A-Common-Guy/bipedale/ros2_ws/src/sandro_description/README.md

# sandro_description

ROS 2 Jazzy description resources for Sandro.

## Models

- `urdf/sandro.urdf.xacro` is the `robot_state_publisher` model. It exposes the
  six stable actuated joint names and `imu_link`.
  The launch file expands it with `control_backend:=mujoco|real` (and the
  `sim_*` latency arguments), which adds the `ros2_control` block from
  `urdf/sandro.ros2_control.xacro`: the MuJoCo backend wrapped in
  `sandro_sim/LatencySystem`, or the GIM6010 system and BNO085 sensor from
  `sandro_hardware`.
- `urdf/sandro.mujoco.urdf.xacro` and `urdf/sandro.real.urdf.xacro` are
  shortcuts for the same two blocks with the macro's default arguments, for
  inspection outside the launch file.
- `mjcf/scene_floating.xml` and `mjcf/robot_full_floating.xml` are byte-for-byte
  copies of the canonical Onshape export. Their referenced STL files are kept
  below `mjcf/assets`, preserving MuJoCo's relative `meshdir`.
- `mjcf/scene_ros2.xml` and `mjcf/robot_ros2.xml` are generated from the export
  by `tools/sync_model.py` for `mujoco_ros2_control`: unit-gain effort
  actuators, zeroed keyframe `ctrl`, and the six actuated hinges
  re-parametrised into the logical joint convention described below.

## Joint convention

Every controller, the calibrated physical drives (`sign` and `offset_rev` in
`sandro_hardware`) and the simulated hinges share one convention:

- Leg joints are zero when the upper link hangs straight down toward the wheel
  and positive when the link opens away from the leg centre. This is the frame
  of the planar five-bar kinematics in `sandro_controllers` and of the legacy
  `SandroControl` runtime.
- Wheel joints are positive when the robot rolls forward, on both sides.
- The inner/outer motor names are mirrored between the sides: `right_motor_inner`
  is the rear motor of the right leg while `left_motor_inner` is the front motor
  of the left leg. Planar leg +x therefore points forward on the right and
  backward on the left (`forward_sign` +1 / -1 in the whole-body controller).

The raw Onshape export does not follow this convention: its leg hinge zeros are
unrelated between sides and its left wheel hinge points the opposite way, so
equal efforts would spin the robot instead of driving it. `tools/sync_model.py`
holds the per-joint `(sign, zero)` table `JOINT_FRAMES` and applies it while
generating `robot_ros2.xml` through a flipped hinge axis and a joint `ref`, and
converts the `stand` keyframe accordingly. Body poses are unchanged.

`tools/derive_joint_frames.py` recomputes that table from the export geometry
(it needs the `mujoco` Python package, which the ROS image does not ship) and
`--check` compares it with the committed one. Rerun it after every CAD export.

The URDF is intentionally a schematic tree. A URDF cannot express each
five-bar linkage's closed loop, so its lower links end as unconnected visual
branches and the wheel joints attach directly to `base_link`. It has no
inertials and must not be used as a physics model. The MJCF retains the
exported inertias, equality constraints, contacts, and sensors.

## Updating the canonical model

The Onshape document holds one assembly per leg and the robot assembly that
places them. Re-import it from `onshape_export/` with the Onshape API keys in
`onshape_export/.env` (`ONSHAPE_API`, `ONSHAPE_ACCESS_KEY`,
`ONSHAPE_SECRET_KEY`; git-ignored) and `onshape-to-robot` plus `mujoco`
installed:

```bash
cd onshape_export
python compose_robot.py --export   # re-export leg, leg_left, robot; compose
```

`compose_robot.py` attaches the articulated legs, gives the body parts the
weighed hub masses of `config/sim_identified.yaml` (they carry no material in
Onshape) with the Raspberry Pi as the jointless `raspberry_pi` body, keeps
collision only on the outer shell, takes the `imu` frame from the BNO085
board part (`onshape_export/imu_mount.py`) and writes the stand keyframe.
The board's own axes are the `imu_chip` site; the real driver's
`imu_mount_yaw_rad` (`urdf/sandro.urdf.xacro`) must match its yaw, which
`test/test_description.py` checks. Then run:

```bash
ros2_ws/src/sandro_description/tools/sync_model.py sync
ros2_ws/src/sandro_description/tools/sync_model.py check
```

`check` also verifies the six-joint controller contract and IMU site. Both
commands are deterministic; unchanged files are not rewritten. Then rerun
`tools/derive_joint_frames.py --check` from an environment with `mujoco`, and
update `JOINT_FRAMES` if the export moved a joint frame. A changed body also
moves the whole-body controller's model (`model.com_height_per_leg_height`,
`model.pitch_inertia_*`, `model.yaw_inertia_kgm2` in
`sandro_bringup/config/controllers.yaml`): evaluate them in `mjcf/scene_ros2.xml`
over the leg-height range, and refresh the `sandro_rl` policies
(`sandro_rl/docs/DESIGN.md`, refresh procedure).
