A-Common-Guy/bipedale/sandro_rl/docs/DESIGN.md

# sandro_rl design notes

How the training environment is built, why, and how far its results can
be trusted. Each number is either measured in this repository (the command
that produced it is named) or cited, either to [RESEARCH.md](RESEARCH.md) or
to the ROS stack's own notes,
[SIM_TO_REAL.md](../../ros2_ws/src/sandro_bringup/docs/SIM_TO_REAL.md).
That file is cited below as "S2R" with a line number.

All measurements were taken on one machine: an RTX 5070 Ti (16 GB), MuJoCo,
MJX and MuJoCo Warp 3.16.0, warp-lang 1.18.0 and jax 0.11.2 (CUDA 13);
`uv.lock` has the exact versions.

## 1. Layout and data flow

```text
ros2_ws/src/...                 (read, never written)
  sandro_description/mjcf/scene_ros2.xml, robot_ros2.xml   the generated model
  sandro_description/config/sim_identified.yaml            identified mass, friction, payload
  sandro_bringup/config/controllers.yaml                   rates, limits, gains, command shaping
  sandro_bringup/config/sandro_real_overrides.yaml         per-robot overrides
  sandro_bringup/launch/sandro.launch.py                   latency emulation defaults
  sandro_sim/tools/closed_loop.py                          WBC closed-loop harness (evaluation)
        |
        v
sandro_rl/sources.py   reads all of the above, hashes them (fingerprint)
sandro_rl/robot.py     loads the MJCF, checks the model contract
sandro_rl/env.py       batched GPU environment (MJX, impl=warp)
sandro_rl/train.py     PPO (or FPO++, fpo.py) + curriculum; checkpoints carry config and fingerprint
sandro_rl/export.py    ONNX + policy.json (the deployment contract)
sandro_rl/evaluate.py  CPU MuJoCo, full latency emulation, side by side with the WBC
sandro_rl/consistency.py   CPU MuJoCo vs GPU backend check
```

Nothing in `ros2_ws/` was changed. Changes I suggest there are listed in
section 11.

## 2. Backend choice

The candidates were MJX's JAX backend, MuJoCo Warp through MJX
(`impl="warp"`), and Isaac Lab. Isaac Lab would need Isaac Sim, a very large
SDK that I was asked not to install without asking. It also needs the
five-bar closed loops re-expressed for PhysX, which requires a higher solver
iteration count for loops (RESEARCH.md, Isaac Lab entry). MuJoCo Warp runs
the exact MJCF that the ROS simulation runs, so model fidelity carries over
for free. Only the GPU-side Python wheels were needed: no driver or toolkit
change.

`uv run python -m sandro_rl.bench` measures physics steps per second. The
unpowered robot starts from the stand keyframe and tips over, so both tyre
and body contacts are exercised. There is no policy in the loop.

| Backend | 1024 worlds | 4096 | 8192 |
| --- | --- | --- | --- |
| MJX-Warp, graph mode `warp` | 2.24M | 4.58M | 5.18M |
| MJX-Warp, graph mode `warp_staged` (used) | 1.11M | 2.32M | 2.60M |
| MJX-JAX, body meshes not colliding | 0.30M | 0.62M | 0.74M |
| CPU MuJoCo, one thread | 89.7k (one world) | | |

The figures are physics steps per second, from `docs/bench.json`. The
compile times printed by the benchmark are with Warp's kernel cache warm.
A cold first run spends minutes compiling kernels.

These are the reasons for the choice:

- **MJX-JAX cannot run the model as it is.** `put_model` rejects collisions
  between the tyre cylinders and the body meshes, so its numbers above are
  for a copy with the body meshes taken out of collision. It cannot run
  obstacles either: there is no cylinder–box or cylinder–heightfield
  collision (RESEARCH.md, bottom line). Even on the simpler model it is
  3.5–7× slower than Warp.
- **Graph mode.** MuJoCo Warp's default CUDA-graph mode (`warp`) caches one
  graph per buffer-address set. In PPO training at 8192 environments it ran
  out of GPU memory after about 10 iterations. `jax` mode failed with
  `CUDA_ERROR_NOT_SUPPORTED` (a child graph node). `warp_staged` copies
  through fixed staging buffers and trains stably. In raw physics it reaches
  half the speed of `warp` (table above). In the full training loop it runs
  at 157k environment steps/s, against 245k with `warp` for the iterations
  that `warp` survived. It is set in `configs/base.yaml`
  (`env.graph_mode`).
- **End-to-end training rate.** `flat_tracking` trained at 153.7k
  environment steps/s averaged over the whole run, compile included (16.7 s).
  That is 1.84M physics steps/s, at 4 physics steps per control cycle and 3
  control cycles per policy step (`policies/flat_tracking/train_summary.json`).
  The `agile_obstacles` task, with 16 obstacle boxes per world and larger
  contact buffers, ran at about 125k.

## 3. Model sync

### What is read from where

| Quantity | Source | Read by |
| --- | --- | --- |
| Kinematics, inertias, contacts, physics step 1/1200 s | `mjcf/scene_ros2.xml` (generated by `sync_model.py`) | `robot.RobotSpec.load` |
| Identified mass, payload, friction, IMU mount | `sim_identified.yaml`, already in the MJCF; the file is hashed and its tyre friction cross-checked | `robot.check_contract` |
| Control rate 300 Hz, joint order, leg drive kp 12 / kd 0.5 | `controllers.yaml` | `sources.controller_parameters` |
| Torque limits (`"ros"`): the drives' envelope, 9 Nm peak folding back to the 5 Nm rated torque with heat (10 s thermal time constant, knee 0.7) | `sandro.ros2_control.xacro` GIM6010System parameters | `sources.DriveEnvelope`, `torque_envelope.py` |
| Command limits and shaping: 0.5 m/s, 1.5 rad/s, 1 m/s², 0.15 s yaw lag, 0.05 m/s height rate, height 0.14–0.185 m | `controllers.yaml` `drive`, `tasks.height` and the robot overrides | same |
| IMU mounting offset, fall angle 1.0 rad | overrides and `controllers.yaml` `safety` | same |
| Latency defaults: IMU 10 ms at 200 Hz, joints 1 ms at 200 Hz staggered, command 1 ms | `sandro.launch.py` `DeclareLaunchArgument` defaults (parsed with `ast`) | `sources.launch_latency` |

Task configs write `ros` where a value comes from the stack. No number is
duplicated.

### The model contract

`robot.check_contract` raises `ModelContractError` when the model differs
from what the environment handles. It checks:

- the six joint names and their order;
- one direct motor per joint (gear 1, ctrl size 6);
- the `stand` keyframe;
- the IMU site and its sensors;
- the tyre geoms: condim 4, and friction equal to `sim_identified.yaml`;
- the 1/1200 s physics step dividing the 300 Hz control period.

### CPU against GPU consistency

`uv run python -m sandro_rl.consistency` runs four seeded open-loop torque
sequences. Each is the hold torque plus sinusoids of 0.1–0.3 × the torque
limit at 0.5–4 Hz, run for 0.2 s (240 physics steps), in CPU MuJoCo and in
MJX-Warp from the same state. That state is the keyframe after landing:
0.3 s under leg PD, because the keyframe itself is slightly airborne. Two
checks follow:

- **One step:** every 20 steps the GPU is stepped once from the CPU state.
  The tolerance is |Δqvel| ≤ 2e-3. Measured: 6.4e-5 (6e-5 to 8e-5 across
  development runs).
- **Rollout:** the whole 0.2 s horizon. A fixed tolerance is not meaningful
  here, because the model amplifies float differences on its own. The passive
  five-bar links have armature 1e-5, and the robot tips over in open loop.
  The check therefore compares the GPU difference with the spread of CPU
  runs perturbed by 4e-5 relative qvel noise per step, times 3, plus a floor
  (legs and wheels 2e-3 rad, base 2e-4 m). The current model gives:

  | Quantity | GPU − CPU | CPU noise spread | Tolerance |
  | --- | --- | --- | --- |
  | leg joints | 0.049 rad | 0.032 rad | 0.096 rad |
  | wheel angles | 0.108 rad | 0.086 rad | 0.261 rad |
  | base position | 2.9 mm | 2.6 mm | 7.9 mm |

  So the GPU's difference is the size of float noise. Earlier development
  runs, with other seeds and start states, gave legs 0.05–0.125 rad and
  wheels 0.1–0.17 rad.

The contract runs first. `tests/test_consistency.py` copies the MJCF folder
and makes seven alterations. Each one makes the check fail, and the
unaltered model passes:

- a renamed joint;
- gear 2;
- a missing actuator;
- a removed keyframe;
- tyre condim 6;
- tyre friction 0.6, which `sim_identified.yaml` does not contain;
- physics step 1 ms.

### Fingerprint

`sources.fingerprint()` is a SHA-256 over these files:

- the scene and robot MJCF and their mesh files;
- `sim_identified.yaml`, `controllers.yaml` and the overrides;
- `sandro.launch.py`.

It is stored in every checkpoint (`meta.json`) and in `policy.json`.
`checkpoint.load`, `export` and `evaluate` warn and print the changed files
on a mismatch. They do not refuse: a changed comment also changes the hash.

### Refresh procedure after `sync_model.py sync`

```bash
cd sandro_rl
uv run python -m sandro_rl.consistency     # contract + CPU/GPU check; must pass
uv run pytest -m "not gpu"                 # contract tests on altered copies
uv run pytest                              # all tests, observation contract included
```

What to do next depends on the result:

- **The contract fails** (renamed joint, new actuator, changed contact
  type): update `sources.py` (`JOINTS`, `TYRE_SUFFIX`) and `robot.py`
  deliberately. The failure message names the check.
- **The contract passes but the fingerprint warns:** the physics changed.
  Retrain, or fine-tune from the old checkpoint with `--resume`. Then
  re-export and re-evaluate. An old policy can be evaluated against the new
  model to measure how much the change matters.
- **Only rates, limits or shaping changed:** export again, so `policy.json`
  carries the new limits, and run the evaluation.

## 4. Environment

### Timing

| Step | Rate | Source |
| --- | --- | --- |
| Physics | 1200 Hz | MJCF timestep |
| Drive MIT law | every physics step, on the true joint state | S2R l.43–45; `MitDrivePlugin` |
| Control cycle, sensor sampling | 300 Hz | controllers.yaml `update_rate` |
| Policy | 100 Hz, every 3rd control cycle | config `env.policy_rate_hz` |

I chose a policy rate of 100 Hz because the drive-side PD makes the legs
fast without a fast policy, as on Ascento with its low-level PD (RESEARCH.md
§1). It also gives a 3× cheaper rollout. The policy's MIT frame is held for
three control cycles. `policy.json` states the rate so a deployment can
check it.

`flat_level_fast` runs at 300 Hz, one step per control cycle. Inference
costs 0.3–0.6 ms on the Pi, and acting on each joint state as it arrives
cuts 3.3–6.7 ms from the sensing-to-action path, which matters most with the
synchronous joint state of `state_source:=mit`. A faster policy must not
change what the rewards mean per second, so:

- `observation.history_stride` (policy steps between stacked frames): 3 at
  300 Hz keeps four frames 10 ms apart, so the input layout is the 100 Hz
  one and a 100 Hz policy can be fine-tuned;
- `action_rate` and `action_accel` take differences per 10 ms (scaled by
  `0.01 / dt` and its square), so a smooth action costs the same at any rate
  while 300 Hz chatter costs more;
- the constraint termination probability `p_max` is per 10 ms;
- event terms (`termination`) are weighted per 10 ms step, not per `dt`;
- γ and λ are set per step in the config (0.99 and 0.95 per 10 ms are
  0.996655 and 0.983048 at 300 Hz), and `steps_per_env` is tripled so a
  rollout still covers 0.24 s.

All of these reduce to the old values at 100 Hz.

`flat_level_fast` is `flat_level_real` fine-tuned 1000 iterations at 300 Hz
(40 min), with MIT joint timing in half the episodes. In `evaluate.py
--compare` the body pitch RMS, averaged over the phases, halves against
`flat_level_real` in every scenario and latency profile (0.026–0.032 to
0.012–0.016 rad; WBC 0.016–0.019). Speed error and wheel torque drop a
little, and yaw error rises from 0.011 to 0.020 rad/s on the hardware
sequence (WBC 0.12). In the wheel-lag sweep the 5–15 Hz share at 80 ms is
0.04 against 0.19 on the hardware sequence. Part of the gain may be the
model: `flat_level_real` predates the 2026-11 CAD re-import, which
`flat_level_fast` trained on. Inference every cycle costs 0.3–0.6 ms of
the 3.3 ms budget on the Pi.

### Latency emulation

The GPU environment keeps a ring buffer of raw sensor channels at physics
rate: quaternion, gyro, accelerometer, six joint positions and six joint
velocities. `latency.sample_time` follows the ROS emulation's model (S2R
l.47–52), and `evaluate.DelayLine` ports it line for line on the CPU side.
Each channel has a sample clock (rate and phase), and the controller sees
the last sample older than the transport delay. Commands are applied after
the command delay, at physics-step resolution. The CPU evaluation instead
runs the `DelayLine` and `DriveBus` ports and the controller manager's
wake-up rule, all taken from `closed_loop.py`. Run against the same command
sequence, the WBC numbers it produces are the ones `closed_loop.py` itself
reports.

### Actions: the MIT interface

The policy outputs 6 values in [−1, 1], in joint order. Each becomes one MIT
frame per drive, `tau = kp (q_ref - q) + kd (v_ref - v) + tau_ff`, clipped
to the controllers.yaml torque limits:

- **Legs:** `q_ref = stand_q + 0.5 rad × a`, clipped to the joint range,
  with kp 12 and kd 0.5 from controllers.yaml. This is the same in-drive PD
  the WBC uses (`tasks.legs.pd_in_drive`, S2R seventh comparison).
- **Wheels:**
  - `velocity` mode: `v_ref = 20 rad/s × a`, kd 0.4 (the default).
  - `torque` mode: `tau_ff = 3 Nm × a`.

Velocity mode follows the hardware wheel-leg recipe (RESEARCH.md bottom
line). It also lets the drive's own loop reject the 0.2 Nm Coulomb friction
per wheel (S2R l.139) without the policy seeing it through the delay.

### Commands

The command is (forward speed, yaw rate, body height), resampled every
2–5 s. 20 % of commands are all zero, and each component is zeroed with
probability 0.25. The height changes in half the resamples. The policy
observes the **shaped** reference: rate-limited acceleration, first-order
yaw lag, rate-limited height, with the WBC's parameters from
controllers.yaml. Both controllers therefore follow the same reference from
the same `/cmd_vel`. `interface.PolicyInterface.shape` implements this for
deployment.

`agile_terrain` adds a fourth component, the body roll target, for
animation (section 8). Each resample draws it within ±0.3 rad, or zero with
probability 0.4. It is clipped to what both legs can reach at the current
height, |roll| ≤ atan(2·min(h − 0.07, 0.195 − h)/track width), and is
rate-limited to 0.6 rad/s. The tracked roll is this target minus the
coordinated-turn lean. Roll and height are soft objectives: tracking
kernels and a quadratic penalty, and no constraint holds them to the target.

### Observations

The actor sees one frame of 25 values per policy step, and stacks the 4 most
recent frames (100 inputs):

- projected gravity (3), from the delayed IMU quaternion, with the known
  mounting roll removed as `tasks.roll.imu_offset_rad` does in the WBC. In
  training that is the simulated mount (`sim_identified.yaml` `imu_mount`);
  on the robot it is the `rl_*` override's `observation.imu_offset_rad`;
- gyro (3, ×0.25);
- leg joint positions relative to `stand_q` (4);
- leg velocities (4, ×0.1);
- wheel velocities (2, ×0.05);
- previous action (6);
- normalised shaped command (3; 4 with the roll target).

Wheel angles are left out because they are meaningless. Base linear velocity
is left out because the robot has no sensor for it. The accelerometer can be
switched on (`observation.accelerometer`) but is off: the gravity vector
already comes from the BNO085's fusion.

The critic sees 68 values (asymmetric actor-critic, Pinto 2017; Ascento RL,
RESEARCH.md §1). That is the actor's current frame plus true gravity, gyro,
joint state, base velocity, leg heights, fore-aft leg offsets, wheel
clearance, the push force and 8 normalised model parameters.

`tests/test_observation_contract.py` checks that `PolicyInterface`, the numpy
code the CPU evaluation and the deployment use, produces bit-for-bit the
frame, MIT frames and command shaping of the GPU environment. It also checks
the mirror maps.

### Rewards and constraints

Rewards use exponential tracking kernels and quadratic regularisers, as in
legged_gym and Playground (RESEARCH.md §5). Each term is multiplied by the
policy period. The weights for `flat_tracking` are:

| Term | Weight | Note |
| --- | --- | --- |
| alive | 1 | |
| exp(−((v − v_ref)/0.15)²) | 2 | true forward speed in the heading frame |
| exp(−((ω − ω_ref)/0.35)²) | 1 | world yaw rate |
| exp(−((h − h_ref)/0.012)²) | 1 | mean leg height from the kinematics |
| (roll + lean)² | −20 | lean = atan(v ω / g), the coordinated-turn roll |
| pitch² | −2 | |
| pitch rate² | −0.05 | |
| vertical velocity² | −2 | |
| (right − left fore-aft leg offset)² | −200 | keeps the legs together |
| action rate², action acceleration² | −0.02, −0.01 | |
| leg torque², wheel torque² | −0.002, −0.01 | mean over physics steps |
| leg joint velocity² | −0.0005 | |
| termination | −200 | |

Hard limits use Constraints as Terminations (Chane-Sane 2024, RESEARCH.md
§4): each violated constraint raises the episode's termination probability,
up to 0.25 per step, in proportion to the violation over its slack. The
constraints are:

- leg torque at the drives' 9 Nm peak;
- the drives' heat budget running out (`thermal`: 0 until the envelope
  starts folding back, 1 at the rated torque's heat), so bursts above the
  5 Nm rated torque are free and holding them is not;
- five-bar stretch above 0.97 (1 is the singular, fully stretched pose);
- joint range with a 0.1 rad margin;
- height outside the commanded range by more than 8 mm;
- tilt beyond 0.45 rad;
- a wheel lifting by more than 1 cm.

An episode terminates outright at 0.8 rad tilt (the WBC declares a fall at
1.0) or with the IMU below 0.17 m.

PPO adds the mirror loss of Mittal 2024 (weight 0.5). A left–right mirror
of the robot swaps the legs, flips the lateral and yaw signs and keeps the
joint signs, because the joints are mirrored in the URDF. The mirror maps
are tested to be involutions.

### Kinematics of the five-bar legs

`kinematics.py` is the closed-form forward kinematics (base 0.09 m, upper
0.08 m, lower 0.13 m, read from the MJCF). At the neutral offset the
reachable leg height is 0.022–0.199 m at stretch ≤ 0.97. The static leg
torque stays at or below 1.07 Nm between 0.08 and 0.2 m. So the ROS height
range 0.14–0.185 m uses a small part of the linkage. The `agile_obstacles`
task widens it to 0.11–0.19 m (section 8).

## 5. Randomisation

The ranges are resampled each episode (latency, sensors, drives) or drawn
once per environment for the whole run (model fields, the Playground
pattern). Each one is centred on, or brackets, an identified or measured
value.

| Parameter | Range | Source of the range |
| --- | --- | --- |
| IMU delay | 5–15 ms | Launch default 10 ms (`sim_imu_delay_s`): the SPI IMU lags the encoders by 9 ms, plus the 1 ms joint delay (S2R l.57–61). Policies trained before 2026-11 saw 3–25 ms. |
| IMU rate | 150–300 Hz | About 200 Hz per signal over SPI (`report_interval_us` 5000; S2R l.57–61), launch default 200 Hz. Policies trained before 2026-11 saw 100–400 Hz, and in 25 % of episodes 25–60 Hz for the UART path (29.9 Hz on every UART run), which the robot no longer uses. |
| Joint delay | 0.5–6 ms | Encoder data is 1–6 ms old on the robot (S2R l.50–52). |
| Joint rate | 150–300 Hz | 199.9 Hz measured (S2R l.470). 300 Hz is `state_source:=mit` (S2R l.144–150). |
| Joints synchronised | 20 % of episodes, otherwise random phases | 0.66 of joints update together on the robot (S2R l.471). `mit` mode is synchronous (S2R l.62–63). |
| MIT joint state | `mit_joints_probability` of episodes (0 by default, 0.5 in `flat_level_fast`): synchronous at the control rate, 1.5–3.5 ms old | `state_source:=mit`, 2.3 ms nominal (S2R l.144–150, `JOINT_TIMING` in `sandro.launch.py`). |
| Command delay | 0.5–3 ms | Default 1 ms, a 3-frame CAN burst plus the gs_usb round trip (S2R l.53–55). A 6 ms command delay makes the WBC fall at 30 Hz (S2R l.486). |
| IMU noise | 0.5–2 × the MJCF sensor noise | mujoco_ros2_control's noise (S2R l.456–457). The real BNO085 noise is unmeasured, hence the wide factor. |
| Joint velocity gain | 0.75–1.05 per drive | Drives report 0.84–0.87 of the position derivative. One drive reported 0.46 and 0.31 (S2R l.248–250, l.283). The lower outlier is left out deliberately and is listed in section 10. |
| Encoder noise, velocity noise | 5e-4 rad, 0.05 rad/s | Assumption; no measurement in the repository. |
| IMU mounting bias | ±0.02 rad per axis on top of the identified −0.049 rad roll | The 3° roll bias was found from leg heights (S2R l.140). This is the residual after the correction. |
| Gyro bias | ±0.01 rad/s | Assumption; the BNO085 calibrates its gyro online. |
| Drive torque scale | 0.85–1.15 per drive | The torque constant is unmeasured (S2R l.19). The robot spends about 1.7× the simulated wheel torque (S2R l.191–192), which is friction and is covered by the next rows. |
| Leg kp/kd scale | 0.9–1.1 | MIT gain quantisation and the drive's own loop. Assumption. |
| Robot mass | ±10 % | Components weighed 2026-10-21, 4.825 kg in total (`sim_identified.yaml` `masses`), without the battery. |
| Payload mass | 0.4 kg ± 0.4 kg | The part of the hub's weighed mass placed by the tilt weighing (`payload`). The range also covers part of a battery not yet fitted. |
| Payload position | ±40 mm fore-aft, ±20 mm lateral, ±30 mm vertical, IMU frame | The CoM estimate moved from 28 mm to 7–8 mm behind neutral between comparisons (S2R l.101, l.230–233). |
| Tyre sliding friction | 0.5–1.2 absolute | Identified value 0.8 in `sim_identified.yaml` (`tyre.friction`). Ascento found high grip an exploit that did not transfer (RESEARCH.md §1). |
| Tyre torsional friction | 0.5–2 × | 0.07 m was identified from the turn cost (S2R l.102, `sim_identified.yaml`). |
| Leg drive friction | 0.5–3 × | The simulated legs are slower than the robot's (S2R l.505–510). The leg drives' friction is the suspect. |
| Wheel drive friction | 0.5–2 × the identified 0.2 Nm | Inferred from 0.43 Nm producing almost no acceleration (S2R l.139). |
| Joint damping | 0.5–2 × | Not identified: CAD/legacy 0.01 in `sim_identified.yaml`. |
| Armature | 0.5–8 ×, log-uniform | S2R l.321–323 suspects that the armature is reflected by the gear ratio once instead of squared. 8× covers that error for the 8:1 GIM6010 (MODELLING_AND_CONTROL.md l.14, `hardware.yaml` `gear_ratio`). |
| Pushes | ±12 N fore-aft, ±5 N lateral, 0.05–0.2 s, every 3–8 s | Above the 8 N shove of the `closed_loop.py check` gate (S2R l.517). |
| Pushes, `agile_terrain` | ±25 N fore-aft, ±12 N lateral, ±15 N vertical, ±1 Nm about the heading (roll) and about z, 0.05–0.25 s, every 2–6 s | Assumption: about 3× the gate's 8 N shove. The torques stand for knocks on the body's sides and corners; nothing is measured. |
| Terrain, `agile_terrain` | 12 planks 5–30 mm high, 4–30 cm deep, 0.2–1 m wide; 4 hills 2–10 cm high with 5–15° ramps and 0.2–0.8 m plateaus, 0.8–1.6 m wide; all 0.3–4 m from the start, new layout every episode | Assumption: indoor thresholds, cables and ramps. Ascento climbed 15 cm steps (RESEARCH.md §1), so 3 cm planks leave margin. |

`tests/test_determinism.py` checks that the randomisation is bit-exact for a
given seed.

## 6. Training

The training algorithm is PPO in JAX (`ppo.py`), in the style of rsl_rl:

- adaptive learning rate on a KL target of 0.01;
- 8192 environments × 24 steps per iteration, 5 epochs, 4 minibatches;
- γ 0.99, λ 0.95;
- ELU MLPs: actor 256-256-128, critic 512-256-128;
- running observation normalisation, which is exported with the policy;
- the symmetry loss.

Curricula are listed as `curriculum.stages` in the task config. Each stage
sets dotted config keys from a given iteration. When a stage starts, the
environment and the randomised model batch are rebuilt; networks,
normalisers and optimiser carry over.

### Determinism

Everything is seeded: JAX keys, numpy, the per-environment randomisation,
and the CPU evaluation's noise. The CPU evaluation is bit-exact
(`tests/test_determinism.py`). The GPU rollout is not, because MuJoCo Warp's
constraint solver accumulates with float atomics. Two runs with the same
seed agree to about 6e-7 after one step. After one PPO iteration 0.05 % of
the weights differ, by at most 2.7e-3, because Adam amplifies tiny gradient
differences. The test asserts a relative parameter difference below 1e-3,
and also that a different seed differs.

Warp's `DeterministicMode.RUN_TO_RUN` was tried and rejected:

- compiling one reset took 539 s;
- the difference grew (0.025), because the deterministic contact ordering
  changed the floating-point summation order rather than fixing it.

## 7. Evaluation

`evaluate.py` runs the exported ONNX policy in CPU MuJoCo, with onnxruntime
at 100 Hz inside the 300 Hz loop, using the code `closed_loop.py` uses:

- the `DelayLine` and `DriveBus` emulation;
- the controller manager's wake-up rule;
- IMU noise and `/cmd_vel` published at 20 Hz;
- the 3 s settle, pushes and the fall rule.

It writes `drive_test.py`-compatible CSVs and summarises them with the same
per-phase metrics as `compare_runs.py`. It also runs the WBC through
`closed_loop.py` on the same scenario and latency profile. Three latency
profiles are used:

- `nominal`: the launch defaults.
- `uart_imu`: the IMU at 30 Hz, the measured hardware rate (S2R l.469).
- `worst`: IMU at 30 Hz with 25 ms delay, joints 5 ms, commands 3 ms.

The `truth_*` columns are measured from the simulator state. They exist
because the controllers' own estimates differ: the WBC estimates speed from
the wheels and the policy has no speed estimate at all.

### flat_tracking against the WBC

`uv run python -m sandro_rl.evaluate policies/flat_tracking --compare`
writes the full table to `policies/flat_tracking/eval/comparison.md`, for
three scenarios (closed_loop's `hardware`, `default`, `push`) × three
profiles. Survival:

| Scenario | nominal | uart_imu | worst |
| --- | --- | --- | --- |
| hardware (5 phases, 0.2 m/s, 0.6 rad/s turn) | both complete | both complete | policy completes, WBC falls |
| default (11 phases, 0.3 m/s, 1 rad/s spin, height changes) | both complete | policy completes, WBC falls in phase 1 | policy completes, WBC falls |
| push (8 N shoves) | both complete | both complete | policy completes, WBC falls |

The WBC's fall on `default/uart_imu` is a known, pre-existing result.
`closed_loop.py check` fails that gate in the same way (S2R l.489–491,
l.518–519).

Selected phases from the `hardware/nominal` run. Pitch is the true body
pitch about its phase mean (as `compare_runs.py` computes it). Speed error is
`compare_runs.py`'s `vel_err_rms`: wheel odometry plus pitch rate against the
shaped reference, computed the same way for both controllers. The full table
is in the file.

| Phase | Metric | Policy | WBC |
| --- | --- | --- | --- |
| standing (0) | pitch RMS, rad | 0.046 | **0.023** |
| standing (0) | speed error RMS, m/s | **0.027** | 0.072 |
| driving 0.2 m/s (1) | pitch RMS, rad | 0.040 | **0.002** |
| driving 0.2 m/s (1) | speed error RMS, m/s | 0.072 | **0.050** |
| turn 0.2 m/s, 0.6 rad/s (3) | yaw-rate error RMS, rad/s | **0.061** | 0.172 |
| turn (3) | yaw rise time, s | **0.12** | 1.02 |
| all | wheel torque RMS, Nm | 0.24–0.46 | 0.22–0.44 |
| all | leg effort RMS, Nm | 0.79–0.99 | 0.78–0.93 |

The truth speed comes from `closed_loop.cpp` (`Sim::truth`). It is the
speed of the torso body's origin, `hypot(qvel[0], qvel[1])`. That origin is
the CAD origin, 0.35 m from the axle midpoint horizontally and 0.17 m above
it. While turning it therefore adds about ω × 0.35 m: 0.21 m/s at
0.6 rad/s. Pitch motion adds to it as well. The truth speed errors in the
turn phases mean nothing for either controller and are left out above.
Measured at the axle midpoint (`diag_truth_forward_m_s`, policy only), the
policy drove 0.172 m/s in the 0.2 m/s turn of `hardware`, and 0.270 m/s in
the 0.3 m/s spin of `default`. The WBC's recordings have no axle speed
column. Section 11 proposes the fix.

**Where the policy is worse:**

- **Pitch.** Its body pitch RMS is about twice the WBC's in every standing
  phase (0.046–0.066 against 0.023–0.039 rad). Its mean standing pitch is
  also +0.06 to +0.09 rad, against −0.003 to +0.005 for the WBC. In the last
  2 s of the standing phases its pitch standard deviation is 0.017–0.044 rad,
  against 0.004–0.025. With a pitch weight of only −2, pitch is nearly free
  in the reward. A wheeled inverted pendulum can stand at any pitch for which
  it shifts the legs under the CoM, so a tilted body costs it almost nothing.
  `flat_level` (section 8) tests this explanation.
- **Steady driving.** It drives with more pitch and less precise speed than
  the WBC at 0.2 m/s.
- **Torque under worst-case latency.** It survives the `worst` profile with
  a calm body (pitch RMS 0.02–0.05), but spends 0.8–1.8 Nm RMS of wheel
  torque doing so, against 0.2–0.5 at nominal latency, with up to 6 %
  wheel-velocity sign flips. On the robot that is heat and audible chatter.

**Where the policy is better:**

- It survives every latency profile.
- Yaw tracking is 3× more accurate and 8× faster to rise.
- Standing station-keeping is better: speed error 0.027 against 0.072 m/s.
  The WBC drifts ±0.1–0.2 m/s with its 0.3–0.4 Hz friction sway
  (S2R l.499–504).

The plot `policies/flat_tracking/eval/hardware_nominal.png` shows the traces.

## 8. Further policies

The results in sections 7 and 8 were measured on the CAD-mass model, as
trained. The policies in `policies/` have since been fine-tuned on the
weighed robot; their current results are in the last subsection,
"Refit to the weighed robot".

### agile_obstacles: using the legs

The WBC uses the five-bar legs as a slow posture and height actuator inside
0.14–0.185 m. The linkage reaches 0.022–0.199 m (section 4). It is strong
enough there: the static leg torque is at most 1.07 Nm of the 3 Nm limit.
The legs are also fast with the drive-side PD: 72 ms response at kp 12
(S2R l.410–413). `configs/agile_obstacles.yaml` asks the policy to use this:

- commands up to 1.0 m/s and 3.0 rad/s, twice the controllers.yaml limits;
- 2 m/s² acceleration and a 0.15 m/s height rate;
- heights from 0.11 to 0.19 m;
- 16 randomly placed planks per world, 5–25 mm high, 4–30 cm deep and
  0.2–1 m wide;
- wheel velocity targets up to 25 rad/s;
- tighter tracking kernels and a stronger pitch penalty (−10);
- a three-stage curriculum. At iterations 0, 300 and 700 the sampled
  command range is 40 %, 70 % and 100 %, and the plank heights are
  2–8 mm, 4–16 mm and 5–25 mm.

Ascento climbed 15 cm steps blind with a similar recipe (RESEARCH.md §1).
The 0.11 m lower bound is my choice of margin, not a measured limit.

The run took 38.7 minutes for 295M environment steps: 127k env steps/s and
1.53M physics steps/s, compile included. At the end, the training tracking
errors were 0.107 m/s, 0.106 rad/s and 5.7 mm, with 0.005 falls per 1000
episode-steps (`policies/agile_obstacles/curves.png`).

**These plank results are invalid.** Only the first plank of the course
collided; the rest were drawn but not solid, and the same was true of the
training planks. The planks were static world geoms, moved after compilation
through `geom_pos`, and MuJoCo (CPU and Warp) collides static geoms only
where they were compiled. The policy was therefore trained on flat ground,
and the course below crossed one real plank. `agile_terrain` replaces it
(below), with obstacles as mocap bodies and a test that they carry the
wheels (`tests/test_terrain.py`). The table is kept as a record.

**The plank course.** `evaluate --scenario agile --course` runs in CPU
MuJoCo with nominal latency. It places planks 10, 15, 20, 25 and 15 mm high
across the start heading at 1.0, 2.0, 3.0, 4.2 and 5.4 m. The policy
completed the 26 s sequence (`policies/agile_obstacles/agile_course.mp4`,
`eval/agile_course.png`). Speeds are measured at the axle. Which planks it
crossed is from the path dead-reckoned from axle speed and yaw rate:

| Phase | Command | Achieved |
| --- | --- | --- |
| 1 | 0.6 m/s | 0.47 m/s, over the 10 mm plank |
| 2 | 1.0 m/s | 0.87 m/s, over the 15 and 20 mm planks (4.0 m covered straight) |
| 3 | 0.8 m/s with 2 rad/s | 0.78 m/s, 1.76 rad/s, over the 25 mm plank while turning |
| 4 | spin in place at −3 rad/s | −2.51 rad/s mean |
| 5 | −0.5 m/s | −0.44 m/s, backwards over the 20 mm plank |
| 7 | 0.5 m/s with 1.5 rad/s at 0.12 m height | 0.41 m/s, 1.39 rad/s |

**Where it is worse:**

- It undershoots the commanded speed in steady state by up to 22 % (0.47 of
  0.6 m/s) and the yaw rate by up to 16 % (2.51 of 3 rad/s). The
  training error (0.107 m/s) says the same; neither curriculum nor training
  length closed that gap.
- Wheel torque reaches 1.1 Nm RMS at 1 m/s, with peaks near 5 Nm when a
  plank is hit.

**On the standard scenarios** (`eval/comparison.md`), it completes all nine
scenario/profile combinations, as `flat_tracking` does. Compared with
`flat_tracking`:

- Its first standing phase is almost motionless: pitch about its mean
  0.001 rad and speed error 0.016 m/s, against the WBC's 0.023 and 0.072.
- It holds a static posture and then switches to another, 0.1–0.15 rad
  away, after driving. Its later standing phases therefore read
  0.041–0.050 rad, against the WBC's 0.025–0.039. Its mean standing pitch is
  +0.064 rad in phase 0 and about 0 later.
- In the `default` spin (0.3 m/s at 1 rad/s) its yaw-rate error is 0.085
  against the WBC's 0.252, with a rise time of 0.16 s against 0.74 s.
- Like `flat_tracking`, it spends 1.0–1.4 Nm RMS of wheel torque under
  `worst` latency.

### agile_terrain: obstacles that collide, slopes, kicks, roll and height

`configs/agile_terrain.yaml` replaces `agile_obstacles`. Relative to it:

- **Obstacles are mocap bodies** (`terrain.py`). Each world has 12 planks
  and 4 hills; a hill is a plateau box between two ramp boxes. They are
  compiled at their largest height and sunk into the floor to the sampled
  height, and their poses are written to `mocap_pos`/`mocap_quat` at every
  reset. So the layout is new every episode, and each world's is different.
  Warp does not drop contacts between two mocap bodies, so obstacle geoms
  have `contype` 2 and `conaffinity` 1: they collide with the robot and not
  with each other or the floor. Rewards and terminations that need the ground
  height use an analytic one, the highest box top under the point.
  `tests/test_terrain.py` checks that a plank placed at run time lifts the
  wheels by its height, 20 mm for 20 mm on the CPU and in Warp. It also
  checks that the analytic height matches `mj_ray` and that every course
  obstacle collides where it is drawn.
- **Disturbances.** Pushes go up to 25 N fore-aft, 12 N lateral and 15 N
  vertical, with torque kicks of 1 Nm about the heading (roll) and about z.
  They last 0.05–0.25 s and come every 2–6 s. The critic sees all five
  components.
- **Roll and height as commands** (section 4, Commands). Height ranges over
  0.09–0.19 m and roll over ±0.3 rad, clipped to what both legs can reach.
  Neither is a constraint, only a reward: tracking kernels with sigmas
  0.03 m and 0.06 rad, and a −5 roll penalty.
- **Curriculum.** At iterations 0, 400 and 900: commands at 40, 70 and 100 %
  of their range; planks 2–10, 4–20 and 5–30 mm; hills 0–3, 1–6 and
  2–10 cm; pushes rising to the values above. Stages accumulate, so the last
  stage restates the full values.

**Training history.** The policy took three runs:

| Run | Iterations | Change |
| --- | --- | --- |
| `agile_terrain_v0` | 1200 of 2000 | Diverged at iteration 1220 |
| `agile_terrain_v1` | +800 | Resumed from v0's checkpoint 1200 at full difficulty |
| `agile_terrain_v2` | +500 | Height kernel widened |

- **v0's divergence:** one world's simulation diverged, and its NaN
  observation reached the shared observation normaliser, which poisoned
  every world. `env.step` now terminates a world whose state is non-finite
  or whose |qvel| exceeds `termination.max_qvel` (200). It zeroes that
  world's observation and gives it the termination reward.
- **v1's resume:** run with an initial learning rate of 1e-4. At the
  config's 1e-3, the fresh optimiser's first step reached a KL of 144.
- **v2's height kernel:** the height sigma went from 0.015 to 0.03 m and
  its weight from 1 to 2. With the narrow kernel the reward was flat beyond
  about 4 cm of error. Commanded down to 0.093 m, the v1 policy *rose* to
  0.177 m.

Total: 2500 iterations, 1.26 G env steps, 75 minutes. At the end the
training errors were 0.19 m/s, 0.22 rad/s, 15 mm in height and 0.02 rad in
roll, with 0.09 falls per 1000 steps, all at full difficulty.

**The course** (`evaluate --scenario course --course`, CPU MuJoCo, nominal
latency) has planks 10, 15, 20 and 25 mm high at 1.0–3.4 m. They are
followed by an 8 cm hill with 10° ramps and a 0.6 m plateau, centred at
5 m. The policy completes it (`course.mp4`, `eval/course_frames.png`,
`eval/course.png`). Positions below are dead-reckoned from axle speed and
yaw rate:

| Phase | Command | Achieved |
| --- | --- | --- |
| 1 | 0.5 m/s | 0.40 m/s, over the 10 mm plank |
| 2 | 0.8 m/s | 0.69 m/s, over the 15, 20 and 25 mm planks and up the hill; stops at x = 5.3 m, on the plateau. Pitch peaks at 0.37 rad |
| 3–4 | stop, then spin at 2.5 rad/s on the plateau | 2.48 rad/s |
| 5 | 0.6 m/s, 90° to the course | 0.58 m/s, off the side of the hill's plateau and down |

**The expressive sequence** (`--scenario expressive`, `expressive.mp4`,
`eval/expressive_frames.png`, `eval/expressive.png`) lowers the body, rolls
it both ways, crouches, rises and then drives while rolled. Roll follows:
0.25–0.26 rad for ±0.3 commanded at 0.13 m, and 0.22 for ±0.25 while
driving at ±0.3 m/s. The RMS error is 0.03–0.05 rad, including the
transitions. A coordinated turn at 0.4 m/s and 1 rad/s leans the body by
0.05 rad into the turn, as the reward asks.

**Where it is worse:**

- **Height follows only within about 0.12–0.18 m.** Commanded to 0.093 m,
  the legs stop at 0.122 m; commanded to 0.19 m, they stop at 0.177 m. While
  rolling at 0.13 m the mean leg height rises to 0.153 m. I checked and ruled
  out these causes:
  - kinematics: the joints are far from their limits at 0.09 m;
  - self-collision;
  - torso clearance: 0.19 m at a 0.09 m leg height;
  - the IMU-height termination: the IMU is 0.30 m above the ground at
    0.09 m.

  The cause is open; the next things to try are listed in section 10.
- **It rocks slowly while standing**, with pitch swinging between 0 and
  0.1 rad. The pitch penalty (−10) is a quarter of `flat_level`'s.
- **It undershoots speed** by 14–20 % in steady state, like
  `agile_obstacles`.
- **Standard scenarios** (`eval/comparison.md`): it completes all nine
  scenario/profile runs, and the WBC falls in four. In the 10 s push test at
  nominal latency its truth pitch RMS is 0.047 rad against the WBC's 0.023.

### flat_level: the body held level

`configs/flat_level.yaml` is `flat_tracking` with three weights changed:
pitch from −2 to −25, pitch rate from −0.05 to −0.3, and wheel torque from
−0.01 to −0.02. It trained for 1500 iterations against `flat_tracking`'s
1000. Part of the difference below may therefore come from the longer
training; I did not run the 1000-iteration control.

The run took 31.7 minutes for 295M environment steps (154.9k env steps/s,
1.86M physics steps/s). At the end, the training tracking errors were
0.060 m/s, 0.052 rad/s and 1.9 mm, against `flat_tracking`'s 0.069 m/s,
0.065 rad/s and 1.8 mm.

It completes all nine scenario/profile combinations. Results for
`hardware/nominal` (`policies/flat_level/eval/comparison.md`, same metrics
as section 7):

| Phase | Metric | flat_level | flat_tracking | WBC |
| --- | --- | --- | --- | --- |
| standing (0, 2, 4) | pitch RMS, rad | **0.013** / **0.023** / **0.024** | 0.046 / 0.059 / 0.064 | 0.023 / 0.025 / 0.034 |
| standing (0, 2, 4) | mean pitch, rad | −0.002 / +0.006 / −0.001 | +0.057 / +0.092 / +0.085 | −0.003 / −0.003 / +0.005 |
| standing (0) | speed error RMS, m/s | **0.008** | 0.027 | 0.072 |
| driving 0.2 m/s (1) | pitch RMS, rad | 0.032 | 0.040 | **0.002** |
| driving 0.2 m/s (1) | speed error RMS, m/s | 0.068 | 0.072 | **0.050** |
| turn (3) | yaw-rate error RMS, rad/s | **0.044** | 0.061 | 0.172 |
| turn (3) | yaw rise time, s | 0.16 | **0.12** | 1.02 |
| all | wheel torque RMS, Nm | 0.09–0.49 | 0.24–0.46 | 0.22–0.44 |

Standing, the body is now level and calmer than the WBC's. The WBC's
standing pitch is its 0.3–0.4 Hz friction sway (S2R l.499–504), which the
policy does not show (`eval/hardware_nominal.png`).

**Where it is still worse than the WBC:**

- **Driving.** It leans and returns when it accelerates, while the WBC
  holds one steady lean (pitch RMS 0.032 against 0.002), and it tracks the
  speed less tightly (0.068 against 0.050 m/s).
- **Pushes.** At nominal latency its pitch RMS is 0.026 against the WBC's
  0.023.
- **Torque and wheel reversals under worst-case latency.** It spends
  0.4–1.0 Nm RMS of wheel torque, with up to 6 % wheel-velocity sign flips.
  That is better than `flat_tracking`'s 0.8–1.8 Nm, but it is still several
  times its nominal level.
- **Under the 30 Hz UART IMU** its standing pitch rises to 0.017–0.023 rad.

The example video is `policies/flat_level/default_uart_imu.mp4`: the
`default` drive_test sequence with the 30 Hz IMU, the case where the WBC
falls.

### jump: wheels off the ground on command, at 10 Nm

`configs/jump.yaml` is `agile_terrain` (same terrain, pushes, roll and
height commands) plus a jump event. It is a first policy to build the more
dynamic tasks on; its torques are past what the hardware has been run at, so
it is not expected to transfer before the system identification is done.

- **Torque limits** go to 10 Nm on legs and wheels (`action.torque_limit_nm`,
  the hardware plugin's `hard_effort_limit_nm`), against 3 and 6 Nm from
  controllers.yaml for the other policies. The CaT leg-torque limit is
  9.5 Nm. Legs use kp 20, kd 0.6 and an action scale of 0.8 rad.
- **The jump event.** Every 2–5 s a jump window of 0.8 s opens with a target
  height of 2–8 cm (curriculum: 1–3, 2–5, then 2–8 cm at iterations 0, 400
  and 900). The actor sees two more inputs, `[height / 8 cm, time left /
  0.8 s]`, zero outside the window, so the observation grows by 2 per frame
  (112 actor, 74 critic).
- **Rewards in the window:** the lower wheel's clearance up to the target
  (weight 40), upward base speed (2), and a quadratic penalty above the
  target (−2000). Height tracking, the vertical-speed penalty and the
  wheel-lift constraint are off during the window and 0.3 s after it.
- **The evaluation** gives a jump the sixth field of a scenario phase,
  started on its rising edge (`--scenario jump`), and records the lower
  wheel's clearance above flat ground (`diag_truth_wheel_clearance_m`).

Training took 74.6 minutes for 2500 iterations (491.5M env steps, 109.8k
env steps/s, 1.32M physics steps/s), with no divergence. At the end it falls
0.35 times per 1000 policy steps, against `agile_terrain`'s 0.08.

**What it learned** (`jump.mp4`, `eval/jump_frames.png`, `eval/jump.png`):
in every window it hops three times, tucking the legs to 0.10 m between
hops, and lands back at its 0.17 m height within 0.2 s of the window's end.
It does this standing and at 0.5 m/s:

| Phase | Target | Hops | Peak clearance | Peak leg / wheel torque |
| --- | --- | --- | --- | --- |
| standing | 3 cm | 3 | 66 mm | 8.4 / 5.0 Nm |
| standing | 5 cm | 3 | 84 mm | 7.7 / 5.2 Nm |
| standing | 8 cm | 3 | 127 mm | 7.3 / 7.1 Nm |
| 0.5 m/s | 5 cm | 3 | 107 mm | 7.4 / 6.3 Nm |
| 0.5 m/s | 8 cm | 3 | 126 mm | 7.2 / 6.2 Nm |

It completes all nine standard scenario/profile runs (`eval/comparison.md`;
the WBC falls in three, the `worst` latency profile).

**Where it is worse, and what to change:**

- **It hops three times instead of jumping once.** The reward pays for
  clearance at every step of the window, and short hops keep the wheels up
  for more of it than a single flight of about 0.3 s. A single jump needs a
  reward on the flight's apex, or a window that closes at the first
  touchdown.
- **The height command shapes it only loosely.** It overshoots small
  targets (66 mm for 3 cm) despite the overshoot penalty; the 8 cm target
  is met. Rewarding the apex against the target would fix both.
- **It falls four times as often as `agile_terrain` in training.** The
  jumps are on the same terrain and pushes, and landings on plank edges are
  the likely cause (not traced).
- **The torque is 10 Nm on every drive, and the landings are not checked
  against the hardware.** The drives' peak current, the five-bar links'
  strength and the tyres' landing impact are not modelled. The deployment
  controller has no jump input yet (section 9).

### Refit to the weighed robot

On 2026-10-21 the model changed from the CAD masses to the weighed ones
(`sim_identified.yaml` `masses`): 4.825 kg against 3.40 kg, wheels 170 g
against 58 g, and the loaded tyre radius 0.0672 m against 0.0742 m. The
controllers' model, wheel radius included, followed. The contract and the
CPU/GPU check pass on the new model.

**IMU roll correction, fixed with the refit.** Training had taken the
observed roll correction from the robot overrides'
`tasks.roll.imu_offset_rad`. That value was re-identified to +0.016 rad for
the SPI6 mounting, while the simulated IMU stayed mounted at −0.049. The
first `jump` training therefore saw a horizon tilted by 0.065 rad, which it
would have held on the robot. The correction is now the simulated mount
(`sources.simulated_imu_roll_offset`), guarded by a contract test. The
refit below starts from the committed checkpoints with that fix: three of
them were trained before the re-identification, and `jump` relearns the
horizon in its refit.

The policies as committed before the refit, on the new model: `flat_tracking`,
`flat_level` and `agile_terrain` complete the `default` sequence, and `jump`
completes its jumps, but `agile_terrain` falls on the obstacle course. Each
policy was therefore fine-tuned from its committed checkpoint on the new
model, at full difficulty and a learning rate of 1e-4:

```bash
uv run python -m sandro_rl.train configs/<policy>.yaml --out runs/<policy>_mass --resume policies/<policy> \
    --set 'curriculum.stages=[]' --set train.iterations=<300 or 600> --set train.learning_rate=1.0e-4
```

| Policy | Iterations | Wall time | Falls per 1000 steps at the end, before → after |
| --- | --- | --- | --- |
| `flat_tracking` | +300 | 6.6 min | 0 → 0 |
| `flat_level` | +300 | 6.6 min | 0 → 0 |
| `agile_terrain` | +600 | 17.6 min | 0.08 → 0.11 |
| `jump` | +600 | 17.6 min | 0.35 → 0.21 |

Each folder keeps its original `train_log.csv` and curves and adds
`train_log_mass.csv`, `train_summary_mass.json` and `curves_mass.png`. All
four complete the nine standard runs (`eval/comparison.md`). On the new
model, the WBC falls in the three `worst`-latency runs.

**flat_tracking and flat_level** (`hardware/nominal`):

| Metric | flat_tracking | flat_level | WBC |
| --- | --- | --- | --- |
| standing pitch RMS (phases 0, 2, 4), rad | 0.017 / 0.033 / 0.020 | 0.028 / 0.015 / 0.023 | 0.023 / 0.030 / 0.033 |
| standing mean pitch, rad | +0.020 / +0.018 / −0.001 | +0.002 / −0.007 / −0.004 | |
| driving 0.2 m/s pitch RMS, rad | 0.043 | 0.029 | **0.006** |
| turn yaw-rate error RMS, rad/s | **0.048** | 0.063 | 0.199 |
| turn yaw rise time, s | 0.20 | **0.16** | 1.42 |

Both stand about as calmly as the WBC. `flat_level` stands level, within
0.007 rad. `flat_tracking`'s forward tilt is down from +0.06–0.09 rad to at
most +0.02.

**agile_terrain:**

- **The course at 0.8 m/s** (`--scenario course`) now ends in a fall on
  every seed tried (5 of 5). The robot hits the 25 mm plank, the last and
  highest, at 0.78 m/s. The wheel stops dead (0.07 m/s within 80 ms), and
  the robot pitches over the plank. Another 800 iterations did not change
  that. Over seeds 1–3, with the drive phase at a lower speed, it stays up
  at 0.4 and 0.5 m/s, falls once at 0.6, and falls every time at 0.7.
- **At 0.5 m/s it does not fall, but it does not cross the 25 mm plank
  either** (`--scenario course_slow`, `course.mp4`, `eval/course_frames.png`).
  It crosses the 10, 15 and 20 mm planks. At the 25 mm one it bounces back
  about 0.4 m, retries, and is barely over it when the drive phase ends, so
  it never reaches the hill. It then spins at 2.56 rad/s for 2.5 commanded.
- **Why:** a 25 mm edge against the loaded 67 mm tyre takes about 1.2 Nm per
  wheel to climb statically on the weighed robot, against 0.9 Nm on the CAD
  model (half the weight times the radius times the sine of the contact
  angle). A balancing robot can only apply that torque by leaning into the
  edge or by arriving with momentum. Before the weighing, it managed this.
  The policy is blind, so it cannot slow down for an edge it cannot see. A
  step-climbing task that lifts the wheel with the legs, or a terrain
  estimate in the observation, is the way past 20 mm.
- **Expressive sequence:** roll 0.27 rad for ±0.3 commanded, and 0.23–0.24
  for ±0.25 while driving.
- **Height range:** still about 0.12–0.18 m. The commands of 0.093 and
  0.19 m reach 0.125 and 0.176 m.

**jump** (`jump.mp4`, `eval/jump_frames.png`): still three hops per
command, landing every time. It stands with 0.005 rad of roll:

| Phase | Target | Hops | Peak clearance | Peak leg / wheel torque |
| --- | --- | --- | --- | --- |
| standing | 3 cm | 3 | 92 mm | 7.5 / 7.4 Nm |
| standing | 5 cm | 3 | 95 mm | 7.7 / 7.2 Nm |
| standing | 8 cm | 3 | 120 mm | 7.6 / 7.2 Nm |
| 0.5 m/s | 5 cm | 3 | 95 mm | 7.6 / 7.3 Nm |
| 0.5 m/s | 8 cm | 3 | 108 mm | 7.8 / 5.7 Nm |

The height command matters even less than before: 3 cm now gives 92 mm.

### step_climb: planks up to 6 cm on the weighed robot

`configs/step_climb.yaml` is `jump.yaml` (10 Nm on every drive, commanded
jumps kept) on taller terrain. Planks go up to 6.5 cm, about the loaded
tyre's radius, and the hills' ramps go from 10° up to 50°. Forward tracking
pays 4 instead of 2, and a fall costs −100 instead of −200. The wheel-lift
constraint allows 9 cm of clearance instead of 3.5. The curriculum raises
the planks' maximum from 3.5 cm to 5 cm to 6.5 cm at iterations 0, 300 and
700.

**Three attempts:**

| Run | Start | Iterations | Wall time | Result on the steps course |
| --- | --- | --- | --- | --- |
| `step_climb_v0` | `agile_terrain`, its weights, kp 12, 10 Nm | 1000 | 29.8 min | Never crosses the 3 cm plank. It learnt to wait in front of planks: 0.10 falls per 1000 steps in training |
| `step_climb_v1` | `jump`, with the weights above | 1500 | 46.1 min | Checkpoint 1200 crosses the 3 cm plank, the 4 cm one sometimes: 7 of 20 planks |
| `step_climb_v2` (`configs/step_climb_v2.yaml`) | v1, plus the leg-split constraint and 8 step-ups (70–85° faces, 0.6–2 m tops) | 2000 | 75 min | Legs together (1–6 mm apart), but stops 10–25 cm before the 3 cm plank and at the foot of the curb on every seed. Not kept |

v0's outcome follows from the weights. A fall cost 200, while waiting in
front of a plank for the rest of an episode cost about 20 of forward
tracking. A manual check showed the hop is physically possible: the `jump`
policy, commanded to jump as it reached the 3 cm plank, got over it. v1
therefore starts from `jump`.

**Evaluation** (`--course steps --scenario steps`). The course has planks of
30, 40, 50 and 60 mm at 1–4 m, 0.1 m deep and 1.2 m wide, then a 6 cm curb
with 45° faces at 5.4 m. The drive phase is 14 s at 0.5 m/s. Progress is
measured from the axle's world position (`diag_truth_axle_x_m`, `_y_m`). A
plank counts only if the axle is within 0.55 m of the course line when it is
0.15 m past the plank. Earlier scoring, along the robot's own heading and
then along the course without the sideways check, counted planks the robot
had driven past beside them. It reported 20 of 20 for checkpoint 1200 and
chose that checkpoint on it; the per-checkpoint sweep made with it is
withdrawn.

`policies/step_climb` (v1, checkpoint 1200), 5 seeds, nominal latency:

| Operator | Planks crossed | Which | Curb | Falls |
| --- | --- | --- | --- | --- |
| none (`--heading-hold 0`) | 7 / 20 | 3 cm on 5 seeds, 4 cm on 2 | 0 / 5 | 0 / 5 |
| steers back to the heading (`--heading-hold 2`) | 7 / 20 | the same | 0 / 5 | 0 / 5 |

With the operator steering it stays on the line and stops at the 4 or 5 cm
plank, 1.8–2.8 m along the course. Without, it turns after the first
crossing and drives past the others beside them, which is what
`steps.mp4` shows.

- **The legs are split fore and aft.** In v1 and in `jump` the two legs'
  fore-aft offsets differ by 60–75 mm while standing (`agile_terrain`:
  about 1 mm). One wheel ahead of the other makes the robot statically
  stable in pitch, which pays under the pitch penalties and survives
  pushes; the `leg_symmetry` penalty (−200 per m², 0.7 per second at 60 mm)
  is too small to stop it. It is an exploit, not a gait anyone asked for.
  `constraints.leg_split` (CaT, here 20 mm with 30 mm slack) removes it, as
  v2 shows.
- **Why v2 stops.** Rolling a wheel up an edge of height h takes a tyre
  friction of at least tan θ, with cos θ = (r − h) / r: about 1.5 at 3 cm and
  2.2 at 4 cm for the 67 mm tyre, against 0.5–1.2 in training. A blind robot
  gets up a step only on momentum or by unloading the wheel with the legs.
  v1 did it from the split stance, one wheel at a time; with the legs held
  together and steep faces that punish a failed try, v2 learnt not to try.
  Commanding a jump in front of the plank does not help: it reverses away
  from the face after landing.
- **Hop on command** (`configs/step_climb_hop.yaml`, run `step_climb_hop_v1`,
  1500 iterations from v2, 45.6 min). In training the jump request also fires
  whenever the ground 0.1–0.4 m ahead rises by more than 1.5 cm, with a
  target of the rise plus 2 cm. `evaluate.py --hop` plays an operator who
  does the same from rays against the course. The legs stay together
  (≤ 5 mm). With heading hold 2 and hops, 5 seeds:

  | Checkpoint | 600 | 800 | 1000 | 1100 | 1200 | 1300 | 1400 | 1500 |
  | --- | --- | --- | --- | --- | --- | --- | --- | --- |
  | planks / 20 | 8 | 5 | 5 | 3 | 11 | 2 | 6 | 10 |
  | falls on the steps course / 5 | 5 | 5 | 5 | 5 | 4 | 5 | 3 | 5 |
  | onto the curb / 5 | 3 | 1 | 3 | 0 | 0 | 4 | 0 | 2 |
  | falls on the curb course / 5 | 1 | 0 | 0 | 0 | 0 | 1 | 0 | 0 |

  It is the first policy to get onto the 6 cm curb, and checkpoint 1500
  crossed the 5 cm plank once. But it falls on most runs over the planks,
  usually after landing from the first or second. It also falls without hop
  requests (4–5 of 5), where v2 only stopped. The checkpoints vary too much
  to pick one, so it is not kept. Next would be a longer run with a smaller
  learning rate, landings rewarded explicitly, and planks deep enough to
  land on in training (0.04–0.4 m now).
- **The heading drifts after crossings.** The command is a yaw rate, not a
  heading. `evaluate.py --heading-hold GAIN` models an operator who steers
  back to the scenario's heading.
- **The standard runs:** v1 completes all nine (`eval/comparison.md`); the
  WBC falls in three.
- **Commanded jumps** still give three hops each, with 90–115 mm of
  clearance.
- **Deployment:** like `jump`, its observation includes the two jump inputs,
  which `RlPolicyController` does not provide. It is not exported to ROS.

The next step for curbs is training on step-ups: long, tall platforms, and
more of them, rather than thin planks.

The weighing was done on a bench supply. Once the battery is fitted, weigh
the robot again, redo the tilt weighing and repeat this refit.

### stand_up: from switched off to balancing

`configs/stand_up.yaml`, `policies/stand_up` (checkpoint 2000 of 3000).

**What switched off looks like.** The description collides only the torso
shell and the two tyre cylinders; the leg links and motor holders have no
collision geometry and the leg joints no limits. Dropped limp, the legs fold
through each other and the body to more than 5 rad. The real legs have no
hard stop either: the links meet each other and the body.
`sandro_rl/collision.py` therefore adds one box per leg body, the oriented
bounding box of its collision-class CAD meshes (their convex hulls have up to
5184 vertices, too many for the GPU contact pipeline), massless, to
`sandro_rl`'s compiled model only. Six body pairs touch throughout a sweep of
the leg motors over ±0.6 rad around the stand pose: each lower link with its
motor holder, and the two lower links at the knee. They share a pin and are
excluded; every other pair collides. Only `stand_up` uses the boxes
(`env.collision.leg_boxes`); the other policies are unchanged.

With the boxes a limp robot folds until the lower links rest on the cranks
(about 1.2 and 1.44 rad) and tips over, front or back.
`python -m sandro_rl.fallen` drops it 1024 times from the stand pose, pitched
by up to ±80°, with some roll, a fore-aft shove and leg noise, and keeps the
852 that come to rest within 3 s (`data/fallen_states.npz`). About 60% lean
15–40° on a folded crank, IMU at 0.19 m. The rest lie at about 83° on the
motor holders, IMU at 0.10–0.13 m.

**Training.**

- **Starts:** 70% of episodes from a random pose of the bank, turned to a
  random heading; the rest standing.
- **No fall termination.** Lying down is where the episode starts. The tilt,
  leg-height and joint-range constraints are off. Stretch and leg split apply
  only once upright (tilt below 0.5 and 0.3 rad): folded flat, the legs are
  stretched, and getting up may brace on one leg. The leg-torque constraint
  is above the 10 Nm cap, which pushing up out of the fold saturates.
- **Rewards:** `upright`, (1 + cos tilt)/2, weight 6. `stand_height`, the IMU
  height from 0.15 m to standing mapped to 0–1, weight 10. Tracking pays only
  once upright (× exp(−(tilt/0.4)²)), so lying still earns nothing for it.
- **Lift assist:** an upward pull on the torso, 30 N while the IMU is below
  half its standing height and fading to 0 at standing height. The curriculum
  halves it at iteration 600 and removes it at 1200.
- **Horizon:** γ 0.995 (2 s at 100 Hz) instead of 0.99, because getting up
  takes seconds.
- **Start:** `flat_level`, with the action noise reset to 0.37 (it was 0.04).
- **Batch:** 4096 environments × 48 steps. The leg boxes' contact buffers do
  not fit 8192 in 16 GB.
- **Drives:** 10 Nm on every drive, as `jump`.

**Attempts:**

| Run | Change | Result |
| --- | --- | --- |
| v1 | From scratch, γ 0.99, `stand_height` = IMU height / standing height, no assist | Never stands: the IMU stays at about 60% of standing height and the noise grows to 1.2. Lying at 30° already earned 93% of `upright` and 58% of `stand_height`, and a 1 s horizon does not see the reward of a get-up that takes 2 s |
| v2 | The lift assist, γ 0.995, `stand_height` from 0.15 m, from `flat_level` with the noise reset | Stands up (below) |

Before either run could learn, three constraints had to change, each of
which held the termination probability at 0.24 of its 0.25 ceiling. A 9.5 Nm
torque limit fired at the 10 Nm cap. The stretch limit fired on legs folded
flat. And a 10.5 Nm limit still fired, because the torque is measured after
the ±15% drive spread.

**Evaluation** (`evaluate.py --scenario stand_up --fallen PITCH`). The robot
starts at the stand pose tipped by PITCH, unpowered for 3 s, and falls limp.
Then the policy engages, with no fall cut-off. The scenario gives 8 s to get
up, then 3 s at 0.4 m/s, 3 s turning at 1 rad/s and 2 s still. Success:
tilt below 0.25 rad with the IMU above 0.27 m at some point, and never above
0.5 rad during the drive phases.

- **Checkpoint choice:** checkpoints 1800–3000 on pitches ±0.3, ±0.8, ±1.4,
  3 seeds each. 1800, 2000, 2200 and 2800 succeed 18 of 18; 2400, 2600 and
  3000 only 14, 9 and 15. The four were then tested on pitches ±0.5, ±1.1,
  ±1.4, 2 seeds, under three latency profiles:

  | Checkpoint | nominal | uart_imu | worst |
  | --- | --- | --- | --- |
  | 1800 | 12/12 | 10/12 | 8/12 |
  | 2000 | 12/12 | 12/12 | 12/12 |
  | 2200 | 12/12 | 12/12 | 12/12 |
  | 2800 | 11/12 | 12/12 | 12/12 |

- **Speed:** from a lean of 23–31° it is up in 0.1 s. From 43–62° it takes
  0.7–1.6 s, and lying at 80–83° 0.4–0.9 s. Nose down, it rocks back onto
  the wheels and extends the legs. Nose up, it braces on one leg ahead of
  the other before standing (`eval/stand_up_*_frames.png`, `stand_up_front.mp4`,
  `stand_up_back.mp4`).
- **Once up**, it holds 6–7° of tilt at most while driving and turning,
  with the IMU at 0.32 m. The legs stay within 3 mm of each other fore and
  aft (15 mm in the turn, from the roll).
- **Torque:** the push up reaches the 10 Nm cap on single drives, above the
  controller's 3 Nm leg limit. On the robot this needs `jump`'s higher
  limits.
- **The standard runs** from standing: it completes all nine
  (`eval/comparison.md`); the WBC falls in three.
- **Not checked:** stand-ups on slopes or obstacles. And the boxes are a
  coarse stand-in for the CAD links. Where the robot really comes to rest
  depends on them, so a photo or a measurement of the real switched-off pose
  would be worth comparing against the bank.

**Refit on the 2026-11 body** (`runs/stand_up_body2611`, checkpoint 500 of
1000, now `policies/stand_up`). The new body collides through its handle and
the Raspberry Pi as well, and lies flatter: in the regenerated bank
(`data/fallen_states.npz`, 882 of 1024 drops) 47 % rest beyond 70° (39 %
before) and the IMU sits at 0.18 m (0.26). Resumed from the lag-refitted
`stand_up` with the curriculum's final stage (no lift assist), 10-80 ms of
wheel lag, the SPI IMU ranges, learning rate 3e-4 and action noise reset to
e^-1.2, at 3072 environments × 64 steps (the same batch; 4096 do not fit
next to a desktop session). The previous policy got up from 117 of 120 falls
of the evaluation below on the new body.

- **Checkpoints**, on pitches ±0.3, ±0.5, ±0.8, ±1.4, 2 seeds, 40 ms of lag:
  300 and 500 get up from 16 of 16; 400, 600 and 700 from 12; 800-1000 from
  4-7. The later ones lose the flat-on-the-back rest (1.46 rad) and stand
  crouched, as the original's checkpoints eroded.
- **Checkpoint 500** gets up from 120 of 120: pitches ±0.3 to ±1.4 (10),
  2 seeds, nominal, `spi_slow` and `worst` latency, 40 and 80 ms of wheel
  lag (300: 118, the previous policy: 117). It is up in 0.56 s at the median
  and 1.8 s at most (3.1 s before), and tilts at most 0.07 rad while driving
  and turning afterwards (0.10). The standard runs complete all nine; no
  wheel ringing from 0 to 80 ms of lag (`eval/lag_sweep.md`; the old body's
  sweep is `eval/lag_sweep_oldbody.md`). Frames:
  `eval/stand_up_{front,back}_frames.png`, videos `stand_up_{front,back}.mp4`.

**Deployment** (`rl_stand_up` in `sandro_bringup/config/rl_policies.yaml`,
`controller:=rl_stand_up`). `export_ros.py` sets `safety.start_lying` for
policies trained from the bank: `RlPolicyController` leaves the drives limp
(kd 0.5) where the robot lies, engages once it has rested 0.2 s at any tilt,
and arms the fall cut-off only once the body has been within 0.25 rad of
upright. The oscillation watchdog arms 3 s later with 1.2 rad/s for the legs
(`deploy.safety` in `configs/stand_up.yaml`): in its last push and the
settling after it the legs swing at up to 1.9 rad/s in the 5-15 Hz band,
0.8 rad/s afterwards. Getting up takes the 10 Nm the drives allow
(`mit_torque_limit_nm`), with leg kp 20 and kd 0.6.

### Wheel drive-train lag: the 7.5 Hz ringing on the robot

On the robot, `flat_level` rang at 7.4–7.5 Hz: both wheels in phase, actions
±0.7, 2.3 Nm RMS per wheel (docs/HANDOFF_flat_level_real.md). Body pitch
acceleration lags the reported wheel torque by 24–25 ms, and the IMU lags
the encoders by only 9 ms, so the lag is in the wheel drive train (backlash
and compliance), not in sensing. Training had randomised only 0.5–3 ms of
command delay.

- **Model:** `randomization.drives.wheel_lag_s` (base.yaml, 10–80 ms per
  episode; `nominal_wheel_lag_s` 40 ms) is a first-order lag on the wheel
  actuator torque at the physics rate. 50 ms of it is 67° of phase, 25 ms,
  at 7.5 Hz, which matches the robot. A backlash deadzone is not modelled.
- **Reproduced:** `evaluate.py --lag-sweep` runs hardware, default and push
  at 0, 35, 50 and 80 ms (`eval/lag_sweep.md`; the pre-refit sweep is
  `eval/lag_sweep_before.md`). `flat_level` rings at 7–10 Hz, 1.2–1.4 Nm,
  and falls at 80 ms; `agile_terrain` rings at 5–8.5 Hz, 1.1–1.6 Nm;
  `flat_tracking` falls at 35 ms. The 10 Nm policies (`jump`,
  `step_climb`) do not ring, and `stand_up` wobbles at 3.8 Hz.
- **Fine-tune** (`scripts/refit_lag.sh`, `sandro_rl/refit.py`): resume
  each policy with the final stage of its curriculum from iteration 0, the
  lag at 0–30 ms for 300 iterations and then 10–80 ms, 1000 iterations,
  learning rate 3e-4, and `train.resume_log_std` −1.2. The resumed action
  std (about 0.04) otherwise makes the first updates' KL 100× too large: a
  direct resume onto the full lag fell 16 times per 1000 steps.
  `flat_level_real` (`configs/flat_level_real.yaml`, 1500 iterations) also
  doubles the `action_rate` and `action_accel` weights.
  `scripts/package_refit.sh` replaces `policies/<name>` by the refit and
  re-evaluates it; the refit's curves are `*_lag`.
- **Comparison:** `--compare --sim wheel_lag=0.04` runs the policy with
  40 ms of lag and the WBC without (sandro_sim has no lag model). Each
  refit at 40 ms against the original at 0 ms (its own conditions), mean
  over phases:

  | Policy | Ringing at 35–80 ms | At 40 ms against the original at 0 ms |
  | --- | --- | --- |
  | `flat_level_real` | none (0.14–0.32 Nm, 5–15 Hz share ≤ 0.18) | Velocity and yaw errors within 10 %, pitch the same. Completes all 9 |
  | `flat_tracking` | none (0.13–0.32 Nm) | Velocity and yaw errors within 10 %; pitch RMS 0.04 → 0.065 rad in the worst profile. Completes all 9 |
  | `agile_terrain` | none (0.13–0.33 Nm) | Better: pitch RMS 30–70 % lower; worst profile velocity error 0.21 → 0.07 m/s, wheel torque 1.8 → 0.56 Nm. Same course (planks up to 20 mm). Roll 0.24 rad for 0.3 commanded (0.27 before) |
  | `jump` | none | Hops 86–116 mm. Lands every hop on 5 of 5 seeds with the UART IMU, where the original at 40 ms falls on 4. Both fall on 5 of 5 in the worst profile. Steady driving 10–50 % worse |
  | `step_climb` | none | Against the original at 40 ms: 5 of 20 planks either way, 1 fall in 5 instead of 2, a third to a quarter of the wheel torque under slow sensing. Yaw error 0.024 → 0.039 rad/s at nominal latency |
  | `stand_up` (checkpoint 500) | none | Up and staying up in 18 of 18 falls at 40 and 80 ms, and with the UART IMU and worst profiles at 40 ms. Once up, against the original at 40 ms: wheel torque 3–5 → 0.6–1.0 Nm, velocity error 0.5–0.67 → 0.08–0.12 m/s. Holds the leg height 16 mm off (2 mm before) |

- **`stand_up` checkpoints:** the stand-ups erode with more training under
  the full lag. On one seed per fall, checkpoint 400 succeeds 6 of 6, 600 5,
  and 700–1000 4: the 62° nose-up fall fails. Checkpoint 500 is kept.
- **Zero lag:** `flat_tracking` chatters at 50 Hz (1.0 Nm on one wheel) at
  exactly 0 ms, which the drive train cannot have; at 5 ms it is clean.
- **Deploy:** `export_ros policies/flat_level_real:rl_flat_level
  policies/agile_terrain:rl_agile_terrain` is done. Both were trained at
  wheel kd 0.4 with no wheel filter, so `wheel_kd_nm_s_rad: 0.4` and
  `wheel_filter_hz: 0`. `recordings/real_overrides_kd025_f4.yaml` (kd 0.25,
  4 Hz) was a stopgap; its filter adds lag of its own.

### The drives' torque envelope (2026-11)

The GIM6010-8 is rated 5 Nm continuous and 11 Nm peak. The legs were held
to 3 Nm by the balancers, and the flat and agile policies trained against
3 Nm legs and 6 Nm wheels (a constraint termination at 3 Nm), while on the
robot only the plugin's 10 Nm clamp applied to them. Every layer now uses
one envelope: 9 Nm in bursts, folding back to the rated 5 Nm as the heat
(torque² low-passed over 10 s) passes 0.7 of rated², and on the robot also
derated by the drive temperature (65–80 °C). The plugin applies it
(`torque_envelope.hpp`, `effort_limit` state interface, a panel warning
when a drive folds back); training and the CPU evaluator apply the same
law (`torque_envelope.py`) from a random half-budget start, with a
`thermal` constraint termination where the fold-back begins. The balancers'
leg limits are 9 Nm.

What the extra torque buys today is small: in `closed_loop.py` the WBC
peaks at 1.6 Nm on the legs under 25 N shoves (new `shove` scenario), and
the balancing policies at 2.5 Nm, so nothing that balances on flat ground
was torque-limited. Getting up and jumping are; the jump and step-climb
policies already trained at 10 Nm and will now see 9 Nm with the fold-back.

Fine-tunes under the envelope (600–800 iterations from each deployed
checkpoint):

| Policy | Result | Deployed |
| --- | --- | --- |
| `stand_up` | Up and settled in 60 of 60 falls (±0.3 to ±1.4 rad, three latency profiles, 40 and 80 ms wheel lag) at 9 Nm, median 0.70 s (0.92 s before at 10 Nm), slowest 5.1 s (3.0). On the standard scenarios the worst phase is 0.05 rad pitch RMS against 0.25 | yes |
| `flat_level_fast` | Pitch RMS 0.011–0.012 against 0.012–0.015 on the standard scenarios; under 15–25 N shoves 0.047 against 0.025, no falls. No chatter (worst phase wheel torque 0.9 Nm) | yes |
| `flat_level_real` | Pitch RMS 0.015–0.019 against 0.026–0.032 and no fall in the worst-case shoves, but with the IMU at 180 Hz / 15 ms (`spi_slow`) the wheels chatter at 4–9 Nm RMS in the driving and turning phases. A second run with the IMU delay randomised to 20 ms was worse (a fall). The "worst" profile, the same IMU with 5 ms joint delay, is clean, so it is the IMU lagging fresh joint data by 14 ms. Not understood | no, the previous checkpoint stays |
| `agile_terrain` | Mixed: standing pitch RMS 0.014 against 0.004 rad on the course, 23 Hz content on planks at nominal latency, calmer than before at the worst latency; action noise still rising (0.06 to 0.10) at the end, i.e. not converged in 600 iterations at 6144 envs (8192 run out of GPU memory beside the desktop) | no, the previous checkpoint stays |

### The 8–10 Hz yaw mode on the robot (2026-11-09)

Balancing on the 2026-11 body, every policy makes a fast, loud oscillation
that does not upset the balance; the WBC does at times. Recordings and
scripts: `recordings/buzz_2026-11-09/` (`buzz_spectrum.py` in
`recordings/`).

- **The mode:** 8–10 Hz, in yaw. The wheels move against each other (5–15 Hz
  right/left wheel velocity correlation −0.6 to −0.83, against +1.00 in the
  0.5–3 Hz forward rocking), the yaw rate is 2–4× the pitch rate, the legs
  move fore-aft (inner against outer, −0.76 to −0.93: in the five-bar's
  convention opposite crank motion moves the axle along planar x; the first
  version of this note said height) and the IMU sees it sideways. The noise is the wheel torque reversing through the gear
  backlash about ten times a second.
- **The policy drives it:** in `rl_flat_level` the wheel actions carry it
  (5–15 Hz RMS 0.05–0.06, as much as everything below 5 Hz).
- **Not the joint feedback:** with `state_source:=encoder` at a 20 ms
  broadcast (50 Hz, 3–19 ms old) it is at 11–13 Hz; with `state_source:=mit`
  (about 260 Hz, 1.4–2.3 ms old) at 9–10 Hz and as strong.
- **Not the drives' own damping loop:** a model of the MIT kd acting on a
  rotor that floats in the gear backlash rings at 100–180 Hz, but the
  60+ Hz band is 3–4× weaker than 5–15 Hz in every recording. Lowering the
  WBC's leg drive damping from 0.5 to 0.2 made it quieter by ear, not quiet.

| Policy (one MIT-mode run) | 5–15 Hz yaw rate | Wheels opposed / together | |
| --- | --- | --- | --- |
| `rl_flat_level_fast` | 0.88 rad/s | 1.48 / 0.74 rad/s | oscillation watchdog after 1.7 s (legs 1.00, wheels 1.21 rad/s) |
| `rl_flat_level` | 0.37 rad/s | 0.74 / 0.31 rad/s | |
| `rl_agile_terrain` | 0.10 rad/s | 0.20 / 0.12 rad/s | |

`agile_terrain` is the one trained with lateral pushes (up to 12 N), roll
and yaw torque disturbances (1 Nm) and a looser yaw sigma (0.5 against
0.35); its runtime gains are those of the flat policies. The likely plant is
a yaw resonance near 9 Hz that the simulation lacks: the body's yaw inertia
(0.093 kg m²) on about 370 Nm/rad of tyre side or leg compliance. Not
identified.

Next, not done: the flat policies with `agile_terrain`'s lateral and
roll/yaw disturbances and yaw sigma; a yaw (and roll) compliance between
body and ground in the MJCF, randomised so that its mode spans about
6–14 Hz; a penalty on the rate of the differential wheel action. Untried on
the robot: wheel kd 0.2 (`buzz_wheel_kd02.yaml`) and a low-pass on the
differential wheel command alone.

**What the mode is made of (2026-11-10).** Transfer functions at the peak
on the same bags, with the encoders' rolling yaw `r (w_R - w_L) / track`
against the gyro (coherence 0.97–0.99):

- The gyro's yaw lags the rolling yaw by 121–146° with a gain of about 1.
  The IMU's measured 8–9 ms explains about 30°. The BNO085 report used
  (calibrated gyroscope, 0x02) is lightly filtered, so 40 ms at 9 Hz is
  unlikely. With the IMU delay removed the phase runs −92° at 6.3 Hz, −113°
  at 9.4 Hz and −127° at 15 Hz: a fairly well damped compliance between the
  encoders and the body resonating near 6–8 Hz. About 32 Nm/rad per wheel
  drive train puts the body's yaw (0.093 kg m²) at 9.4 Hz.
- The legs swing fore-aft against each other by about 0.9 mm at 9 Hz,
  roughly half of the body's yaw at the wheel track: part of the compliance.
- The motor-side opposed wheel velocity and torque carry 13–23 % odd
  harmonics, the gyro 5–7 %: gear play inside the loop.
- The policy's opposed wheel action opposes the gyro's yaw rate (−161 to
  −178°). Through the lag it reaches the wheels about 40° early and feeds the
  mode. The wheel torque in phase with the encoders' velocity is what any
  sustained oscillation with friction needs and does not identify the plant.

In the CPU evaluator (`evaluate.Gear`: a rotor behind play and a spring,
the encoder and the drive law on the rotor) a 60–100 Nm/rad spring makes
`flat_level_real` and `agile_terrain` oscillate at robot-like amplitude
(0.15–0.19 rad/s), while `flat_level_fast` stays clean in every variant,
also with rubber-like damping. On the robot it is the worst, so no model
here reproduces the robot's ranking, and a policy clean in simulation may
still buzz. `ros2_ws/src/sandro_bringup/tools/drive_train_test.py`
measures the play and stiffness with the wheel blocked.

`flat_level_drivetrain` and `flat_level_fast_drivetrain` (deployed as
`rl_flat_level_drivetrain`, `rl_flat_level_fast_drivetrain`) train on that
drive train: in 80 % of the episodes each wheel's rotor sits behind
0–25 mrad of play and a 25–400 Nm/rad spring (log-uniform, damping
0.005–0.05 Nm s/rad, rotor 1–4 × the MJCF armature; `env._gear`, the drive
law every substep), with no first-order wheel lag in those episodes,
12 N lateral pushes and a penalty on the rate of the opposed wheel action.
On the drive-train grid (30–300 Nm/rad, play 0–20 mrad, rotor 1 and 4×)
the 5–15 Hz yaw is 0.004–0.008 rad/s against up to 0.16 for
`flat_level_real`. On the standard scenarios `flat_level_drivetrain` beats
`flat_level_real` in pitch everywhere (0.018–0.023 against 0.026–0.031),
has no slow-IMU chatter and no fall in the worst-case shoves, and its yaw
error rises from 0.011 to 0.013 rad/s; `flat_level_fast_drivetrain` is on
par with `flat_level_fast`.

**On the robot (2026-11-12, `recordings/buzz_2026-11-12/`).** Both
drivetrain policies pump the mode as hard as any: `rl_flat_level_drivetrain`
0.95 rad/s of 5–15 Hz yaw at 8.8 Hz (watchdog 0.97 of 1.0). The WBC, also
while turning at 1.5 rad/s, stays at 0.03–0.04 with no 9 Hz peak: the
structure does not ring by itself, the policies feed it. With
`action.wheel_differential_filter_hz: 3` (`buzz_yaw_filter_3hz.yaml`) the
9 Hz mode goes (0.10 rad/s, peak 3 Hz); the drivetrain policies then feel
unstable and slow (0.65–0.75 rad/s of 5–15 Hz common wheel motion, a 3 Hz yaw
wobble), `agile_terrain` stays quick and is the best to drive.

`recordings/yaw_closure.py` fits the gyro's 5–15 Hz yaw rate in the
policies' runs with the rotors' rolling yaw and the axle line turning under
the body (both legs' fore-aft motion). At full strength the gyro follows the
legs' term in phase at twice its size (b = 2.0, R² 0.91), which first read
as half the compliance in the legs' drive PD. The controlled measurement
below refutes that: in those runs the policy drives the legs too.

**Identified under the WBC (2026-11-12, `recordings/sysid_2026-11-12/`).**
`deploy/pi/pi sysid` (`sandro_bringup/tools/sysid_yaw.py`, the WBC's
`sysid.*` excitation) swept the differential wheel torque 2–25 Hz at
0.2 Nm per wheel at leg drive kp 12, 9, 16 and 12 again (coherence
0.9–0.99). Fitted as a yaw inertia behind one resonance, from the measured
wheel torque to the gyro:

| leg kp | resonance | zeta | yaw inertia | stiffness per wheel at the axle |
| --- | --- | --- | --- | --- |
| 12 | 12.2 Hz | 0.24 | 0.127 kg m² | 73 Nm/rad |
| 9 | 12.4 Hz | 0.24 | 0.131 kg m² | 77 Nm/rad |
| 16 | 12.5 Hz | 0.23 | 0.127 kg m² | 76 Nm/rad |
| 12 | 12.4 Hz | 0.24 | 0.123 kg m² | 73 Nm/rad |

- The legs' drive stiffness does not set the mode: −25 % and +33 % move
  it by under 3 % and not in the predicted direction (all of the
  compliance in the leg PD: −13 / +15 %). The legs swing at 0.6 of the
  body's yaw at 12 Hz, driven, not as the spring.
- Above the resonance the rotors' rolling is 1.7–2.5× the body's yaw and in
  antiphase: the spring is between the rotors and the ground, the wheel
  gears and the tyres, about 750 Nm/rad of yaw (75 per wheel).
- The yaw inertia is 35 % above the model's 0.093 kg m².
- Measured phase (gyro against wheel torque): −85° at 5 Hz, −111° at 7,
  −137° at 9, −155° at 10, −185° at 12, −213° at 14 Hz. The policies ring
  at 8.8–9.4 Hz, where the plant already lags 135–155°.
- The pulses' free decay rings at 4–5 Hz: the WBC's own yaw loop.

Amplitude (kp 12, chirps of 0.1, 0.2 and 0.4 Nm per wheel, the last near
the policies' torque: rotor travel 11–14 mrad, yaw rate 0.5 rad/s): the
resonance stays at 12.7 Hz and the gain within 5–10 % from 0.2 to 0.4 Nm,
so no gear-play dead zone shows in this range (small, or held to one side).
What grows with amplitude is the damping (zeta 0.24 → 0.30, 10–15° more
lag from 5 to 16 Hz: −149° against −137° at 9 Hz) and the legs' share of
the motion (0.30 → 0.51 of the body's yaw at 9 Hz): friction-like, the tyres
starting to scrub, not a softer spring. At 0.1 Nm the WBC's wheel friction
feed-forward (0.12 Nm, switching with the torque's sign) is as large as the
chirp and the coherence falls to 0.5–0.9: not usable.

**The simulation under the same chirp (2026-11-13).** `evaluate.py
--scenario sysid --sim yaw_chirp=0.2` adds the WBC's chirp to the wheels of
a balancing policy (`flat_level_drivetrain`) and the response is fitted
with `sysid_yaw.py`'s own functions:

| Simulation | resonance | zeta | yaw inertia | phase 5 / 9 / 12 Hz |
| --- | --- | --- | --- | --- |
| robot (kp 12, 0.2 Nm) | 12.7 Hz | 0.24 | 0.124 kg m² | −85 / −137 / −185° |
| MJCF as trained | none below 20 Hz | | 1.66 | −81 / −93 / −121° |
| tyre torsion × 0.01 | none | | 0.45 | −94 / −110 / −131° |
| tyre torsion × 0.01, no wheel frictionloss | none | | 0.147 | −105 / −124 / −138° |

- **The simulated robot barely yaws at small amplitude.** MuJoCo's
  torsional friction (0.07 m × 24 N, up to 1.7 Nm per tyre) and the wheels'
  0.2 Nm `frictionloss`, both Coulomb, stick at the chirp's 0.9 Nm of yaw
  torque: the apparent inertia is 13 × the robot's. The robot's small yaw
  motions are nearly free inertia. Every policy so far trained on a yaw that
  friction holds still and damps.
- **No drive-train spring reproduces the resonance** while the rotor is the
  MJCF armature (0.000168 kg m² at the wheel): a spring behind a massless
  rotor passes the torque through. The robot's numbers read as a two-mass
  system (rotors on a spring to the ground, the body's yaw on the rolling):
  the low-frequency inertia 0.124 is body plus rotors, the rolling share at
  the resonance (1.2) is their ratio, the resonance gives the spring. That
  is a body of about 0.068 kg m², rotors of about 0.0055 kg m² per wheel at
  the gear output (33 × the armature; the suspected ratio-once-not-squared
  error, `armature_scale`) and about 19 Nm/rad per wheel, gear damping
  about 0.11 Nm s/rad. Not confirmed: with the armature × 32 the simulation's
  low-frequency gain stays at half the robot's.

`drive_train_test.py` now ends with a 2–45 Hz chirp: with the rim blocked
the rotor rings at sqrt(k / J), 9 Hz for a 0.0055 kg m² rotor on 19 Nm/rad
and above 50 Hz for the armature, and the tool prints the rotor inertia.
That measurement decides the rotor, then the tyre-ground contact (torsion,
`frictionloss`) is fitted to the chirp table above.

## 9. Deployment sketch (not executed; the owner's decision)

This is a `sandro_controllers` controller plugin, `RlPolicyController`, that
replaces `whole_body_controller` and claims the same interfaces:

- **State interfaces:**
  - IMU orientation and angular velocity;
  - per joint, position and velocity.
- **Command interfaces:**
  - per leg joint, `position`, `velocity`, `kp`, `kd`, `effort` (the MIT
    interfaces the hardware plugin already exports, S2R l.400–403);
  - per wheel, `velocity` and `kd` in velocity mode, or `effort` in torque
    mode.

`policy.json` holds everything the controller needs:

- the observation layout, scales and history;
- the normalisation, which is baked into the ONNX graph;
- the action mapping, `stand_q`, gains and torque limits;
- the command shaping;
- the IMU offset correction;
- the rates;
- the model fingerprint.

The controller runs as follows:

- **Rate:** `update()` at 300 Hz (controllers.yaml `update_rate`). On every
  3rd cycle it builds the frame, runs inference and writes 6 MIT frames;
  otherwise it holds the frames.
- **Inference:** onnxruntime's C++ API, single-threaded, with the session
  created in `on_configure`. The actor has about 125k parameters. Its time
  per inference on the Raspberry Pi 5 is not measured here and must be
  measured before deployment. A missed deadline holds the previous frame.
  The model input and output sizes are checked against `policy.json` at
  configure.
- **Real-time safety:** no allocation in `update()`; preallocated tensors.

Safety fallbacks reuse the WBC's parameters from controllers.yaml `safety`:

- `fall_angle_rad` (1.0): beyond it, zero kp and kd 0.5 on the legs,
  zero wheel torque, latched until re-activation;
- `imu_timeout_s` (0.15) and `command_timeout_s` (0.3): an IMU timeout
  triggers the same fallback; a command timeout ramps the command to zero;
- `ramp_s` (0.5) on activation: the gains ramp from the measured pose;
- the hardware plugin's MIT frame-bias check stays in charge (S2R l.436–437).

A non-finite network output also triggers the fallback, and so does the
oscillation watchdog (`safety.oscillation_*`): each joint velocity
band-passed to 5–15 Hz, RMS over 0.3 s, beyond 1.0 rad/s on a leg or
5.0 rad/s on a wheel. On the robot the old `flat_level` rang at 1.8 (legs)
and 3–3.9 rad/s (wheels) and trips it 0.2 s in; the deployed policies stay
below 0.61 and 3.3 rad/s in every evaluation, 80 ms of wheel lag included.

From the stand phase the policy engages only inside its training start
states: tilt within `engage_tilt_rad` 0.08, every joint slower than 0.3 rad/s
for 0.2 s. The old `flat_level` engaged at 0.12 rad with the legs still
moving at 0.9 rad/s (2026-10-21), and its first actions kicked the legs and
wheels straight into the ringing. A hand-over from a balancing controller
keeps 0.15 rad (`hand_over_tilt_rad`).

The `velocity` wheel mode needs the MIT `velocity` and `kd` command
interfaces on the wheel drives. The plugin exports them for all six joints
(S2R l.400–403), so this is a configuration change only.

## 10. Assumptions and open issues

- **Drive speed limit.** No wheel speed limit is documented. The MIT frame
  encodes ±65 rad/s (the GIM6010 MIT range). 1 m/s needs 14.9 rad/s at the
  loaded 0.0672 m tyre radius, and the policies use at most 20 rad/s.
- **The 0.31–0.46 velocity gain of one left drive** (S2R l.248, l.283) is
  outside the randomised 0.75–1.05. A policy that relies on leg velocity
  would be hurt by that fault. Check that drive first, as S2R advises.
- **IMU rate on SPI** is about 200 Hz per signal with 9 ms of lag (measured 2026-10-21).
  Policies trained before 2026-11 also saw the 30 Hz UART rate; the
  evaluation profiles now bracket the SPI link (`spi_slow`, 180 Hz / 15 ms).
- **Encoder noise, gyro bias and kp scale** are assumptions (section 5).
- **Sim-to-sim gap.** The GPU environment and the CPU evaluation share the
  MJCF and the observation code (tested), but differ in two ways:
  - the physics is computed by different engines (section 3 gives the
    measured differences);
  - the evaluation runs the full `DelayLine`/`DriveBus` emulation, while
    training uses its batched equivalent.

  Every result in sections 7–8 is from the CPU evaluation, not from
  training.
- **Solver iteration limit.** MuJoCo Warp prints "solver iterations limit
  reached" during training. That happened 140 times in the 1000 iterations
  of `flat_tracking` and 233 times in the 1500 of `agile_obstacles`, each
  time in some of the 8192 worlds. I did not trace which states cause it
  (likely falls with many body contacts). The CPU evaluation, at the MJCF's
  own solver settings, is what the results rest on.
- **A world's simulation can diverge** (`agile_terrain_v0`, iteration
  1220). The guard in `env.step` contains it (section 8); the cause, one of
  pushes, torque kicks or ramp contacts, was not traced.
- **`agile_terrain`'s height range** is 0.12–0.18 m in practice, against
  0.09–0.19 m commanded (section 8). The next things to try:
  - a height-bin breakdown of the training error, to see whether low
    heights fail on flat ground or only on terrain;
  - a curriculum that widens the height range last;
  - the leg torque and wheel torque terms' cost at low heights;
  - a heavier height weight.
- **Roll feasibility** uses the per-leg range 0.07–0.195 m and the
  track width from the MJCF. The bounds are mine, chosen inside the
  kinematic reach; they are not measured limits.
- **Hardware data:** the owner's `flat_level` deployment rang at 7.5 Hz
  (section 8, wheel drive-train lag). The lag refits are untested on the
  robot. The 20 % agreement criterion of S2R §2 is the test to apply first,
  with a short, gentle sequence. The lag model is first-order only; if the
  refits still ring, a backlash deadzone is the next thing to model.

## 11. Proposed changes to the existing packages (not made)

1. **`closed_loop.cpp` `Sim::truth`**: compute the truth speed at the axle
   midpoint in the heading frame, as `evaluate.py` does with
   `diag_truth_forward_m_s`. At the torso origin it includes ω × 0.35 m
   while turning, and pitch motion as well (section 7).
2. **`closed_loop.py check`**: the `default/uart_imu` gate failed
   (S2R l.518–519). The SPI rate is now measured (about 200 Hz), and the gate
   is the slow end of that link (180 Hz / 15 ms, `spi_slow`).
3. **`sandro_controllers`**: add the `RlPolicyController` of section 9 as a
   separate plugin, so the WBC stays untouched and selectable with
   `controller:=`.
4. **`sandro.launch.py`**: `controller:=rl_policy policy_dir:=...` would
   load `policy.json`. The launch's latency arguments already cover the
   simulation side.
5. **`sync_model.py`**: run `sandro_rl.consistency` after `sync`, or
   document it as the follow-up step, so model changes surface as a failing
   check rather than a silently changed policy.
6. **`controllers.yaml` `drive` limits** (0.5 m/s, 1.5 rad/s) cap what the
   policy can be commanded through the WBC's shaping. `agile_obstacles` is
   trained to 1.0 m/s and 3 rad/s. Deploying it at that speed needs those
   limits raised for the RL controller only.
7. **`sim_identified.yaml` `imu_mount.roll_offset_rad`**: still the UART
   IMU's −0.049, while the robot overrides give the SPI6 mounting as
   +0.016. Its own comment says the simulated IMU should be rotated by the
   overrides' amount. The policies are unaffected either way, because they
   correct by the simulated mount and the robot's mount reaches them through
   the `rl_*` overrides. Matching it would make the WBC's simulation hold the
   same horizon as the robot.
8. **`sandro_description` collision geometry**: only the torso shell and
   the tyres collide. Leg-link collision shapes (`sandro_rl/collision.py`
   fits boxes to the CAD meshes) would make falls and the switched-off pose
   physical in every simulation, not only in `stand_up`.
9. **Starting a policy lying down** (`stand_up`): done, `safety.start_lying`
   (section 8, stand_up deployment). The folded legs sit at up to 2.2 rad,
   outside the ±2.09 rad target range; the targets are clamped to it in
   training as on the robot.
   Pushing up takes the 10 Nm drive limits, against 3 Nm today.
10. **Goal and range inputs** (`avoid`, section 12): `RlPolicyController`
    would need a range-sensor driver and two more frame terms. The goal term
    is `interface.goal_observation` of a goal kept by wheel odometry, as
    `interface.GoalOdometry` does. The ray term is `interface.ray_observation`
    of the latest scan, held between scans, with the rays in the order of
    `interface.ray_angles`. A goal could arrive as a `geometry_msgs/PoseStamped`
    relative to the robot. The cruise speed would stay `/cmd_vel` `linear.x`.
11. **Flow inference** (`train.algorithm: fpo`, section 13): `MlpPolicy` runs
    one MLP. A flow policy runs the same MLP `deploy_steps` times (8) on
    (observation, x, time), adding v / steps to x from x = 0.
    `fpo.build_onnx` shows the cheap form: the observation part of the first
    layer is computed once, and the time part is a constant bias per step.
    `export_ros.read_actor` refuses these graphs until the controller can
    run them.

## 12. Obstacle avoidance: `configs/avoid.yaml` (not trained yet)

Every policy above is blind. Planks and hills can be crossed without seeing
them, because the wheels feel them. A post or a wall has to be seen before
the robot reaches it. This task adds the three things avoidance needs:

- an exteroceptive input;
- a command that leaves the policy free to choose its path;
- obstacles that must not be touched.

It follows Agile But Safe (ABS, He et al. 2024, [RESEARCH.md](RESEARCH.md)
section 7): goal commands, ray distances as the exteroceptive input, and a
collision counted as a failure. It does not have ABS's second half, the
reach-avoid value network and recovery policy (see the open points below).

**The sensor is an assumption.** Sandro has no range sensor. The simulated
one is a planar 360° lidar:

- 16 beams (`interface.ray_angles`, symmetric about the forward axis);
- 2.5 m range;
- 8–15 Hz, sample and hold;
- noise of 1 cm + 1 % of the range;
- 2 % dropouts, read as no return;
- mounted 3 cm below the IMU, tilting with the body, so it sees the floor
  when the body pitches.

A narrower sensor, such as a multi-zone time-of-flight array, is
`rays.fov_deg` and `rays.count`. Its mass falls inside the ±0.4 kg payload
randomisation.

**Obstacles.** `pillars` are a new terrain kind: boxes 0.45–0.8 m tall,
from 8 cm posts to 1.2 m walls, as mocap bodies like the planks. They are
drawn after the planks and hills, so the shapes of the existing configs
are unchanged. Each episode places 14 of them in a 0.7–4.5 m ring. It then
puts `blockers` of them across the line to the first goal, and parks below
the floor any that would stand on the start pose or on the goal.

**Commands.** `commands.goals` replaces the forward speed and yaw rate:

- The goal is 1.5–4 m from the robot. The policy sees the actor term `goal`:
  (distance / 4 m capped at 1, cos and sin of the bearing), in the heading
  frame.
- The cruise speed is 0.3–1.2 m/s, in `command[0]`. `command[1]` (yaw rate)
  is always 0.
- The next goal comes after 1 s within 0.25 m of the current one, or when
  the time runs out (2× the straight-line time plus 3 s).
- The observed goal drifts by a random walk of 3 cm per metre driven: on
  the robot it comes from wheel odometry (`interface.GoalOdometry`).

**Rewards and failures** (weights × dt, as in section 4):

| Term | Weight | Definition |
| --- | --- | --- |
| `goal_progress` | 3 | velocity towards the goal, clipped to ± the cruise speed, / cruise speed; 0 on the goal |
| `goal_reach` | 3 | on the goal (within 0.25 m) × exp(−(speed / 0.15)²) |
| `goal_facing` | 0.3 | cos of the bearing, off the goal |
| `obstacle` | −3 | (1 − clearance / 0.3 m)² below 0.3 m |
| `track_forward`, `track_yaw` | 0 | replaced by the goal terms |

Everything else is `base.yaml`. Touching a pillar ends the episode as a
fall does (`termination.obstacle_m`: 0). A clearance under 5 cm is a CaT
constraint with a 5 cm slack. The clearance is the gap in the ground plane
between a 0.25 × 0.34 m box around the axle midpoint (the robot's 0.23 ×
0.32 m outline, inflated) and each pillar. The critic also gets the true
goal, the true ranges and the clearance.

**What was checked** (CPU, `tests/test_rays.py`, `tests/test_avoid.py`):

- the analytic ray cast (a slab test against the boxes and the floor)
  against MuJoCo's own `mj_ray`, to 2e-4 m on random rays;
- the env's scanner pose against `mj_ray` from the IMU site, to 1e-3 m;
- the footprint gap (separating axes plus corner distances) against brute
  force, to 1 cm;
- reset over 32 worlds: no start within 0.1 m of a pillar, every goal clear;
- a pillar under the robot ends the episode;
- the observation frame of `interface.py` against the env's, value by value;
- the odometry on a drive-and-turn.

Three PPO iterations of `avoid` and `avoid_fpo` ran on the CPU, through
`train.py` and `export.py`. Neither policy is trained.

**The JAX backend on the CPU.** `env.impl: jax` used to fail on this model:
MJX's JAX backend cannot collide the tyre cylinders with the body meshes.
For that backend only, the environment now keeps only the tyre and floor
contacts, as `bench.py` does. The rays, clearances and ground heights are
analytic, so the avoid task's logic can be debugged without a GPU.
Contacts other than the tyres' are missing there, so its physics is not
for training. The MuJoCo Warp path does not reach this code. For the
existing tasks, the changes of sections 12 and 13 leave the results
unchanged: two PPO iterations of `flat_tracking` and `agile_terrain`, run
with the original and the changed `env.py`, `ppo.py`, `terrain.py` and
`interface.py`, gave bit-identical parameters, states, observations and
rewards. The check ran on the JAX backend on the CPU, the only one
available to it.

**Evaluation** (`evaluate.py`, CPU MuJoCo with the full latency emulation):

```bash
uv run python -m sandro_rl.evaluate runs/avoid --scenario avoid --course slalom --video slalom.mp4
uv run python -m sandro_rl.evaluate runs/avoid --scenario avoid_fast --course wall
```

The courses are in `AVOID_COURSES`:

- `slalom`: three posts off the line and a wall, to 6.2 m and back;
- `wall`: a 1.6 m wall 1.5 m ahead, where going left or right is the
  policy's choice.

The evaluation runs the deployment side as the robot would:

- Each goal is placed relative to the robot when it is given, as an
  operator would place it, and then kept by `GoalOdometry` from the
  measured wheel speeds and IMU yaw.
- Arrival is judged from the odometry.
- The scanner is `mj_ray` at its mean rate, with the training's noise.

The clearance is `mj_geomDistance` between the robot's collision geoms and
the pillars, the truth rather than the box footprint. Each run writes
`<recording>.avoid.json` with:

- the goals reached, their times and their true position errors;
- the minimum clearance;
- whether the robot collided or fell.

**Open points.**

- **No safety shield.** ABS pairs the agile policy with a learned
  reach-avoid value and a recovery policy that takes over when that value
  says a collision is coming. Training that value on this environment's
  rollouts is the next step towards running at speed on the hardware.
- **Static, box-shaped obstacles only.** No moving obstacles, no people.
- **The legs are not in the footprint.** Only the torso and tyres collide
  in the description (section 11, item 8).
- **A planar scanner misses planks and steps.** Combining this task with
  `step_climb` needs a height scan, or a tilted second scanner.
- **Not exportable to ROS** (section 11, item 10).

## 13. Flow policies: FPO++ (`train.algorithm: fpo`)

`fpo.py` trains a flow-matching policy with FPO++ (Yi et al. 2026, arXiv
2602.02481; [RESEARCH.md](RESEARCH.md) section 7) in place of the Gaussian.
FPO++ is the first flow policy taken to humanoid hardware without expert
distillation. Everything else of `ppo.py` is shared: rollout, GAE, the
asymmetric critic, CaT, the normalisers, the curriculum. `ppo.py` was
refactored so that sampling and the update are methods. The Gaussian path
computes exactly what it did before (the bit-identity check of section 12).

**The method.**

- **The flow.** The actor is a velocity field v(x_τ, τ, obs) over the
  scaled action x = a / 0.5. Training rollouts integrate it from
  x_0 ~ N(0, I) in 16 Euler steps. The 0.5 makes the initial spread equal
  to the Gaussian's `init_log_std` of −0.7 (measured: 0.491 against 0.497).
- **The exported policy is deterministic.** It integrates from x_0 = 0
  ("zero-sampling") in 8 steps, unrolled into the ONNX graph. The exported
  graph matches the numpy reference to 7e-9.
- **The ratio.** A flow has no likelihood. The update uses the flow-matching
  loss l of 8 (τ, ε) pairs per action as a stand-in, with one ratio per
  pair, ρ_i = exp(l_old − l_new), each clipped on its own.
- **The surrogate (ASPO).** Positive advantages use PPO's clip (0.05).
  Negative ones use SPO: ρA − |A|(ρ − 1)² / (2 · 0.05).
- **Optimiser.** AdamW at a fixed 1e-4, betas (0.9, 0.95), weight decay
  1e-4, 16 epochs, no entropy bonus.
- **Symmetry.** The mirror loss becomes equivariance of the field:
  v(Mx, τ, M obs) = M v(x, τ, obs).

**Departures from the paper's locomotion settings** (`configs/flat_tracking_fpo.yaml`):

- 16 flow steps instead of 64, and 8 Monte-Carlo samples instead of 16,
  for compute and GPU memory;
- the loss clamp (20) and the log-ratio clamp (±2) are mine; the paper
  does not give its values;
- the critic keeps PPO's value clip of 0.2.

**What it buys, measured on a toy** (`tests/test_fpo.py`, 256 one-step
bandits, the same networks and budget for both):

| Problem | Gaussian PPO | FPO++ |
| --- | --- | --- |
| One best action per context: error of the deterministic action after 150 iterations (0.32 at the start) | 0.0007 | 0.037 |
| Two equally good actions (+M and −M): share of sampled actions on the + side, two seeds | 16 %, 20 % | 53 %, 48 % |
| Two equally good actions: mean reward | −0.23, −0.21 | −0.03, −0.02 |

With one right answer, the Gaussian learns faster; the paper also reports
that FPO++ does not fully close the gap to tuned Gaussian PPO. With two
right answers, the Gaussian leans to one side and pays for its spread over
both. The flow keeps both, and its deterministic action still lands on one
of them. Balancing and speed tracking have one right answer. Passing a wall
on the left or on the right has two. That is why `avoid_fpo.yaml` exists.

**Cost on the robot.** Each action takes 8 forward passes of the 125k-parameter
actor instead of 1. The observation half of the first layer is shared across
the passes. The time on the Raspberry Pi is not measured.

**To run on the GPU:**

```bash
uv run python -m sandro_rl.train configs/flat_tracking.yaml --out runs/flat_ppo
uv run python -m sandro_rl.train configs/flat_tracking_fpo.yaml --out runs/flat_fpo
uv run python -m sandro_rl.evaluate runs/flat_fpo --compare      # same table as flat_tracking's
uv run python -m sandro_rl.train configs/avoid.yaml --out runs/avoid
uv run python -m sandro_rl.train configs/avoid_fpo.yaml --out runs/avoid_fpo
```

The training throughput of FPO++ at 8192 worlds and its GPU memory use
(the update evaluates the field at 8 pairs per action) are not measured. If
memory runs out, lower `train.fpo.mc_samples` or raise `train.minibatches`.

### Trained on Sandro (2026-11-10 and 11)

`flat_tracking` from scratch on the 2026-11 body, PPO against FPO++ with
the same environment, 8192 worlds. FPO++ runs at 52k environment steps per
second against 120–160k for PPO, with 2.9 GB of GPU memory.

| Run | 400 iterations: episode s / falls per 1000 steps | 1500 iterations |
| --- | --- | --- |
| PPO (`policies/flat_tracking_ppo`) | 20 / 0 (from iteration 100) | 20 / 0, errors 0.06 m/s, 0.06 rad/s |
| FPO++, the paper's settings (`flat_tracking_fpo.yaml`) | 1.6 / 6.4 | 10 / 0.8; falls in every evaluation run |
| learning rate 3e-4, clip 0.1 | 2.7 / 3.3 | |
| the same, `action_scale` 0.25 | 4.4 / 2.3 | blew up after 450: KL to 0.028, action noise 2.2 at 850, then KL 0 for good |
| + `desired_kl` 0.005, `loss_clamp: null` | 8.0 / 1.0 | 18 / 0.1; tracking 0.24 m/s, 0.44 rad/s |

Three things held FPO++ back here:

- **A fixed learning rate.** At 1e-4 the per-update KL is about 0.0002 and
  learning crawls; at 3e-4 the steps grow until the policy blows up.
  `desired_kl` adapts the rate as `ppo.py` does.
- **The loss clamp.** Once both CFM losses exceed `loss_clamp` the ratio
  is 1 and has no gradient, so the blown-up run never recovered.
  `loss_clamp: null` removes the dead zone (the log-ratio clamp stays).
- **Exploration noise it cannot shed.** Both start at an action noise of
  0.5, which tips the robot within a second. PPO learns its noise down to
  0.37 by iteration 20; the flow has to learn to contract its base
  distribution and was still at 0.48 at iteration 100. ASPO, built to keep
  exploration, makes it worse here: the noise grew back from 0.10 to 0.32
  over 700 iterations and the tracking error doubled.

**The recipe that trains** (`flat_tracking_fpo_warm.yaml`, then
`flat_tracking_fpo_finetune.yaml`): the fixes above with `action_scale`
0.25 and, for the first 200 iterations, `teacher: policies/flat_tracking_ppo`,
the flow matching loss toward the PPO policy's action on the flow's own
states (at a fixed learning rate). Full 20 s episodes by iteration 150, the
noise down to 0.10, then 100 iterations of FPO++ alone; stage 2 resumes with
`aspo: false` for 700 iterations (noise 0.07, stable). 1000 iterations,
about 95 minutes.

`policies/flat_tracking_fpo` against `policies/flat_tracking_ppo`
(`evaluate.py --compare`, averaged over phases):

| | PPO | FPO++ |
| --- | --- | --- |
| Pitch RMS, rad | 0.021–0.027 | 0.015–0.019 |
| Speed error, hardware and default sequences, m/s | 0.074–0.103 | 0.079–0.092 |
| Speed error, push scenario, m/s | 0.037–0.039 | 0.047–0.055 |
| Yaw-rate error, rad/s | 0.007–0.048 | 0.005–0.020 |
| Falls | none | none |

It balances more steadily in every scenario, tracks speed about as well
except under pushes, and completes the wheel-lag sweep (5–15 Hz share
0.17–0.31 at 50–80 ms). `RlPolicyController` cannot run it yet (the
multi-step flow, section 11 item 11). `avoid` against `avoid_fpo` is not
trained.
