A-Common-Guy/bipedale/sandro_rl/policies/flat_tracking_fpo/eval/comparison.md

**hardware/nominal** — policy completed, WBC completed

| phase | command | truth_pitch_rms | truth_speed_err_rms | pitch_rms | pitch_peak_hz | vel_err_rms | yaw_err_rms | yaw_rise_s | height_err | wheel_tau_rms | wheel_flip_frac | leg_eff_rms |
|---|---|---|---|---|---|---|---|---|---|---|---|---|
| 0 policy | 5,0,0 | 0.008 | 0.014 | 0.012 | 0.600 | 0.024 | 0.002 | nan | -0.001 | 0.372 | 0.020 | 0.795 |
| 0 wbc | 5,0,0 | 0.017 | 0.048 | 0.019 | 0.397 | 0.070 | 0.052 | nan | 0.002 | 0.263 | 0.005 | 0.774 |
| 1 policy | 4,0.2,0 | 0.013 | 0.075 | 0.015 | 1.000 | 0.081 | 0.003 | nan | 0.000 | 0.554 | 0.004 | 0.786 |
| 1 wbc | 4,0.2,0 | 0.013 | 0.059 | 0.015 | 23.750 | 0.092 | 0.140 | nan | 0.001 | 0.405 | 0.001 | 0.785 |
| 2 policy | 4,0,0 | 0.020 | 0.037 | 0.021 | 0.750 | 0.078 | 0.004 | nan | -0.000 | 0.532 | 0.012 | 0.794 |
| 2 wbc | 4,0,0 | 0.021 | 0.081 | 0.022 | 0.500 | 0.088 | 0.101 | nan | 0.001 | 0.301 | 0.006 | 0.790 |
| 3 policy | 4,0.2,0.6 | 0.014 | 0.228 | 0.016 | 0.750 | 0.081 | 0.042 | 0.200 | 0.001 | 0.491 | 0.011 | 0.956 |
| 3 wbc | 4,0.2,0.6 | 0.006 | 0.243 | 0.010 | 11.750 | 0.070 | 0.159 | 1.000 | 0.001 | 0.546 | 0.001 | 0.901 |
| 4 policy | 3,0,0 | 0.022 | 0.088 | 0.023 | 0.667 | 0.097 | 0.027 | 0.000 | -0.000 | 0.690 | 0.016 | 0.807 |
| 4 wbc | 3,0,0 | 0.026 | 0.141 | 0.027 | 0.336 | 0.098 | 0.142 | 0.000 | 0.001 | 0.336 | 0.004 | 0.819 |

**hardware/spi_slow** — policy completed, WBC completed

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
| 10 policy | 3,0,0 | 0.011 | 0.019 | 0.013 | 0.667 | 0.031 | 0.003 | nan | -0.002 | 0.360 | 0.018 | 0.633 |
| 10 wbc | 3,0,0 | 0.017 | 0.043 | 0.019 | 0.336 | 0.062 | 0.044 | nan | -0.007 | 0.251 | 0.011 | 0.711 |

**push/nominal** — policy completed, WBC completed

| phase | command | truth_pitch_rms | truth_speed_err_rms | pitch_rms | pitch_peak_hz | vel_err_rms | yaw_err_rms | yaw_rise_s | height_err | wheel_tau_rms | wheel_flip_frac | leg_eff_rms |
|---|---|---|---|---|---|---|---|---|---|---|---|---|
| 0 policy | 10,0,0 | 0.015 | 0.047 | 0.017 | 0.800 | 0.094 | 0.005 | nan | -0.000 | 0.795 | 0.021 | 0.802 |
| 0 wbc | 10,0,0 | 0.019 | 0.069 | 0.020 | 0.399 | 0.109 | 0.085 | nan | 0.001 | 0.307 | 0.006 | 0.777 |

**push/spi_slow** — policy completed, WBC completed

| phase | command | truth_pitch_rms | truth_speed_err_rms | pitch_rms | pitch_peak_hz | vel_err_rms | yaw_err_rms | yaw_rise_s | height_err | wheel_tau_rms | wheel_flip_frac | leg_eff_rms |
|---|---|---|---|---|---|---|---|---|---|---|---|---|
| 0 policy | 10,0,0 | 0.017 | 0.055 | 0.019 | 15.700 | 0.161 | 0.020 | nan | 0.002 | 3.067 | 0.082 | 0.980 |
| 0 wbc | 10,0,0 | 0.018 | 0.070 | 0.019 | 0.399 | 0.114 | 0.088 | nan | 0.001 | 0.339 | 0.010 | 0.776 |

**push/worst** — policy completed, WBC completed

| phase | command | truth_pitch_rms | truth_speed_err_rms | pitch_rms | pitch_peak_hz | vel_err_rms | yaw_err_rms | yaw_rise_s | height_err | wheel_tau_rms | wheel_flip_frac | leg_eff_rms |
|---|---|---|---|---|---|---|---|---|---|---|---|---|
| 0 policy | 10,0,0 | 0.017 | 0.050 | 0.018 | 0.800 | 0.102 | 0.006 | nan | -0.001 | 0.962 | 0.015 | 0.795 |
| 0 wbc | 10,0,0 | 0.018 | 0.071 | 0.020 | 0.399 | 0.116 | 0.089 | nan | 0.001 | 0.353 | 0.015 | 0.775 |

**push/mit** — policy completed, WBC completed

| phase | command | truth_pitch_rms | truth_speed_err_rms | pitch_rms | pitch_peak_hz | vel_err_rms | yaw_err_rms | yaw_rise_s | height_err | wheel_tau_rms | wheel_flip_frac | leg_eff_rms |
|---|---|---|---|---|---|---|---|---|---|---|---|---|
| 0 policy | 10,0,0 | 0.015 | 0.048 | 0.017 | 0.800 | 0.095 | 0.005 | nan | -0.000 | 0.844 | 0.020 | 0.802 |
| 0 wbc | 10,0,0 | 0.019 | 0.069 | 0.020 | 0.399 | 0.109 | 0.085 | nan | 0.001 | 0.306 | 0.007 | 0.777 |
