A-Common-Guy/bipedale/sandro_rl/policies/flat_tracking_fpo/eval/lag_sweep.md

| scenario | wheel lag (s) | result | wheel effort RMS R/L (Nm) | peak (Hz) | 5-15 Hz share |
|---|---|---|---|---|---|
| hardware | 0.000 | completed | 0.32 / 0.26 | 0.1 / 0.0 | 0.03 |
| hardware | 0.035 | completed | 0.33 / 0.26 | 0.1 / 0.0 | 0.15 |
| hardware | 0.050 | completed | 0.33 / 0.26 | 0.1 / 0.0 | 0.17 |
| hardware | 0.080 | completed | 0.33 / 0.26 | 0.1 / 0.0 | 0.18 |
| default | 0.000 | completed | 0.31 / 0.26 | 0.0 / 0.1 | 0.02 |
| default | 0.035 | completed | 0.30 / 0.26 | 0.0 / 0.1 | 0.10 |
| default | 0.050 | completed | 0.30 / 0.25 | 0.0 / 0.1 | 0.04 |
| default | 0.080 | completed | 0.31 / 0.26 | 0.0 / 0.1 | 0.05 |
| push | 0.000 | completed | 0.24 / 0.26 | 0.8 / 0.8 | 0.04 |
| push | 0.035 | completed | 0.22 / 0.23 | 0.8 / 0.8 | 0.24 |
| push | 0.050 | completed | 0.24 / 0.25 | 0.9 / 0.9 | 0.31 |
| push | 0.080 | completed | 0.25 / 0.27 | 0.7 / 0.7 | 0.28 |
