A-Common-Guy/bipedale/sandro_rl/policies/flat_tracking_ppo/eval/comparison.md

**hardware/nominal** — policy completed, WBC completed

| phase | command | truth_pitch_rms | truth_speed_err_rms | pitch_rms | pitch_peak_hz | vel_err_rms | yaw_err_rms | yaw_rise_s | height_err | wheel_tau_rms | wheel_flip_frac | leg_eff_rms |
|---|---|---|---|---|---|---|---|---|---|---|---|---|
| 0 policy | 5,0,0 | 0.007 | 0.007 | 0.011 | 0.400 | 0.007 | 0.004 | nan | 0.001 | 0.148 | 0.053 | 0.780 |
| 0 wbc | 5,0,0 | 0.017 | 0.048 | 0.019 | 0.397 | 0.070 | 0.052 | nan | 0.002 | 0.263 | 0.005 | 0.774 |
| 1 policy | 4,0.2,0 | 0.027 | 0.052 | 0.029 | 1.000 | 0.074 | 0.006 | nan | -0.001 | 1.574 | 0.001 | 0.794 |
| 1 wbc | 4,0.2,0 | 0.013 | 0.059 | 0.015 | 23.750 | 0.092 | 0.140 | nan | 0.001 | 0.405 | 0.001 | 0.785 |
| 2 policy | 4,0,0 | 0.026 | 0.040 | 0.028 | 0.500 | 0.078 | 0.008 | nan | 0.001 | 0.466 | 0.022 | 0.783 |
| 2 wbc | 4,0,0 | 0.021 | 0.081 | 0.022 | 0.500 | 0.088 | 0.101 | nan | 0.001 | 0.301 | 0.006 | 0.790 |
| 3 policy | 4,0.2,0.6 | 0.027 | 0.242 | 0.027 | 0.500 | 0.077 | 0.041 | 0.160 | -0.000 | 1.435 | 0.033 | 0.943 |
| 3 wbc | 4,0.2,0.6 | 0.006 | 0.243 | 0.010 | 11.750 | 0.070 | 0.159 | 1.000 | 0.001 | 0.546 | 0.001 | 0.901 |
| 4 policy | 3,0,0 | 0.032 | 0.093 | 0.032 | 0.667 | 0.106 | 0.026 | 0.000 | 0.001 | 0.452 | 0.008 | 0.795 |
| 4 wbc | 3,0,0 | 0.026 | 0.141 | 0.027 | 0.336 | 0.098 | 0.142 | 0.000 | 0.001 | 0.336 | 0.004 | 0.819 |

**hardware/spi_slow** — policy completed, WBC completed

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
| 10 policy | 3,0,0 | 0.017 | 0.011 | 0.019 | 0.333 | 0.014 | 0.004 | nan | -0.002 | 0.229 | 0.016 | 0.643 |
| 10 wbc | 3,0,0 | 0.017 | 0.043 | 0.019 | 0.336 | 0.062 | 0.044 | nan | -0.007 | 0.251 | 0.011 | 0.711 |

**push/nominal** — policy completed, WBC completed

| phase | command | truth_pitch_rms | truth_speed_err_rms | pitch_rms | pitch_peak_hz | vel_err_rms | yaw_err_rms | yaw_rise_s | height_err | wheel_tau_rms | wheel_flip_frac | leg_eff_rms |
|---|---|---|---|---|---|---|---|---|---|---|---|---|
| 0 policy | 10,0,0 | 0.021 | 0.037 | 0.022 | 0.600 | 0.104 | 0.007 | nan | 0.001 | 0.455 | 0.036 | 0.781 |
| 0 wbc | 10,0,0 | 0.019 | 0.069 | 0.020 | 0.399 | 0.109 | 0.085 | nan | 0.001 | 0.307 | 0.006 | 0.777 |

**push/spi_slow** — policy completed, WBC completed

| phase | command | truth_pitch_rms | truth_speed_err_rms | pitch_rms | pitch_peak_hz | vel_err_rms | yaw_err_rms | yaw_rise_s | height_err | wheel_tau_rms | wheel_flip_frac | leg_eff_rms |
|---|---|---|---|---|---|---|---|---|---|---|---|---|
| 0 policy | 10,0,0 | 0.023 | 0.039 | 0.024 | 0.600 | 0.108 | 0.008 | nan | 0.001 | 0.509 | 0.019 | 0.784 |
| 0 wbc | 10,0,0 | 0.018 | 0.070 | 0.019 | 0.399 | 0.114 | 0.088 | nan | 0.001 | 0.339 | 0.010 | 0.776 |

**push/worst** — policy completed, WBC completed

| phase | command | truth_pitch_rms | truth_speed_err_rms | pitch_rms | pitch_peak_hz | vel_err_rms | yaw_err_rms | yaw_rise_s | height_err | wheel_tau_rms | wheel_flip_frac | leg_eff_rms |
|---|---|---|---|---|---|---|---|---|---|---|---|---|
| 0 policy | 10,0,0 | 0.024 | 0.039 | 0.025 | 0.500 | 0.111 | 0.007 | nan | 0.001 | 0.640 | 0.024 | 0.782 |
| 0 wbc | 10,0,0 | 0.018 | 0.071 | 0.020 | 0.399 | 0.116 | 0.089 | nan | 0.001 | 0.353 | 0.015 | 0.775 |

**push/mit** — policy completed, WBC completed

| phase | command | truth_pitch_rms | truth_speed_err_rms | pitch_rms | pitch_peak_hz | vel_err_rms | yaw_err_rms | yaw_rise_s | height_err | wheel_tau_rms | wheel_flip_frac | leg_eff_rms |
|---|---|---|---|---|---|---|---|---|---|---|---|---|
| 0 policy | 10,0,0 | 0.021 | 0.037 | 0.023 | 0.600 | 0.104 | 0.007 | nan | 0.001 | 0.458 | 0.034 | 0.781 |
| 0 wbc | 10,0,0 | 0.019 | 0.069 | 0.020 | 0.399 | 0.109 | 0.085 | nan | 0.001 | 0.306 | 0.007 | 0.777 |
