A-Common-Guy/bipedale/sandro_rl/policies/stand_up/eval/comparison.md

**hardware/nominal** — policy completed, WBC completed

| phase | command | truth_pitch_rms | truth_speed_err_rms | pitch_rms | pitch_peak_hz | vel_err_rms | yaw_err_rms | yaw_rise_s | height_err | wheel_tau_rms | wheel_flip_frac | leg_eff_rms |
|---|---|---|---|---|---|---|---|---|---|---|---|---|
| 0 policy | 5,0,0 | 0.015 | 0.033 | 0.017 | 0.400 | 0.047 | 0.003 | nan | 0.022 | 0.484 | 0.028 | 0.509 |
| 0 wbc | 5,0,0 | 0.017 | 0.048 | 0.019 | 0.397 | 0.070 | 0.052 | nan | 0.002 | 0.263 | 0.005 | 0.774 |
| 1 policy | 4,0.2,0 | 0.009 | 0.056 | 0.013 | 0.500 | 0.077 | 0.006 | nan | 0.021 | 0.625 | 0.002 | 0.517 |
| 1 wbc | 4,0.2,0 | 0.013 | 0.059 | 0.015 | 23.750 | 0.092 | 0.140 | nan | 0.001 | 0.405 | 0.001 | 0.785 |
| 2 policy | 4,0,0 | 0.016 | 0.058 | 0.018 | 0.500 | 0.070 | 0.004 | nan | 0.022 | 0.524 | 0.018 | 0.520 |
| 2 wbc | 4,0,0 | 0.021 | 0.081 | 0.022 | 0.500 | 0.088 | 0.101 | nan | 0.001 | 0.301 | 0.006 | 0.790 |
| 3 policy | 4,0.2,0.6 | 0.009 | 0.243 | 0.011 | 0.500 | 0.074 | 0.040 | 0.180 | 0.021 | 0.564 | 0.001 | 0.727 |
| 3 wbc | 4,0.2,0.6 | 0.006 | 0.243 | 0.010 | 11.750 | 0.070 | 0.159 | 1.000 | 0.001 | 0.546 | 0.001 | 0.901 |
| 4 policy | 3,0,0 | 0.015 | 0.094 | 0.017 | 0.333 | 0.080 | 0.018 | 0.000 | 0.022 | 0.481 | 0.021 | 0.530 |
| 4 wbc | 3,0,0 | 0.026 | 0.141 | 0.027 | 0.336 | 0.098 | 0.142 | 0.000 | 0.001 | 0.336 | 0.004 | 0.819 |

**hardware/spi_slow** — policy completed, WBC completed

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
| 10 policy | 3,0,0 | 0.018 | 0.039 | 0.019 | 0.333 | 0.051 | 0.004 | nan | 0.003 | 0.525 | 0.018 | 0.580 |
| 10 wbc | 3,0,0 | 0.017 | 0.043 | 0.019 | 0.336 | 0.062 | 0.044 | nan | -0.007 | 0.251 | 0.011 | 0.711 |

**push/nominal** — policy completed, WBC completed

| phase | command | truth_pitch_rms | truth_speed_err_rms | pitch_rms | pitch_peak_hz | vel_err_rms | yaw_err_rms | yaw_rise_s | height_err | wheel_tau_rms | wheel_flip_frac | leg_eff_rms |
|---|---|---|---|---|---|---|---|---|---|---|---|---|
| 0 policy | 10,0,0 | 0.018 | 0.057 | 0.020 | 0.400 | 0.100 | 0.005 | nan | 0.022 | 0.585 | 0.016 | 0.518 |
| 0 wbc | 10,0,0 | 0.019 | 0.069 | 0.020 | 0.399 | 0.109 | 0.085 | nan | 0.001 | 0.307 | 0.006 | 0.777 |

**push/spi_slow** — policy completed, WBC completed

| phase | command | truth_pitch_rms | truth_speed_err_rms | pitch_rms | pitch_peak_hz | vel_err_rms | yaw_err_rms | yaw_rise_s | height_err | wheel_tau_rms | wheel_flip_frac | leg_eff_rms |
|---|---|---|---|---|---|---|---|---|---|---|---|---|
| 0 policy | 10,0,0 | 0.017 | 0.056 | 0.019 | 0.400 | 0.101 | 0.005 | nan | 0.021 | 0.702 | 0.021 | 0.523 |
| 0 wbc | 10,0,0 | 0.018 | 0.070 | 0.019 | 0.399 | 0.114 | 0.088 | nan | 0.001 | 0.339 | 0.010 | 0.776 |

**push/worst** — policy completed, WBC completed

| phase | command | truth_pitch_rms | truth_speed_err_rms | pitch_rms | pitch_peak_hz | vel_err_rms | yaw_err_rms | yaw_rise_s | height_err | wheel_tau_rms | wheel_flip_frac | leg_eff_rms |
|---|---|---|---|---|---|---|---|---|---|---|---|---|
| 0 policy | 10,0,0 | 0.019 | 0.060 | 0.020 | 0.400 | 0.102 | 0.006 | nan | 0.021 | 0.738 | 0.020 | 0.522 |
| 0 wbc | 10,0,0 | 0.018 | 0.071 | 0.020 | 0.399 | 0.116 | 0.089 | nan | 0.001 | 0.353 | 0.015 | 0.775 |

**push/mit** — policy completed, WBC completed

| phase | command | truth_pitch_rms | truth_speed_err_rms | pitch_rms | pitch_peak_hz | vel_err_rms | yaw_err_rms | yaw_rise_s | height_err | wheel_tau_rms | wheel_flip_frac | leg_eff_rms |
|---|---|---|---|---|---|---|---|---|---|---|---|---|
| 0 policy | 10,0,0 | 0.018 | 0.057 | 0.020 | 0.400 | 0.100 | 0.005 | nan | 0.022 | 0.586 | 0.016 | 0.517 |
| 0 wbc | 10,0,0 | 0.019 | 0.069 | 0.020 | 0.399 | 0.109 | 0.085 | nan | 0.001 | 0.306 | 0.007 | 0.777 |

**shove/nominal** — policy completed, WBC completed

| phase | command | truth_pitch_rms | truth_speed_err_rms | pitch_rms | pitch_peak_hz | vel_err_rms | yaw_err_rms | yaw_rise_s | height_err | wheel_tau_rms | wheel_flip_frac | leg_eff_rms |
|---|---|---|---|---|---|---|---|---|---|---|---|---|
| 0 policy | 14,0,0 | 0.040 | 0.275 | 0.041 | 0.500 | 0.352 | 0.034 | nan | 0.019 | 0.823 | 0.016 | 0.544 |
| 0 wbc | 14,0,0 | 0.022 | 0.286 | 0.024 | 0.499 | 0.385 | 0.305 | nan | 0.001 | 0.429 | 0.003 | 0.788 |

**shove/spi_slow** — policy completed, WBC FELL

| phase | command | truth_pitch_rms | truth_speed_err_rms | pitch_rms | pitch_peak_hz | vel_err_rms | yaw_err_rms | yaw_rise_s | height_err | wheel_tau_rms | wheel_flip_frac | leg_eff_rms |
|---|---|---|---|---|---|---|---|---|---|---|---|---|
| 0 policy | 14,0,0 | 0.042 | 0.279 | 0.043 | 0.500 | 0.357 | 0.034 | nan | 0.019 | 0.948 | 0.020 | 0.548 |
| 0 wbc | 14,0,0 | 0.190 | 0.615 | 0.189 | 0.325 | 1.995 | 0.352 | nan | 0.010 | 1.346 | 0.011 | 0.767 |

**shove/worst** — policy completed, WBC FELL

| phase | command | truth_pitch_rms | truth_speed_err_rms | pitch_rms | pitch_peak_hz | vel_err_rms | yaw_err_rms | yaw_rise_s | height_err | wheel_tau_rms | wheel_flip_frac | leg_eff_rms |
|---|---|---|---|---|---|---|---|---|---|---|---|---|
| 0 policy | 14,0,0 | 0.049 | 0.302 | 0.050 | 0.500 | 0.377 | 0.035 | nan | 0.018 | 1.172 | 0.018 | 0.544 |
| 0 wbc | 14,0,0 | 0.256 | 0.648 | 0.254 | 0.315 | 1.669 | 0.601 | nan | 0.010 | 1.540 | 0.015 | 0.868 |

**shove/mit** — policy completed, WBC completed

| phase | command | truth_pitch_rms | truth_speed_err_rms | pitch_rms | pitch_peak_hz | vel_err_rms | yaw_err_rms | yaw_rise_s | height_err | wheel_tau_rms | wheel_flip_frac | leg_eff_rms |
|---|---|---|---|---|---|---|---|---|---|---|---|---|
| 0 policy | 14,0,0 | 0.041 | 0.275 | 0.041 | 0.500 | 0.352 | 0.035 | nan | 0.019 | 0.832 | 0.018 | 0.544 |
| 0 wbc | 14,0,0 | 0.022 | 0.286 | 0.024 | 0.499 | 0.384 | 0.304 | nan | 0.001 | 0.426 | 0.003 | 0.789 |
