A-Common-Guy/bipedale/sandro_rl/policies/stand_up/eval/lag_sweep.md

| scenario | wheel lag (s) | result | wheel effort RMS R/L (Nm) | peak (Hz) | 5-15 Hz share |
|---|---|---|---|---|---|
| hardware | 0.000 | completed | 0.26 / 0.22 | 0.0 / 0.0 | 0.07 |
| hardware | 0.035 | completed | 0.24 / 0.21 | 0.1 / 0.0 | 0.28 |
| hardware | 0.050 | completed | 0.26 / 0.22 | 0.1 / 0.0 | 0.24 |
| hardware | 0.080 | completed | 0.26 / 0.21 | 0.1 / 0.0 | 0.26 |
| default | 0.000 | completed | 0.26 / 0.24 | 0.1 / 0.0 | 0.05 |
| default | 0.035 | completed | 0.25 / 0.24 | 0.1 / 0.0 | 0.22 |
| default | 0.050 | completed | 0.25 / 0.23 | 0.1 / 0.0 | 0.18 |
| default | 0.080 | completed | 0.24 / 0.22 | 0.1 / 0.1 | 0.14 |
| push | 0.000 | completed | 0.24 / 0.24 | 0.4 / 0.4 | 0.08 |
| push | 0.035 | completed | 0.26 / 0.25 | 0.3 / 0.3 | 0.46 |
| push | 0.050 | completed | 0.23 / 0.23 | 0.3 / 0.3 | 0.42 |
| push | 0.080 | completed | 0.26 / 0.25 | 0.2 / 0.2 | 0.33 |
