A-Common-Guy/bipedale/sandro_rl/policies/stand_up/eval/lag_sweep_oldbody.md

| scenario | wheel lag (s) | result | wheel effort RMS R/L (Nm) | peak (Hz) | 5-15 Hz share |
|---|---|---|---|---|---|
| hardware | 0.000 | completed | 0.22 / 0.30 | 0.0 / 0.0 | 0.06 |
| hardware | 0.035 | completed | 0.21 / 0.27 | 0.0 / 0.0 | 0.09 |
| hardware | 0.050 | completed | 0.21 / 0.27 | 0.0 / 0.0 | 0.08 |
| hardware | 0.080 | completed | 0.22 / 0.27 | 0.0 / 0.0 | 0.04 |
| default | 0.000 | completed | 0.34 / 0.29 | 0.0 / 0.1 | 0.03 |
| default | 0.035 | completed | 0.33 / 0.28 | 0.0 / 0.1 | 0.05 |
| default | 0.050 | completed | 0.33 / 0.28 | 0.0 / 0.1 | 0.06 |
| default | 0.080 | completed | 0.32 / 0.27 | 0.0 / 0.1 | 0.02 |
| push | 0.000 | completed | 0.22 / 0.23 | 0.3 / 0.3 | 0.08 |
| push | 0.035 | completed | 0.20 / 0.20 | 0.3 / 0.1 | 0.15 |
| push | 0.050 | completed | 0.16 / 0.16 | 0.3 / 0.3 | 0.24 |
| push | 0.080 | completed | 0.17 / 0.17 | 0.3 / 0.3 | 0.16 |
