A-Common-Guy/bipedale/sandro_rl/policies/stand_up/eval/lag_sweep_before.md

| scenario | wheel lag (s) | result | wheel effort RMS R/L (Nm) | peak (Hz) | 5-15 Hz share |
|---|---|---|---|---|---|
| hardware | 0.000 | completed | 0.57 / 0.57 | 0.8 / 0.8 | 0.11 |
| hardware | 0.035 | completed | 0.67 / 0.66 | 1.8 / 0.0 | 0.30 |
| hardware | 0.050 | completed | 0.73 / 0.72 | 3.8 / 3.8 | 0.32 |
| hardware | 0.080 | completed | 0.77 / 0.75 | 3.8 / 3.8 | 0.23 |
| default | 0.000 | completed | 0.49 / 0.50 | 0.1 / 0.1 | 0.09 |
| default | 0.035 | completed | 0.65 / 0.63 | 0.0 / 0.1 | 0.36 |
| default | 0.050 | completed | 0.68 / 0.66 | 0.0 / 0.1 | 0.36 |
| default | 0.080 | completed | 0.71 / 0.69 | 0.1 / 0.1 | 0.27 |
| push | 0.000 | completed | 0.56 / 0.56 | 2.3 / 2.3 | 0.10 |
| push | 0.035 | completed | 0.72 / 0.70 | 3.6 / 3.6 | 0.34 |
| push | 0.050 | completed | 0.81 / 0.78 | 3.8 / 3.8 | 0.36 |
| push | 0.080 | completed | 0.79 / 0.76 | 3.9 / 3.9 | 0.21 |
