A-Common-Guy/bipedale/sandro_rl/policies/jump/eval/comparison.md

Policy runs with wheel_lag 0.04 s; the WBC without (sandro_sim has no lag).

**hardware/nominal** — policy completed, WBC completed

| phase | command | truth_pitch_rms | truth_speed_err_rms | pitch_rms | pitch_peak_hz | vel_err_rms | yaw_err_rms | yaw_rise_s | height_err | wheel_tau_rms | wheel_flip_frac | leg_eff_rms |
|---|---|---|---|---|---|---|---|---|---|---|---|---|
| 0 policy | 5,0,0 | 0.002 | 0.025 | 0.008 | 6.400 | 0.027 | 0.004 | nan | -0.004 | 0.506 | 0.000 | 0.826 |
| 0 wbc | 5,0,0 | 0.023 | 0.064 | 0.024 | 0.400 | 0.093 | 0.064 | nan | 0.002 | 0.242 | 0.010 | 0.771 |
| 1 policy | 4,0.2,0 | 0.012 | 0.075 | 0.015 | 0.500 | 0.092 | 0.005 | nan | -0.005 | 0.628 | 0.003 | 0.834 |
| 1 wbc | 4,0.2,0 | 0.006 | 0.038 | 0.009 | 23.750 | 0.051 | 0.101 | nan | 0.001 | 0.373 | 0.000 | 0.781 |
| 2 policy | 4,0,0 | 0.010 | 0.056 | 0.013 | 0.500 | 0.071 | 0.004 | nan | -0.004 | 0.519 | 0.002 | 0.828 |
| 2 wbc | 4,0,0 | 0.030 | 0.090 | 0.031 | 0.500 | 0.109 | 0.104 | nan | 0.001 | 0.295 | 0.006 | 0.795 |
| 3 policy | 4,0.2,0.6 | 0.009 | 0.144 | 0.012 | 0.750 | 0.106 | 0.065 | 0.260 | -0.005 | 0.480 | 0.018 | 1.027 |
| 3 wbc | 4,0.2,0.6 | 0.024 | 0.214 | 0.026 | 0.500 | 0.120 | 0.199 | 1.420 | 0.001 | 0.549 | 0.001 | 0.905 |
| 4 policy | 3,0,0 | 0.010 | 0.082 | 0.013 | 0.333 | 0.071 | 0.028 | 0.000 | -0.004 | 0.464 | 0.002 | 0.847 |
| 4 wbc | 3,0,0 | 0.033 | 0.126 | 0.034 | 0.333 | 0.107 | 0.142 | 0.000 | 0.001 | 0.346 | 0.004 | 0.828 |

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
| 6 wbc | 2,0,0 | 0.021 | 0.047 | 0.022 | 0.500 | 0.082 | 0.075 | nan | -0.007 | 0.274 | 0.015 | 0.699 |
| 7 policy | 3,0,0,-0.05 | 0.018 | 0.033 | 0.019 | 0.667 | 0.049 | 0.007 | nan | 0.007 | 0.443 | 0.014 | 0.959 |
| 7 wbc | 3,0,0,-0.05 | 0.022 | 0.047 | 0.025 | 0.333 | 0.070 | 0.044 | nan | 0.008 | 0.258 | 0.004 | 0.881 |
| 8 policy | 2,0,0 | 0.003 | 0.025 | 0.009 | 2.500 | 0.027 | 0.004 | nan | 0.014 | 0.346 | 0.020 | 1.154 |
| 8 wbc | 2,0,0 | 0.017 | 0.029 | 0.017 | 0.500 | 0.049 | 0.037 | nan | 0.009 | 0.183 | 0.015 | 0.946 |
| 9 policy | 3,0,0,0.05 | 0.015 | 0.024 | 0.017 | 0.333 | 0.033 | 0.008 | nan | -0.007 | 0.444 | 0.018 | 0.993 |
| 9 wbc | 3,0,0,0.05 | 0.023 | 0.056 | 0.025 | 0.333 | 0.086 | 0.070 | nan | -0.006 | 0.287 | 0.013 | 0.800 |
| 10 policy | 3,0,0 | 0.001 | 0.005 | 0.009 | 3.000 | 0.006 | 0.005 | nan | -0.013 | 0.300 | 0.033 | 0.702 |
| 10 wbc | 3,0,0 | 0.020 | 0.048 | 0.022 | 0.333 | 0.073 | 0.048 | nan | -0.007 | 0.254 | 0.014 | 0.710 |

**default/worst** — policy completed, WBC FELL

| phase | command | truth_pitch_rms | truth_speed_err_rms | pitch_rms | pitch_peak_hz | vel_err_rms | yaw_err_rms | yaw_rise_s | height_err | wheel_tau_rms | wheel_flip_frac | leg_eff_rms |
|---|---|---|---|---|---|---|---|---|---|---|---|---|
| 0 policy | 3,0,0 | 0.002 | 0.012 | 0.008 | 4.575 | 0.015 | 0.005 | nan | -0.004 | 0.344 | 0.011 | 0.823 |
| 0 wbc | 3,0,0 | nan | nan | nan | nan | nan | nan | nan | nan | nan | nan | nan |
| 1 policy | 4,0.3,0 | 0.029 | 0.113 | 0.030 | 2.538 | 0.179 | 0.009 | nan | -0.006 | 1.075 | 0.003 | 0.835 |
| 1 wbc | 4,0.3,0 | nan | nan | nan | nan | nan | nan | nan | nan | nan | nan | nan |
| 2 policy | 3,0,0 | 0.034 | 0.092 | 0.036 | 0.333 | 0.192 | 0.008 | nan | -0.004 | 1.552 | 0.011 | 0.830 |
| 2 wbc | 3,0,0 | nan | nan | nan | nan | nan | nan | nan | nan | nan | nan | nan |
| 3 policy | 4,0.3,1.0 | 0.033 | 0.293 | 0.033 | 1.000 | 0.218 | 0.205 | 0.200 | -0.006 | 1.226 | 0.020 | 1.038 |
| 3 wbc | 4,0.3,1.0 | nan | nan | nan | nan | nan | nan | nan | nan | nan | nan | nan |
| 4 policy | 3,0,0 | 0.030 | 0.139 | 0.030 | 0.333 | 0.169 | 0.073 | 0.000 | -0.004 | 1.122 | 0.027 | 0.848 |
| 4 wbc | 3,0,0 | nan | nan | nan | nan | nan | nan | nan | nan | nan | nan | nan |
| 5 policy | 3,0,0,1.2 | 0.002 | 0.005 | 0.008 | 4.333 | 0.007 | 0.006 | nan | -0.013 | 0.289 | 0.029 | 0.723 |
| 5 wbc | 3,0,0,1.2 | nan | nan | nan | nan | nan | nan | nan | nan | nan | nan | nan |
| 6 policy | 2,0,0 | 0.001 | 0.005 | 0.008 | 4.000 | 0.006 | 0.006 | nan | -0.013 | 0.277 | 0.035 | 0.706 |
| 6 wbc | 2,0,0 | nan | nan | nan | nan | nan | nan | nan | nan | nan | nan | nan |
| 7 policy | 3,0,0,-0.05 | 0.018 | 0.027 | 0.019 | 0.667 | 0.043 | 0.008 | nan | 0.007 | 0.435 | 0.013 | 0.970 |
| 7 wbc | 3,0,0,-0.05 | nan | nan | nan | nan | nan | nan | nan | nan | nan | nan | nan |
| 8 policy | 2,0,0 | 0.008 | 0.022 | 0.011 | 1.000 | 0.031 | 0.005 | nan | 0.015 | 0.421 | 0.014 | 1.150 |
| 8 wbc | 2,0,0 | nan | nan | nan | nan | nan | nan | nan | nan | nan | nan | nan |
| 9 policy | 3,0,0,0.05 | 0.017 | 0.025 | 0.018 | 0.667 | 0.039 | 0.008 | nan | -0.007 | 0.463 | 0.021 | 0.983 |
| 9 wbc | 3,0,0,0.05 | nan | nan | nan | nan | nan | nan | nan | nan | nan | nan | nan |
| 10 policy | 3,0,0 | 0.001 | 0.006 | 0.009 | 2.667 | 0.007 | 0.005 | nan | -0.013 | 0.305 | 0.029 | 0.701 |
| 10 wbc | 3,0,0 | nan | nan | nan | nan | nan | nan | nan | nan | nan | nan | nan |

**push/nominal** — policy completed, WBC completed

| phase | command | truth_pitch_rms | truth_speed_err_rms | pitch_rms | pitch_peak_hz | vel_err_rms | yaw_err_rms | yaw_rise_s | height_err | wheel_tau_rms | wheel_flip_frac | leg_eff_rms |
|---|---|---|---|---|---|---|---|---|---|---|---|---|
| 0 policy | 10,0,0 | 0.012 | 0.060 | 0.015 | 0.600 | 0.082 | 0.005 | nan | -0.004 | 0.552 | 0.003 | 0.825 |
| 0 wbc | 10,0,0 | 0.023 | 0.067 | 0.024 | 0.300 | 0.105 | 0.074 | nan | 0.001 | 0.250 | 0.015 | 0.778 |

**push/uart_imu** — policy completed, WBC completed

| phase | command | truth_pitch_rms | truth_speed_err_rms | pitch_rms | pitch_peak_hz | vel_err_rms | yaw_err_rms | yaw_rise_s | height_err | wheel_tau_rms | wheel_flip_frac | leg_eff_rms |
|---|---|---|---|---|---|---|---|---|---|---|---|---|
| 0 policy | 10,0,0 | 0.013 | 0.056 | 0.015 | 0.600 | 0.088 | 0.005 | nan | -0.004 | 0.560 | 0.006 | 0.824 |
| 0 wbc | 10,0,0 | 0.023 | 0.071 | 0.025 | 0.400 | 0.118 | 0.083 | nan | 0.001 | 0.303 | 0.010 | 0.776 |

**push/worst** — policy completed, WBC FELL

| phase | command | truth_pitch_rms | truth_speed_err_rms | pitch_rms | pitch_peak_hz | vel_err_rms | yaw_err_rms | yaw_rise_s | height_err | wheel_tau_rms | wheel_flip_frac | leg_eff_rms |
|---|---|---|---|---|---|---|---|---|---|---|---|---|
| 0 policy | 10,0,0 | 0.020 | 0.059 | 0.021 | 0.600 | 0.118 | 0.006 | nan | -0.004 | 0.774 | 0.013 | 0.824 |
| 0 wbc | 10,0,0 | nan | nan | nan | nan | nan | nan | nan | nan | nan | nan | nan |
