A-Common-Guy/bipedale/sandro_rl/policies/jump/eval/lag_sweep.md

| scenario | wheel lag (s) | result | wheel effort RMS R/L (Nm) | peak (Hz) | 5-15 Hz share |
|---|---|---|---|---|---|
| hardware | 0.000 | completed | 0.35 / 0.27 | 0.1 / 0.0 | 0.02 |
| hardware | 0.035 | completed | 0.35 / 0.22 | 0.1 / 0.0 | 0.02 |
| hardware | 0.050 | completed | 0.35 / 0.21 | 0.1 / 0.0 | 0.01 |
| hardware | 0.080 | completed | 0.34 / 0.21 | 0.1 / 0.0 | 0.01 |
| default | 0.000 | completed | 0.31 / 0.25 | 0.0 / 0.1 | 0.03 |
| default | 0.035 | completed | 0.29 / 0.20 | 0.1 / 0.1 | 0.04 |
| default | 0.050 | completed | 0.29 / 0.20 | 0.1 / 0.1 | 0.03 |
| default | 0.080 | completed | 0.30 / 0.20 | 0.1 / 0.1 | 0.01 |
| push | 0.000 | completed | 0.19 / 0.22 | 0.4 / 0.4 | 0.05 |
| push | 0.035 | completed | 0.14 / 0.14 | 0.4 / 0.4 | 0.06 |
| push | 0.050 | completed | 0.14 / 0.14 | 0.4 / 0.4 | 0.04 |
| push | 0.080 | completed | 0.14 / 0.14 | 0.4 / 0.4 | 0.03 |
