A-Common-Guy/bipedale/sandro_rl/policies/jump/eval/lag_sweep_before.md

| scenario | wheel lag (s) | result | wheel effort RMS R/L (Nm) | peak (Hz) | 5-15 Hz share |
|---|---|---|---|---|---|
| hardware | 0.000 | completed | 0.30 / 0.27 | 0.1 / 0.0 | 0.04 |
| hardware | 0.035 | completed | 0.30 / 0.24 | 0.1 / 0.0 | 0.04 |
| hardware | 0.050 | completed | 0.30 / 0.24 | 0.1 / 0.0 | 0.02 |
| hardware | 0.080 | completed | 0.30 / 0.24 | 0.1 / 0.0 | 0.01 |
| default | 0.000 | completed | 0.28 / 0.24 | 0.0 / 0.1 | 0.05 |
| default | 0.035 | completed | 0.27 / 0.22 | 0.0 / 0.1 | 0.05 |
| default | 0.050 | completed | 0.28 / 0.21 | 0.0 / 0.1 | 0.03 |
| default | 0.080 | completed | 0.30 / 0.23 | 0.0 / 0.1 | 0.09 |
| push | 0.000 | completed | 0.13 / 0.18 | 0.4 / 0.4 | 0.10 |
| push | 0.035 | completed | 0.11 / 0.15 | 0.4 / 0.4 | 0.18 |
| push | 0.050 | completed | 0.12 / 0.15 | 0.2 / 0.4 | 0.30 |
| push | 0.080 | completed | 0.14 / 0.15 | 0.2 / 0.2 | 0.45 |
