A-Common-Guy/bipedale/sandro_rl/policies/agile_terrain/eval/comparison.md

Policy runs with wheel_lag 0.04 s; the WBC without (sandro_sim has no lag).

**hardware/nominal** — policy completed, WBC completed

| phase | command | truth_pitch_rms | truth_speed_err_rms | pitch_rms | pitch_peak_hz | vel_err_rms | yaw_err_rms | yaw_rise_s | height_err | wheel_tau_rms | wheel_flip_frac | leg_eff_rms |
|---|---|---|---|---|---|---|---|---|---|---|---|---|
| 0 policy | 5,0,0 | 0.000 | 0.004 | 0.008 | 6.400 | 0.005 | 0.002 | nan | -0.008 | 0.151 | 0.016 | 0.856 |
| 0 wbc | 5,0,0 | 0.023 | 0.064 | 0.024 | 0.400 | 0.093 | 0.064 | nan | 0.002 | 0.242 | 0.010 | 0.771 |
| 1 policy | 4,0.2,0 | 0.005 | 0.048 | 0.011 | 2.250 | 0.069 | 0.006 | nan | -0.007 | 0.573 | 0.002 | 0.849 |
| 1 wbc | 4,0.2,0 | 0.006 | 0.038 | 0.009 | 23.750 | 0.051 | 0.101 | nan | 0.001 | 0.373 | 0.000 | 0.781 |
| 2 policy | 4,0,0 | 0.006 | 0.045 | 0.010 | 1.500 | 0.069 | 0.002 | nan | -0.008 | 0.349 | 0.003 | 0.857 |
| 2 wbc | 4,0,0 | 0.030 | 0.090 | 0.031 | 0.500 | 0.109 | 0.104 | nan | 0.001 | 0.295 | 0.006 | 0.795 |
| 3 policy | 4,0.2,0.6 | 0.003 | 0.227 | 0.009 | 7.750 | 0.066 | 0.082 | 0.180 | -0.007 | 0.520 | 0.001 | 1.005 |
| 3 wbc | 4,0.2,0.6 | 0.024 | 0.214 | 0.026 | 0.500 | 0.120 | 0.199 | 1.420 | 0.001 | 0.549 | 0.001 | 0.905 |
| 4 policy | 3,0,0 | 0.008 | 0.094 | 0.011 | 0.333 | 0.087 | 0.037 | 0.000 | -0.008 | 0.351 | 0.002 | 0.872 |
| 4 wbc | 3,0,0 | 0.033 | 0.126 | 0.034 | 0.333 | 0.107 | 0.142 | 0.000 | 0.001 | 0.346 | 0.004 | 0.828 |

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
| 6 wbc | 2,0,0 | 0.021 | 0.047 | 0.022 | 0.500 | 0.082 | 0.075 | nan | -0.007 | 0.274 | 0.015 | 0.699 |
| 7 policy | 3,0,0,-0.05 | 0.041 | 0.025 | 0.042 | 0.333 | 0.036 | 0.007 | nan | 0.012 | 0.433 | 0.004 | 0.970 |
| 7 wbc | 3,0,0,-0.05 | 0.022 | 0.047 | 0.025 | 0.333 | 0.070 | 0.044 | nan | 0.008 | 0.258 | 0.004 | 0.881 |
| 8 policy | 2,0,0 | 0.015 | 0.034 | 0.017 | 0.500 | 0.042 | 0.008 | nan | 0.032 | 0.426 | 0.005 | 1.092 |
| 8 wbc | 2,0,0 | 0.017 | 0.029 | 0.017 | 0.500 | 0.049 | 0.037 | nan | 0.009 | 0.183 | 0.015 | 0.946 |
| 9 policy | 3,0,0,0.05 | 0.044 | 0.025 | 0.046 | 0.333 | 0.032 | 0.004 | nan | -0.005 | 0.395 | 0.006 | 0.966 |
| 9 wbc | 3,0,0,0.05 | 0.023 | 0.056 | 0.025 | 0.333 | 0.086 | 0.070 | nan | -0.006 | 0.287 | 0.013 | 0.800 |
| 10 policy | 3,0,0 | 0.002 | 0.020 | 0.009 | 3.000 | 0.022 | 0.002 | nan | -0.011 | 0.349 | 0.000 | 0.694 |
| 10 wbc | 3,0,0 | 0.020 | 0.048 | 0.022 | 0.333 | 0.073 | 0.048 | nan | -0.007 | 0.254 | 0.014 | 0.710 |

**default/worst** — policy completed, WBC FELL

| phase | command | truth_pitch_rms | truth_speed_err_rms | pitch_rms | pitch_peak_hz | vel_err_rms | yaw_err_rms | yaw_rise_s | height_err | wheel_tau_rms | wheel_flip_frac | leg_eff_rms |
|---|---|---|---|---|---|---|---|---|---|---|---|---|
| 0 policy | 3,0,0 | 0.000 | 0.005 | 0.008 | 4.575 | 0.008 | 0.002 | nan | -0.008 | 0.199 | 0.019 | 0.858 |
| 0 wbc | 3,0,0 | nan | nan | nan | nan | nan | nan | nan | nan | nan | nan | nan |
| 1 policy | 4,0.3,0 | 0.016 | 0.071 | 0.018 | 0.761 | 0.127 | 0.010 | nan | -0.006 | 0.851 | 0.001 | 0.842 |
| 1 wbc | 4,0.3,0 | nan | nan | nan | nan | nan | nan | nan | nan | nan | nan | nan |
| 2 policy | 3,0,0 | 0.040 | 0.087 | 0.041 | 0.333 | 0.194 | 0.008 | nan | -0.008 | 1.161 | 0.008 | 0.868 |
| 2 wbc | 3,0,0 | nan | nan | nan | nan | nan | nan | nan | nan | nan | nan | nan |
| 3 policy | 4,0.3,1.0 | 0.013 | 0.364 | 0.015 | 5.000 | 0.119 | 0.200 | 0.160 | -0.006 | 0.681 | 0.009 | 1.001 |
| 3 wbc | 4,0.3,1.0 | nan | nan | nan | nan | nan | nan | nan | nan | nan | nan | nan |
| 4 policy | 3,0,0 | 0.029 | 0.149 | 0.030 | 0.333 | 0.157 | 0.121 | 0.000 | -0.008 | 1.119 | 0.013 | 0.877 |
| 4 wbc | 3,0,0 | nan | nan | nan | nan | nan | nan | nan | nan | nan | nan | nan |
| 5 policy | 3,0,0,1.2 | 0.006 | 0.019 | 0.010 | 0.333 | 0.025 | 0.003 | nan | -0.012 | 0.333 | 0.007 | 0.717 |
| 5 wbc | 3,0,0,1.2 | nan | nan | nan | nan | nan | nan | nan | nan | nan | nan | nan |
| 6 policy | 2,0,0 | 0.002 | 0.012 | 0.008 | 13.500 | 0.012 | 0.002 | nan | -0.011 | 0.230 | 0.007 | 0.693 |
| 6 wbc | 2,0,0 | nan | nan | nan | nan | nan | nan | nan | nan | nan | nan | nan |
| 7 policy | 3,0,0,-0.05 | 0.045 | 0.029 | 0.046 | 0.333 | 0.075 | 0.008 | nan | 0.012 | 0.775 | 0.009 | 0.980 |
| 7 wbc | 3,0,0,-0.05 | nan | nan | nan | nan | nan | nan | nan | nan | nan | nan | nan |
| 8 policy | 2,0,0 | 0.019 | 0.032 | 0.021 | 1.000 | 0.053 | 0.008 | nan | 0.032 | 0.629 | 0.010 | 1.092 |
| 8 wbc | 2,0,0 | nan | nan | nan | nan | nan | nan | nan | nan | nan | nan | nan |
| 9 policy | 3,0,0,0.05 | 0.040 | 0.019 | 0.043 | 0.333 | 0.039 | 0.004 | nan | -0.005 | 0.471 | 0.007 | 0.962 |
| 9 wbc | 3,0,0,0.05 | nan | nan | nan | nan | nan | nan | nan | nan | nan | nan | nan |
| 10 policy | 3,0,0 | 0.005 | 0.016 | 0.010 | 0.333 | 0.020 | 0.002 | nan | -0.011 | 0.291 | 0.007 | 0.695 |
| 10 wbc | 3,0,0 | nan | nan | nan | nan | nan | nan | nan | nan | nan | nan | nan |

**push/nominal** — policy completed, WBC completed

| phase | command | truth_pitch_rms | truth_speed_err_rms | pitch_rms | pitch_peak_hz | vel_err_rms | yaw_err_rms | yaw_rise_s | height_err | wheel_tau_rms | wheel_flip_frac | leg_eff_rms |
|---|---|---|---|---|---|---|---|---|---|---|---|---|
| 0 policy | 10,0,0 | 0.012 | 0.047 | 0.015 | 0.400 | 0.078 | 0.002 | nan | -0.008 | 0.394 | 0.010 | 0.856 |
| 0 wbc | 10,0,0 | 0.023 | 0.067 | 0.024 | 0.300 | 0.105 | 0.074 | nan | 0.001 | 0.250 | 0.015 | 0.778 |

**push/uart_imu** — policy completed, WBC completed

| phase | command | truth_pitch_rms | truth_speed_err_rms | pitch_rms | pitch_peak_hz | vel_err_rms | yaw_err_rms | yaw_rise_s | height_err | wheel_tau_rms | wheel_flip_frac | leg_eff_rms |
|---|---|---|---|---|---|---|---|---|---|---|---|---|
| 0 policy | 10,0,0 | 0.013 | 0.045 | 0.015 | 0.400 | 0.090 | 0.004 | nan | -0.008 | 0.544 | 0.012 | 0.856 |
| 0 wbc | 10,0,0 | 0.023 | 0.071 | 0.025 | 0.400 | 0.118 | 0.083 | nan | 0.001 | 0.303 | 0.010 | 0.776 |

**push/worst** — policy completed, WBC FELL

| phase | command | truth_pitch_rms | truth_speed_err_rms | pitch_rms | pitch_peak_hz | vel_err_rms | yaw_err_rms | yaw_rise_s | height_err | wheel_tau_rms | wheel_flip_frac | leg_eff_rms |
|---|---|---|---|---|---|---|---|---|---|---|---|---|
| 0 policy | 10,0,0 | 0.026 | 0.047 | 0.026 | 1.600 | 0.140 | 0.005 | nan | -0.008 | 0.893 | 0.013 | 0.856 |
| 0 wbc | 10,0,0 | nan | nan | nan | nan | nan | nan | nan | nan | nan | nan | nan |
