A-Common-Guy/bipedale/sandro_rl/policies/agile_terrain/eval/lag_sweep.md

| scenario | wheel lag (s) | result | wheel effort RMS R/L (Nm) | peak (Hz) | 5-15 Hz share |
|---|---|---|---|---|---|
| hardware | 0.000 | completed | 0.33 / 0.19 | 0.1 / 0.0 | 0.01 |
| hardware | 0.035 | completed | 0.33 / 0.18 | 0.1 / 0.0 | 0.02 |
| hardware | 0.050 | completed | 0.33 / 0.18 | 0.1 / 0.0 | 0.02 |
| hardware | 0.080 | completed | 0.33 / 0.18 | 0.1 / 0.0 | 0.02 |
| default | 0.000 | completed | 0.33 / 0.21 | 0.1 / 0.1 | 0.01 |
| default | 0.035 | completed | 0.32 / 0.20 | 0.1 / 0.1 | 0.02 |
| default | 0.050 | completed | 0.32 / 0.20 | 0.1 / 0.1 | 0.02 |
| default | 0.080 | completed | 0.32 / 0.20 | 0.1 / 0.0 | 0.01 |
| push | 0.000 | completed | 0.14 / 0.14 | 0.4 / 0.1 | 0.02 |
| push | 0.035 | completed | 0.13 / 0.13 | 0.1 / 0.1 | 0.03 |
| push | 0.050 | completed | 0.13 / 0.13 | 0.1 / 0.1 | 0.08 |
| push | 0.080 | completed | 0.14 / 0.14 | 0.1 / 0.1 | 0.21 |
