A-Common-Guy/bipedale/sandro_rl/policies/agile_terrain/eval/lag_sweep_before.md

| scenario | wheel lag (s) | result | wheel effort RMS R/L (Nm) | peak (Hz) | 5-15 Hz share |
|---|---|---|---|---|---|
| hardware | 0.000 | completed | 0.28 / 0.22 | 0.1 / 0.0 | 0.03 |
| hardware | 0.035 | completed | 1.17 / 1.10 | 7.7 / 7.7 | 0.95 |
| hardware | 0.050 | completed | 1.49 / 1.38 | 7.1 / 7.1 | 0.97 |
| hardware | 0.080 | completed | 1.61 / 1.49 | 5.4 / 5.4 | 0.87 |
| default | 0.000 | completed | 0.28 / 0.22 | 0.0 / 0.1 | 0.02 |
| default | 0.035 | completed | 1.09 / 1.04 | 8.5 / 8.5 | 0.96 |
| default | 0.050 | completed | 1.38 / 1.33 | 7.1 / 7.1 | 0.95 |
| default | 0.080 | completed | 1.49 / 1.39 | 5.5 / 5.5 | 0.89 |
| push | 0.000 | completed | 0.15 / 0.14 | 0.3 / 0.3 | 0.07 |
| push | 0.035 | completed | 1.25 / 1.23 | 7.8 / 7.8 | 0.96 |
| push | 0.050 | completed | 1.59 / 1.50 | 7.1 / 7.1 | 0.97 |
| push | 0.080 | completed | 1.52 / 1.45 | 5.1 / 5.1 | 0.82 |
