A-Common-Guy/bipedale/sandro_rl/policies/flat_tracking/eval/comparison.md

Policy runs with wheel_lag 0.04 s; the WBC without (sandro_sim has no lag).

**hardware/nominal** — policy completed, WBC completed

| phase | command | truth_pitch_rms | truth_speed_err_rms | pitch_rms | pitch_peak_hz | vel_err_rms | yaw_err_rms | yaw_rise_s | height_err | wheel_tau_rms | wheel_flip_frac | leg_eff_rms |
|---|---|---|---|---|---|---|---|---|---|---|---|---|
| 0 policy | 5,0,0 | 0.002 | 0.003 | 0.008 | 6.400 | 0.004 | 0.003 | nan | 0.000 | 0.118 | 0.000 | 0.786 |
| 0 wbc | 5,0,0 | 0.023 | 0.064 | 0.024 | 0.400 | 0.093 | 0.064 | nan | 0.002 | 0.242 | 0.010 | 0.771 |
| 1 policy | 4,0.2,0 | 0.033 | 0.049 | 0.035 | 0.750 | 0.057 | 0.004 | nan | -0.000 | 0.514 | 0.001 | 0.779 |
| 1 wbc | 4,0.2,0 | 0.006 | 0.038 | 0.009 | 23.750 | 0.051 | 0.101 | nan | 0.001 | 0.373 | 0.000 | 0.781 |
| 2 policy | 4,0,0 | 0.048 | 0.044 | 0.049 | 0.500 | 0.060 | 0.003 | nan | 0.000 | 0.292 | 0.002 | 0.777 |
| 2 wbc | 4,0,0 | 0.030 | 0.090 | 0.031 | 0.500 | 0.109 | 0.104 | nan | 0.001 | 0.295 | 0.006 | 0.795 |
| 3 policy | 4,0.2,0.6 | 0.022 | 0.157 | 0.023 | 0.500 | 0.072 | 0.041 | 0.140 | 0.000 | 0.625 | 0.002 | 0.948 |
| 3 wbc | 4,0.2,0.6 | 0.024 | 0.214 | 0.026 | 0.500 | 0.120 | 0.199 | 1.420 | 0.001 | 0.549 | 0.001 | 0.905 |
| 4 policy | 3,0,0 | 0.059 | 0.090 | 0.060 | 0.333 | 0.076 | 0.036 | 0.000 | 0.000 | 0.385 | 0.002 | 0.795 |
| 4 wbc | 3,0,0 | 0.033 | 0.126 | 0.034 | 0.333 | 0.107 | 0.142 | 0.000 | 0.001 | 0.346 | 0.004 | 0.828 |

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
| 6 wbc | 2,0,0 | 0.021 | 0.047 | 0.022 | 0.500 | 0.082 | 0.075 | nan | -0.007 | 0.274 | 0.015 | 0.699 |
| 7 policy | 3,0,0,-0.05 | 0.021 | 0.005 | 0.023 | 0.333 | 0.009 | 0.002 | nan | 0.002 | 0.124 | 0.022 | 0.922 |
| 7 wbc | 3,0,0,-0.05 | 0.022 | 0.047 | 0.025 | 0.333 | 0.070 | 0.044 | nan | 0.008 | 0.258 | 0.004 | 0.881 |
| 8 policy | 2,0,0 | 0.000 | 0.001 | 0.008 | 2.500 | 0.002 | 0.002 | nan | 0.001 | 0.081 | 0.030 | 1.002 |
| 8 wbc | 2,0,0 | 0.017 | 0.029 | 0.017 | 0.500 | 0.049 | 0.037 | nan | 0.009 | 0.183 | 0.015 | 0.946 |
| 9 policy | 3,0,0,0.05 | 0.054 | 0.005 | 0.056 | 0.333 | 0.022 | 0.004 | nan | -0.001 | 0.222 | 0.006 | 0.721 |
| 9 wbc | 3,0,0,0.05 | 0.023 | 0.056 | 0.025 | 0.333 | 0.086 | 0.070 | nan | -0.006 | 0.287 | 0.013 | 0.800 |
| 10 policy | 3,0,0 | 0.000 | 0.002 | 0.009 | 2.000 | 0.002 | 0.002 | nan | -0.001 | 0.078 | 0.024 | 0.615 |
| 10 wbc | 3,0,0 | 0.020 | 0.048 | 0.022 | 0.333 | 0.073 | 0.048 | nan | -0.007 | 0.254 | 0.014 | 0.710 |

**default/worst** — policy completed, WBC FELL

| phase | command | truth_pitch_rms | truth_speed_err_rms | pitch_rms | pitch_peak_hz | vel_err_rms | yaw_err_rms | yaw_rise_s | height_err | wheel_tau_rms | wheel_flip_frac | leg_eff_rms |
|---|---|---|---|---|---|---|---|---|---|---|---|---|
| 0 policy | 3,0,0 | 0.078 | 0.026 | 0.077 | 0.654 | 0.096 | 0.005 | nan | 0.000 | 0.699 | 0.009 | 0.770 |
| 0 wbc | 3,0,0 | nan | nan | nan | nan | nan | nan | nan | nan | nan | nan | nan |
| 1 policy | 4,0.3,0 | 0.042 | 0.076 | 0.043 | 1.015 | 0.152 | 0.012 | nan | -0.000 | 1.540 | 0.002 | 0.785 |
| 1 wbc | 4,0.3,0 | nan | nan | nan | nan | nan | nan | nan | nan | nan | nan | nan |
| 2 policy | 3,0,0 | 0.074 | 0.090 | 0.077 | 1.000 | 0.169 | 0.008 | nan | 0.000 | 1.238 | 0.006 | 0.774 |
| 2 wbc | 3,0,0 | nan | nan | nan | nan | nan | nan | nan | nan | nan | nan | nan |
| 3 policy | 4,0.3,1.0 | 0.057 | 0.280 | 0.059 | 0.500 | 0.073 | 0.127 | 0.140 | 0.001 | 0.863 | 0.010 | 0.964 |
| 3 wbc | 4,0.3,1.0 | nan | nan | nan | nan | nan | nan | nan | nan | nan | nan | nan |
| 4 policy | 3,0,0 | 0.078 | 0.147 | 0.079 | 0.667 | 0.166 | 0.113 | 0.000 | 0.000 | 1.040 | 0.011 | 0.795 |
| 4 wbc | 3,0,0 | nan | nan | nan | nan | nan | nan | nan | nan | nan | nan | nan |
| 5 policy | 3,0,0,1.2 | 0.072 | 0.026 | 0.072 | 1.000 | 0.119 | 0.008 | nan | -0.001 | 0.729 | 0.006 | 0.627 |
| 5 wbc | 3,0,0,1.2 | nan | nan | nan | nan | nan | nan | nan | nan | nan | nan | nan |
| 6 policy | 2,0,0 | 0.075 | 0.024 | 0.076 | 1.000 | 0.128 | 0.009 | nan | -0.001 | 0.850 | 0.005 | 0.602 |
| 6 wbc | 2,0,0 | nan | nan | nan | nan | nan | nan | nan | nan | nan | nan | nan |
| 7 policy | 3,0,0,-0.05 | 0.062 | 0.019 | 0.063 | 1.000 | 0.089 | 0.005 | nan | 0.002 | 0.646 | 0.006 | 0.937 |
| 7 wbc | 3,0,0,-0.05 | nan | nan | nan | nan | nan | nan | nan | nan | nan | nan | nan |
| 8 policy | 2,0,0 | 0.027 | 0.012 | 0.029 | 0.500 | 0.023 | 0.004 | nan | 0.002 | 0.327 | 0.002 | 0.997 |
| 8 wbc | 2,0,0 | nan | nan | nan | nan | nan | nan | nan | nan | nan | nan | nan |
| 9 policy | 3,0,0,0.05 | 0.076 | 0.023 | 0.076 | 0.667 | 0.102 | 0.008 | nan | -0.001 | 0.694 | 0.007 | 0.718 |
| 9 wbc | 3,0,0,0.05 | nan | nan | nan | nan | nan | nan | nan | nan | nan | nan | nan |
| 10 policy | 3,0,0 | 0.069 | 0.020 | 0.069 | 0.667 | 0.097 | 0.007 | nan | -0.001 | 0.767 | 0.006 | 0.604 |
| 10 wbc | 3,0,0 | nan | nan | nan | nan | nan | nan | nan | nan | nan | nan | nan |

**push/nominal** — policy completed, WBC completed

| phase | command | truth_pitch_rms | truth_speed_err_rms | pitch_rms | pitch_peak_hz | vel_err_rms | yaw_err_rms | yaw_rise_s | height_err | wheel_tau_rms | wheel_flip_frac | leg_eff_rms |
|---|---|---|---|---|---|---|---|---|---|---|---|---|
| 0 policy | 10,0,0 | 0.041 | 0.041 | 0.042 | 0.400 | 0.083 | 0.005 | nan | 0.000 | 0.605 | 0.002 | 0.780 |
| 0 wbc | 10,0,0 | 0.023 | 0.067 | 0.024 | 0.300 | 0.105 | 0.074 | nan | 0.001 | 0.250 | 0.015 | 0.778 |

**push/uart_imu** — policy completed, WBC completed

| phase | command | truth_pitch_rms | truth_speed_err_rms | pitch_rms | pitch_peak_hz | vel_err_rms | yaw_err_rms | yaw_rise_s | height_err | wheel_tau_rms | wheel_flip_frac | leg_eff_rms |
|---|---|---|---|---|---|---|---|---|---|---|---|---|
| 0 policy | 10,0,0 | 0.058 | 0.044 | 0.060 | 0.400 | 0.093 | 0.005 | nan | 0.000 | 0.565 | 0.003 | 0.777 |
| 0 wbc | 10,0,0 | 0.023 | 0.071 | 0.025 | 0.400 | 0.118 | 0.083 | nan | 0.001 | 0.303 | 0.010 | 0.776 |

**push/worst** — policy completed, WBC FELL

| phase | command | truth_pitch_rms | truth_speed_err_rms | pitch_rms | pitch_peak_hz | vel_err_rms | yaw_err_rms | yaw_rise_s | height_err | wheel_tau_rms | wheel_flip_frac | leg_eff_rms |
|---|---|---|---|---|---|---|---|---|---|---|---|---|
| 0 policy | 10,0,0 | 0.079 | 0.051 | 0.079 | 0.800 | 0.162 | 0.007 | nan | 0.000 | 1.020 | 0.008 | 0.766 |
| 0 wbc | 10,0,0 | nan | nan | nan | nan | nan | nan | nan | nan | nan | nan | nan |
