A-Common-Guy/bipedale/sandro_rl/policies/flat_tracking/eval/lag_sweep.md

| scenario | wheel lag (s) | result | wheel effort RMS R/L (Nm) | peak (Hz) | 5-15 Hz share |
|---|---|---|---|---|---|
| hardware | 0.000 | completed | 1.01 / 0.34 | 50.0 / 0.0 | 0.02 |
| hardware | 0.035 | completed | 0.32 / 0.18 | 0.1 / 0.0 | 0.02 |
| hardware | 0.050 | completed | 0.32 / 0.19 | 0.1 / 0.0 | 0.02 |
| hardware | 0.080 | completed | 0.32 / 0.18 | 0.1 / 0.0 | 0.02 |
| default | 0.000 | completed | 0.74 / 0.26 | 50.0 / 0.1 | 0.03 |
| default | 0.035 | completed | 0.28 / 0.18 | 0.1 / 0.1 | 0.02 |
| default | 0.050 | completed | 0.28 / 0.18 | 0.1 / 0.1 | 0.02 |
| default | 0.080 | completed | 0.29 / 0.18 | 0.1 / 0.1 | 0.02 |
| push | 0.000 | completed | 0.14 / 0.12 | 0.1 / 0.1 | 0.03 |
| push | 0.035 | completed | 0.13 / 0.13 | 0.1 / 0.1 | 0.23 |
| push | 0.050 | completed | 0.16 / 0.16 | 0.1 / 0.1 | 0.51 |
| push | 0.080 | completed | 0.16 / 0.18 | 0.1 / 0.1 | 0.48 |
