A-Common-Guy/bipedale/sandro_rl/policies/flat_level/eval/lag_sweep.md

| scenario | wheel lag (s) | result | wheel effort RMS R/L (Nm) | peak (Hz) | 5-15 Hz share |
|---|---|---|---|---|---|
| hardware | 0.000 | completed | 0.29 / 0.21 | 0.1 / 0.0 | 0.05 |
| hardware | 0.035 | FELL | 1.37 / 1.37 | 9.9 / 9.9 | 0.92 |
| hardware | 0.050 | completed | 1.33 / 1.34 | 7.3 / 7.3 | 0.91 |
| hardware | 0.080 | FELL | 0.12 / 0.13 | 2.3 / 2.3 | 0.35 |
| default | 0.000 | completed | 0.29 / 0.21 | 0.1 / 0.1 | 0.01 |
| default | 0.035 | completed | 1.17 / 1.15 | 7.7 / 7.7 | 0.87 |
| default | 0.050 | completed | 1.29 / 1.29 | 7.2 / 7.2 | 0.86 |
| default | 0.080 | FELL | 0.12 / 0.13 | 2.3 / 2.3 | 0.35 |
| push | 0.000 | completed | 0.17 / 0.17 | 0.2 / 0.2 | 0.11 |
| push | 0.035 | completed | 1.42 / 1.44 | 9.9 / 8.1 | 0.91 |
| push | 0.050 | completed | 1.27 / 1.32 | 7.1 / 7.1 | 0.88 |
| push | 0.080 | FELL | 0.12 / 0.13 | 2.3 / 2.3 | 0.35 |
