A-Common-Guy/bipedale/sandro_rl/policies/flat_level/eval/comparison.md

**hardware/nominal** — policy completed, WBC completed

| phase | command | truth_pitch_rms | truth_speed_err_rms | pitch_rms | pitch_peak_hz | vel_err_rms | yaw_err_rms | yaw_rise_s | height_err | wheel_tau_rms | wheel_flip_frac | leg_eff_rms |
|---|---|---|---|---|---|---|---|---|---|---|---|---|
| 0 policy | 5,0,0 | 0.028 | 0.010 | 0.029 | 0.400 | 0.020 | 0.006 | nan | -0.000 | 0.328 | 0.002 | 0.792 |
| 0 wbc | 5,0,0 | 0.023 | 0.064 | 0.024 | 0.400 | 0.093 | 0.064 | nan | 0.002 | 0.242 | 0.010 | 0.771 |
| 1 policy | 4,0.2,0 | 0.029 | 0.050 | 0.031 | 0.500 | 0.070 | 0.004 | nan | -0.000 | 0.494 | 0.002 | 0.790 |
| 1 wbc | 4,0.2,0 | 0.006 | 0.038 | 0.009 | 23.750 | 0.051 | 0.101 | nan | 0.001 | 0.373 | 0.000 | 0.781 |
| 2 policy | 4,0,0 | 0.015 | 0.034 | 0.017 | 1.500 | 0.053 | 0.007 | nan | -0.000 | 0.305 | 0.013 | 0.800 |
| 2 wbc | 4,0,0 | 0.030 | 0.090 | 0.031 | 0.500 | 0.109 | 0.104 | nan | 0.001 | 0.295 | 0.006 | 0.795 |
| 3 policy | 4,0.2,0.6 | 0.020 | 0.152 | 0.021 | 0.500 | 0.061 | 0.063 | 0.160 | -0.001 | 0.430 | 0.002 | 1.003 |
| 3 wbc | 4,0.2,0.6 | 0.024 | 0.214 | 0.026 | 0.500 | 0.120 | 0.199 | 1.420 | 0.001 | 0.549 | 0.001 | 0.905 |
| 4 policy | 3,0,0 | 0.023 | 0.075 | 0.024 | 0.333 | 0.054 | 0.011 | 0.000 | -0.000 | 0.283 | 0.002 | 0.808 |
| 4 wbc | 3,0,0 | 0.033 | 0.126 | 0.034 | 0.333 | 0.107 | 0.142 | 0.000 | 0.001 | 0.346 | 0.004 | 0.828 |

**hardware/uart_imu** — policy completed, WBC completed

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
| 6 wbc | 2,0,0 | 0.021 | 0.047 | 0.022 | 0.500 | 0.082 | 0.075 | nan | -0.007 | 0.274 | 0.015 | 0.699 |
| 7 policy | 3,0,0,-0.05 | 0.024 | 0.015 | 0.025 | 0.333 | 0.027 | 0.006 | nan | 0.003 | 0.334 | 0.002 | 0.925 |
| 7 wbc | 3,0,0,-0.05 | 0.022 | 0.047 | 0.025 | 0.333 | 0.070 | 0.044 | nan | 0.008 | 0.258 | 0.004 | 0.881 |
| 8 policy | 2,0,0 | 0.028 | 0.012 | 0.029 | 0.500 | 0.029 | 0.006 | nan | 0.003 | 0.337 | 0.003 | 0.993 |
| 8 wbc | 2,0,0 | 0.017 | 0.029 | 0.017 | 0.500 | 0.049 | 0.037 | nan | 0.009 | 0.183 | 0.015 | 0.946 |
| 9 policy | 3,0,0,0.05 | 0.029 | 0.013 | 0.030 | 0.333 | 0.027 | 0.008 | nan | -0.003 | 0.347 | 0.003 | 0.767 |
| 9 wbc | 3,0,0,0.05 | 0.023 | 0.056 | 0.025 | 0.333 | 0.086 | 0.070 | nan | -0.006 | 0.287 | 0.013 | 0.800 |
| 10 policy | 3,0,0 | 0.028 | 0.009 | 0.029 | 0.333 | 0.024 | 0.009 | nan | -0.003 | 0.363 | 0.003 | 0.660 |
| 10 wbc | 3,0,0 | 0.020 | 0.048 | 0.022 | 0.333 | 0.073 | 0.048 | nan | -0.007 | 0.254 | 0.014 | 0.710 |

**default/worst** — policy completed, WBC FELL

| phase | command | truth_pitch_rms | truth_speed_err_rms | pitch_rms | pitch_peak_hz | vel_err_rms | yaw_err_rms | yaw_rise_s | height_err | wheel_tau_rms | wheel_flip_frac | leg_eff_rms |
|---|---|---|---|---|---|---|---|---|---|---|---|---|
| 0 policy | 3,0,0 | 0.031 | 0.012 | 0.030 | 0.327 | 0.029 | 0.006 | nan | -0.000 | 0.382 | 0.011 | 0.790 |
| 0 wbc | 3,0,0 | nan | nan | nan | nan | nan | nan | nan | nan | nan | nan | nan |
| 1 policy | 4,0.3,0 | 0.029 | 0.080 | 0.029 | 0.508 | 0.143 | 0.011 | nan | -0.000 | 1.103 | 0.002 | 0.788 |
| 1 wbc | 4,0.3,0 | nan | nan | nan | nan | nan | nan | nan | nan | nan | nan | nan |
| 2 policy | 3,0,0 | 0.033 | 0.081 | 0.035 | 0.333 | 0.107 | 0.007 | nan | -0.000 | 0.815 | 0.019 | 0.794 |
| 2 wbc | 3,0,0 | nan | nan | nan | nan | nan | nan | nan | nan | nan | nan | nan |
| 3 policy | 4,0.3,1.0 | 0.038 | 0.307 | 0.038 | 0.750 | 0.243 | 0.108 | 0.140 | -0.001 | 1.976 | 0.008 | 1.018 |
| 3 wbc | 4,0.3,1.0 | nan | nan | nan | nan | nan | nan | nan | nan | nan | nan | nan |
| 4 policy | 3,0,0 | 0.034 | 0.121 | 0.035 | 0.667 | 0.114 | 0.051 | 0.000 | -0.001 | 0.948 | 0.012 | 0.809 |
| 4 wbc | 3,0,0 | nan | nan | nan | nan | nan | nan | nan | nan | nan | nan | nan |
| 5 policy | 3,0,0,1.2 | 0.031 | 0.011 | 0.032 | 0.333 | 0.034 | 0.010 | nan | -0.003 | 0.410 | 0.003 | 0.679 |
| 5 wbc | 3,0,0,1.2 | nan | nan | nan | nan | nan | nan | nan | nan | nan | nan | nan |
| 6 policy | 2,0,0 | 0.030 | 0.012 | 0.031 | 0.500 | 0.031 | 0.008 | nan | -0.003 | 0.434 | 0.007 | 0.659 |
| 6 wbc | 2,0,0 | nan | nan | nan | nan | nan | nan | nan | nan | nan | nan | nan |
| 7 policy | 3,0,0,-0.05 | 0.018 | 0.017 | 0.018 | 0.333 | 0.031 | 0.007 | nan | 0.003 | 0.619 | 0.038 | 0.943 |
| 7 wbc | 3,0,0,-0.05 | nan | nan | nan | nan | nan | nan | nan | nan | nan | nan | nan |
| 8 policy | 2,0,0 | 0.028 | 0.019 | 0.031 | 0.500 | 0.050 | 0.007 | nan | 0.003 | 0.445 | 0.013 | 0.998 |
| 8 wbc | 2,0,0 | nan | nan | nan | nan | nan | nan | nan | nan | nan | nan | nan |
| 9 policy | 3,0,0,0.05 | 0.026 | 0.016 | 0.027 | 0.333 | 0.038 | 0.008 | nan | -0.003 | 0.750 | 0.055 | 0.759 |
| 9 wbc | 3,0,0,0.05 | nan | nan | nan | nan | nan | nan | nan | nan | nan | nan | nan |
| 10 policy | 3,0,0 | 0.031 | 0.011 | 0.032 | 0.333 | 0.031 | 0.010 | nan | -0.003 | 0.400 | 0.003 | 0.660 |
| 10 wbc | 3,0,0 | nan | nan | nan | nan | nan | nan | nan | nan | nan | nan | nan |

**push/nominal** — policy completed, WBC completed

| phase | command | truth_pitch_rms | truth_speed_err_rms | pitch_rms | pitch_peak_hz | vel_err_rms | yaw_err_rms | yaw_rise_s | height_err | wheel_tau_rms | wheel_flip_frac | leg_eff_rms |
|---|---|---|---|---|---|---|---|---|---|---|---|---|
| 0 policy | 10,0,0 | 0.029 | 0.033 | 0.031 | 0.600 | 0.074 | 0.007 | nan | -0.000 | 0.429 | 0.005 | 0.795 |
| 0 wbc | 10,0,0 | 0.023 | 0.067 | 0.024 | 0.300 | 0.105 | 0.074 | nan | 0.001 | 0.250 | 0.015 | 0.778 |

**push/uart_imu** — policy completed, WBC completed

| phase | command | truth_pitch_rms | truth_speed_err_rms | pitch_rms | pitch_peak_hz | vel_err_rms | yaw_err_rms | yaw_rise_s | height_err | wheel_tau_rms | wheel_flip_frac | leg_eff_rms |
|---|---|---|---|---|---|---|---|---|---|---|---|---|
| 0 policy | 10,0,0 | 0.033 | 0.037 | 0.035 | 0.600 | 0.087 | 0.007 | nan | -0.000 | 0.493 | 0.002 | 0.794 |
| 0 wbc | 10,0,0 | 0.023 | 0.071 | 0.025 | 0.400 | 0.118 | 0.083 | nan | 0.001 | 0.303 | 0.010 | 0.776 |

**push/worst** — policy completed, WBC FELL

| phase | command | truth_pitch_rms | truth_speed_err_rms | pitch_rms | pitch_peak_hz | vel_err_rms | yaw_err_rms | yaw_rise_s | height_err | wheel_tau_rms | wheel_flip_frac | leg_eff_rms |
|---|---|---|---|---|---|---|---|---|---|---|---|---|
| 0 policy | 10,0,0 | 0.037 | 0.040 | 0.038 | 0.500 | 0.130 | 0.007 | nan | -0.000 | 1.108 | 0.013 | 0.792 |
| 0 wbc | 10,0,0 | nan | nan | nan | nan | nan | nan | nan | nan | nan | nan | nan |
