A-Common-Guy/bipedale/sandro_rl/policies/agile_obstacles/eval/comparison.md

**hardware/nominal** — policy completed, WBC completed

| phase | command | truth_pitch_rms | truth_speed_err_rms | pitch_rms | pitch_peak_hz | vel_err_rms | yaw_err_rms | yaw_rise_s | height_err | wheel_tau_rms | wheel_flip_frac | leg_eff_rms |
|---|---|---|---|---|---|---|---|---|---|---|---|---|
| 0 policy | 5,0,0 | 0.001 | 0.016 | 0.008 | 6.400 | 0.016 | 0.005 | nan | -0.003 | 0.153 | 0.001 | 0.824 |
| 0 wbc | 5,0,0 | 0.023 | 0.065 | 0.024 | 0.400 | 0.072 | 0.003 | nan | 0.002 | 0.216 | 0.008 | 0.779 |
| 1 policy | 4,0.2,0 | 0.027 | 0.049 | 0.029 | 0.500 | 0.071 | 0.008 | nan | -0.003 | 0.502 | 0.002 | 0.832 |
| 1 wbc | 4,0.2,0 | 0.002 | 0.040 | 0.008 | 23.750 | 0.050 | 0.003 | nan | 0.001 | 0.288 | 0.000 | 0.778 |
| 2 policy | 4,0,0 | 0.041 | 0.041 | 0.042 | 0.500 | 0.071 | 0.007 | nan | -0.003 | 0.397 | 0.006 | 0.828 |
| 2 wbc | 4,0,0 | 0.025 | 0.083 | 0.026 | 0.500 | 0.086 | 0.003 | nan | 0.001 | 0.217 | 0.006 | 0.790 |
| 3 policy | 4,0.2,0.6 | 0.027 | 0.146 | 0.028 | 0.500 | 0.072 | 0.076 | 0.220 | -0.002 | 0.417 | 0.002 | 0.976 |
| 3 wbc | 4,0.2,0.6 | 0.019 | 0.223 | 0.021 | 20.000 | 0.099 | 0.172 | 1.020 | 0.001 | 0.442 | 0.003 | 0.930 |
| 4 policy | 3,0,0 | 0.047 | 0.081 | 0.048 | 0.333 | 0.100 | 0.015 | 0.000 | -0.003 | 0.399 | 0.003 | 0.835 |
| 4 wbc | 3,0,0 | 0.034 | 0.119 | 0.035 | 0.333 | 0.098 | 0.071 | 0.000 | 0.001 | 0.303 | 0.003 | 0.855 |

**hardware/uart_imu** — policy completed, WBC completed

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
| 7 wbc | 3,0,0,-0.05 | nan | nan | nan | nan | nan | nan | nan | nan | nan | nan | nan |
| 8 policy | 2,0,0 | 0.037 | 0.029 | 0.038 | 0.500 | 0.051 | 0.023 | nan | 0.015 | 0.361 | 0.003 | 1.105 |
| 8 wbc | 2,0,0 | nan | nan | nan | nan | nan | nan | nan | nan | nan | nan | nan |
| 9 policy | 3,0,0,0.05 | 0.020 | 0.011 | 0.022 | 0.333 | 0.014 | 0.007 | nan | -0.005 | 0.132 | 0.021 | 0.896 |
| 9 wbc | 3,0,0,0.05 | nan | nan | nan | nan | nan | nan | nan | nan | nan | nan | nan |
| 10 policy | 3,0,0 | 0.013 | 0.007 | 0.015 | 0.333 | 0.010 | 0.003 | nan | -0.007 | 0.094 | 0.021 | 0.646 |
| 10 wbc | 3,0,0 | nan | nan | nan | nan | nan | nan | nan | nan | nan | nan | nan |

**default/worst** — policy completed, WBC FELL

| phase | command | truth_pitch_rms | truth_speed_err_rms | pitch_rms | pitch_peak_hz | vel_err_rms | yaw_err_rms | yaw_rise_s | height_err | wheel_tau_rms | wheel_flip_frac | leg_eff_rms |
|---|---|---|---|---|---|---|---|---|---|---|---|---|
| 0 policy | 3,0,0 | 0.038 | 0.029 | 0.040 | 0.327 | 0.050 | 0.009 | nan | -0.003 | 1.312 | 0.066 | 0.858 |
| 0 wbc | 3,0,0 | nan | nan | nan | nan | nan | nan | nan | nan | nan | nan | nan |
| 1 policy | 4,0.3,0 | 0.027 | 0.072 | 0.027 | 0.508 | 0.133 | 0.010 | nan | -0.003 | 0.962 | 0.002 | 0.828 |
| 1 wbc | 4,0.3,0 | nan | nan | nan | nan | nan | nan | nan | nan | nan | nan | nan |
| 2 policy | 3,0,0 | 0.053 | 0.076 | 0.054 | 0.333 | 0.219 | 0.024 | nan | -0.003 | 1.726 | 0.046 | 0.853 |
| 2 wbc | 3,0,0 | nan | nan | nan | nan | nan | nan | nan | nan | nan | nan | nan |
| 3 policy | 4,0.3,1.0 | 0.029 | 0.286 | 0.029 | 0.750 | 0.156 | 0.151 | 0.140 | -0.002 | 0.964 | 0.022 | 0.995 |
| 3 wbc | 4,0.3,1.0 | nan | nan | nan | nan | nan | nan | nan | nan | nan | nan | nan |
| 4 policy | 3,0,0 | 0.054 | 0.117 | 0.054 | 0.333 | 0.248 | 0.056 | 0.000 | -0.003 | 1.671 | 0.010 | 0.834 |
| 4 wbc | 3,0,0 | nan | nan | nan | nan | nan | nan | nan | nan | nan | nan | nan |
| 5 policy | 3,0,0,1.2 | 0.029 | 0.019 | 0.031 | 0.333 | 0.033 | 0.004 | nan | -0.007 | 0.243 | 0.006 | 0.677 |
| 5 wbc | 3,0,0,1.2 | nan | nan | nan | nan | nan | nan | nan | nan | nan | nan | nan |
| 6 policy | 2,0,0 | 0.025 | 0.024 | 0.027 | 0.500 | 0.034 | 0.003 | nan | -0.007 | 0.309 | 0.005 | 0.659 |
| 6 wbc | 2,0,0 | nan | nan | nan | nan | nan | nan | nan | nan | nan | nan | nan |
| 7 policy | 3,0,0,-0.05 | 0.014 | 0.009 | 0.015 | 0.333 | 0.042 | 0.012 | nan | 0.007 | 0.993 | 0.041 | 0.995 |
| 7 wbc | 3,0,0,-0.05 | nan | nan | nan | nan | nan | nan | nan | nan | nan | nan | nan |
| 8 policy | 2,0,0 | 0.000 | 0.002 | 0.008 | 2.000 | 0.005 | 0.014 | nan | 0.012 | 0.067 | 0.023 | 1.103 |
| 8 wbc | 2,0,0 | nan | nan | nan | nan | nan | nan | nan | nan | nan | nan | nan |
| 9 policy | 3,0,0,0.05 | 0.023 | 0.019 | 0.024 | 0.333 | 0.036 | 0.006 | nan | -0.005 | 0.355 | 0.022 | 0.895 |
| 9 wbc | 3,0,0,0.05 | nan | nan | nan | nan | nan | nan | nan | nan | nan | nan | nan |
| 10 policy | 3,0,0 | 0.043 | 0.028 | 0.045 | 0.333 | 0.041 | 0.004 | nan | -0.007 | 0.338 | 0.005 | 0.650 |
| 10 wbc | 3,0,0 | nan | nan | nan | nan | nan | nan | nan | nan | nan | nan | nan |

**push/nominal** — policy completed, WBC completed

| phase | command | truth_pitch_rms | truth_speed_err_rms | pitch_rms | pitch_peak_hz | vel_err_rms | yaw_err_rms | yaw_rise_s | height_err | wheel_tau_rms | wheel_flip_frac | leg_eff_rms |
|---|---|---|---|---|---|---|---|---|---|---|---|---|
| 0 policy | 10,0,0 | 0.051 | 0.047 | 0.052 | 0.400 | 0.088 | 0.008 | nan | -0.003 | 0.380 | 0.011 | 0.826 |
| 0 wbc | 10,0,0 | 0.023 | 0.073 | 0.024 | 0.400 | 0.089 | 0.004 | nan | 0.001 | 0.233 | 0.008 | 0.782 |

**push/uart_imu** — policy completed, WBC completed

| phase | command | truth_pitch_rms | truth_speed_err_rms | pitch_rms | pitch_peak_hz | vel_err_rms | yaw_err_rms | yaw_rise_s | height_err | wheel_tau_rms | wheel_flip_frac | leg_eff_rms |
|---|---|---|---|---|---|---|---|---|---|---|---|---|
| 0 policy | 10,0,0 | 0.045 | 0.050 | 0.047 | 0.400 | 0.105 | 0.010 | nan | -0.003 | 0.491 | 0.008 | 0.829 |
| 0 wbc | 10,0,0 | 0.022 | 0.076 | 0.023 | 0.400 | 0.100 | 0.007 | nan | 0.001 | 0.254 | 0.014 | 0.781 |

**push/worst** — policy completed, WBC FELL

| phase | command | truth_pitch_rms | truth_speed_err_rms | pitch_rms | pitch_peak_hz | vel_err_rms | yaw_err_rms | yaw_rise_s | height_err | wheel_tau_rms | wheel_flip_frac | leg_eff_rms |
|---|---|---|---|---|---|---|---|---|---|---|---|---|
| 0 policy | 10,0,0 | 0.041 | 0.060 | 0.042 | 0.400 | 0.148 | 0.017 | nan | -0.003 | 1.555 | 0.060 | 0.855 |
| 0 wbc | 10,0,0 | nan | nan | nan | nan | nan | nan | nan | nan | nan | nan | nan |
