A-Common-Guy/bipedale/sandro_rl/policies/flat_level_fast/eval/lag_sweep.md

| scenario | wheel lag (s) | result | wheel effort RMS R/L (Nm) | peak (Hz) | 5-15 Hz share |
|---|---|---|---|---|---|
| hardware | 0.000 | completed | 0.29 / 0.24 | 0.1 / 0.0 | 0.01 |
| hardware | 0.035 | completed | 0.29 / 0.24 | 0.1 / 0.0 | 0.03 |
| hardware | 0.050 | completed | 0.29 / 0.24 | 0.1 / 0.0 | 0.05 |
| hardware | 0.080 | completed | 0.29 / 0.24 | 0.1 / 0.0 | 0.04 |
| default | 0.000 | completed | 0.28 / 0.24 | 0.1 / 0.1 | 0.01 |
| default | 0.035 | completed | 0.29 / 0.24 | 0.1 / 0.1 | 0.03 |
| default | 0.050 | completed | 0.29 / 0.24 | 0.1 / 0.1 | 0.04 |
| default | 0.080 | completed | 0.29 / 0.24 | 0.1 / 0.1 | 0.03 |
| push | 0.000 | completed | 0.19 / 0.21 | 0.6 / 0.6 | 0.07 |
| push | 0.035 | completed | 0.19 / 0.21 | 0.6 / 0.6 | 0.12 |
| push | 0.050 | completed | 0.20 / 0.22 | 0.6 / 0.6 | 0.23 |
| push | 0.080 | completed | 0.20 / 0.22 | 0.6 / 0.6 | 0.14 |
