A-Common-Guy/bipedale/sandro_rl/policies/flat_level_real/eval/lag_sweep.md

| scenario | wheel lag (s) | result | wheel effort RMS R/L (Nm) | peak (Hz) | 5-15 Hz share |
|---|---|---|---|---|---|
| hardware | 0.000 | completed | 0.32 / 0.21 | 0.1 / 0.0 | 0.01 |
| hardware | 0.035 | completed | 0.31 / 0.22 | 0.1 / 0.0 | 0.03 |
| hardware | 0.050 | completed | 0.31 / 0.22 | 0.1 / 0.0 | 0.03 |
| hardware | 0.080 | completed | 0.31 / 0.23 | 0.1 / 0.0 | 0.04 |
| default | 0.000 | completed | 0.31 / 0.21 | 0.1 / 0.1 | 0.01 |
| default | 0.035 | completed | 0.31 / 0.21 | 0.1 / 0.1 | 0.04 |
| default | 0.050 | completed | 0.31 / 0.21 | 0.1 / 0.1 | 0.06 |
| default | 0.080 | completed | 0.30 / 0.22 | 0.1 / 0.1 | 0.07 |
| push | 0.000 | completed | 0.14 / 0.13 | 0.3 / 0.3 | 0.05 |
| push | 0.035 | completed | 0.16 / 0.16 | 0.3 / 0.3 | 0.11 |
| push | 0.050 | completed | 0.17 / 0.17 | 0.2 / 0.3 | 0.18 |
| push | 0.080 | completed | 0.20 / 0.19 | 0.1 / 0.1 | 0.18 |
