A-Common-Guy/bipedale/sandro_rl/policies/flat_level_drivetrain/train_log.csv

iteration | env_steps | wall_s | steps_per_s | episode_return | episode_length_s | fall_rate | action_std | entropy | kl | learning_rate | m/action_accel | m/action_rate | m/alive | m/cat_delta | m/err_forward | m/err_height | m/err_roll | m/err_yaw | m/leg_symmetry | m/leg_torque | m/leg_velocity | m/pitch | m/pitch_rate | m/roll | m/termination | m/tilt | m/track_forward | m/track_height | m/track_yaw | m/vertical_velocity | m/wheel_differential_rate | m/wheel_torque | reward_per_step | surrogate | symmetry | value_loss
1 | 196608 | 21.0 | 9355 | nan | nan | 0.0 | 0.0498042032122612 | -9.484938621520996 | 0.2186996191740036 | 9.999999747378752e-06 | -3.924085831386037e-05 | -7.848171662772074e-05 | 0.010000001639127731 | 1.658584324104595e-06 | 0.12060092389583588 | 0.0020881476812064648 | 0.0 | 0.08613720536231995 | -0.00014254704001359642 | -5.852598405908793e-05 | -3.969932731706649e-05 | -0.000640072685200721 | -0.0003442015149630606 | -6.113828567322344e-05 | 0.0 | 0.03972627595067024 | 0.01241627149283886 | 0.009561048820614815 | 0.009019247256219387 | -1.2757564036292024e-05 | -2.944631705759093e-05 | -0.00023957586381584406 | 0.03931088000535965 | 0.07315586507320404 |
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
