A-Common-Guy/bipedale/sandro_rl/policies/flat_level_fast_drivetrain/train_log.csv

iteration | env_steps | wall_s | steps_per_s | episode_return | episode_length_s | fall_rate | action_std | entropy | kl | learning_rate | m/action_accel | m/action_rate | m/alive | m/cat_delta | m/err_forward | m/err_height | m/err_roll | m/err_yaw | m/leg_symmetry | m/leg_torque | m/leg_velocity | m/pitch | m/pitch_rate | m/roll | m/termination | m/tilt | m/track_forward | m/track_height | m/track_yaw | m/vertical_velocity | m/wheel_differential_rate | m/wheel_torque | reward_per_step | surrogate | symmetry | value_loss
1 | 589824 | 24.2 | 24408 | nan | nan | 0.0 | 0.04980592429637909 | -9.484709739685059 | 0.07533048838376999 | 9.999999747378752e-06 | -0.00030276543111540377 | -6.728120206389576e-05 | 0.0033333334140479565 | 1.2534858706558794e-09 | 0.12327716499567032 | 0.00238837581127882 | 0.0 | 0.07275533676147461 | -4.6373752411454916e-05 | -1.999206142500043e-05 | -1.1651572094706353e-05 | -0.00018036722030956298 | -7.618309609824792e-05 | -1.6715863239369355e-05 | 0.0 | 0.03540032356977463 | 0.0041224160231649876 | 0.003134987084195018 | 0.0030825978610664606 | -4.454175723367371e-06 | -2.6935838832287118e-05 | -7.302818994503468e-05 | 0.01284758560359478 |
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
