A-Common-Guy/bipedale/sandro_rl/policies/agile_obstacles/eval/agile_course.png

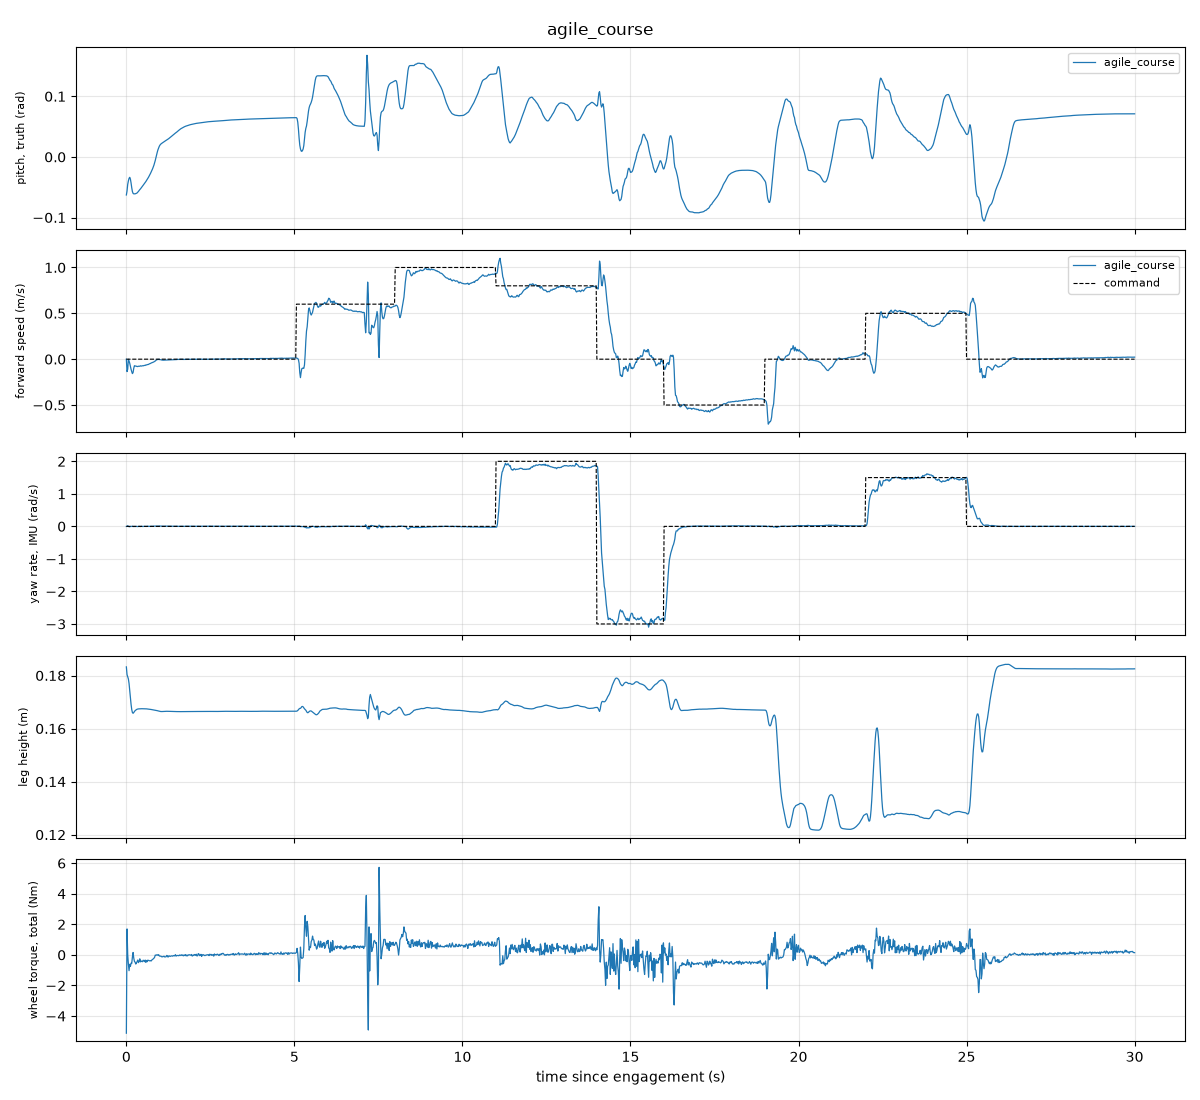
sandro_rl/policies/agile_obstacles/eval/agile_course.png
