A-Common-Guy/bipedale/sandro_rl/policies/agile_obstacles/eval/course_frames.png

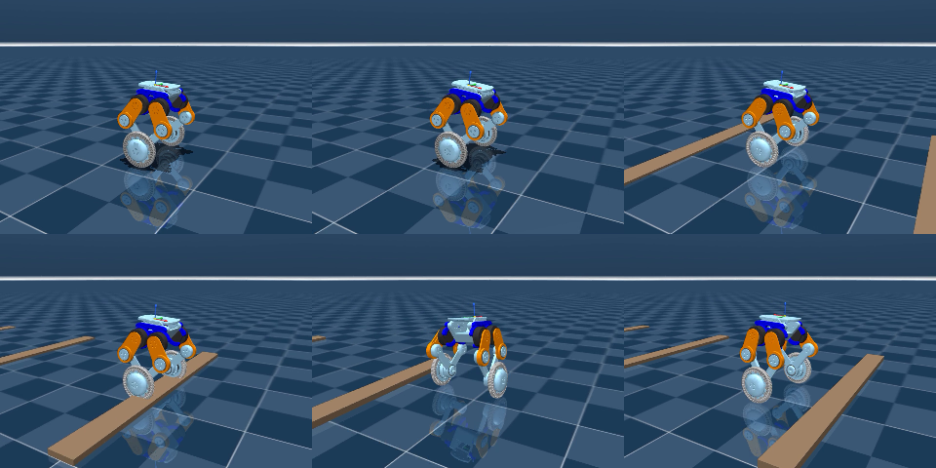
sandro_rl/policies/agile_obstacles/eval/course_frames.png
