A-Common-Guy/bipedale/sandro_rl/policies/agile_obstacles/eval/hardware_nominal.png

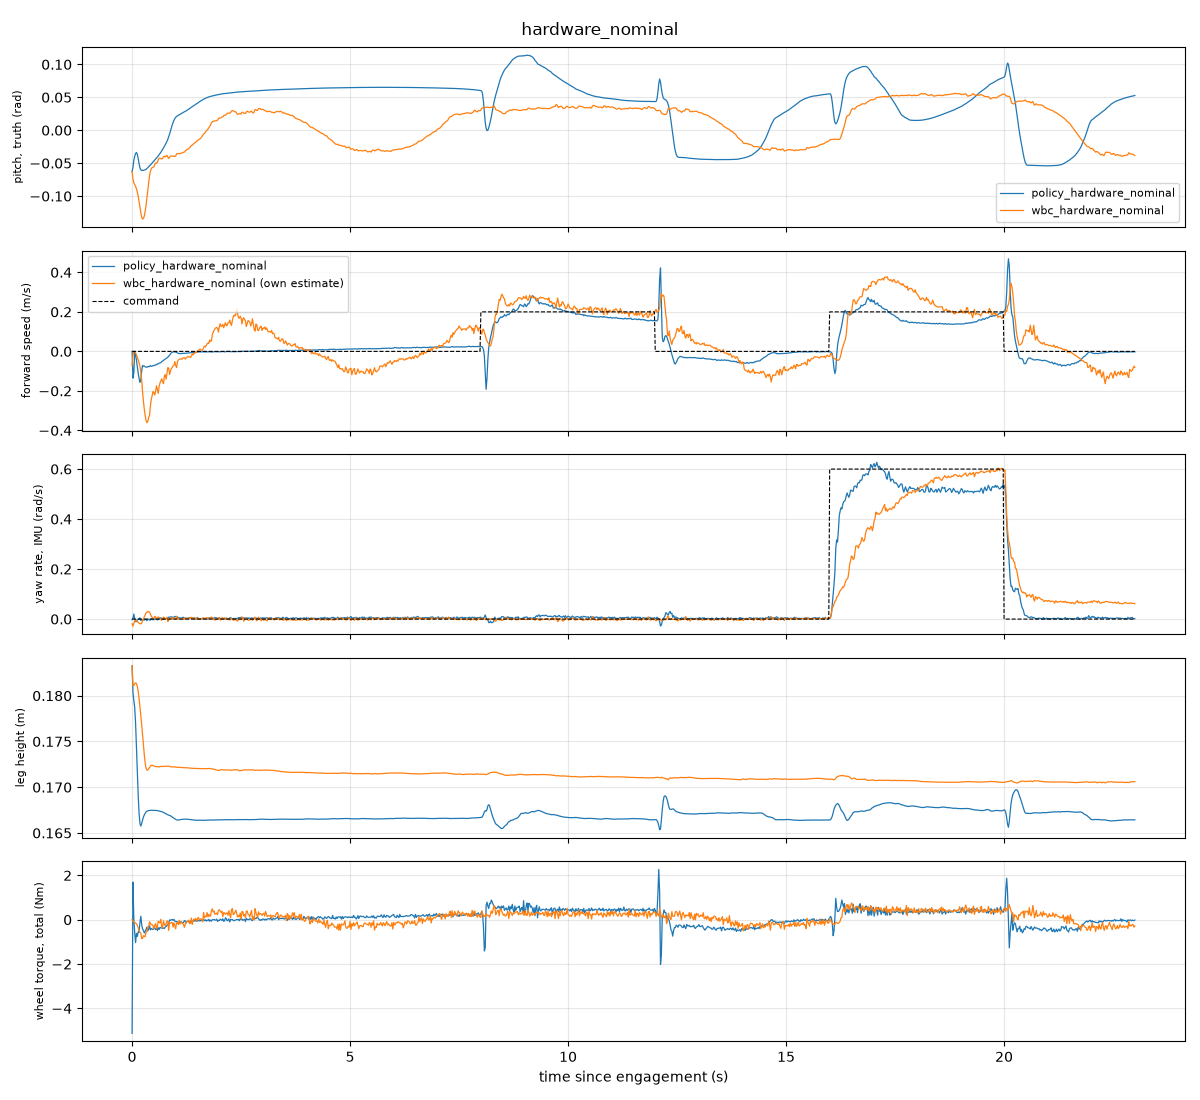
sandro_rl/policies/agile_obstacles/eval/hardware_nominal.png
