A-Common-Guy/bipedale/sandro_rl/policies/agile_terrain/curves.png

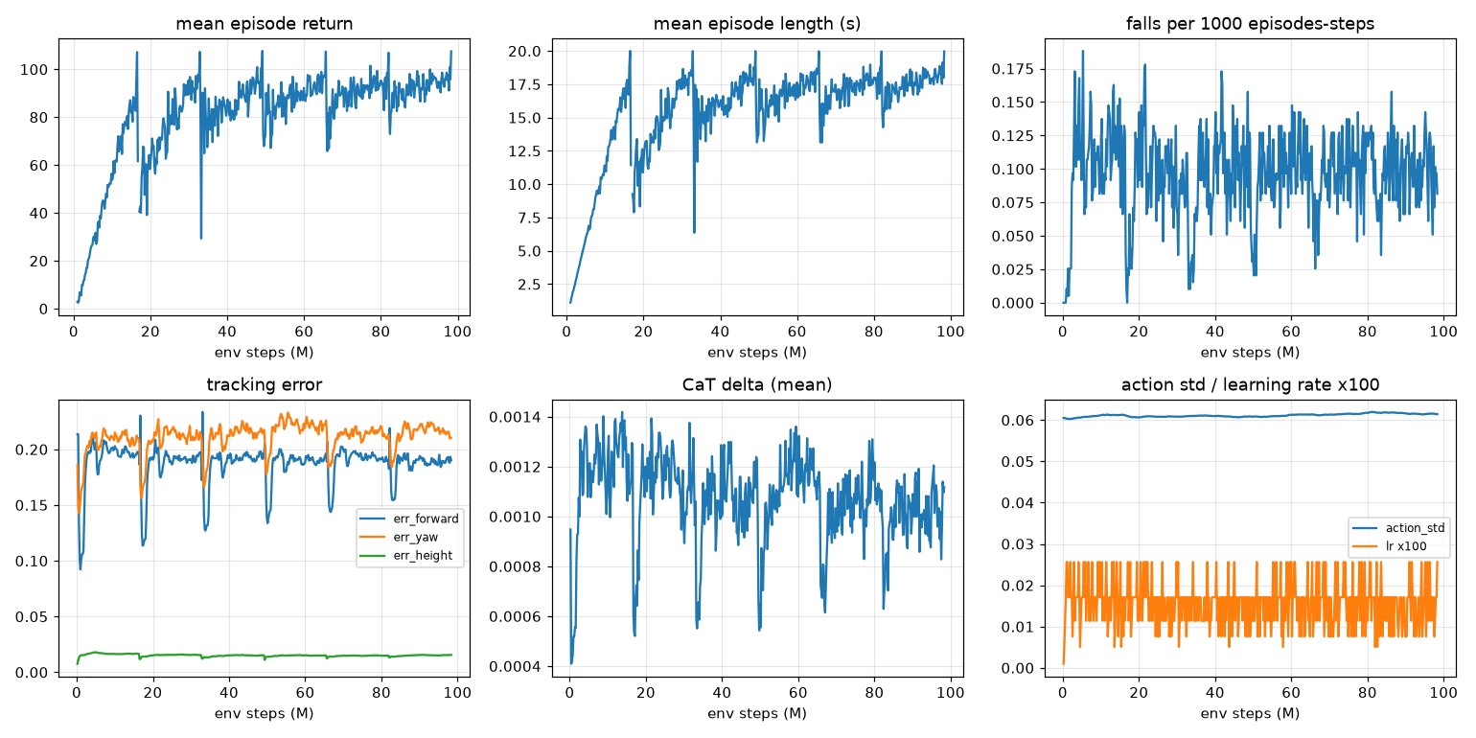
sandro_rl/policies/agile_terrain/curves.png
