A-Common-Guy/bipedale/sandro_rl/policies/agile_terrain/curves_lag.png

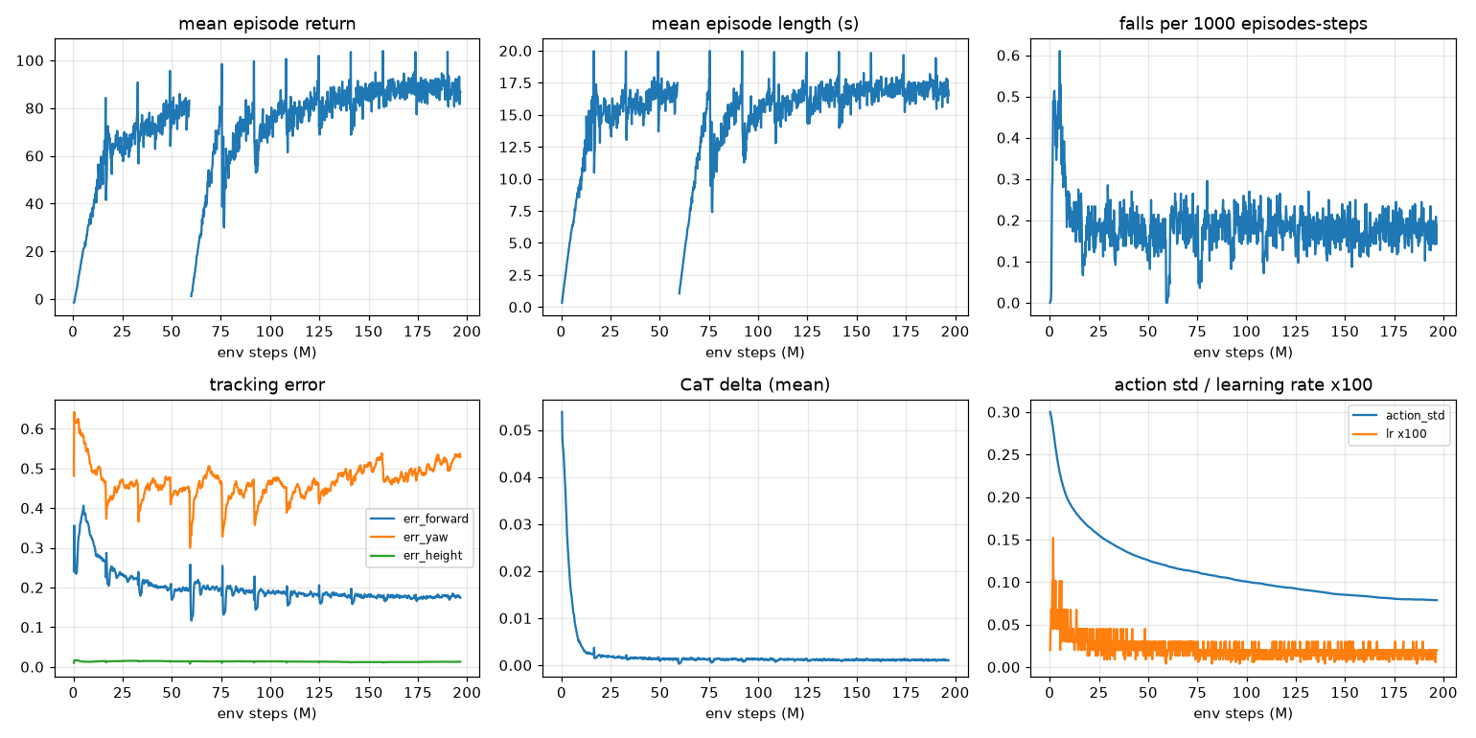
sandro_rl/policies/agile_terrain/curves_lag.png
