A-Common-Guy/bipedale/sandro_rl/policies/agile_terrain/curves_mass.png

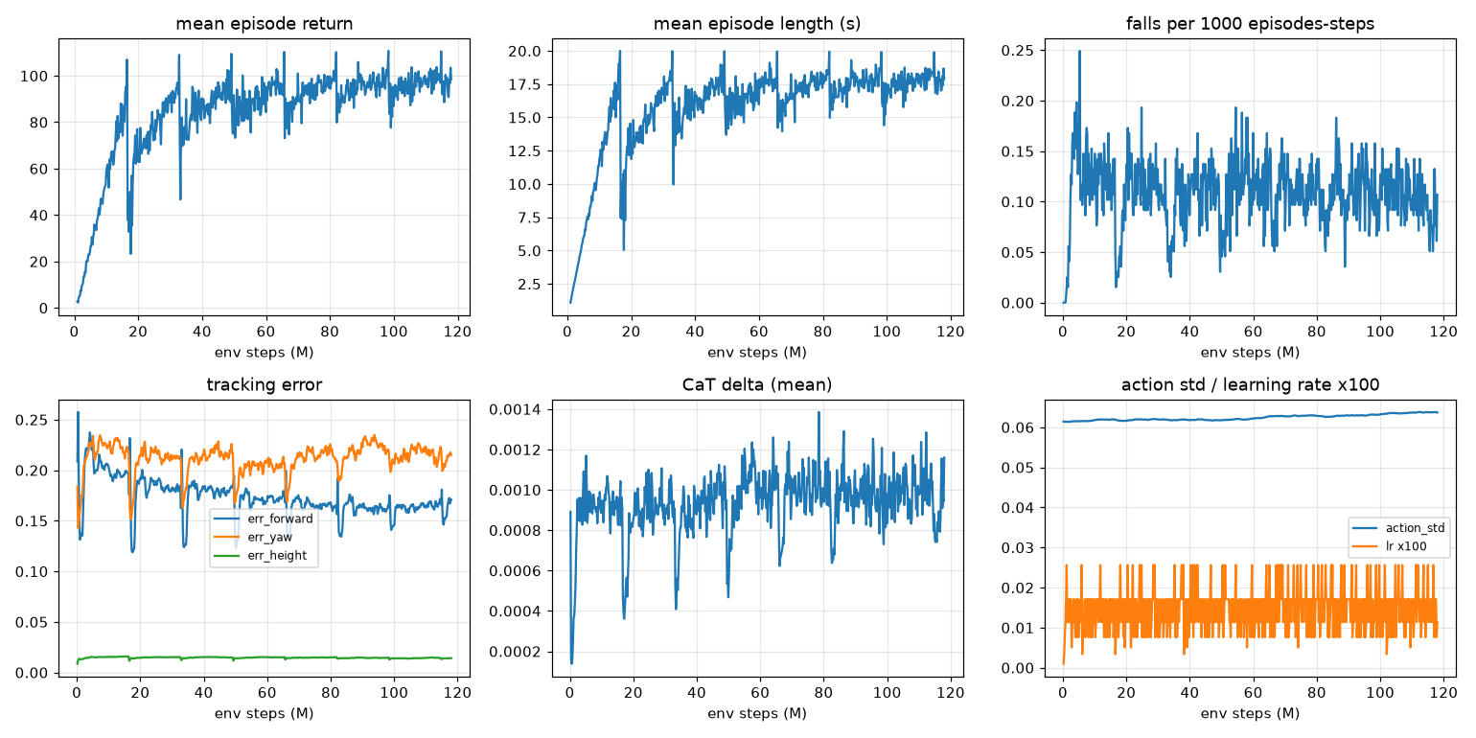
sandro_rl/policies/agile_terrain/curves_mass.png
