A-Common-Guy/bipedale/sandro_rl/policies/agile_terrain/eval/course.png

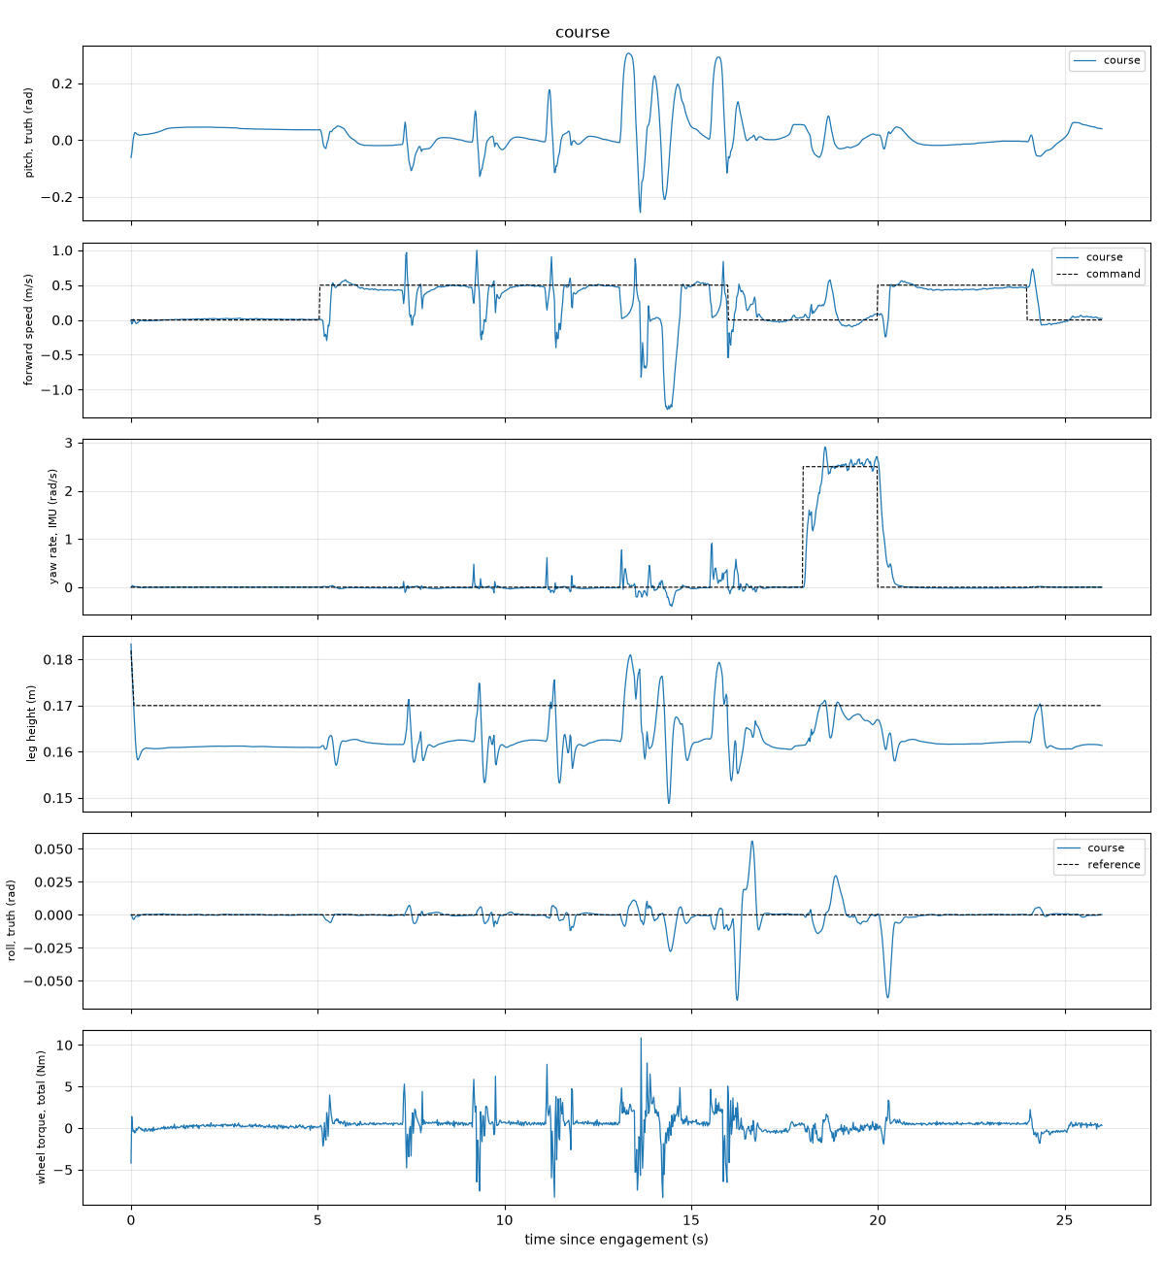
sandro_rl/policies/agile_terrain/eval/course.png
