A-Common-Guy/bipedale/sandro_rl/policies/agile_terrain/eval/course_frames.png

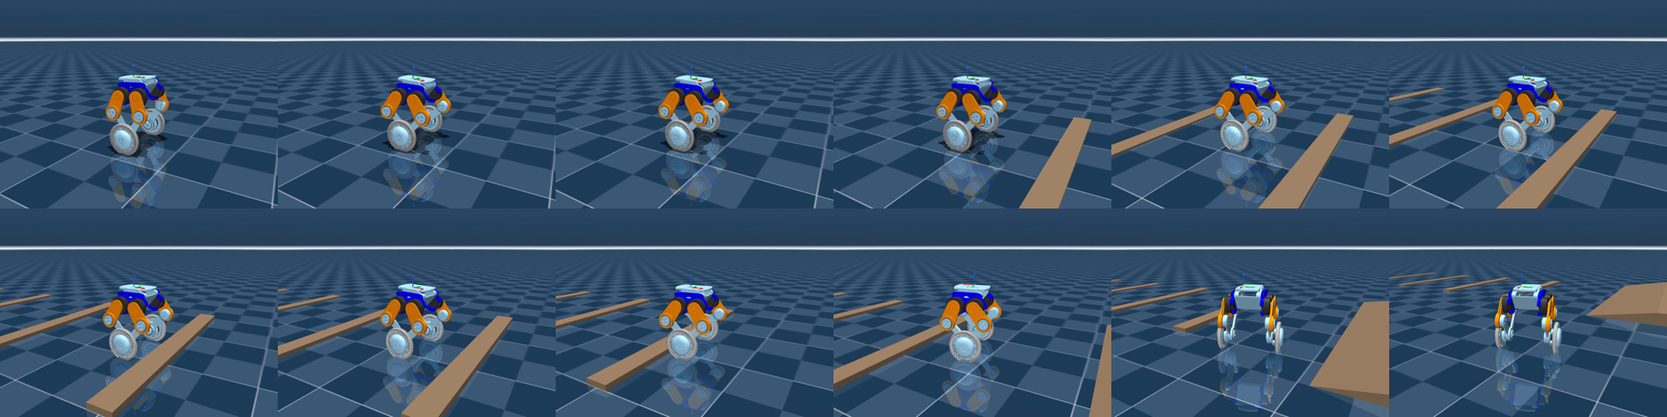
sandro_rl/policies/agile_terrain/eval/course_frames.png
