A-Common-Guy/bipedale/sandro_rl/policies/agile_terrain/eval/expressive.png

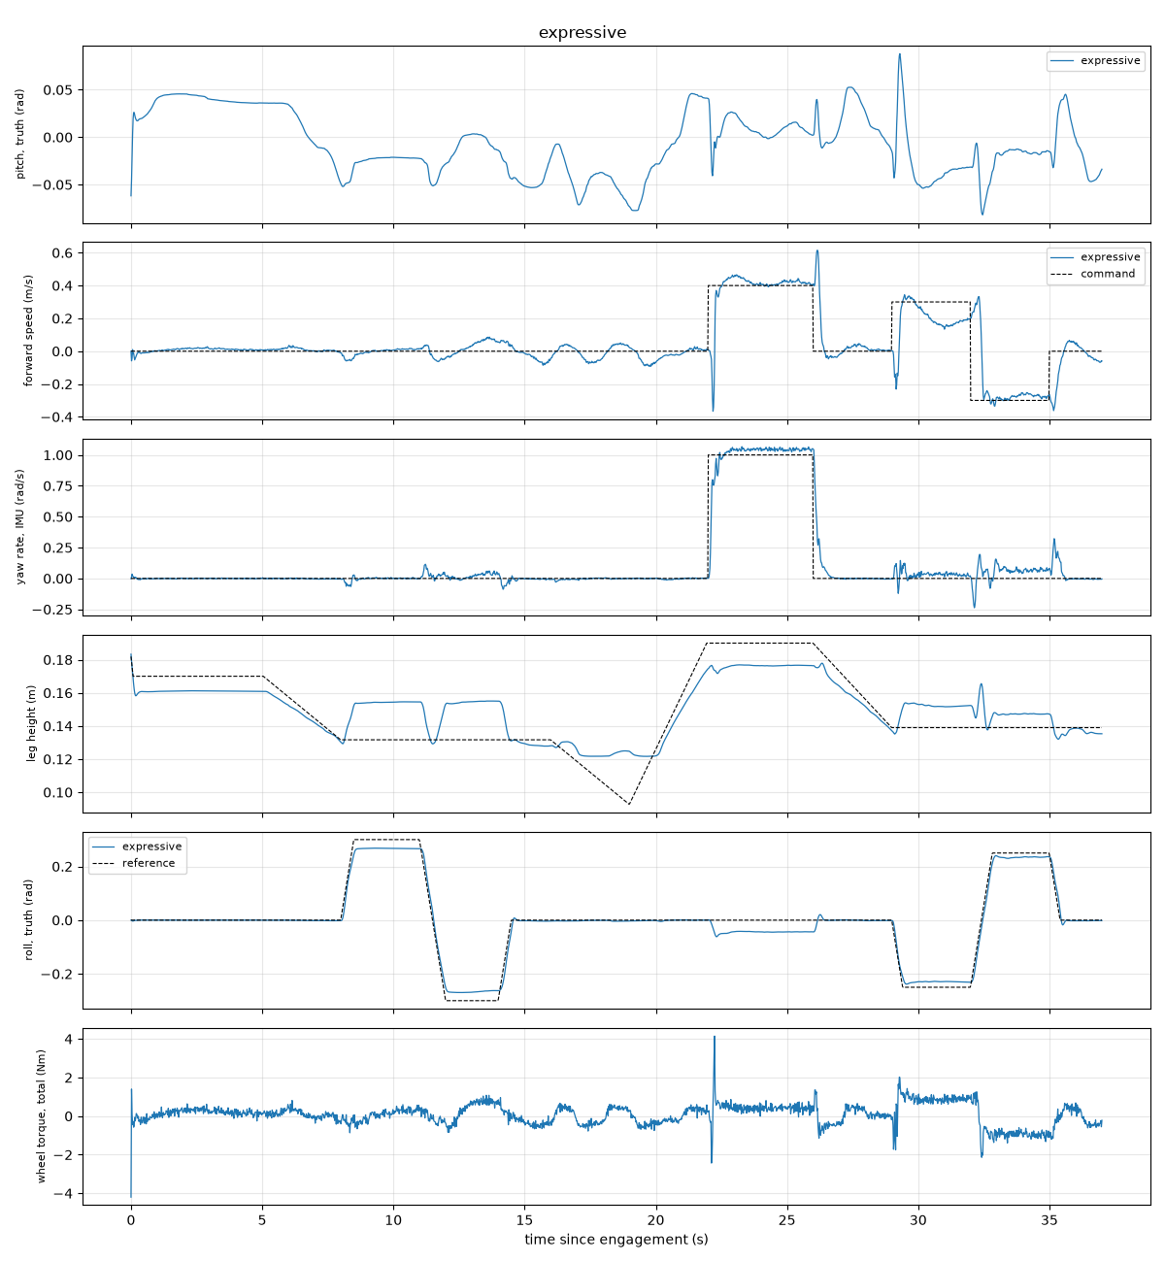
sandro_rl/policies/agile_terrain/eval/expressive.png
