A-Common-Guy/bipedale/sandro_rl/policies/agile_terrain/eval/expressive_frames.png

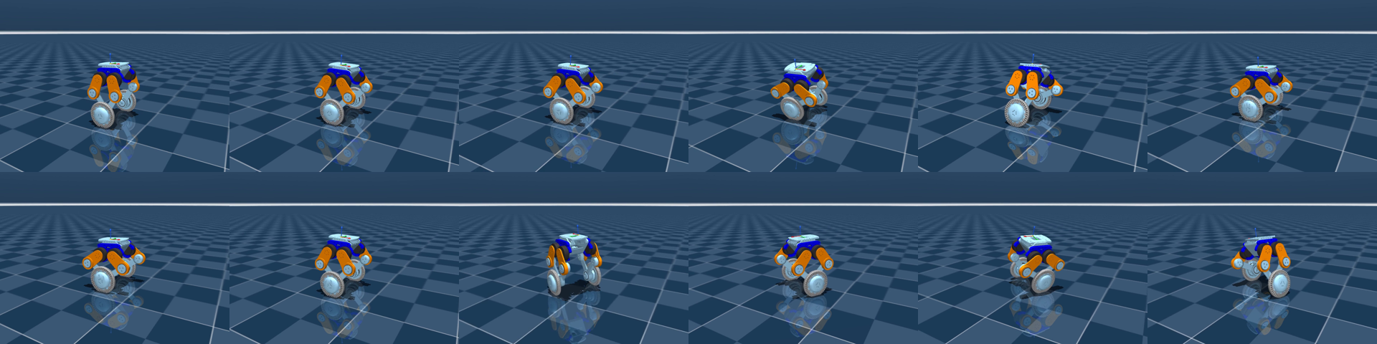
sandro_rl/policies/agile_terrain/eval/expressive_frames.png
