A-Common-Guy/bipedale/sandro_rl/policies/flat_level/curves.png

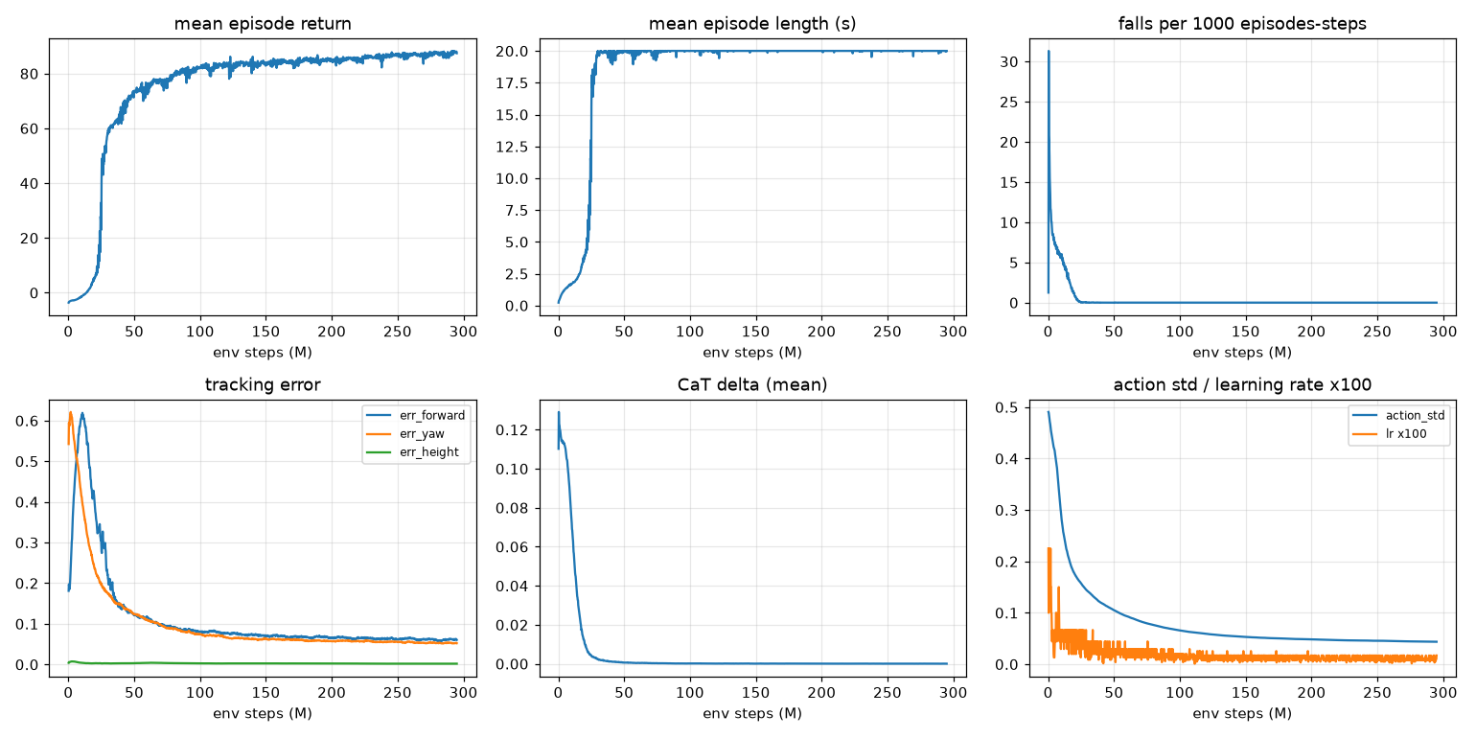
sandro_rl/policies/flat_level/curves.png
