A-Common-Guy/bipedale/sandro_rl/policies/flat_level/curves_mass.png

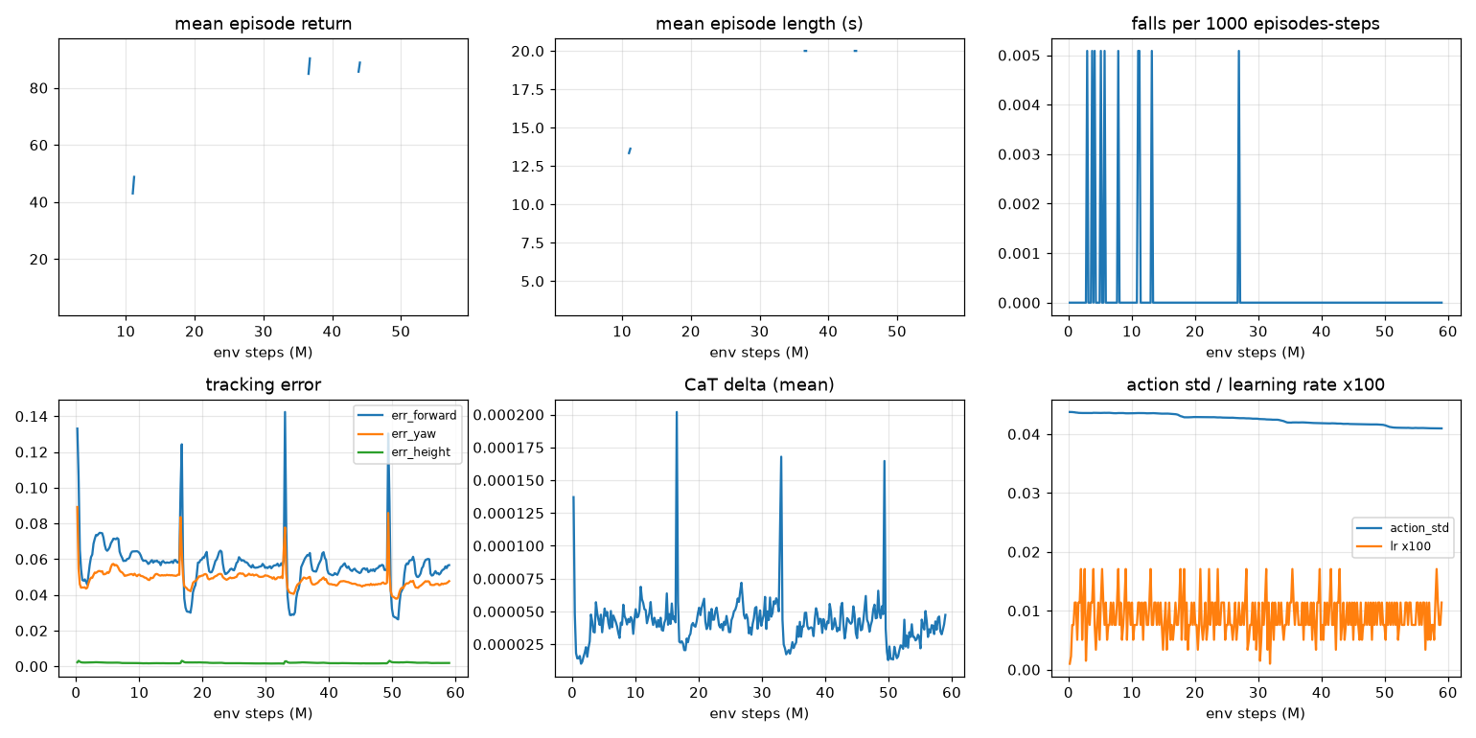
sandro_rl/policies/flat_level/curves_mass.png
