A-Common-Guy/bipedale/sandro_rl/policies/flat_level/eval/default_uart_imu.png

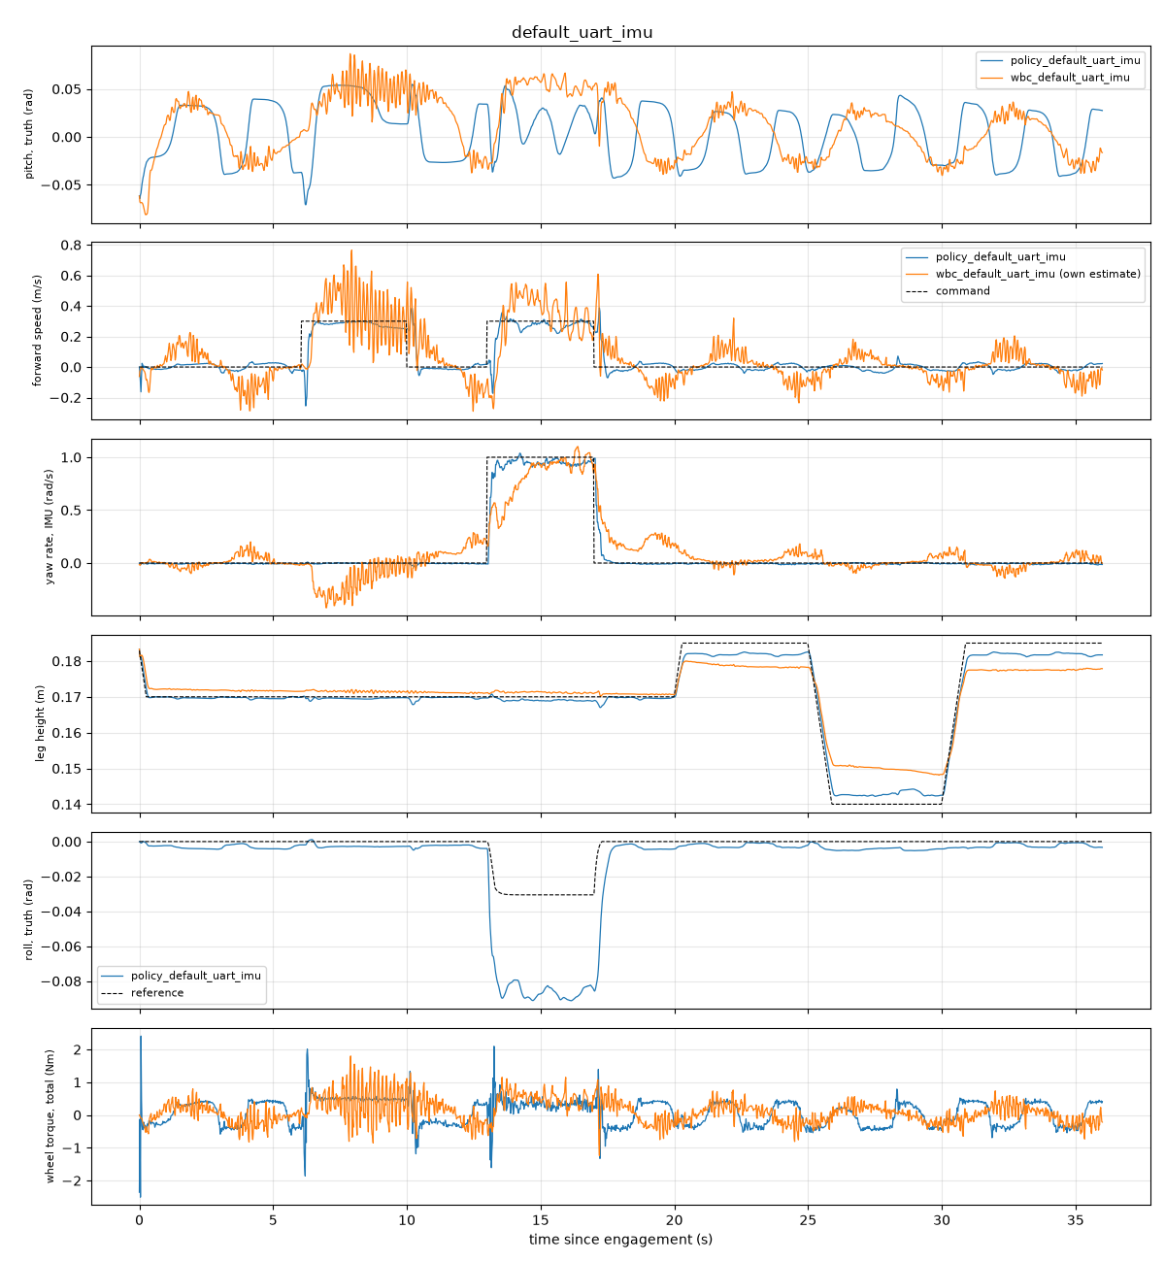
sandro_rl/policies/flat_level/eval/default_uart_imu.png
