A-Common-Guy/bipedale/sandro_rl/policies/flat_level/eval/hardware_nominal.png

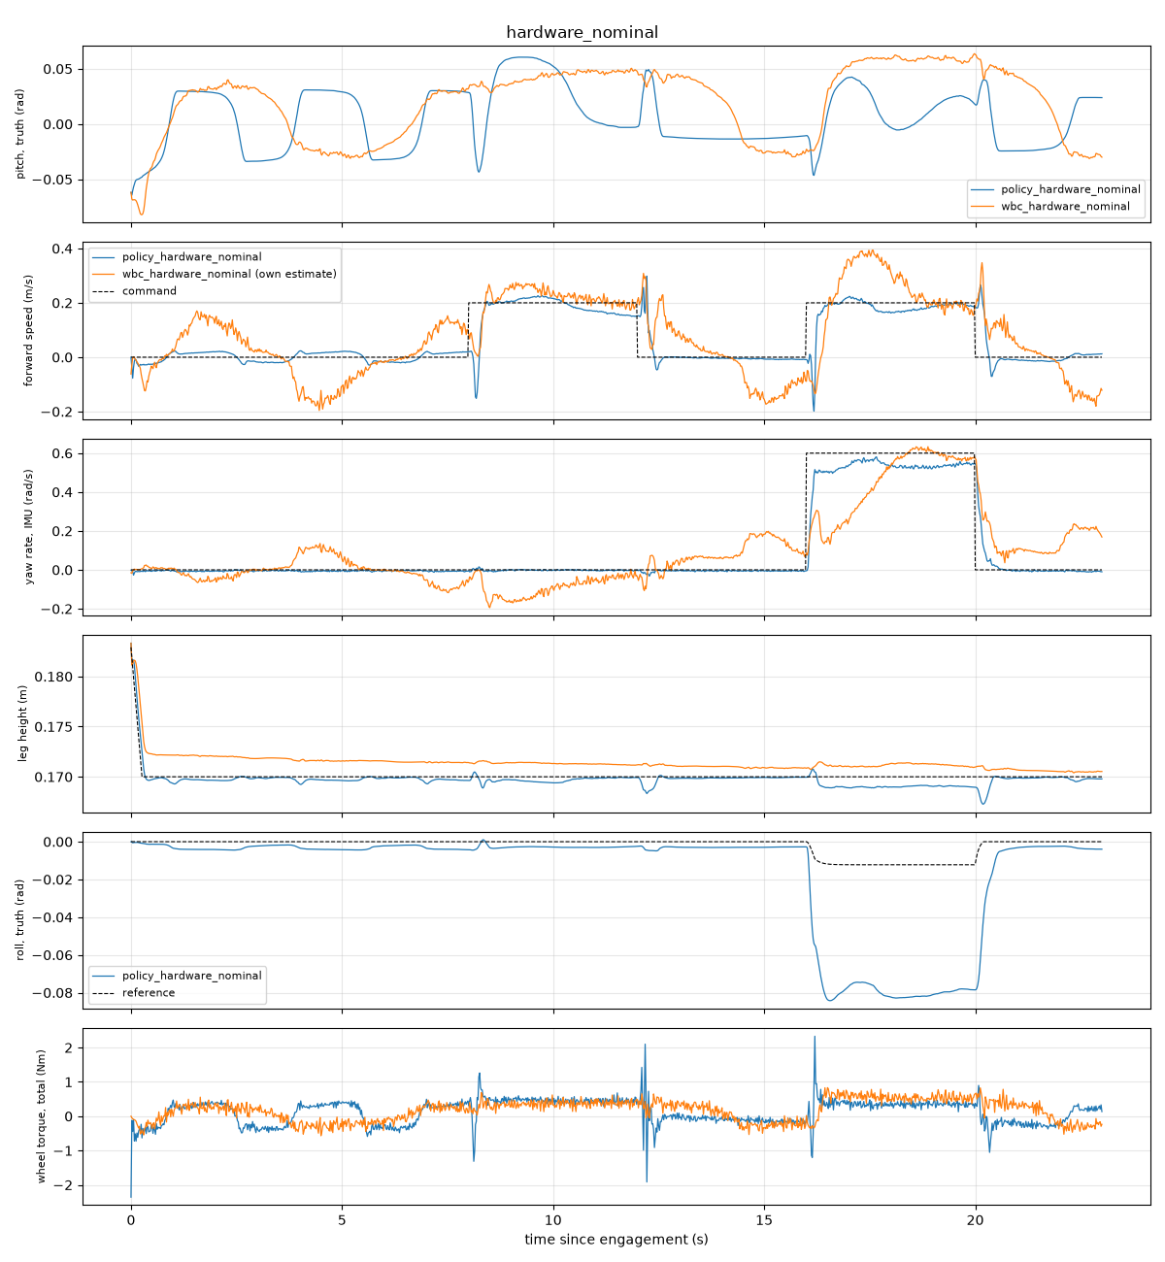
sandro_rl/policies/flat_level/eval/hardware_nominal.png
