A-Common-Guy/bipedale/sandro_rl/policies/flat_level_real/eval/hardware_lag50.png

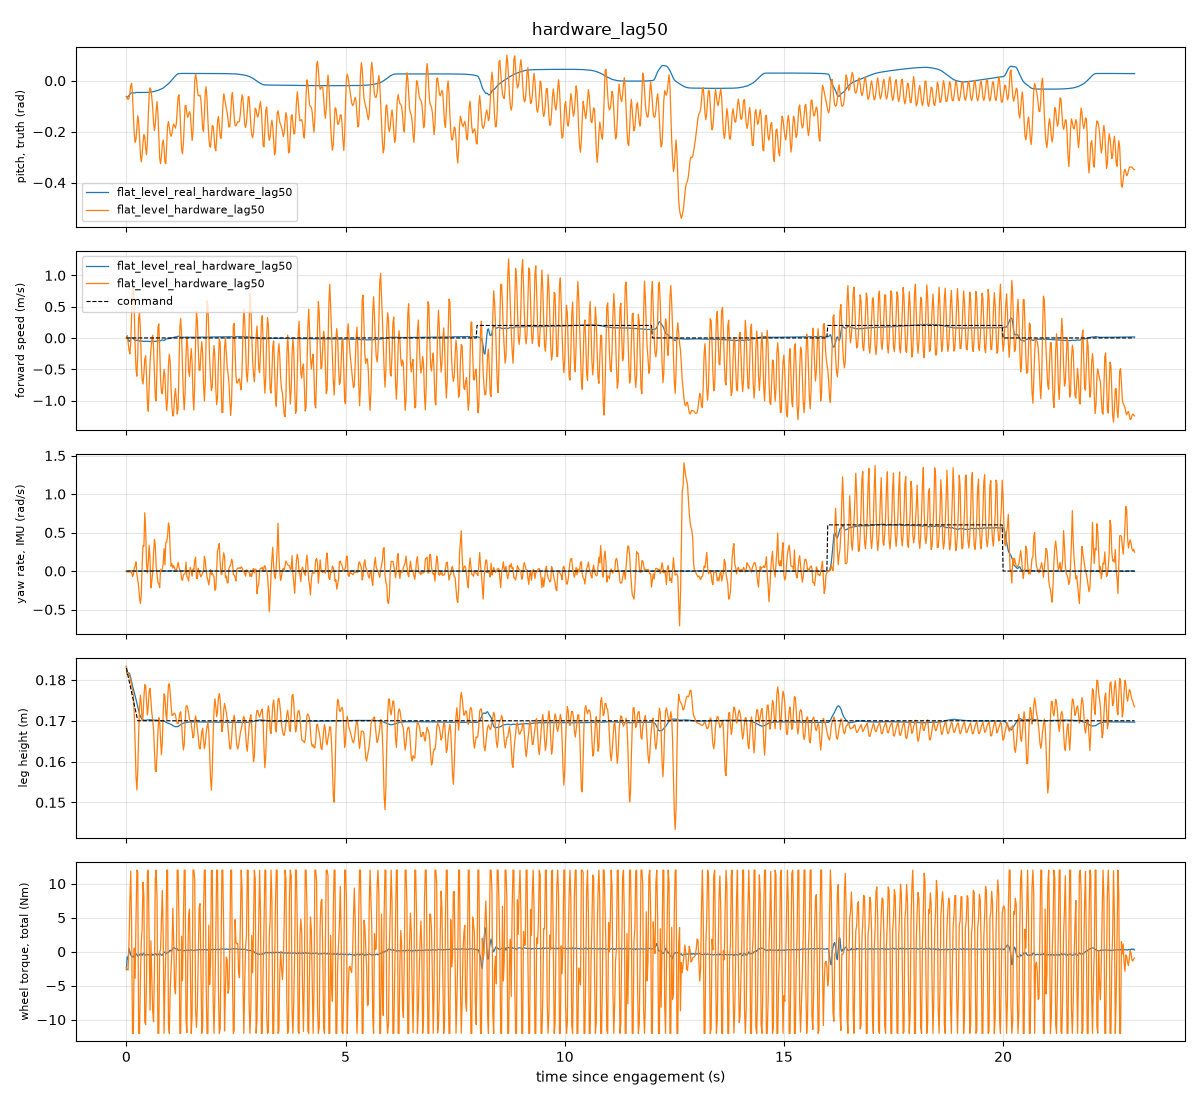
sandro_rl/policies/flat_level_real/eval/hardware_lag50.png
