A-Common-Guy/bipedale/sandro_rl/policies/flat_tracking/curves.png

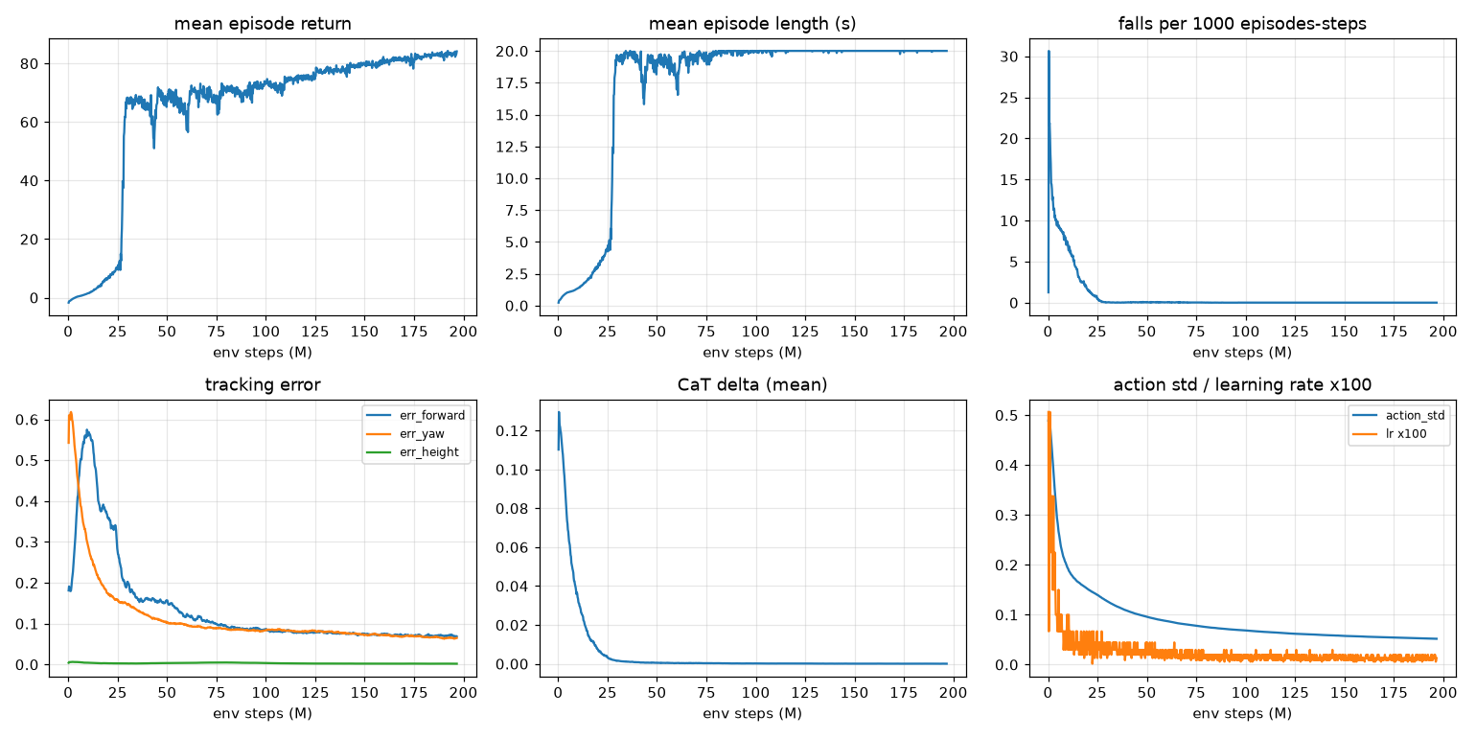
sandro_rl/policies/flat_tracking/curves.png
