A-Common-Guy/bipedale/sandro_rl/policies/flat_tracking/curves_lag.png

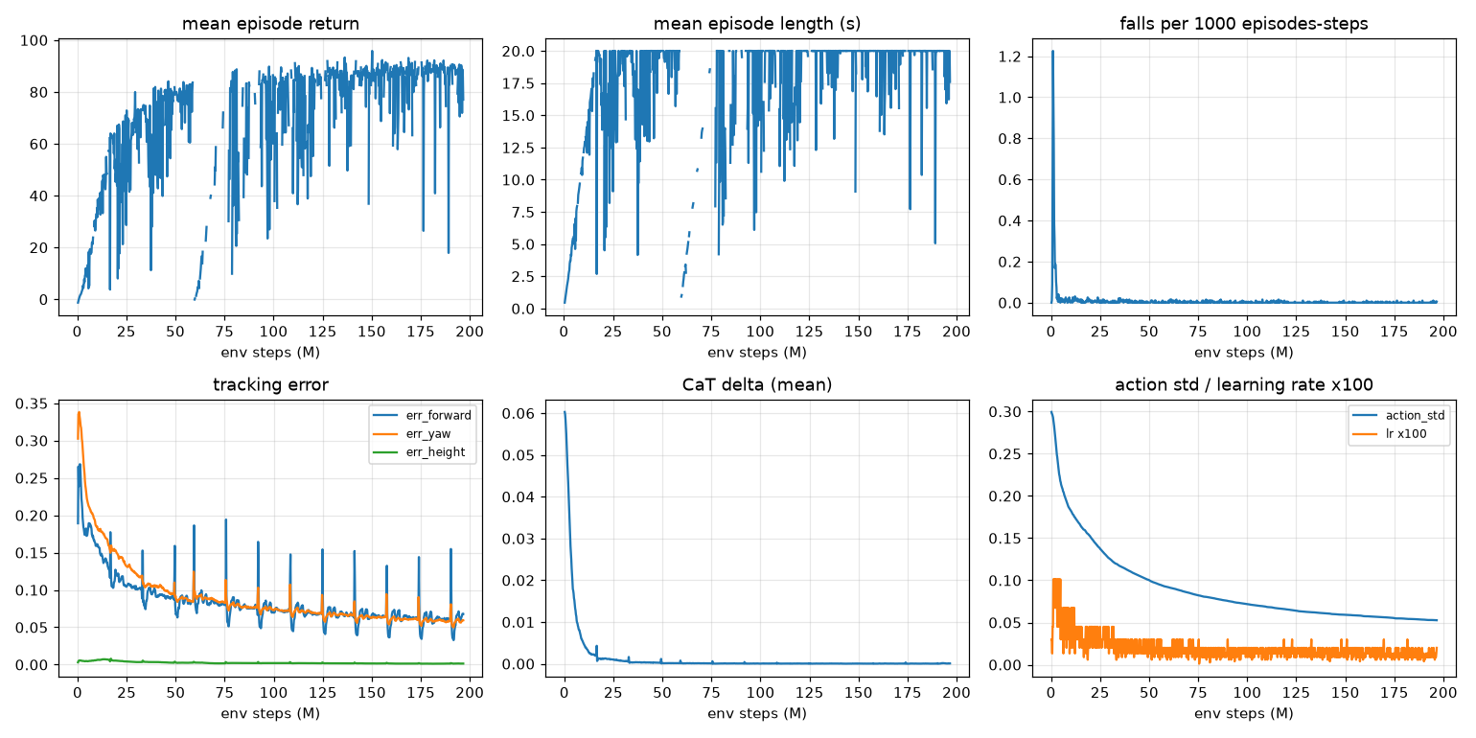
sandro_rl/policies/flat_tracking/curves_lag.png
