A-Common-Guy/bipedale/sandro_rl/policies/flat_tracking/curves_mass.png

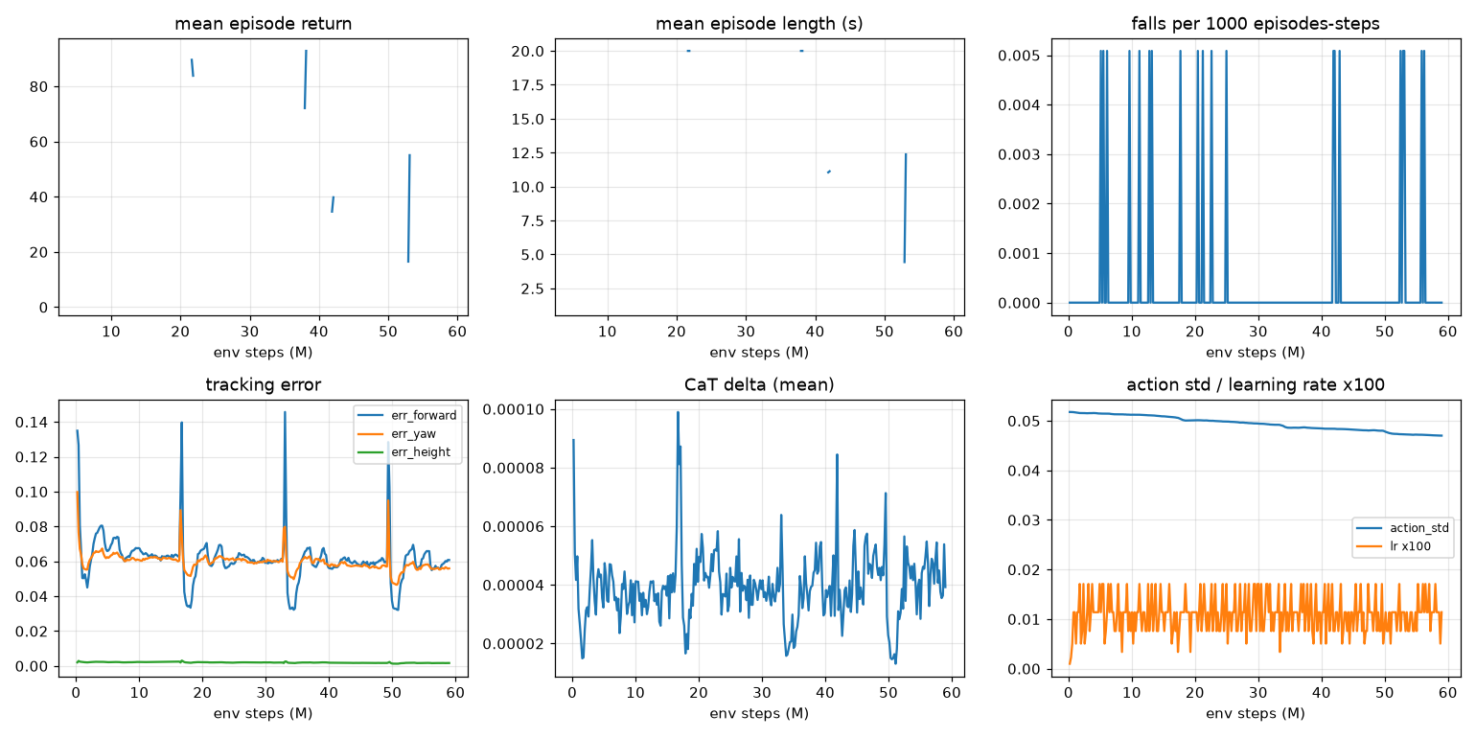
sandro_rl/policies/flat_tracking/curves_mass.png
