A-Common-Guy/bipedale/sandro_rl/policies/flat_tracking/eval/default_uart_imu.png

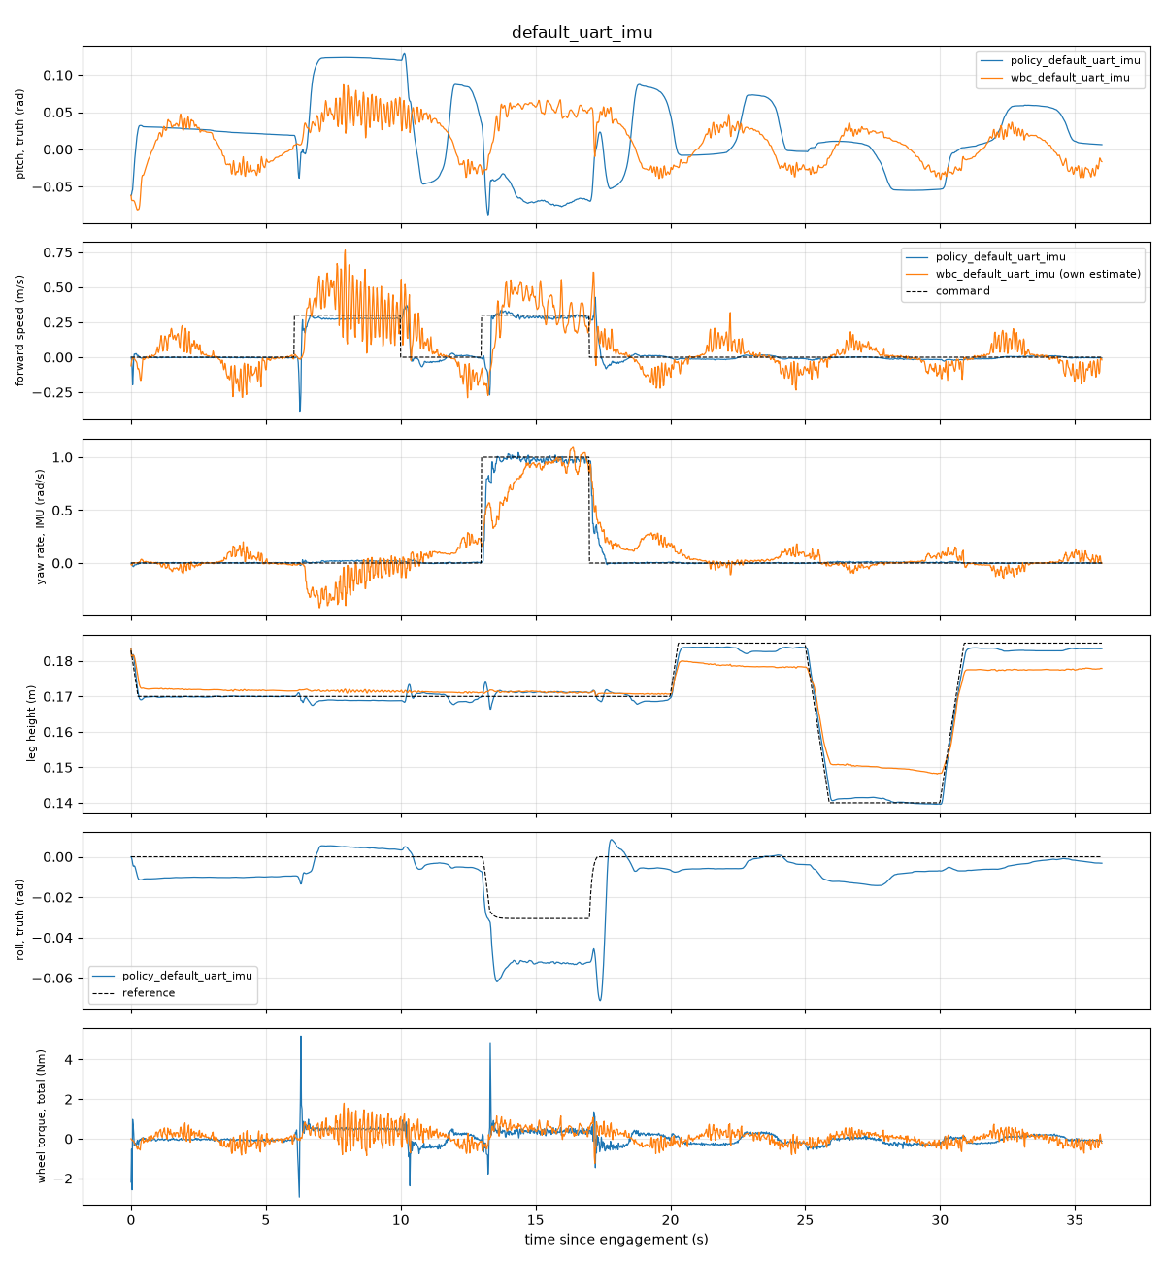
sandro_rl/policies/flat_tracking/eval/default_uart_imu.png
