A-Common-Guy/bipedale/sandro_rl/policies/flat_tracking/eval/hardware_nominal.png

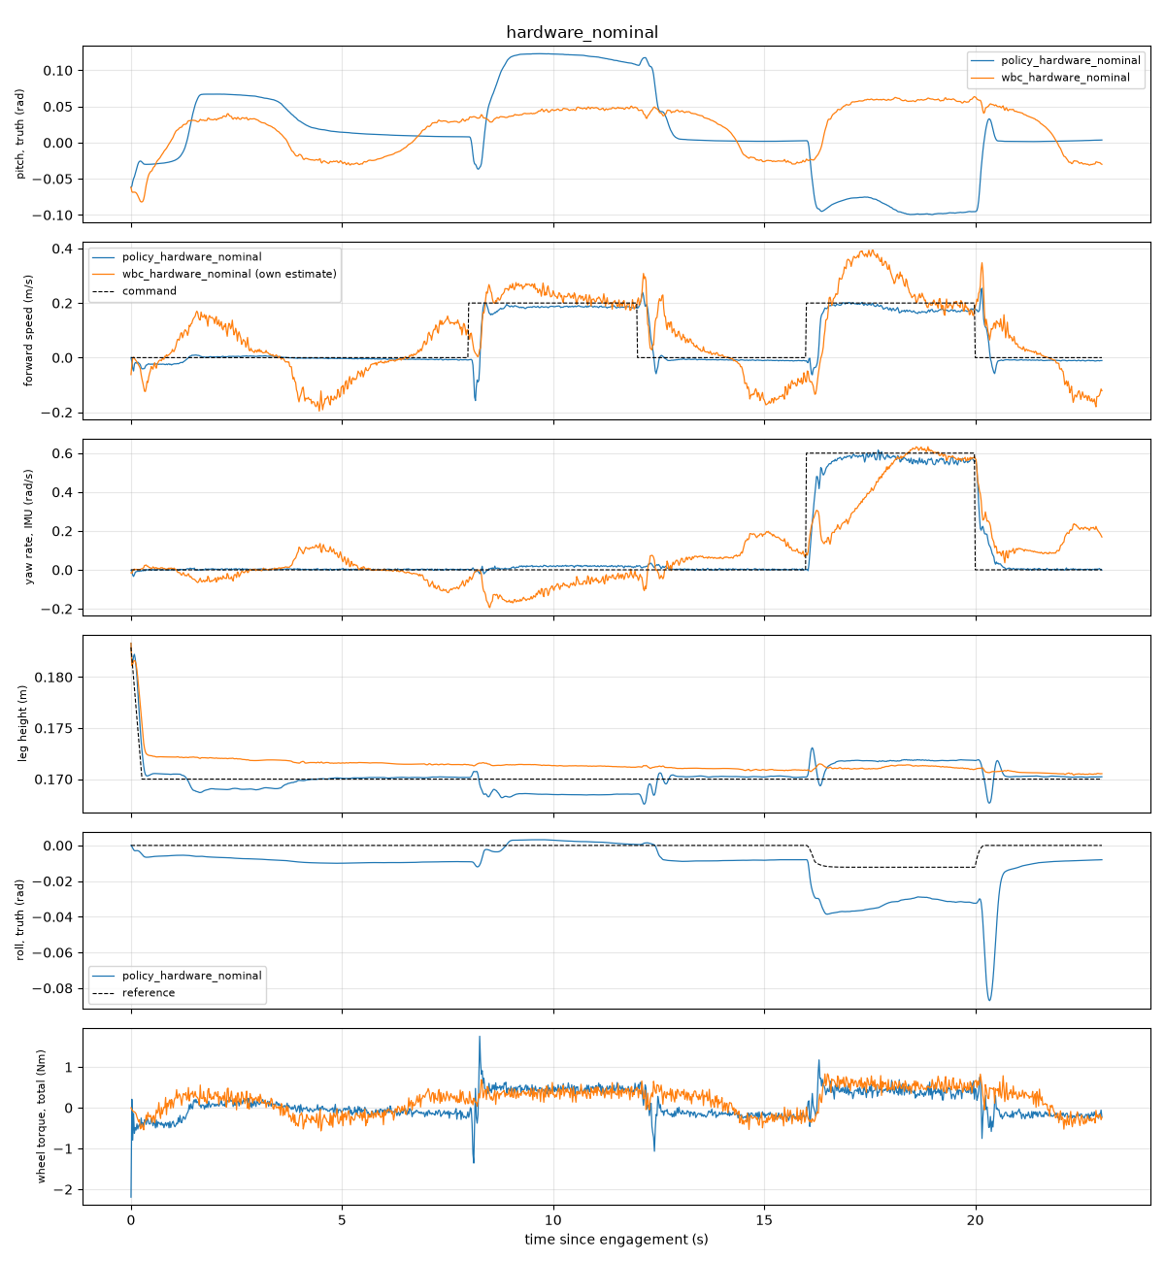
sandro_rl/policies/flat_tracking/eval/hardware_nominal.png
