A-Common-Guy/bipedale/sandro_rl/policies/flat_tracking_fpo/curves.png

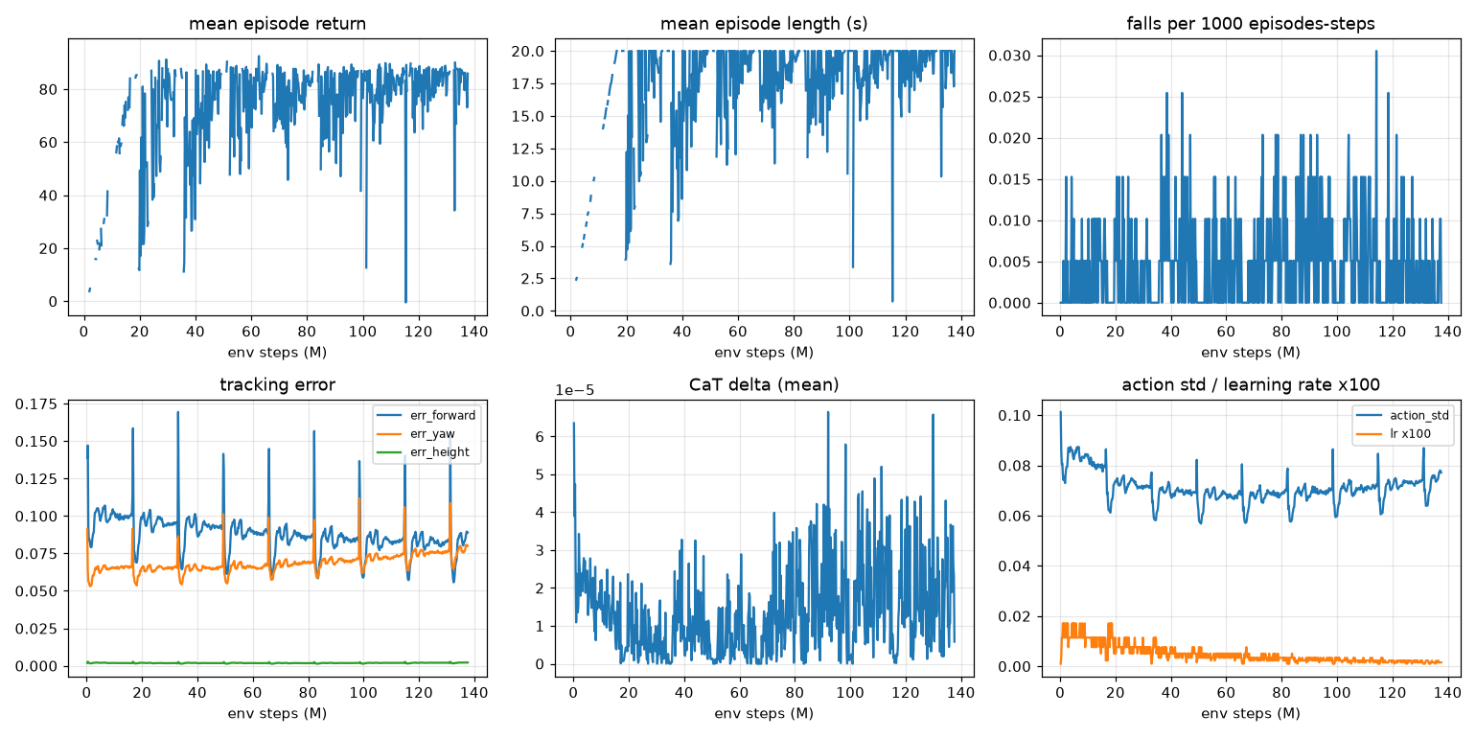
sandro_rl/policies/flat_tracking_fpo/curves.png
