A-Common-Guy/bipedale/sandro_rl/policies/flat_tracking_ppo/curves.png

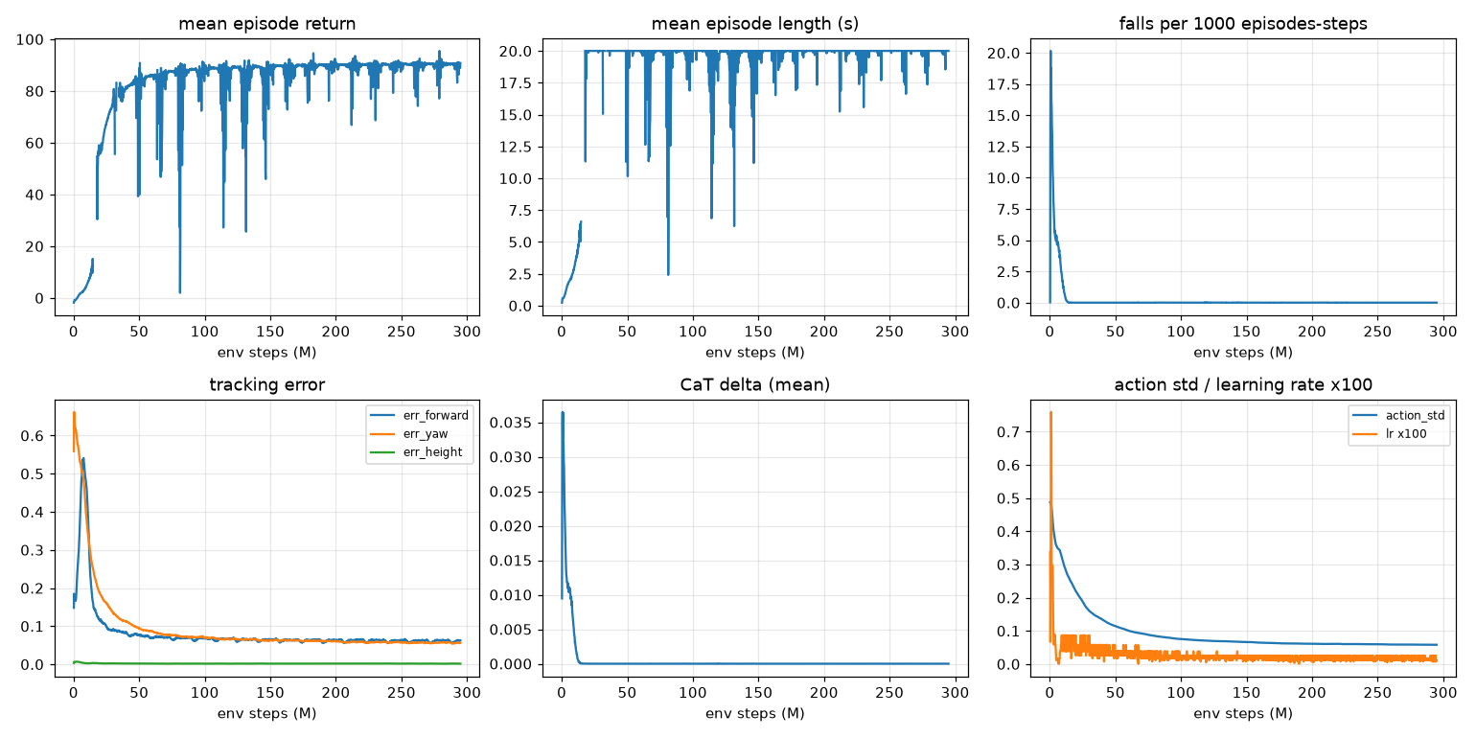
sandro_rl/policies/flat_tracking_ppo/curves.png
