A-Common-Guy/bipedale/sandro_rl/policies/jump/curves.png

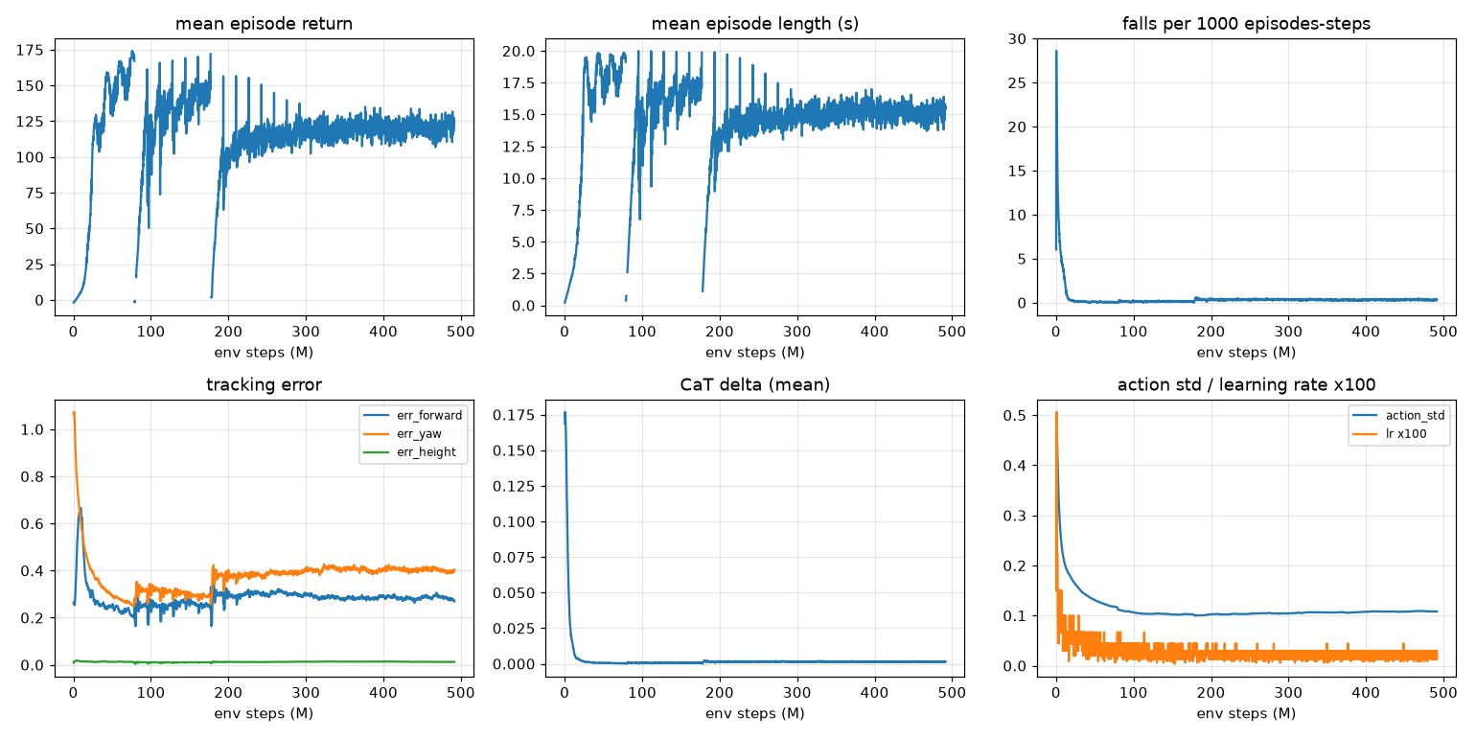
sandro_rl/policies/jump/curves.png
