A-Common-Guy/bipedale/sandro_rl/policies/jump/curves_lag.png

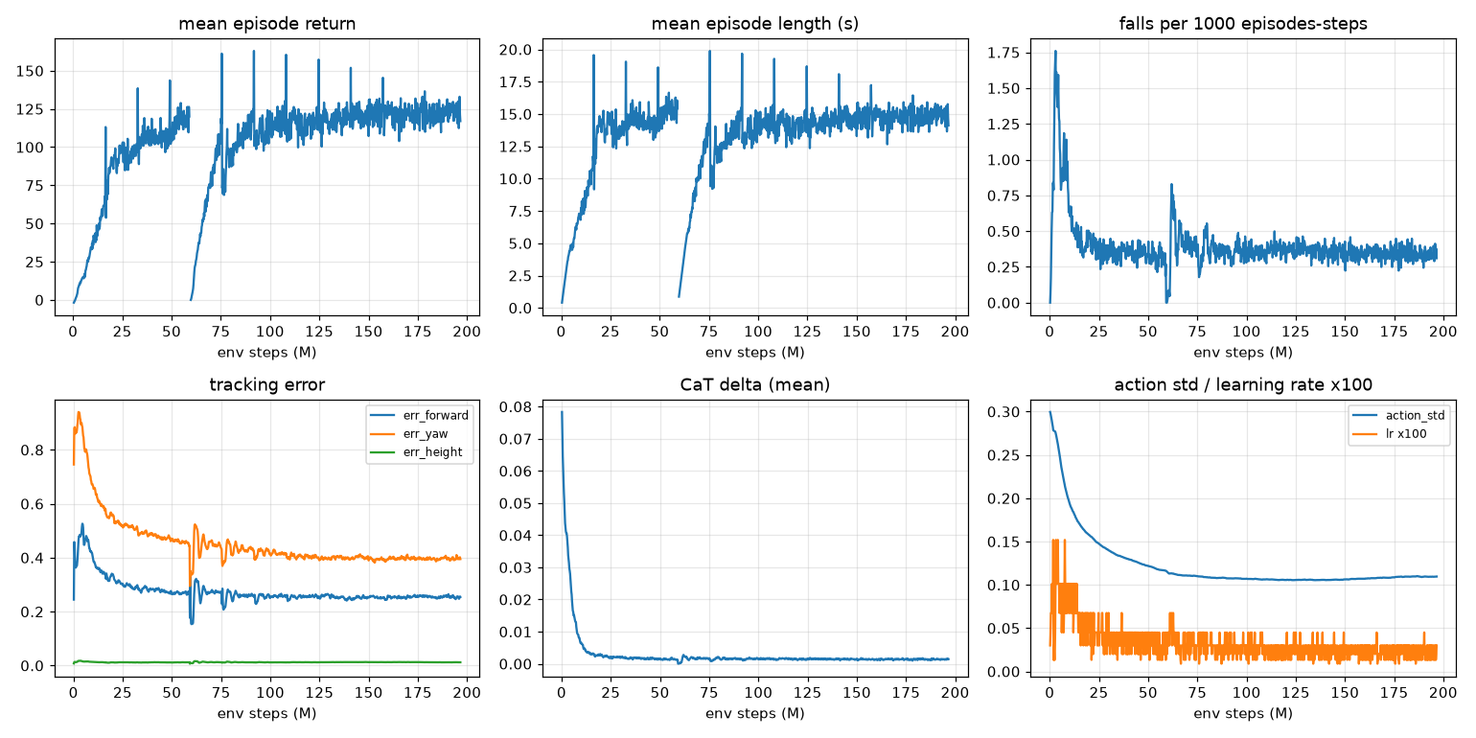
sandro_rl/policies/jump/curves_lag.png
