A-Common-Guy/bipedale/sandro_rl/policies/jump/curves_mass.png

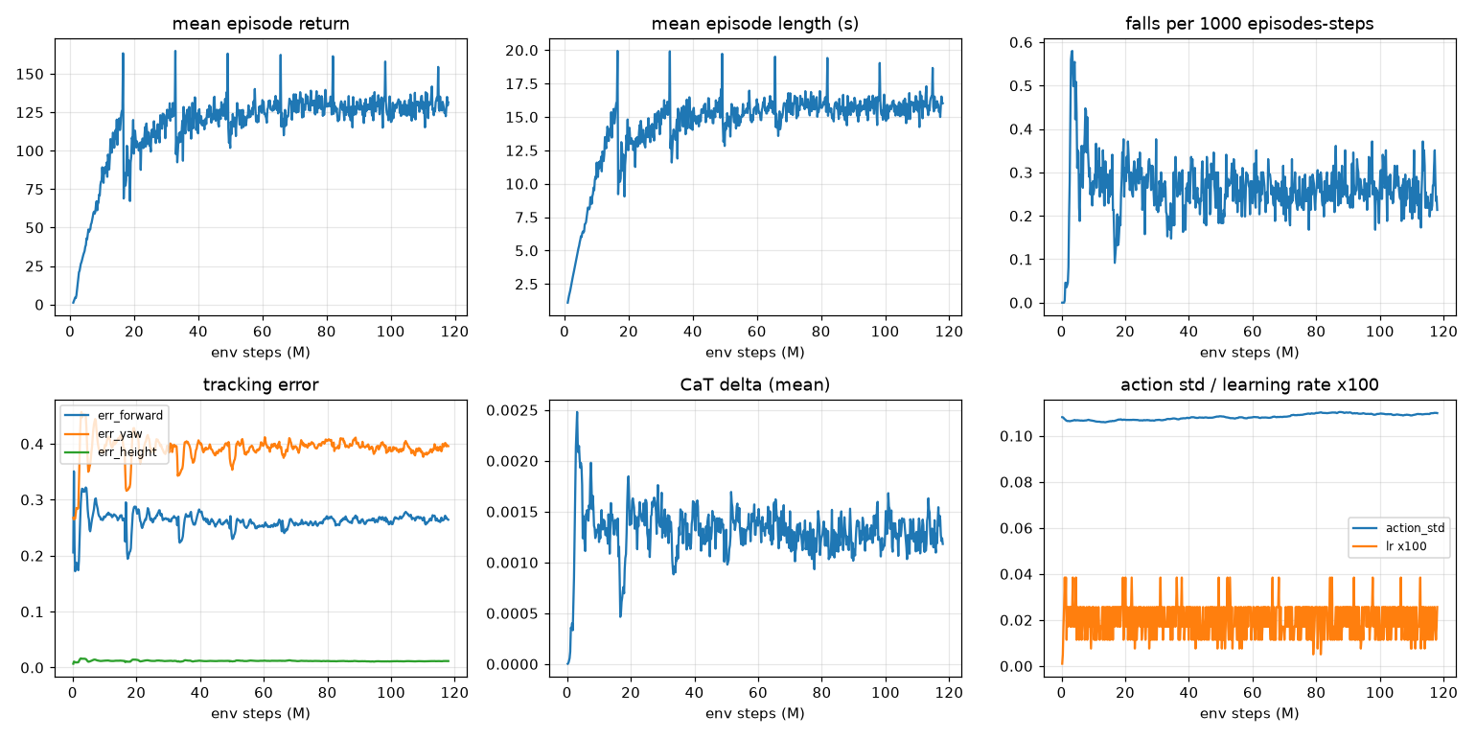
sandro_rl/policies/jump/curves_mass.png
