A-Common-Guy/bipedale/sandro_rl/policies/jump/eval/jump.png

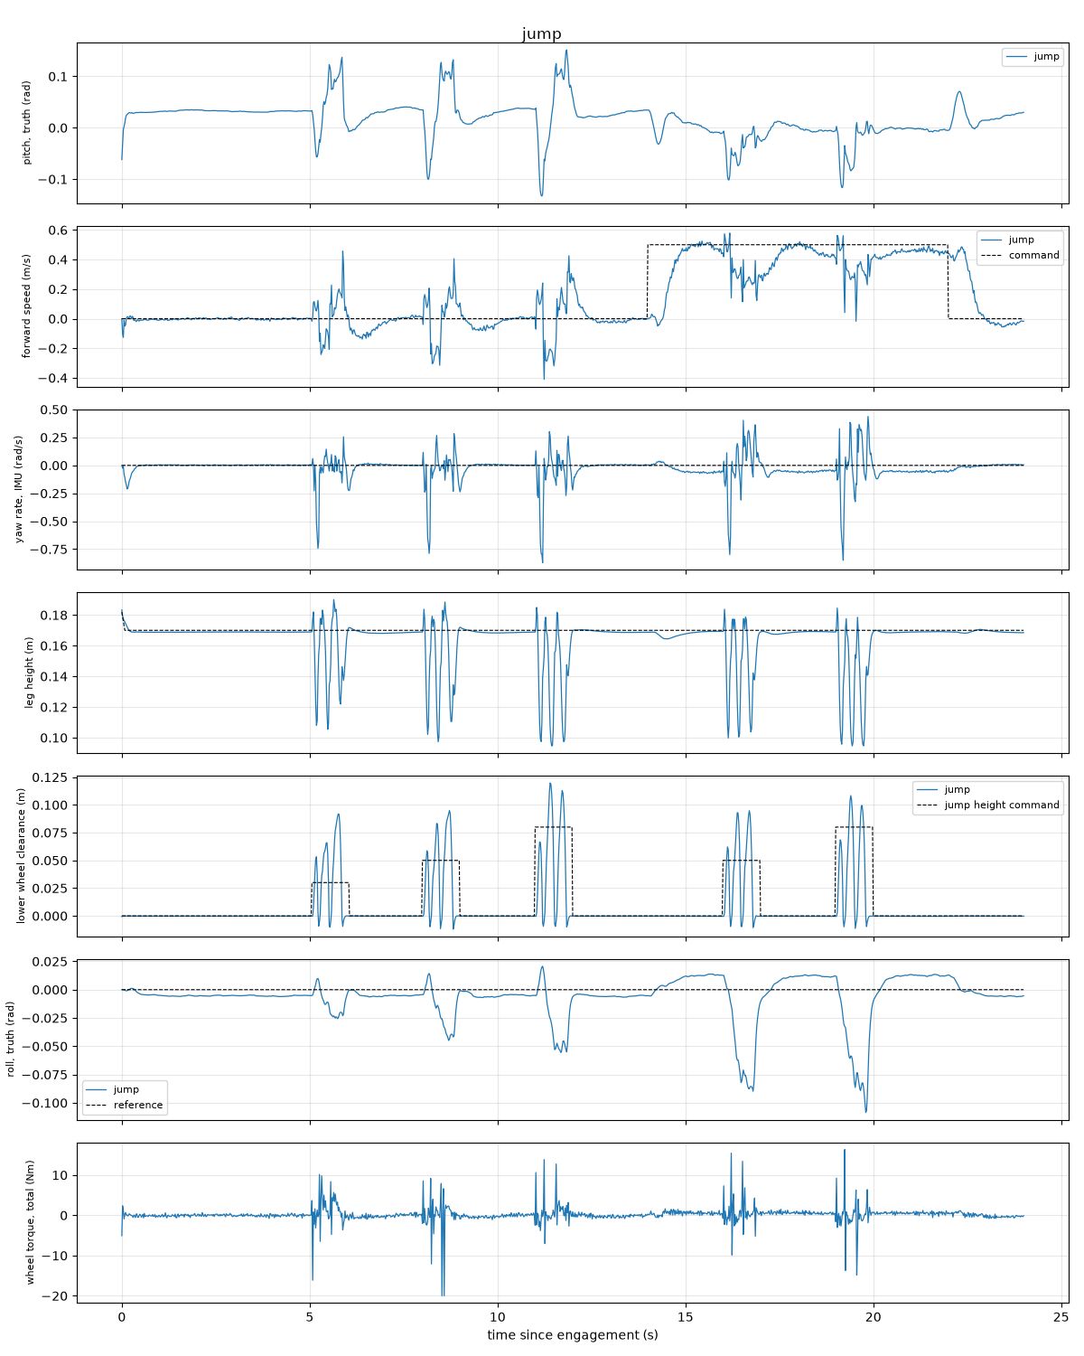
sandro_rl/policies/jump/eval/jump.png
