A-Common-Guy/bipedale/sandro_rl/policies/jump/eval/jump_frames.png

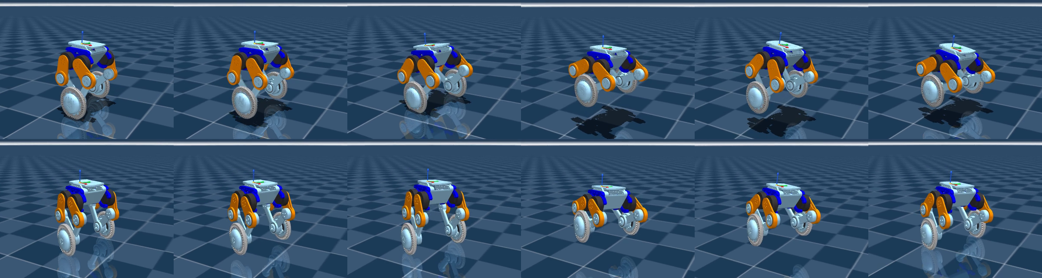
sandro_rl/policies/jump/eval/jump_frames.png
