A-Common-Guy/bipedale/sandro_rl/policies/stand_up/curves.png

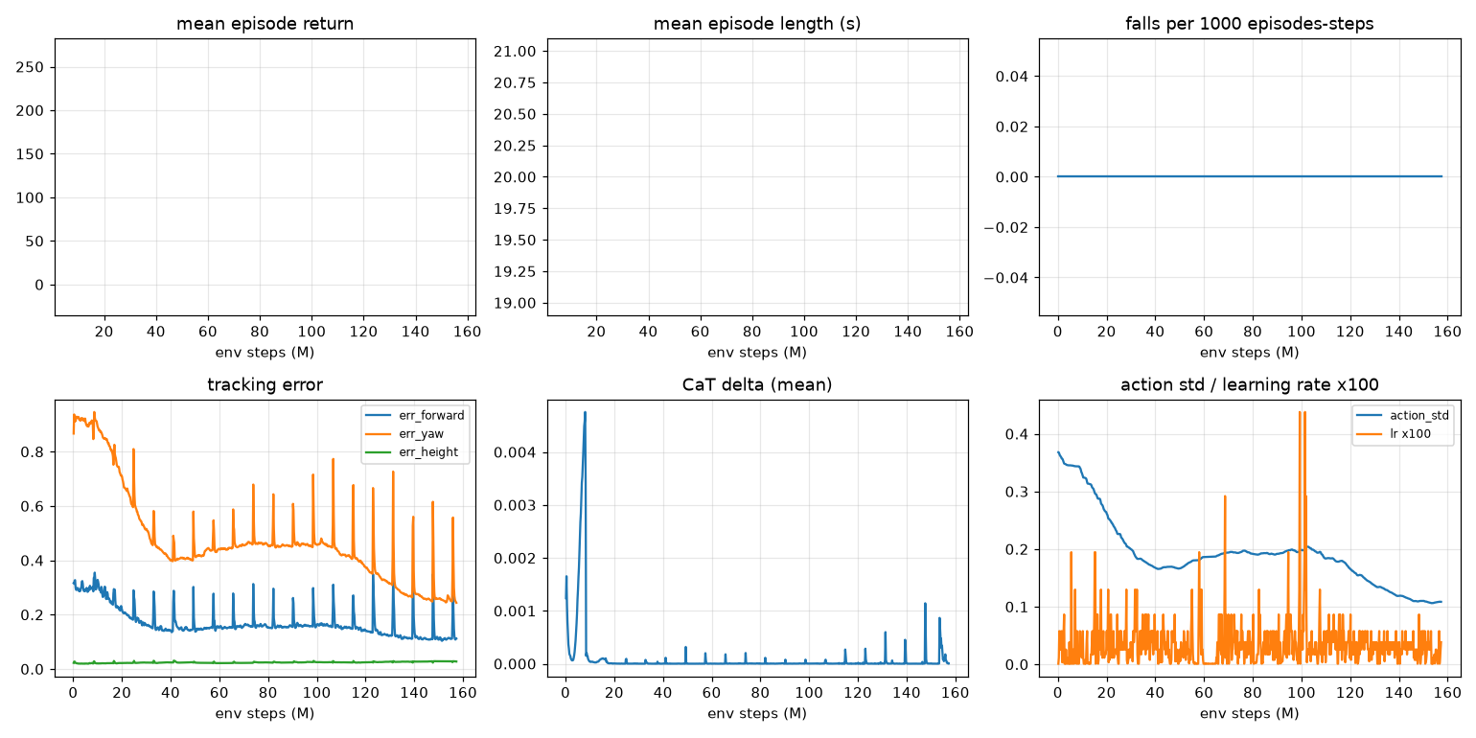
sandro_rl/policies/stand_up/curves.png
