A-Common-Guy/bipedale/sandro_rl/policies/stand_up/curves_body2611.png

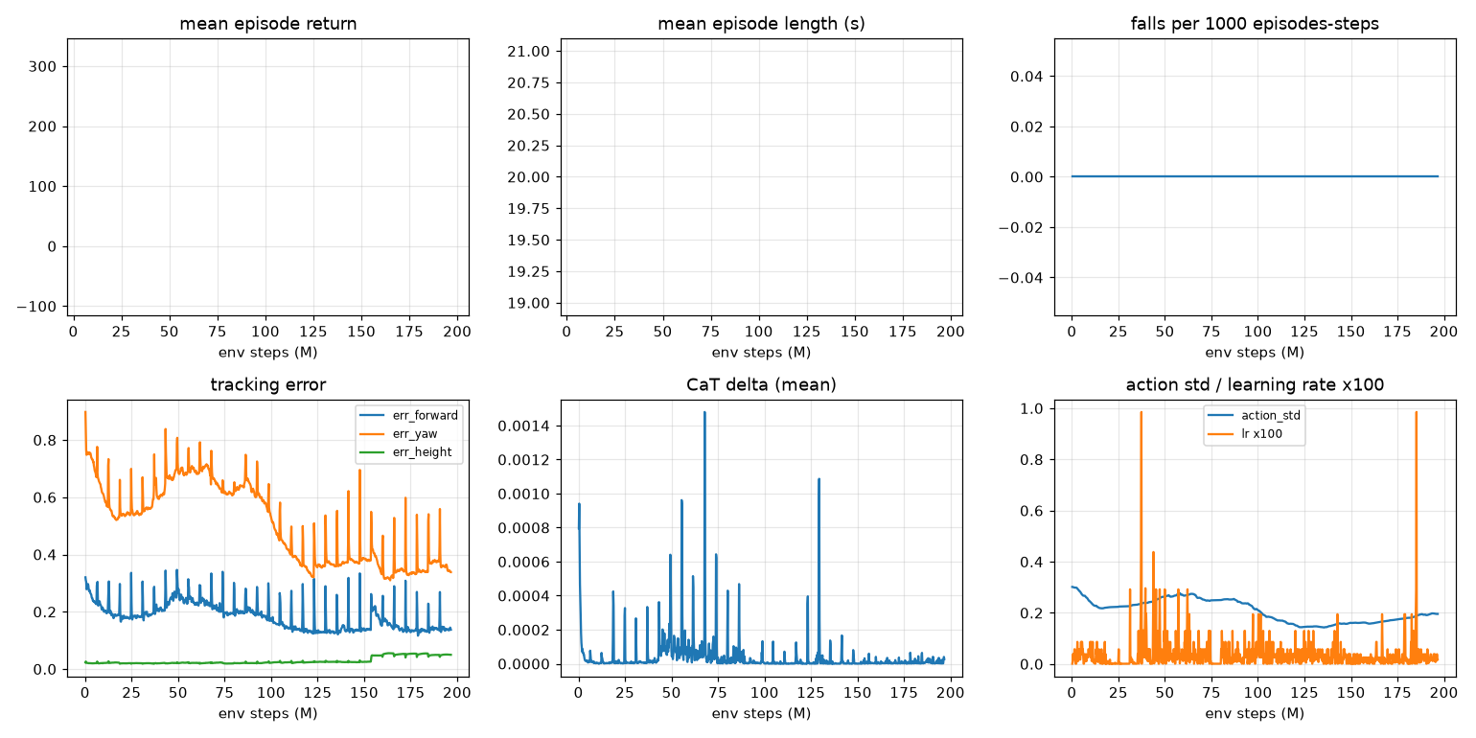
sandro_rl/policies/stand_up/curves_body2611.png
