A-Common-Guy/bipedale/sandro_rl/policies/stand_up/curves_lag.png

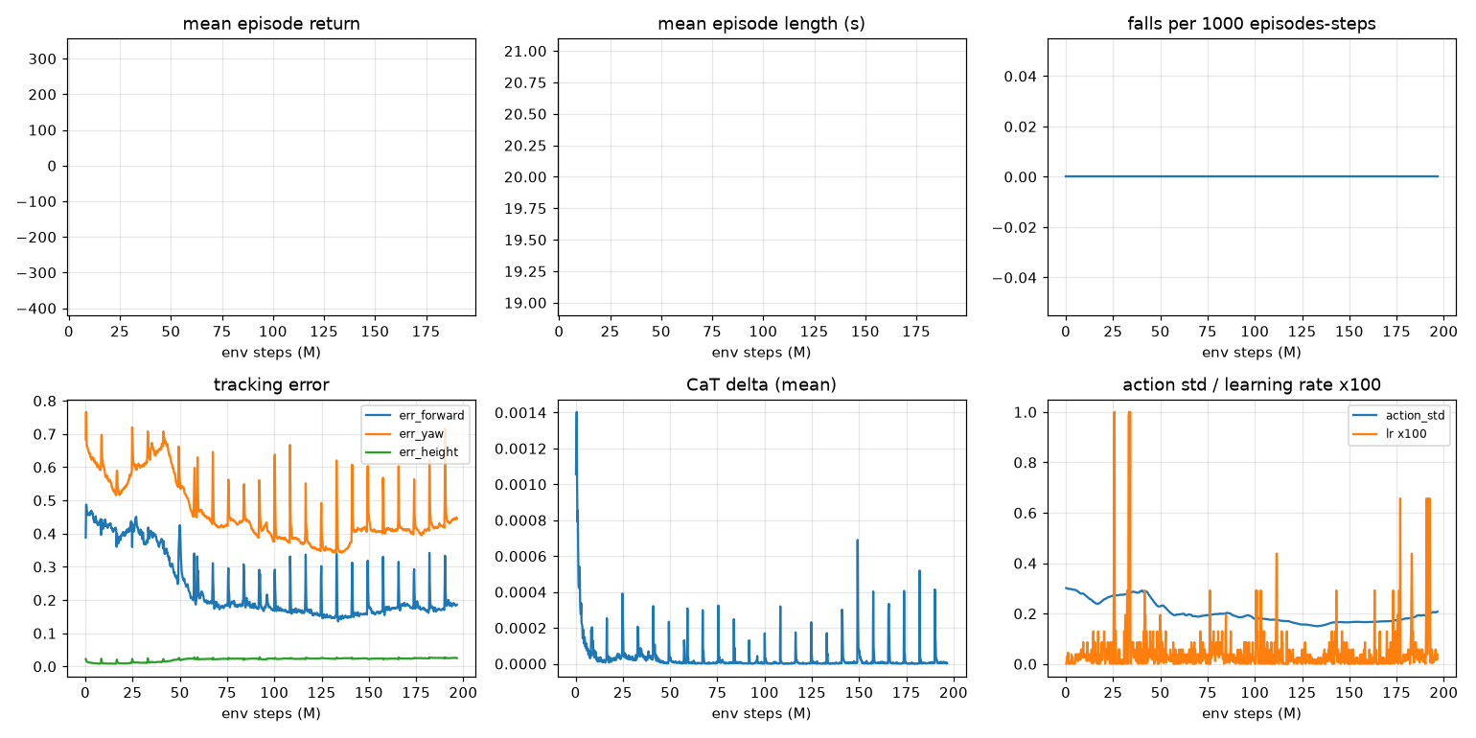
sandro_rl/policies/stand_up/curves_lag.png
