A-Common-Guy/bipedale/sandro_rl/policies/stand_up/eval/stand_up_front_frames.png

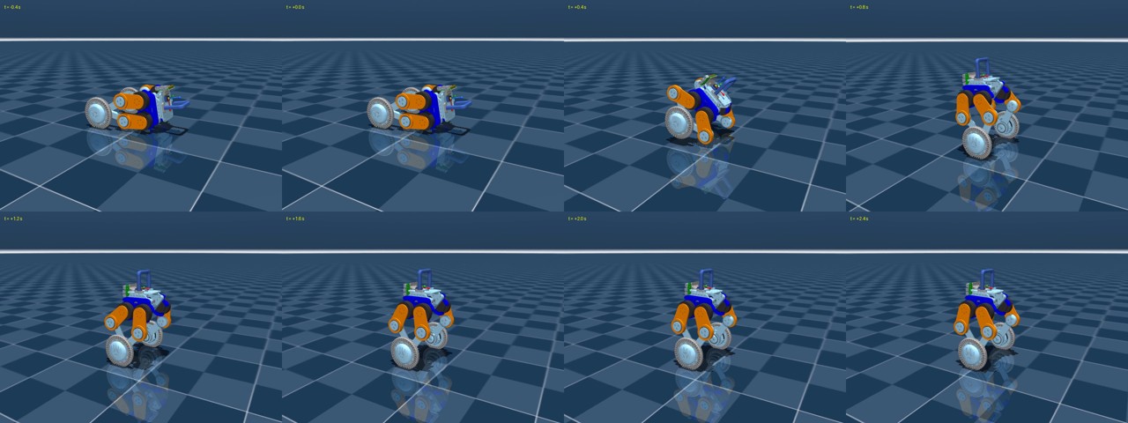
sandro_rl/policies/stand_up/eval/stand_up_front_frames.png
