A-Common-Guy/bipedale/3d_models/biella - Biella.stl

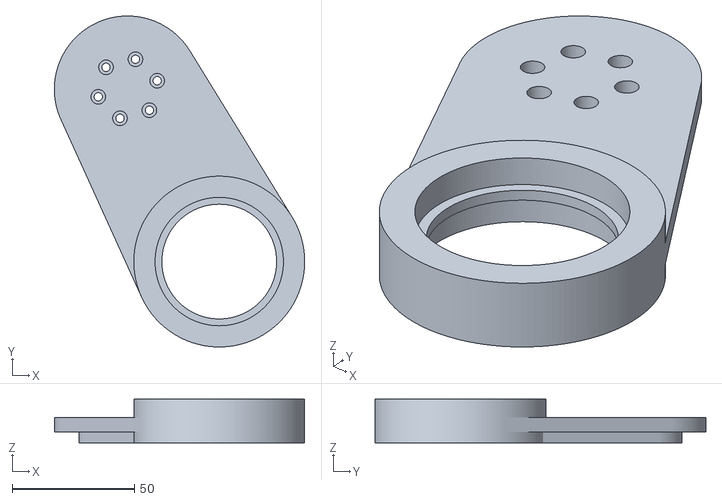
[picture p34: CAD file, 2026-09-20]
3d_models/biella - Biella.stl
102.6 x 135.6 x 18.0
