A-Common-Guy/bipedale/onshape_export/leg/assets/wheel_tire_holder.stl

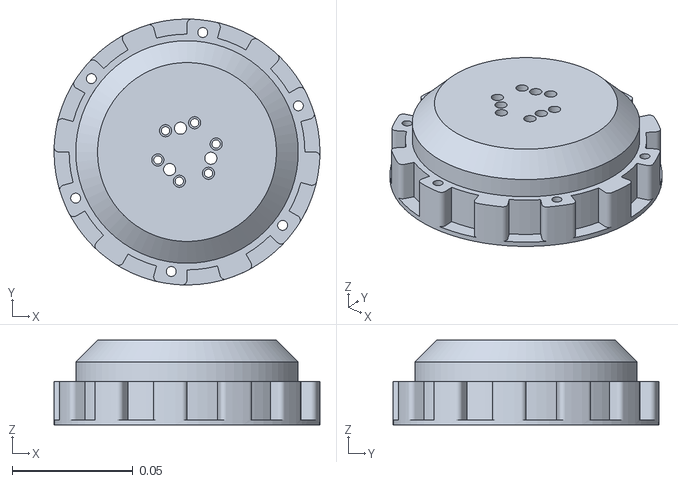
[picture p35: CAD file, 2026-11-06]
onshape_export/leg/assets/wheel_tire_holder.stl
0.11 x 0.11 x 0.035
