A-Common-Guy/bipedale/onshape_export/leg_left/assets/wheelmotorhub.stl

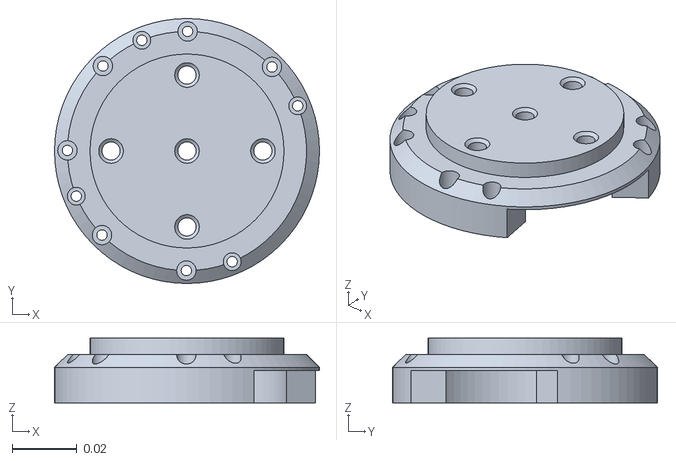
[picture p36: CAD file, 2026-11-06]
onshape_export/leg_left/assets/wheelmotorhub.stl
0.082 x 0.082 x 0.02
