A-Common-Guy/bipedale/onshape_export/robot/assets/2_54_mm_dupont_male_pin_header__io__2x20__rpi4modelb__imported25.stl

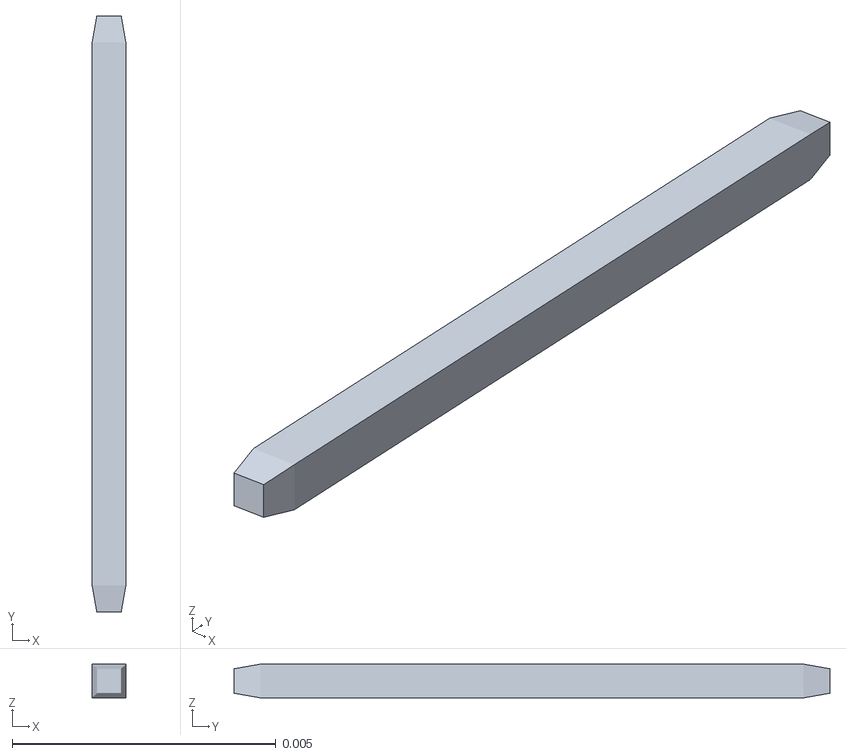
[picture p37: CAD file, 2026-11-06]
onshape_export/robot/assets/2_54_mm_dupont_male_pin_header__io__2x20__rpi4modelb__imported25.stl
0.00064 x 0.0113 x 0.00064
