A-Common-Guy/bipedale/3d_models/wheel_mock - wheel hub.stl

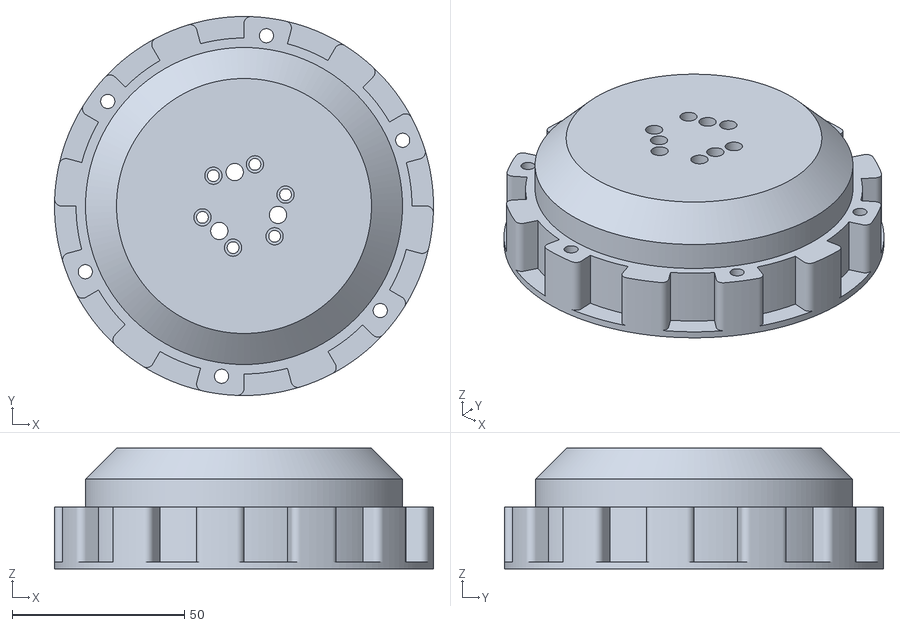
[picture p38: CAD file, 2026-09-20]
3d_models/wheel_mock - wheel hub.stl
110.0 x 110.0 x 35.0
