A-Common-Guy/bipedale/onshape_export/leg/assets/motor_shaft_2.stl

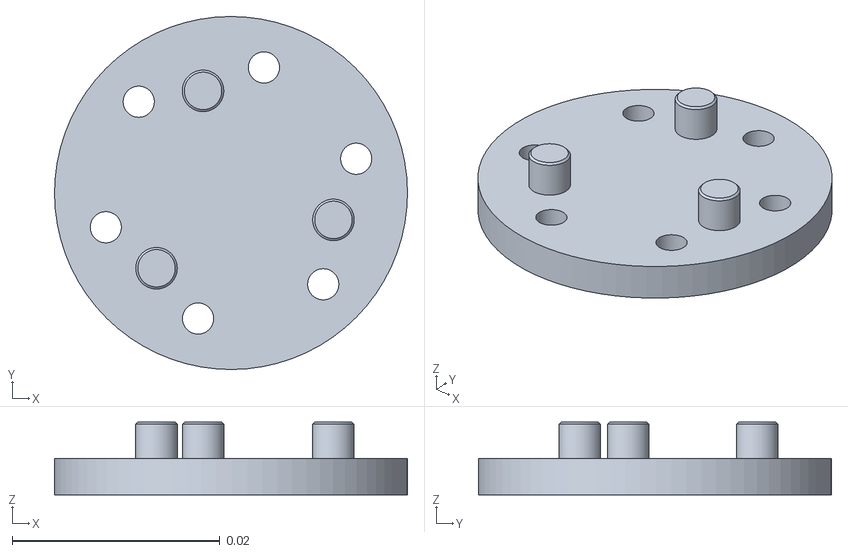
[picture p39: CAD file, 2026-11-06]
onshape_export/leg/assets/motor_shaft_2.stl
0.034 x 0.034 x 0.007
