A-Common-Guy/bipedale/onshape_export/leg_left/assets/tire.stl

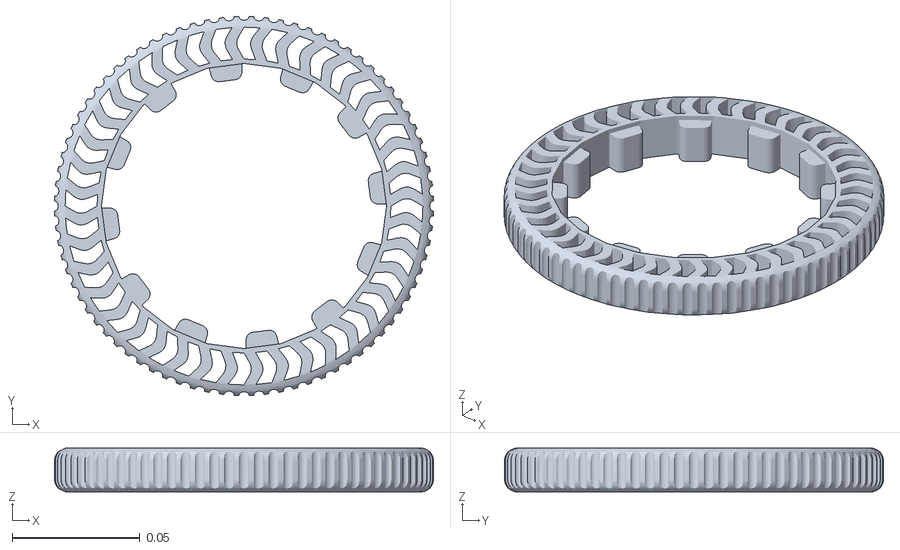
[picture p40: CAD file, 2026-11-06]
onshape_export/leg_left/assets/tire.stl
0.148 x 0.148 x 0.0172
