A-Common-Guy/bipedale/onshape_export/robot/assets/sd_card_slot__rpi4modelb__imported8.stl

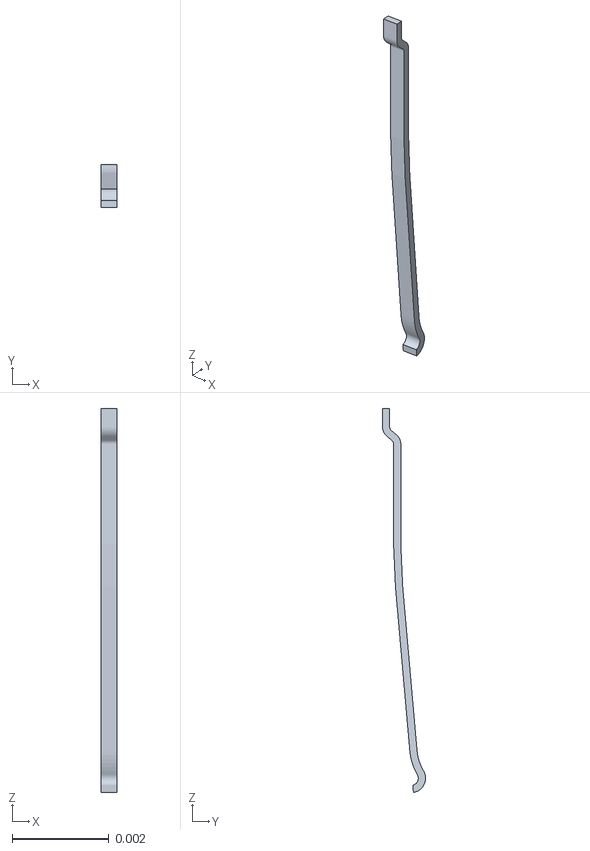
[picture p41: CAD file, 2026-11-06]
onshape_export/robot/assets/sd_card_slot__rpi4modelb__imported8.stl
0.00034 x 0.000892 x 0.00795
