A-Common-Guy/bipedale/ros2_ws/src/sandro_description/mjcf/assets/handle.stl

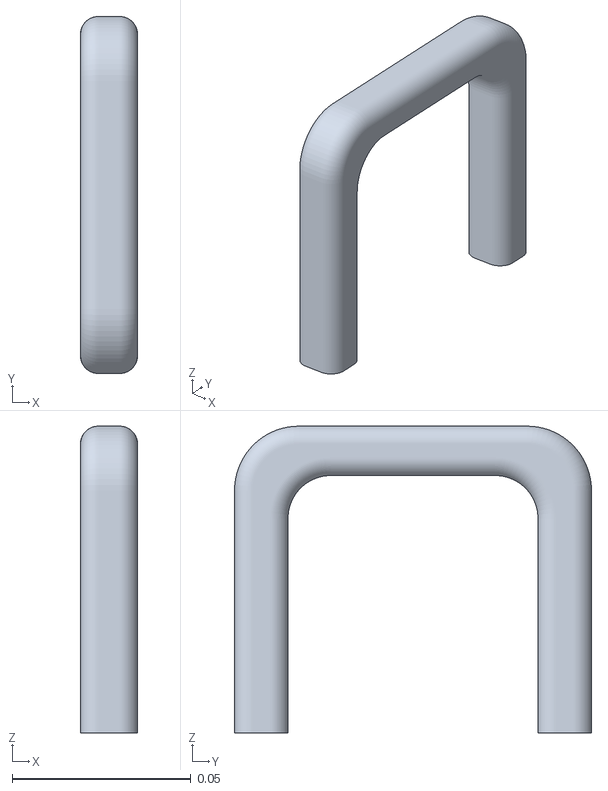
[picture p42: CAD file, 2026-11-06]
ros2_ws/src/sandro_description/mjcf/assets/handle.stl
0.016 x 0.1 x 0.0859
