A-Common-Guy/bipedale/3d_models/body_motor_holder - BodyMotorHolder (1).3mf

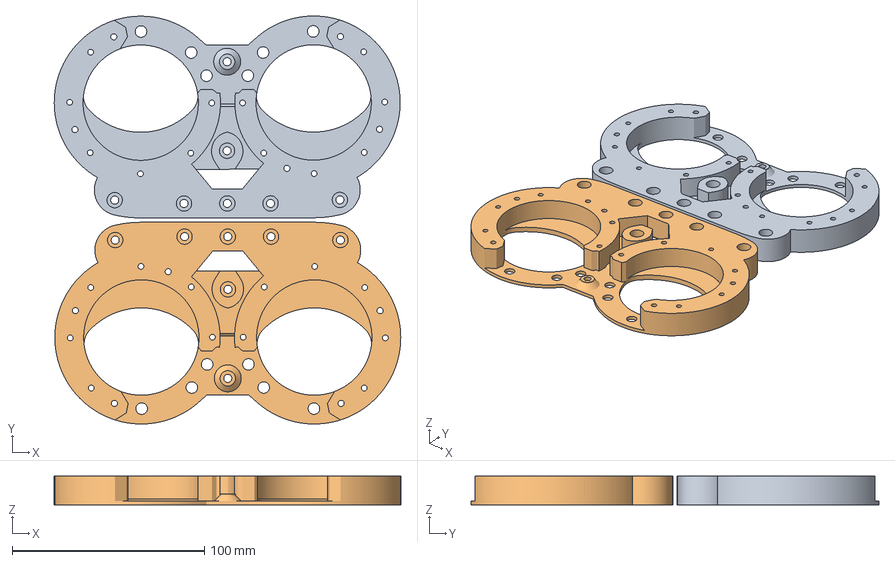
[picture p43: CAD file, 2026-09-20]
3d_models/body_motor_holder - BodyMotorHolder (1).3mf
180.3 x 212.3 x 15.0 mm
