A-Common-Guy/bipedale/onshape_export/leg/assets/manovella2.stl

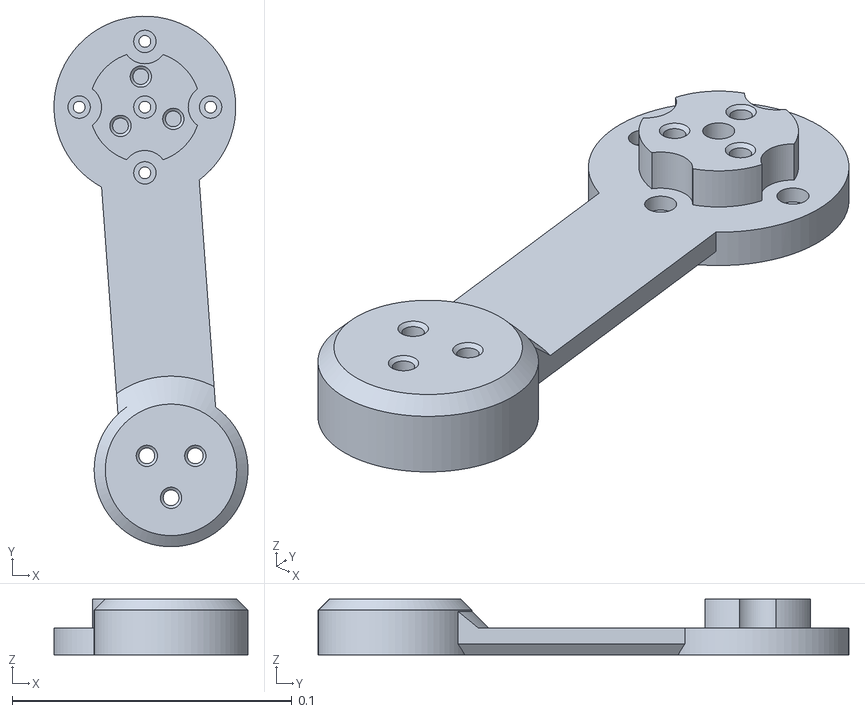
[picture p44: CAD file, 2026-11-06]
onshape_export/leg/assets/manovella2.stl
0.0694 x 0.19 x 0.02
