A-Common-Guy/bipedale/onshape_export/leg_left/assets/smallplate_manovella2.stl

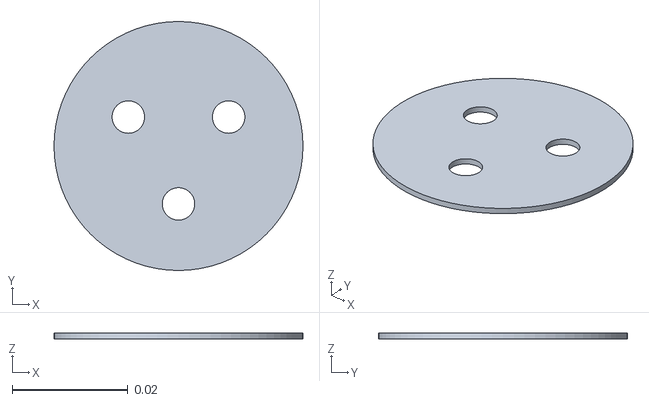
[picture p45: CAD file, 2026-11-06]
onshape_export/leg_left/assets/smallplate_manovella2.stl
0.043 x 0.043 x 0.001
