A-Common-Guy/bipedale/onshape_export/robot/assets/sot23_5_v1_1__body5.stl

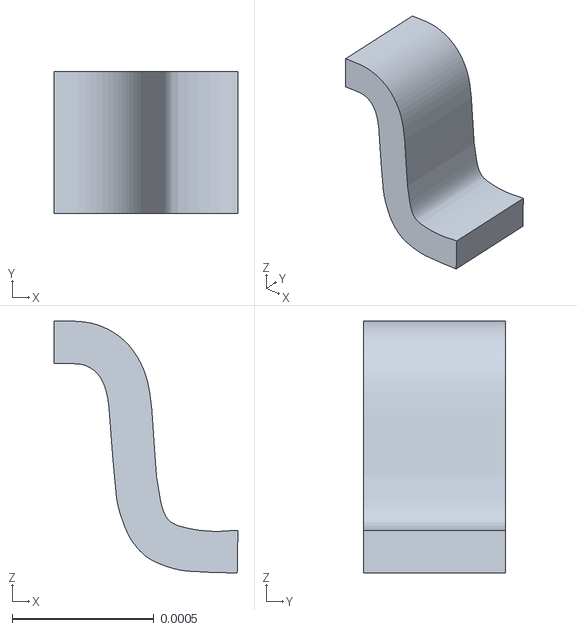
[picture p46: CAD file, 2026-11-06]
onshape_export/robot/assets/sot23_5_v1_1__body5.stl
0.00065 x 0.0005 x 0.00089
