A-Common-Guy/bipedale/3d_models/wheel stick cover - WheelStickCover.stl

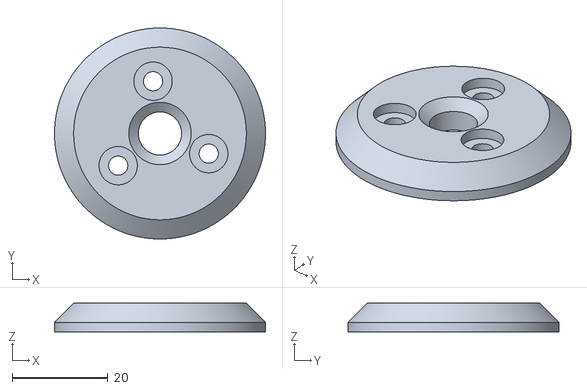
[picture p48: CAD file, 2026-09-20]
3d_models/wheel stick cover - WheelStickCover.stl
44.0 x 44.0 x 6.00
