A-Common-Guy/bipedale/onshape_export/leg/assets/bodymotorholder.stl

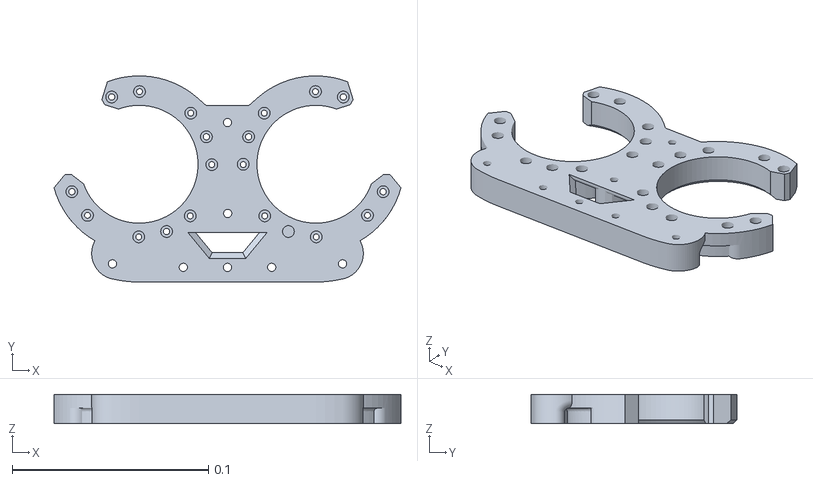
[picture p49: CAD file, 2026-09-20]
onshape_export/leg/assets/bodymotorholder.stl
0.177 x 0.105 x 0.015
