A-Common-Guy/bipedale/onshape_export/leg_left/assets/pernobiella.stl

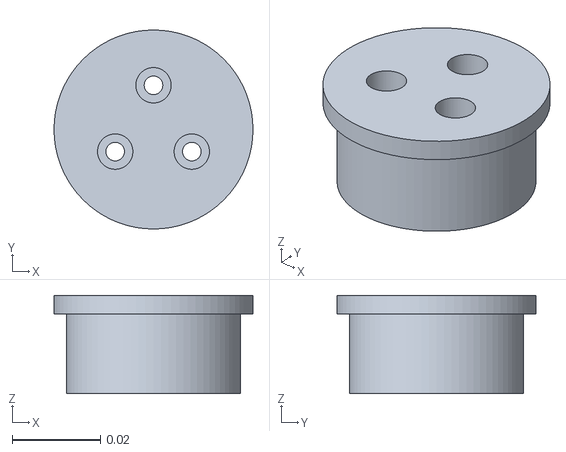
[picture p50: CAD file, 2026-11-06]
onshape_export/leg_left/assets/pernobiella.stl
0.045 x 0.045 x 0.0222
