A-Common-Guy/bipedale/onshape_export/robot/assets/2x_usb3_0_ports__rpi4modelb__imported1.stl

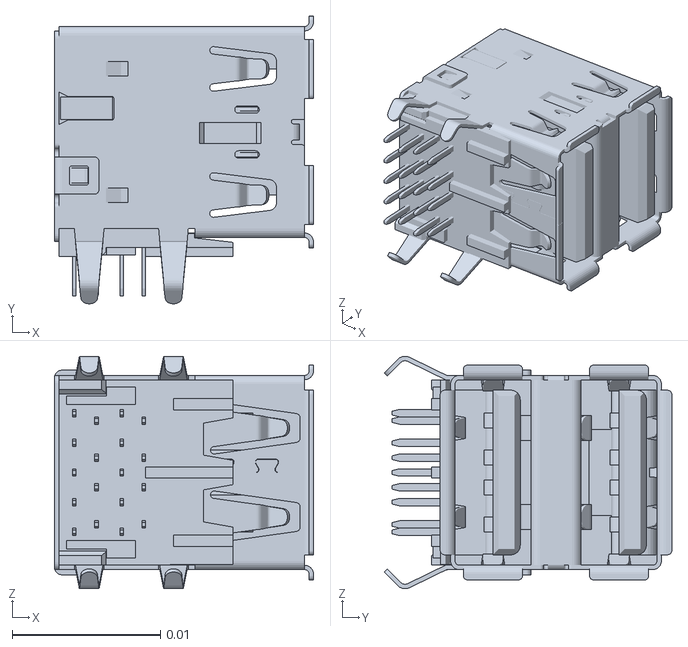
[picture p51: CAD file, 2026-11-06]
onshape_export/robot/assets/2x_usb3_0_ports__rpi4modelb__imported1.stl
0.0175 x 0.0194 x 0.0157
