A-Common-Guy/bipedale/3d_models/wheel motor hub - WheelMotorHub (1).stl

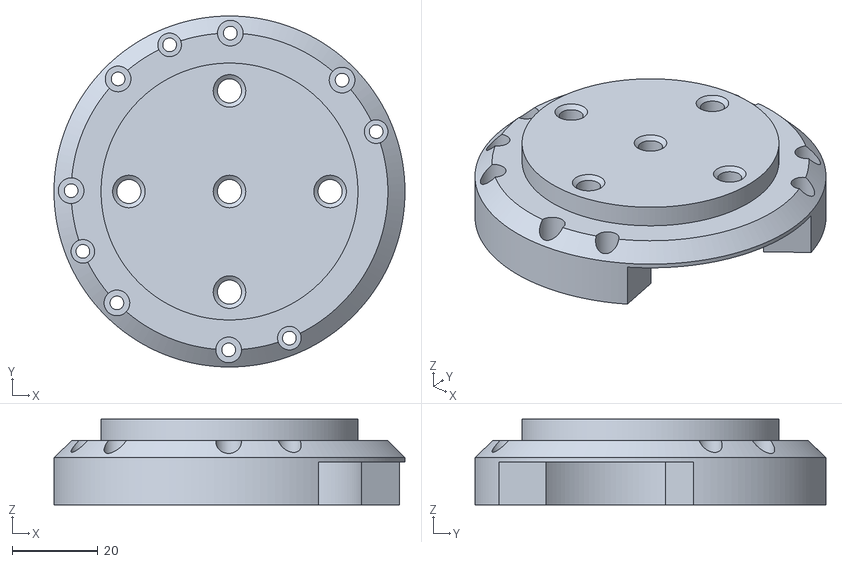
[picture p52: CAD file, 2026-09-20]
3d_models/wheel motor hub - WheelMotorHub (1).stl
82.0 x 82.0 x 20.0
