A-Common-Guy/bipedale/onshape_export/robot/assets/handle_holder_1.stl

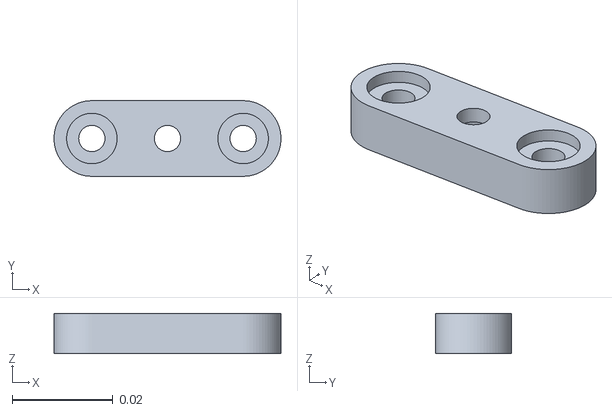
[picture p53: CAD file, 2026-11-06]
onshape_export/robot/assets/handle_holder_1.stl
0.045 x 0.015 x 0.008
