A-Common-Guy/bipedale/ros2_ws/src/sandro_description/mjcf/assets/manovella1.stl

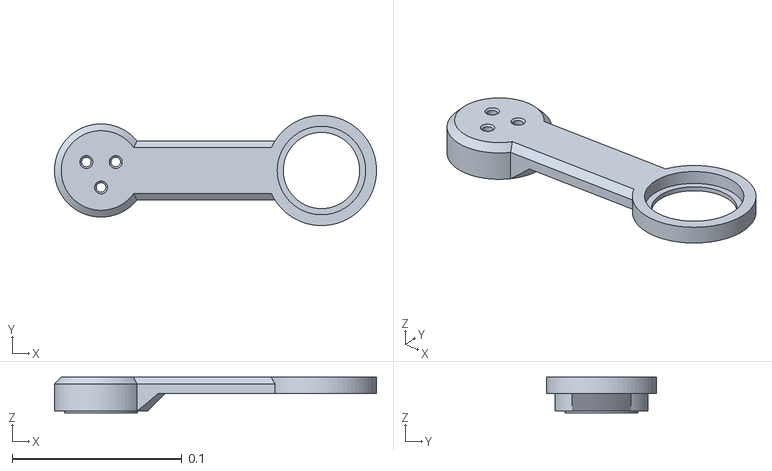
[picture p54: CAD file, 2026-11-06]
ros2_ws/src/sandro_description/mjcf/assets/manovella1.stl
0.19 x 0.0649 x 0.021
