A-Common-Guy/bipedale/3d_models/manovella 2 - Manovella2 (1).stl

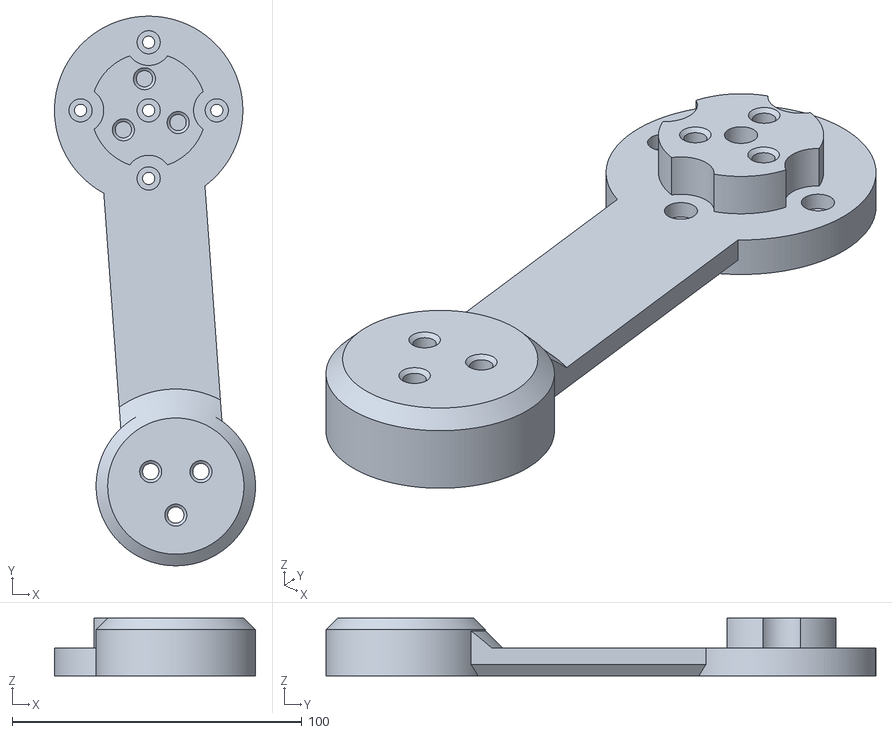
[picture p55: CAD file, 2026-09-20]
3d_models/manovella 2 - Manovella2 (1).stl
69.4 x 189.7 x 20.0
