A-Common-Guy/bipedale/ros2_ws/src/sandro_description/mjcf/assets/broadcom_bcm2711b0_cpu__rpi4modelb__top.stl

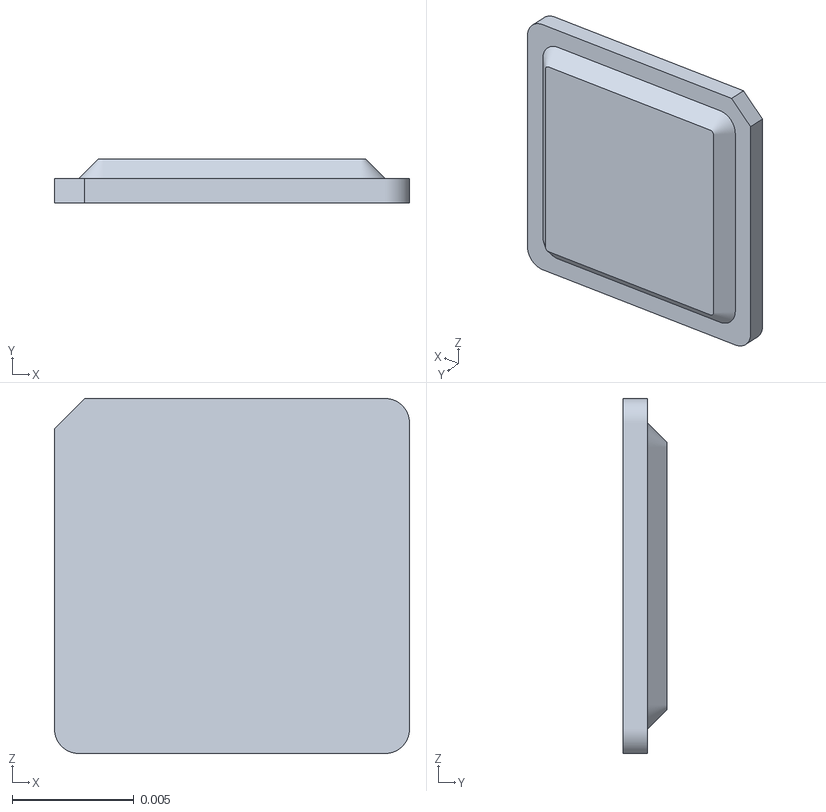
[picture p56: CAD file, 2026-11-06]
ros2_ws/src/sandro_description/mjcf/assets/broadcom_bcm2711b0_cpu__rpi4modelb__top.stl
0.0146 x 0.0018 x 0.0146
