A-Common-Guy/bipedale/3d_models/wheel_mock - Part 3.stl

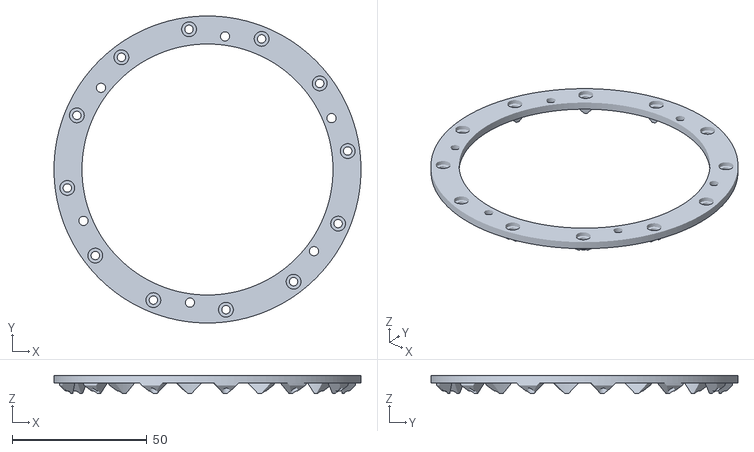
[picture p57: CAD file, 2026-09-20]
3d_models/wheel_mock - Part 3.stl
114.0 x 114.0 x 6.80
