A-Common-Guy/bipedale/onshape_export/robot/assets/rpi_holder.stl

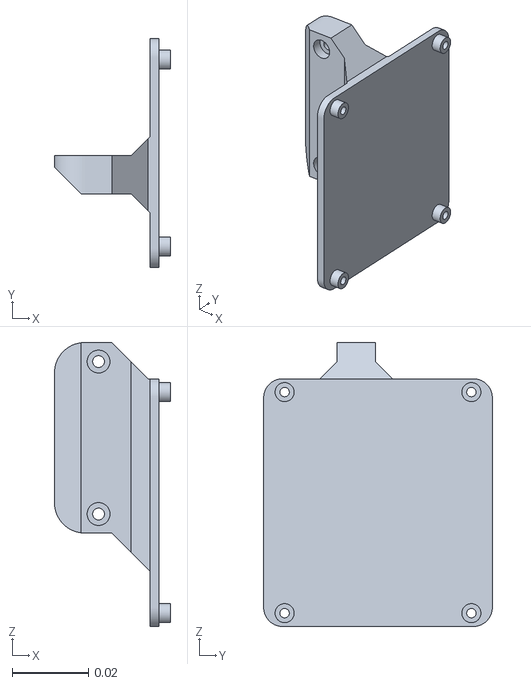
[picture p58: CAD file, 2026-11-06]
onshape_export/robot/assets/rpi_holder.stl
0.0305 x 0.06 x 0.0745
