A-Common-Guy/bipedale/3d_models/manovella 2 - Smallplate_manovella2.stl

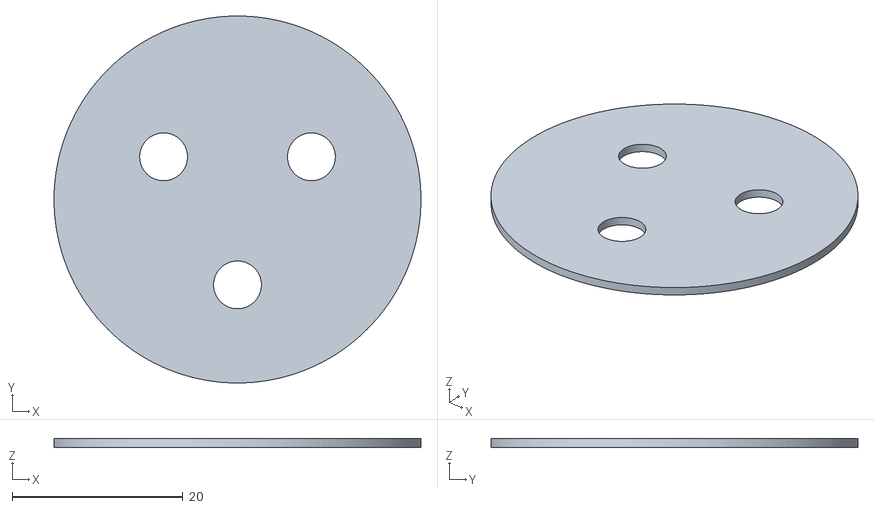
[picture p59: CAD file, 2026-09-20]
3d_models/manovella 2 - Smallplate_manovella2.stl
43.0 x 43.0 x 1.00
