A-Common-Guy/bipedale/onshape_export/robot/assets/camera_connector__rpi4modelb__imported8.stl

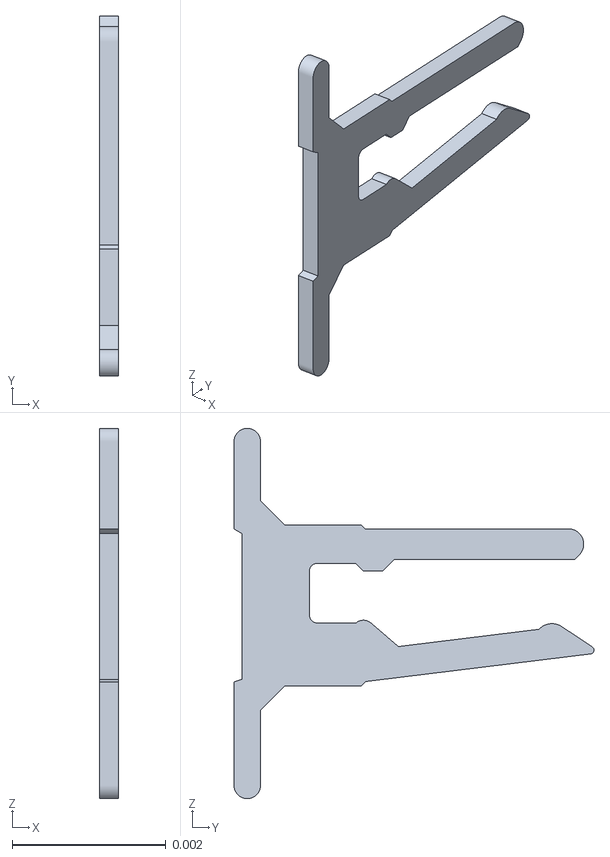
[picture p60: CAD file, 2026-11-06]
onshape_export/robot/assets/camera_connector__rpi4modelb__imported8.stl
0.00025 x 0.00469 x 0.00482
