A-Common-Guy/bipedale/ros2_ws/src/sandro_description/mjcf/assets/bno055_9axis_imu_v2_1__body7.stl

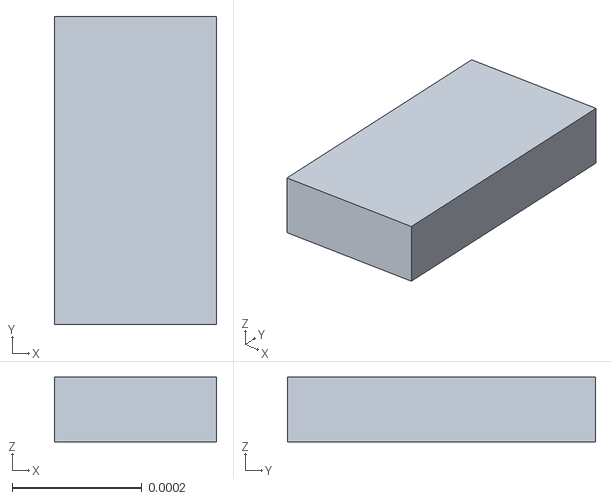
[picture p61: CAD file, 2026-11-06]
ros2_ws/src/sandro_description/mjcf/assets/bno055_9axis_imu_v2_1__body7.stl
0.00025 x 0.000475 x 0.0001
