A-Common-Guy/bipedale/3d_models/Body_cnnector - body_lower.stl

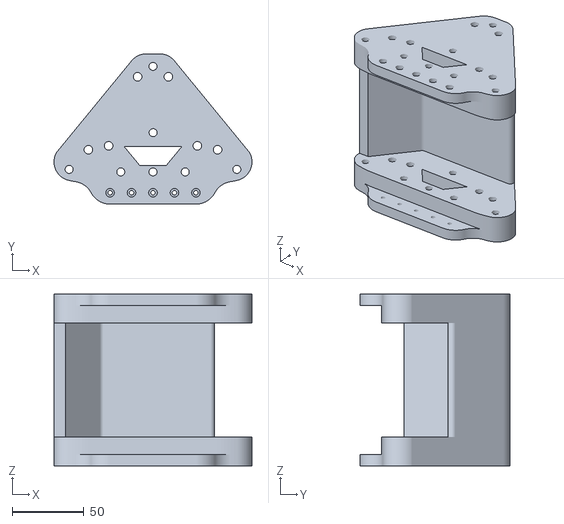
[picture p62: CAD file, 2026-09-20]
3d_models/Body_cnnector - body_lower.stl
138.4 x 105.0 x 120.0
