A-Common-Guy/bipedale/onshape_export/robot/assets/2_54_mm_dupont_male_pin_header__poe__2x2__rpi4modelb__imported1.stl

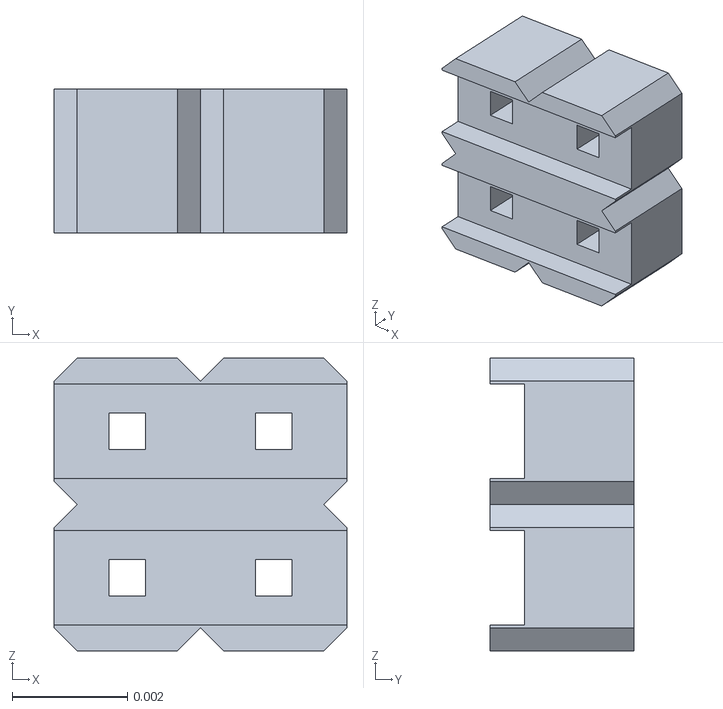
[picture p63: CAD file, 2026-11-06]
onshape_export/robot/assets/2_54_mm_dupont_male_pin_header__poe__2x2__rpi4modelb__imported1.stl
0.00508 x 0.0025 x 0.00508
