A-Common-Guy/bipedale/3d_models/perno biella - PernoBiella.stl

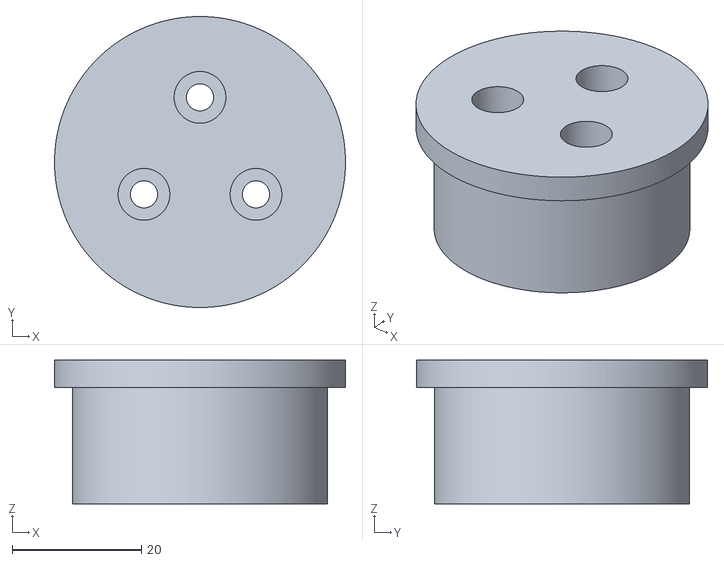
[picture p64: CAD file, 2026-09-20]
3d_models/perno biella - PernoBiella.stl
45.0 x 45.0 x 22.2
