A-Common-Guy/bipedale/onshape_export/robot/assets/bearing_5_2_4_0_7.stl

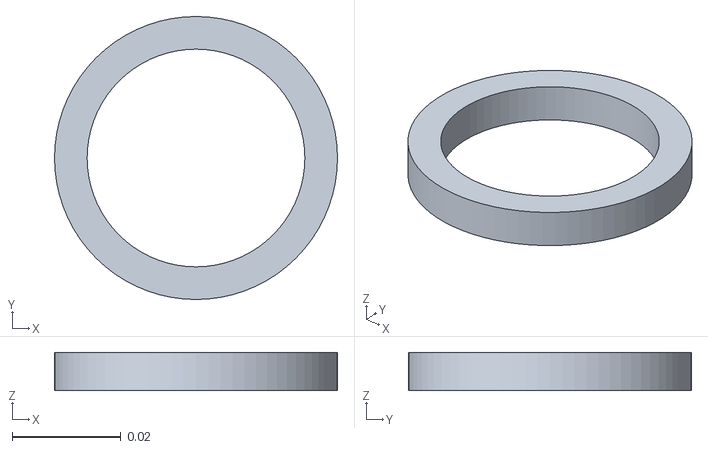
[picture p65: CAD file, 2026-11-06]
onshape_export/robot/assets/bearing_5_2_4_0_7.stl
0.052 x 0.052 x 0.007
