A-Common-Guy/bipedale/ros2_ws/src/sandro_description/mjcf/assets/led_0603_single_color_v1_1__body2.stl

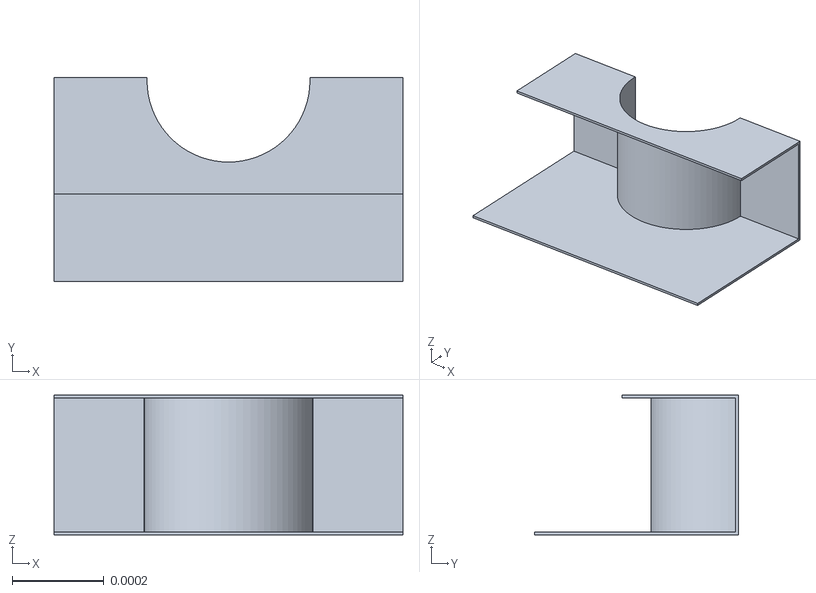
[picture p66: CAD file, 2026-11-06]
ros2_ws/src/sandro_description/mjcf/assets/led_0603_single_color_v1_1__body2.stl
0.000762 x 0.000444 x 0.000305
