A-Common-Guy/bipedale/3d_models/manovella 1.stl

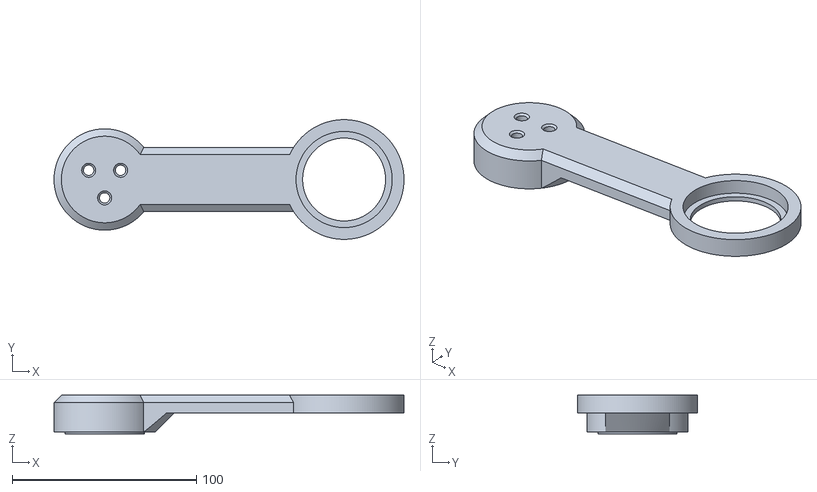
[picture p67: CAD file, 2026-09-20]
3d_models/manovella 1.stl
190.0 x 65.0 x 21.0
