A-Common-Guy/bipedale/3d_models/Robot_roof - Robot_roof.stl

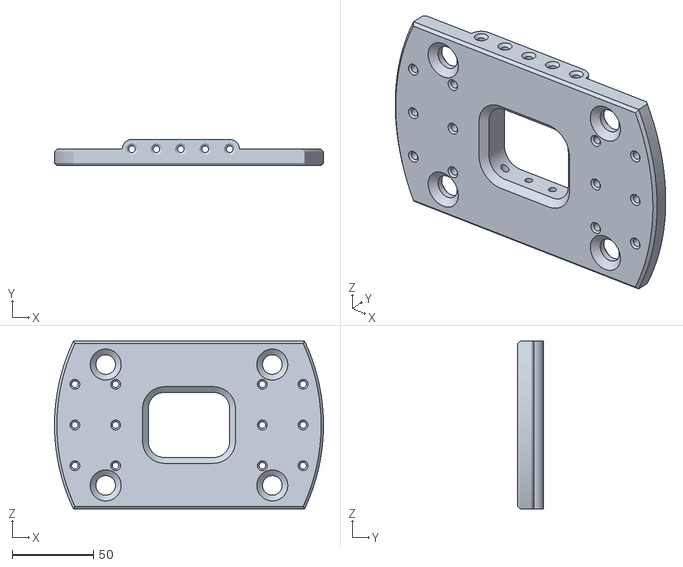
[picture p68: CAD file, 2026-09-20]
3d_models/Robot_roof - Robot_roof.stl
165.2 x 16.0 x 103.0
