A-Common-Guy/bipedale/3d_models/wheel_mock - rubber wheel.stl

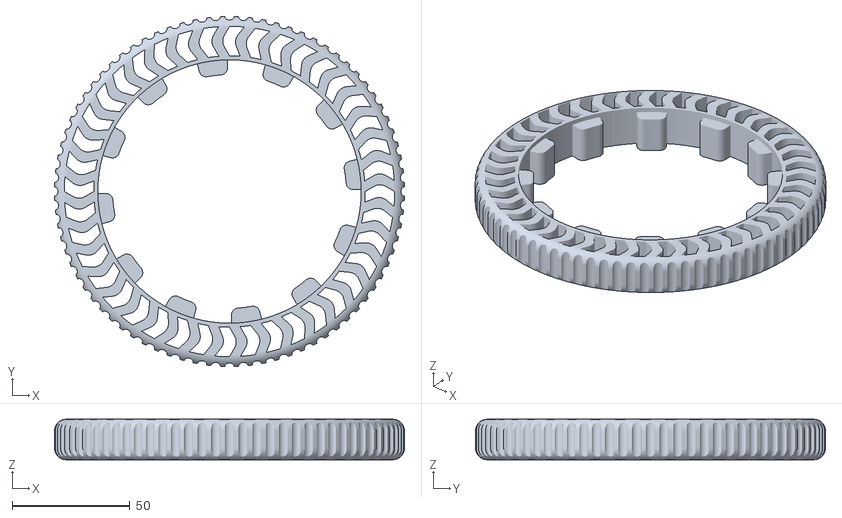
[picture p69: CAD file, 2026-09-20]
3d_models/wheel_mock - rubber wheel.stl
148.3 x 148.3 x 17.2
