A-Common-Guy/bipedale/onshape_export/robot/assets/crystal_xtal3215_32_768khz_v2_1__body3.stl

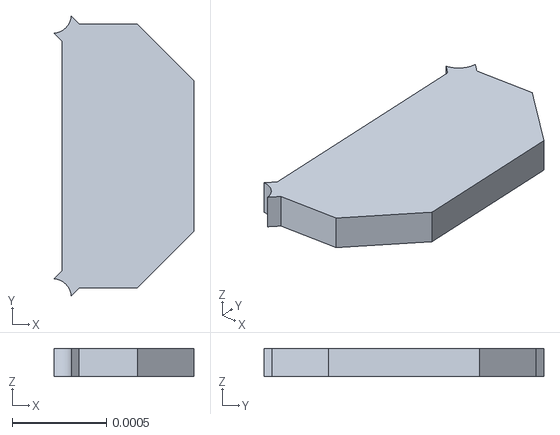
[picture p70: CAD file, 2026-11-06]
onshape_export/robot/assets/crystal_xtal3215_32_768khz_v2_1__body3.stl
0.000742 x 0.00148 x 0.00015
