A-Common-Guy/bipedale/onshape_export/robot/assets/imu_holder.stl

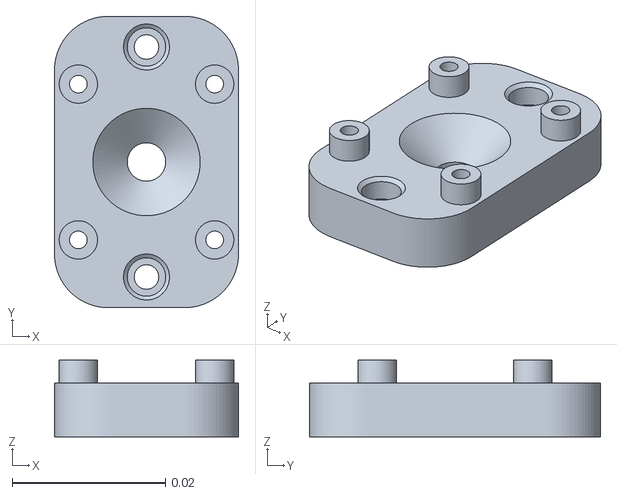
[picture p71: CAD file, 2026-11-06]
onshape_export/robot/assets/imu_holder.stl
0.024 x 0.038 x 0.01
