A-Common-Guy/bipedale/ros2_ws/src/sandro_description/mjcf/assets/female_micro_hdmi_connector__rpi4modelb__imported1.stl

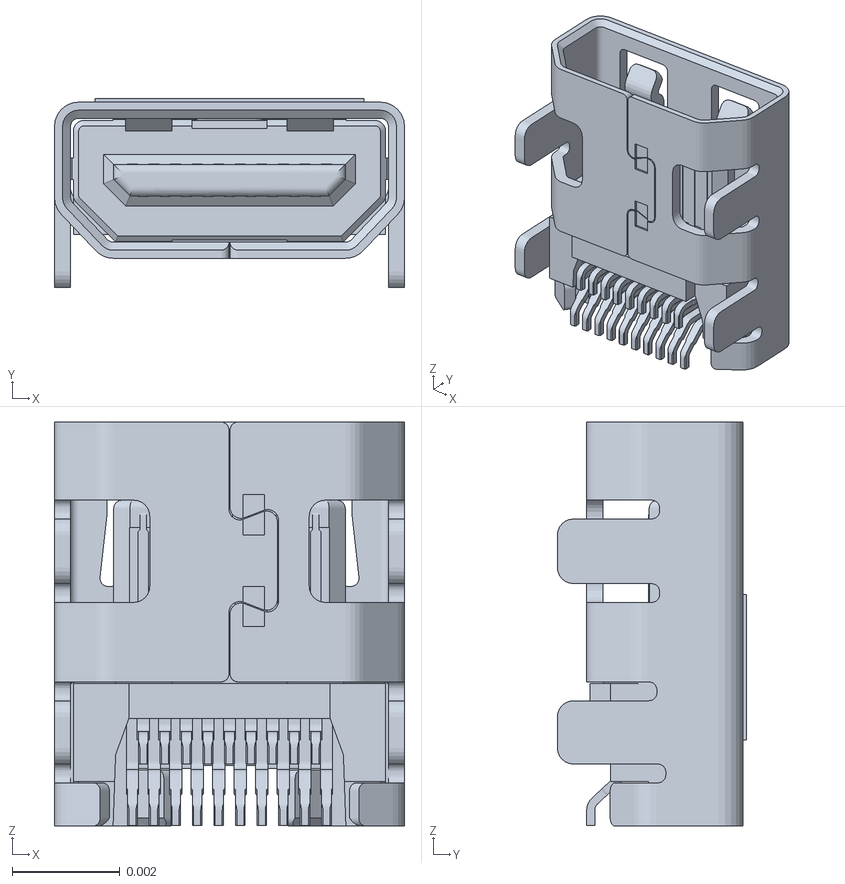
[picture p72: CAD file, 2026-11-06]
ros2_ws/src/sandro_description/mjcf/assets/female_micro_hdmi_connector__rpi4modelb__imported1.stl
0.0065 x 0.00352 x 0.0075
