A-Common-Guy/bipedale/ros2_ws/src/sandro_description/mjcf/assets/power_dist_box.stl

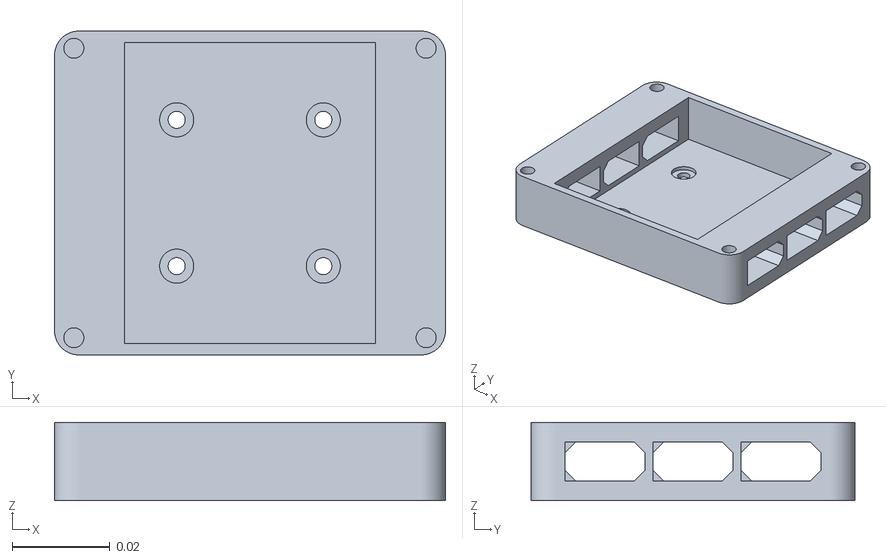
[picture p73: CAD file, 2026-11-06]
ros2_ws/src/sandro_description/mjcf/assets/power_dist_box.stl
0.0802 x 0.0664 x 0.016
