A-Common-Guy/bipedale/ros2_ws/src/sandro_description/mjcf/assets/bss138ps_v2_1__body5.stl

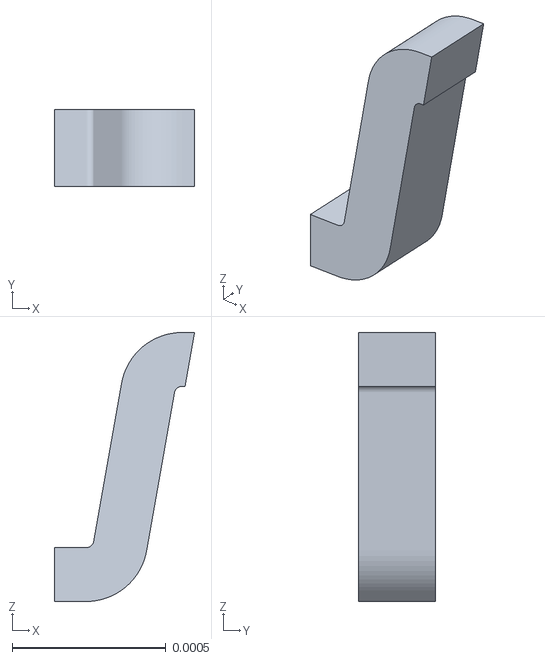
[picture p74: CAD file, 2026-11-06]
ros2_ws/src/sandro_description/mjcf/assets/bss138ps_v2_1__body5.stl
0.000456 x 0.00025 x 0.000875
