A-Common-Guy/bipedale/onshape_export/robot/assets/microphone_plug__rpi4modelb__imported3.stl

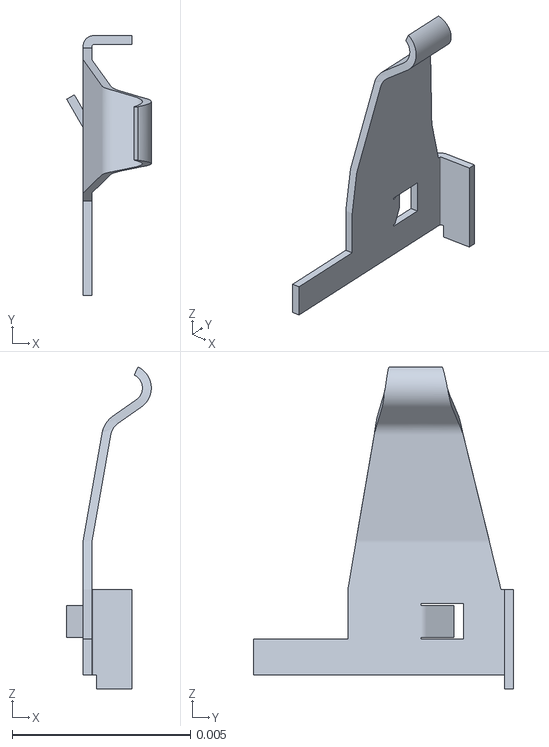
[picture p75: CAD file, 2026-11-06]
onshape_export/robot/assets/microphone_plug__rpi4modelb__imported3.stl
0.00238 x 0.0073 x 0.00904
