A-Common-Guy/bipedale/ros2_ws/src/sandro_description/mjcf/assets/female_usb_type_c_connector__rpi4modelb__imported1.stl

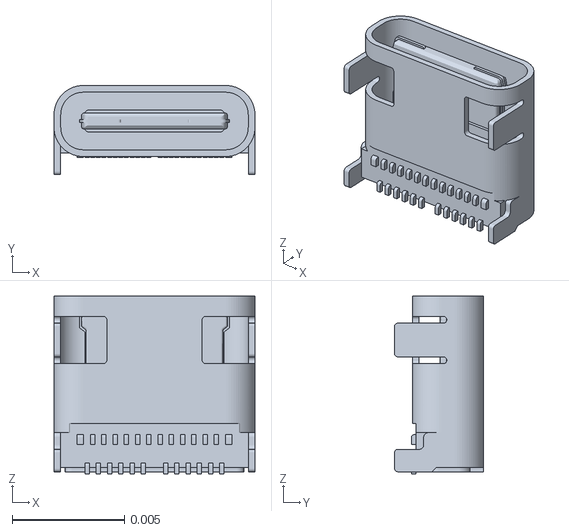
[picture p76: CAD file, 2026-11-06]
ros2_ws/src/sandro_description/mjcf/assets/female_usb_type_c_connector__rpi4modelb__imported1.stl
0.00894 x 0.00396 x 0.0079
