A-Common-Guy/bipedale/onshape_export/robot/assets/wheelstickcover.stl

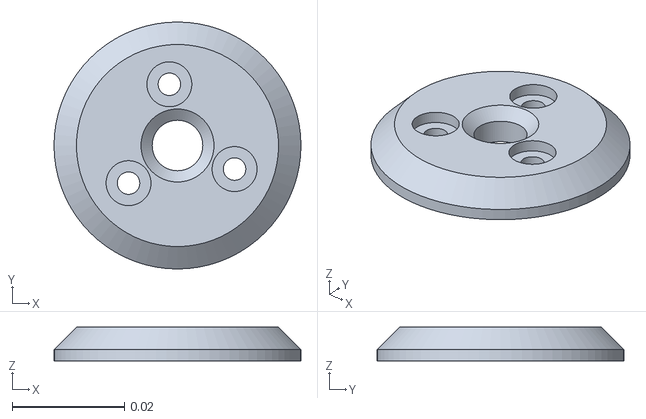
[picture p77: CAD file, 2026-11-06]
onshape_export/robot/assets/wheelstickcover.stl
0.044 x 0.044 x 0.006
