A-Common-Guy/bipedale/onshape_export/robot/assets/sot23_5_v1_1__body1.stl

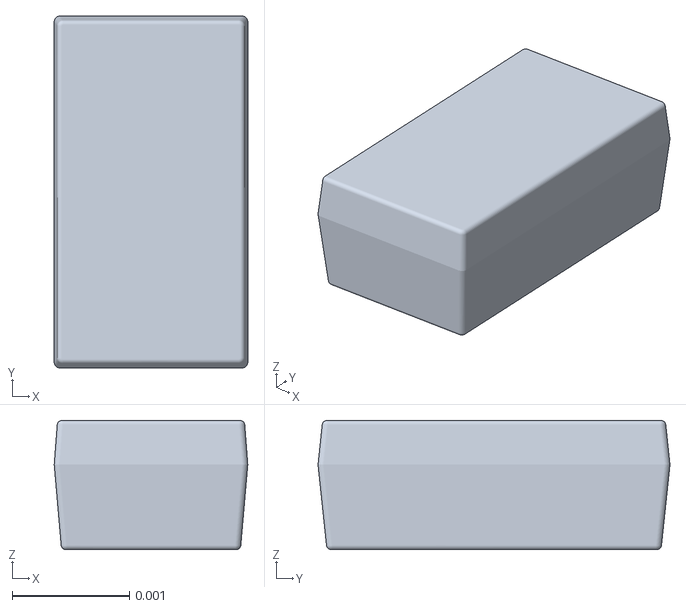
[picture p78: CAD file, 2026-11-06]
onshape_export/robot/assets/sot23_5_v1_1__body1.stl
0.00165 x 0.003 x 0.0011
