A-Common-Guy/bipedale/onshape_export/robot/assets/bno085_9axis_imu_v1_1__body30.stl

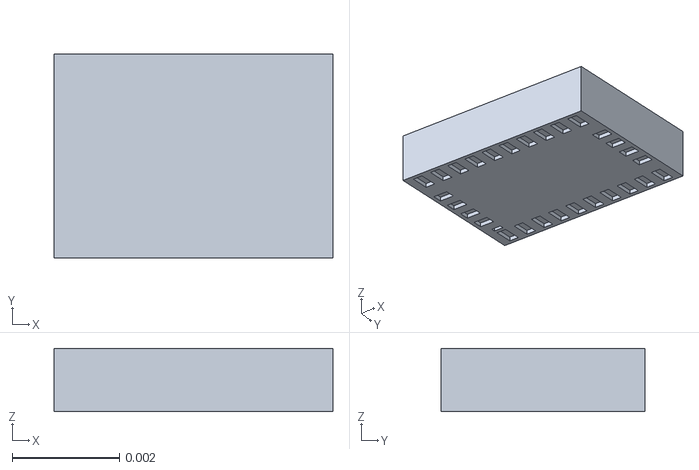
[picture p79: CAD file, 2026-11-06]
onshape_export/robot/assets/bno085_9axis_imu_v1_1__body30.stl
0.0052 x 0.0038 x 0.00118
