A-Common-Guy/bipedale/onshape_export/robot/assets/lead_tssop_1__body1.stl

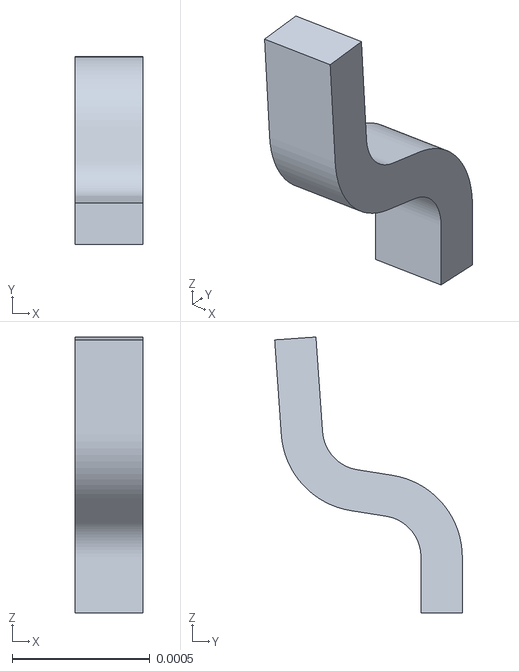
[picture p80: CAD file, 2026-11-06]
onshape_export/robot/assets/lead_tssop_1__body1.stl
0.000245 x 0.00068 x 0.001
