A-Common-Guy/bipedale/ros2_ws/src/sandro_description/mjcf/assets/capc_0603_t0_9_bn_v1_1__body1.stl

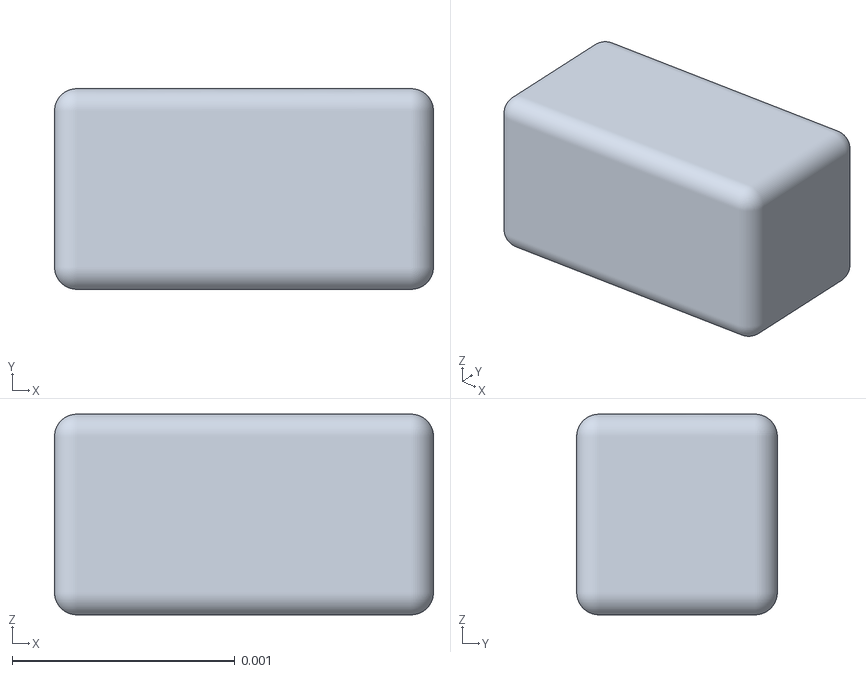
[picture p81: CAD file, 2026-11-06]
ros2_ws/src/sandro_description/mjcf/assets/capc_0603_t0_9_bn_v1_1__body1.stl
0.0017 x 0.0009 x 0.0009
