A-Common-Guy/bipedale/onshape_export/robot/assets/biella.stl

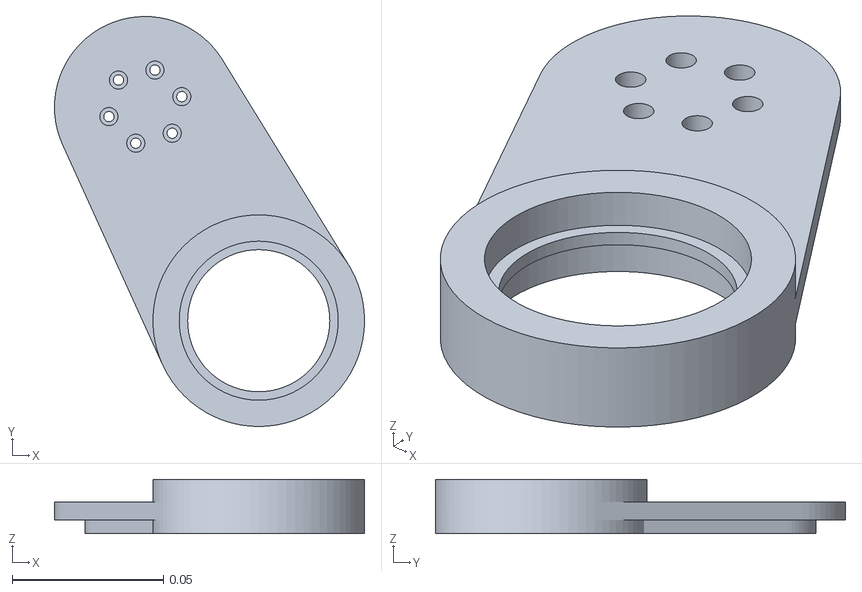
[picture p82: CAD file, 2026-11-06]
onshape_export/robot/assets/biella.stl
0.103 x 0.136 x 0.018
