A-Common-Guy/bipedale/ros2_ws/src/sandro_description/mjcf/assets/qwicc_v1_1__body7.stl

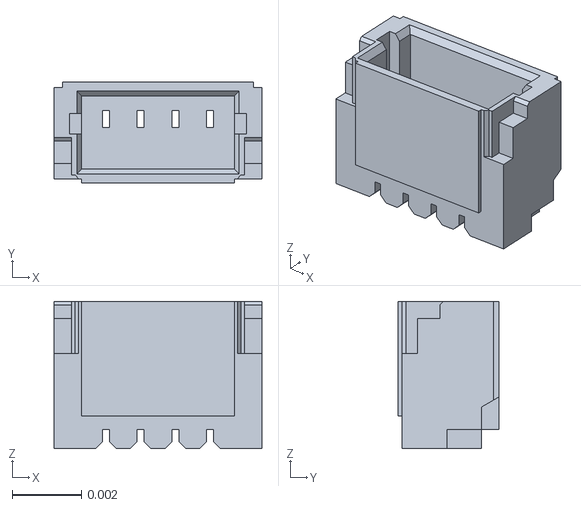
[picture p83: CAD file, 2026-11-06]
ros2_ws/src/sandro_description/mjcf/assets/qwicc_v1_1__body7.stl
0.006 x 0.0029 x 0.00425
