A-Common-Guy/bipedale/onshape_export/robot/assets/crystal_xtal3215_32_768khz_v2_1__body1.stl

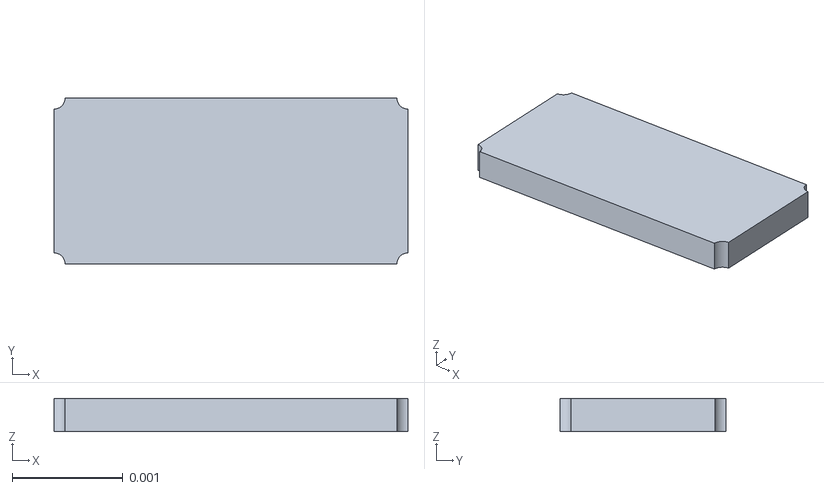
[picture p84: CAD file, 2026-11-06]
onshape_export/robot/assets/crystal_xtal3215_32_768khz_v2_1__body1.stl
0.0032 x 0.0015 x 0.0003
