A-Common-Guy/bipedale/onshape_export/robot/assets/sd_card_slot__rpi4modelb__imported10.stl

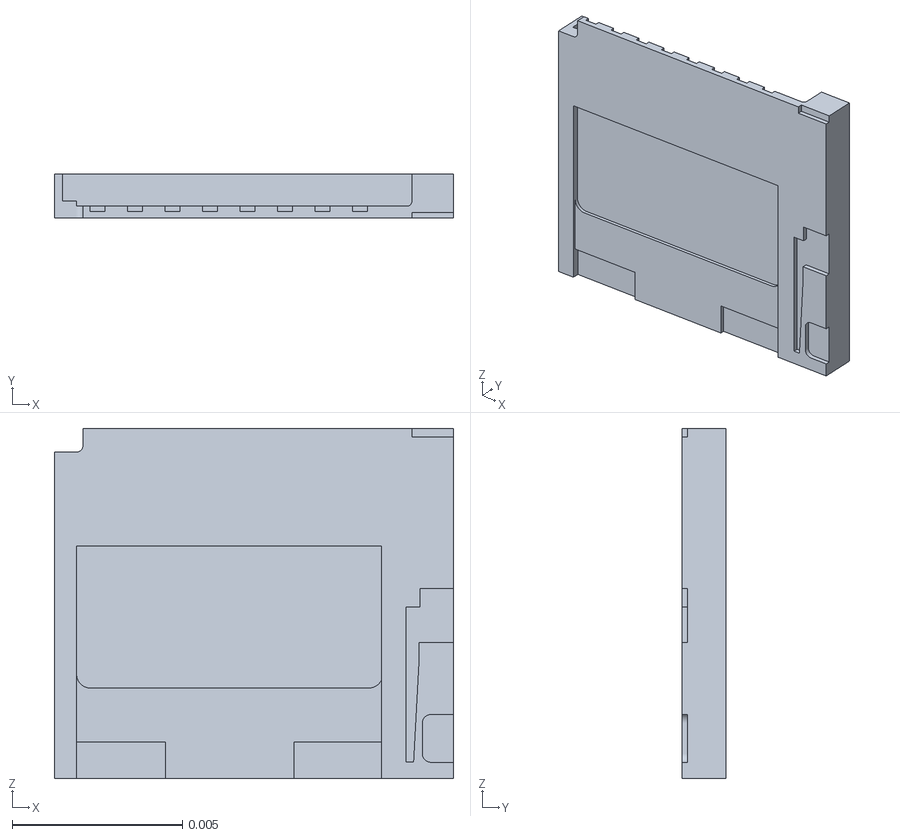
[picture p85: CAD file, 2026-11-06]
onshape_export/robot/assets/sd_card_slot__rpi4modelb__imported10.stl
0.0117 x 0.0013 x 0.0103
