A-Common-Guy/bipedale/onshape_export/robot/assets/printed_circuit_board_1__body1.stl

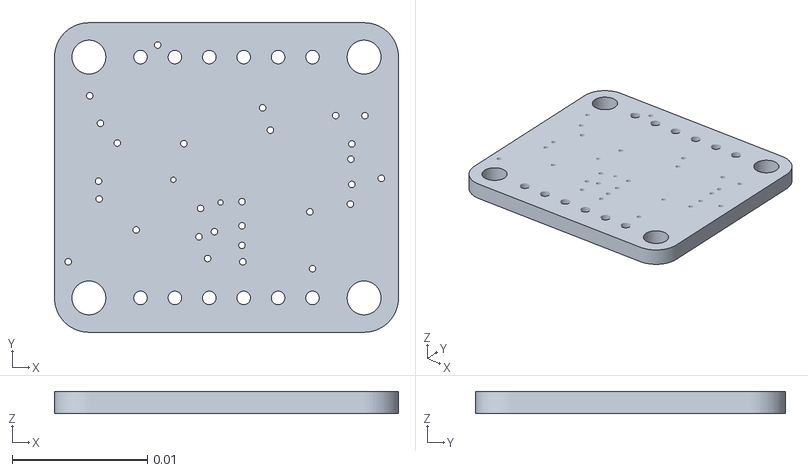
[picture p86: CAD file, 2026-11-06]
onshape_export/robot/assets/printed_circuit_board_1__body1.stl
0.0254 x 0.0229 x 0.00165
