A-Common-Guy/bipedale/onshape_export/robot/assets/led_0603_single_color_v1_1__body1.stl

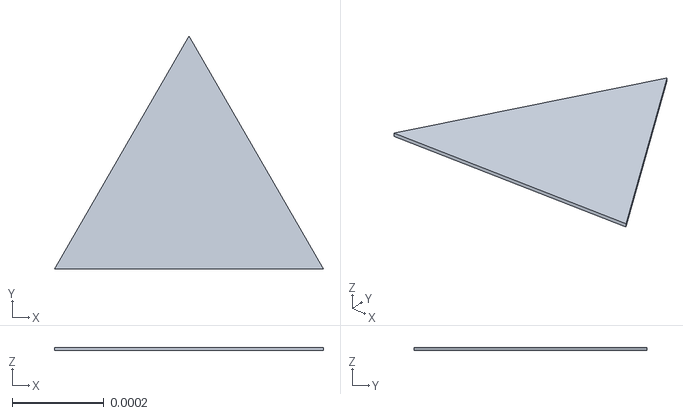
[picture p87: CAD file, 2026-11-06]
onshape_export/robot/assets/led_0603_single_color_v1_1__body1.stl
0.000587 x 0.000508 x 7.62e-06
