A-Common-Guy/bipedale/ros2_ws/src/sandro_description/mjcf/assets/2x_usb2_0_ports__rpi4modelb__imported1.stl

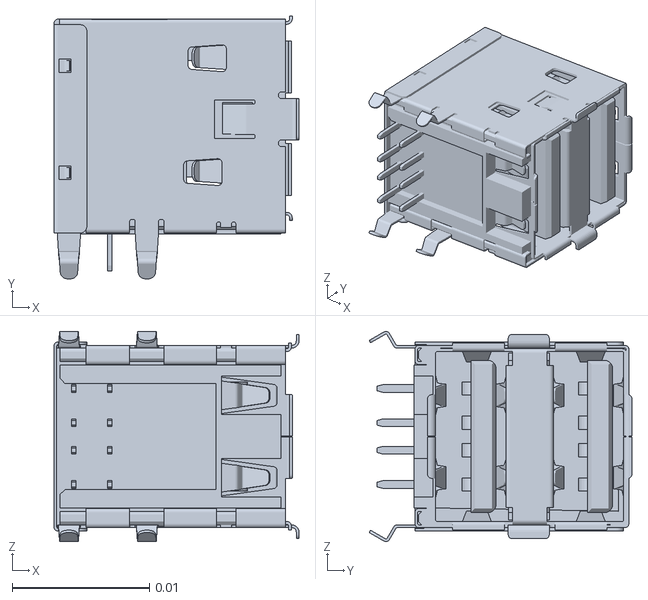
[picture p88: CAD file, 2026-11-06]
ros2_ws/src/sandro_description/mjcf/assets/2x_usb2_0_ports__rpi4modelb__imported1.stl
0.0179 x 0.0192 x 0.0153
