A-Common-Guy/bipedale/ros2_ws/src/sandro_description/mjcf/assets/body_lower.stl

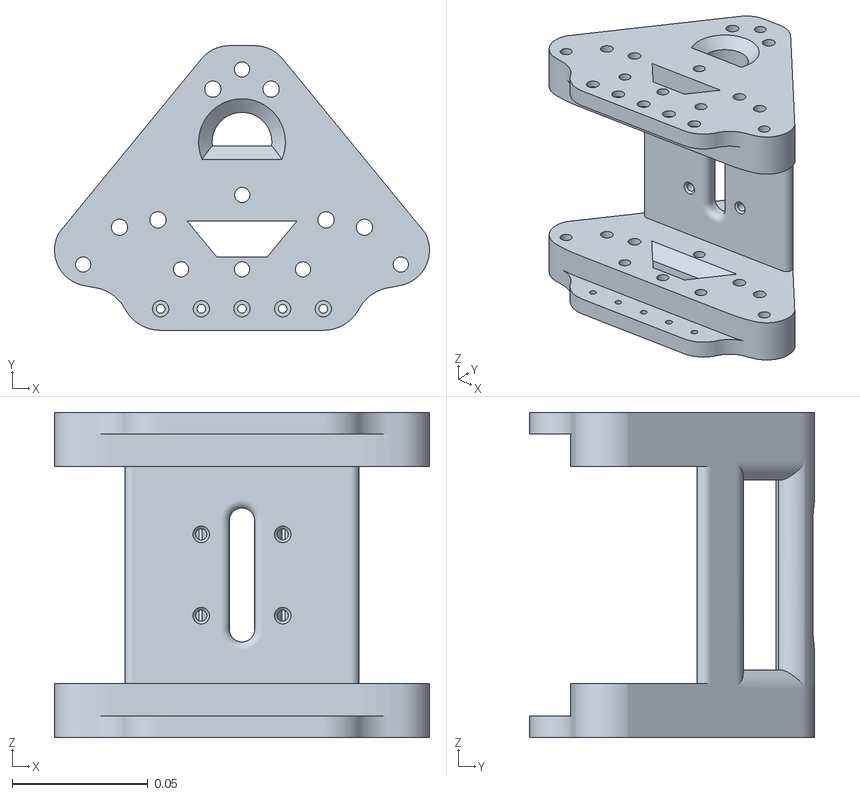
[picture p89: CAD file, 2026-11-06]
ros2_ws/src/sandro_description/mjcf/assets/body_lower.stl
0.138 x 0.105 x 0.12
