A-Common-Guy/bipedale/ros2_ws/src/sandro_description/mjcf/assets/91d77_d9whv_778k__4_gb_lpddr4_sdram__rpi4modelb__partnoadditional.stl

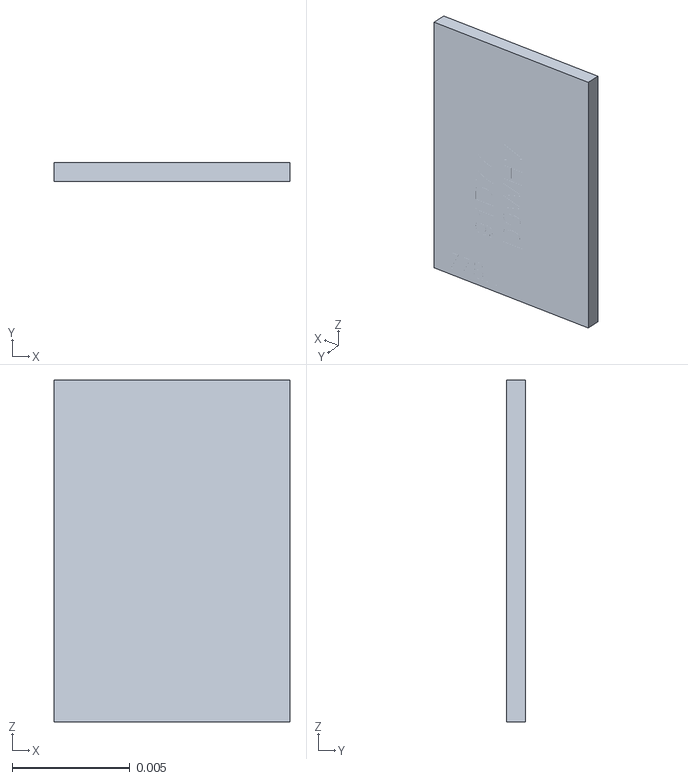
[picture p90: CAD file, 2026-11-06]
ros2_ws/src/sandro_description/mjcf/assets/91d77_d9whv_778k__4_gb_lpddr4_sdram__rpi4modelb__partnoadditional.stl
0.01 x 0.0008 x 0.0145
