A-Common-Guy/bipedale/onshape_export/robot/assets/yc164_respack_v1_1__body1.stl

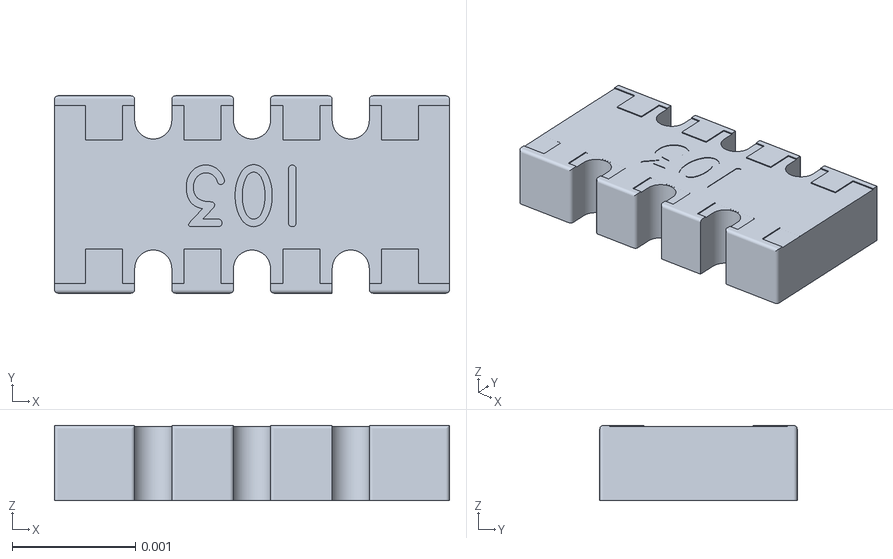
[picture p91: CAD file, 2026-11-06]
onshape_export/robot/assets/yc164_respack_v1_1__body1.stl
0.0032 x 0.0016 x 0.00061
