A-Common-Guy/bipedale/onshape_export/robot/assets/qwicc_v1_1__body4.stl

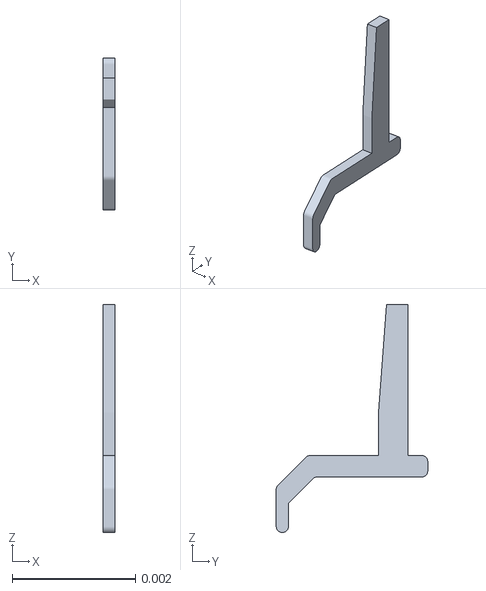
[picture p92: CAD file, 2026-11-06]
onshape_export/robot/assets/qwicc_v1_1__body4.stl
0.0002 x 0.00246 x 0.0037
