A-Common-Guy/bipedale/onshape_export/robot/assets/broadcom_bcm54213pe_gigabit_ethernet_transceiver__rpi4modelb__partnoe3.stl

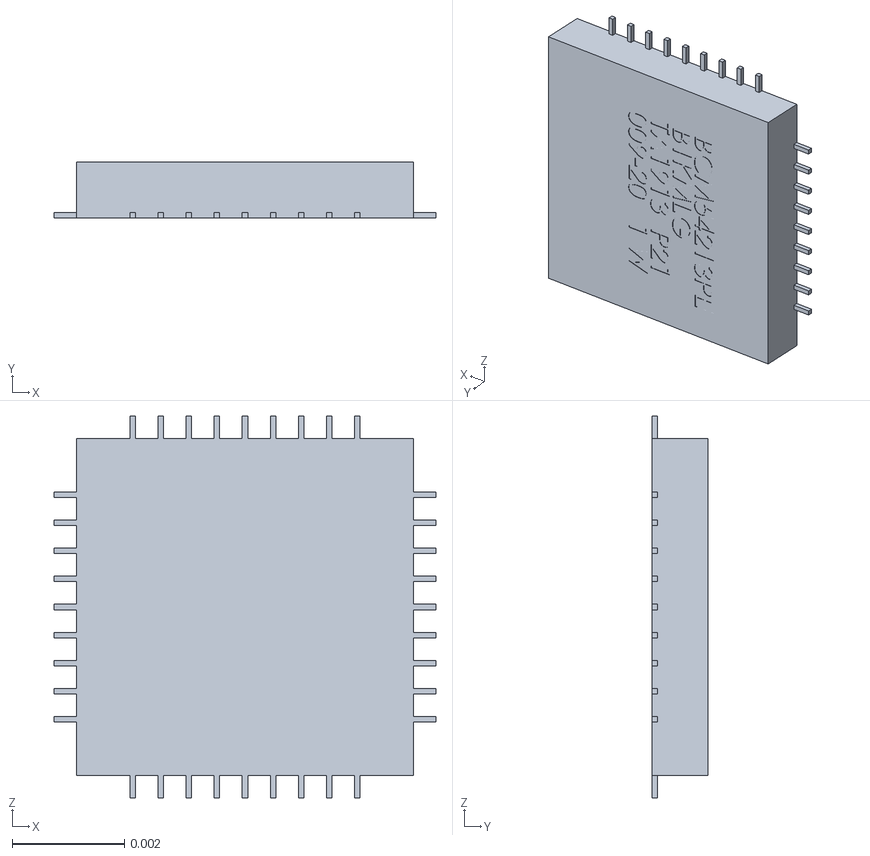
[picture p93: CAD file, 2026-11-06]
onshape_export/robot/assets/broadcom_bcm54213pe_gigabit_ethernet_transceiver__rpi4modelb__partnoe3.stl
0.0068 x 0.001 x 0.0068
