A-Common-Guy/bipedale/ros2_ws/src/sandro_description/mjcf/assets/cypress_cyw43455_wireless_module_cover__rpi4modelb__ventlp.stl

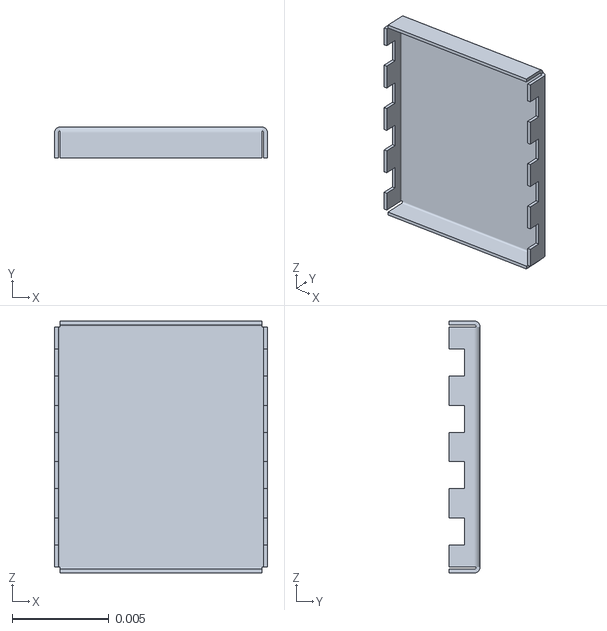
[picture p94: CAD file, 2026-11-06]
ros2_ws/src/sandro_description/mjcf/assets/cypress_cyw43455_wireless_module_cover__rpi4modelb__ventlp.stl
0.011 x 0.0016 x 0.013
