A-Common-Guy/bipedale/ros2_ws/src/sandro_description/mjcf/assets/qwicc_v1_1__body1.stl

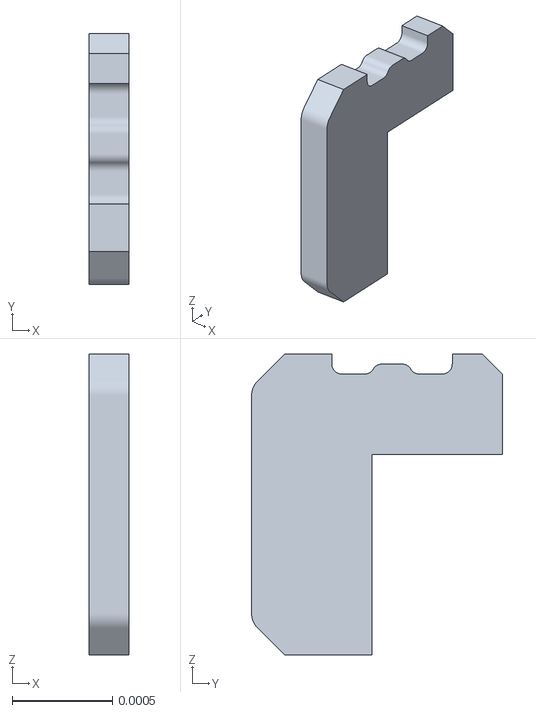
[picture p95: CAD file, 2026-11-06]
ros2_ws/src/sandro_description/mjcf/assets/qwicc_v1_1__body1.stl
0.0002 x 0.00125 x 0.0015
