A-Common-Guy/bipedale/onshape_export/robot/assets/led_0603_single_color_v1_1__body4.stl

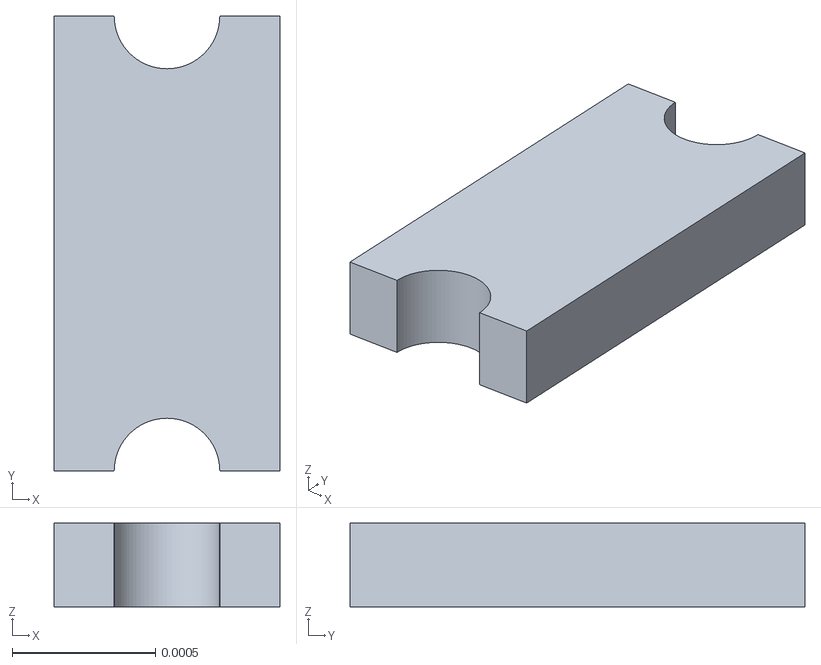
[picture p96: CAD file, 2026-11-06]
onshape_export/robot/assets/led_0603_single_color_v1_1__body4.stl
0.000787 x 0.00159 x 0.000292
