A-Common-Guy/bipedale/ros2_ws/src/sandro_description/mjcf/assets/bno055_9axis_imu_v2_1__body31.stl

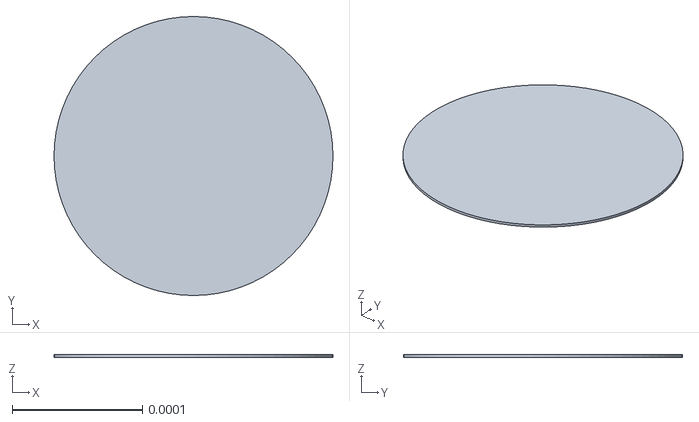
[picture p97: CAD file, 2026-11-06]
ros2_ws/src/sandro_description/mjcf/assets/bno055_9axis_imu_v2_1__body31.stl
0.000214 x 0.000214 x 2e-06
