A-Common-Guy/bipedale/onshape_export/robot/assets/robot_roof.stl

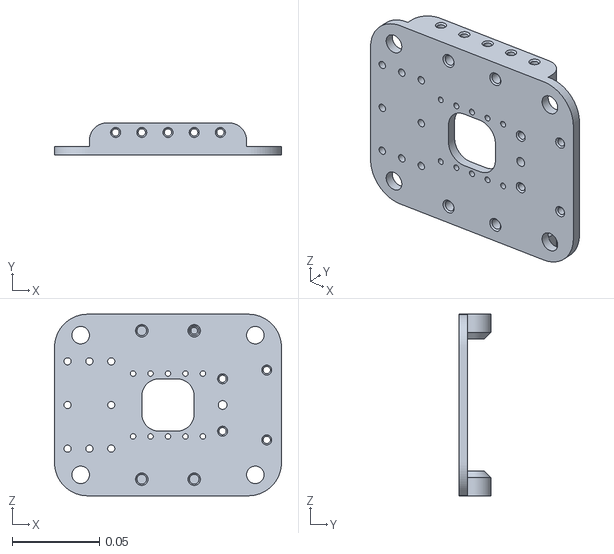
[picture p98: CAD file, 2026-11-06]
onshape_export/robot/assets/robot_roof.stl
0.13 x 0.0184 x 0.104
