A-Common-Guy/bipedale/onshape_export/robot/assets/capc_0805_t0_95_bn_v1_1__body1.stl

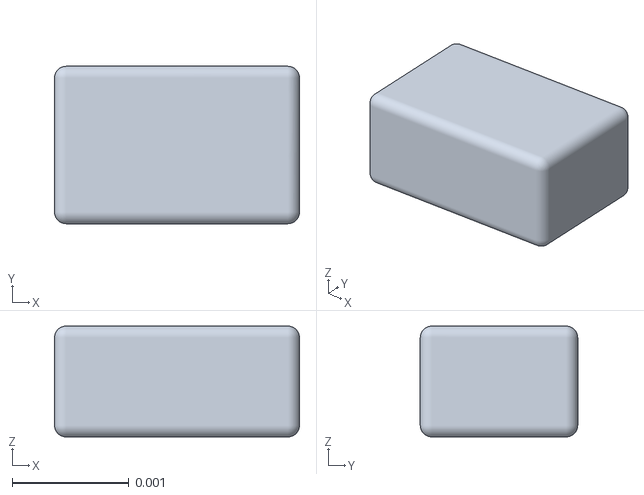
[picture p99: CAD file, 2026-11-06]
onshape_export/robot/assets/capc_0805_t0_95_bn_v1_1__body1.stl
0.0021 x 0.00135 x 0.00095
