A-Common-Guy/bipedale/onshape_export/robot/assets/mxl7704_universal_pmic__rpi4modelb__partnoextended.stl

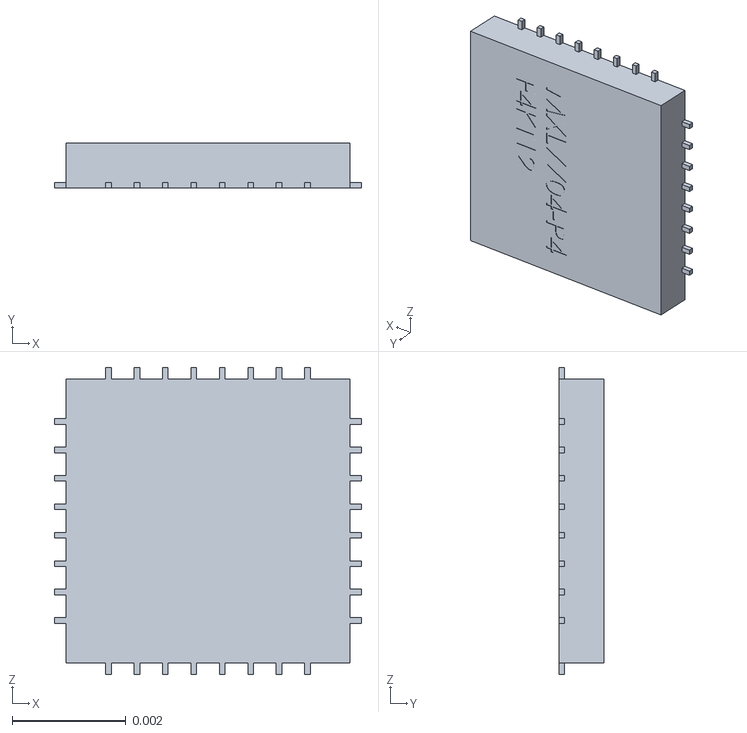
[picture p101: CAD file, 2026-11-06]
onshape_export/robot/assets/mxl7704_universal_pmic__rpi4modelb__partnoextended.stl
0.0054 x 0.0008 x 0.0054
