A-Common-Guy/bipedale/(list of files, cad)

Other CAD files:
ros2_ws/src/sandro_description/mjcf/assets/2_54_mm_dupont_male_pin_header__io__2x20__rpi4modelb__imported10.stl
ros2_ws/src/sandro_description/mjcf/assets/2_54_mm_dupont_male_pin_header__io__2x20__rpi4modelb__imported38.stl
onshape_export/leg_left/assets/wheel_tire_holder.stl
onshape_export/leg_left/assets/manovella2.stl
onshape_export/robot/assets/2_54_mm_dupont_male_pin_header__io__2x20__rpi4modelb__imported35.stl
ros2_ws/src/sandro_description/mjcf/assets/2_54_mm_dupont_male_pin_header__io__2x20__rpi4modelb__imported28.stl
ros2_ws/src/sandro_description/mjcf/assets/2_54_mm_dupont_male_pin_header__io__2x20__rpi4modelb__imported34.stl
onshape_export/robot/assets/2_54_mm_dupont_male_pin_header__io__2x20__rpi4modelb__imported32.stl
ros2_ws/src/sandro_description/mjcf/assets/2_54_mm_dupont_male_pin_header__io__2x20__rpi4modelb__imported16.stl
onshape_export/robot/assets/camera_connector__rpi4modelb__imported12.stl
ros2_ws/src/sandro_description/mjcf/assets/2_54_mm_dupont_male_pin_header__io__2x20__rpi4modelb__imported27.stl
ros2_ws/src/sandro_description/mjcf/assets/2_54_mm_dupont_male_pin_header__io__2x20__rpi4modelb__imported15.stl
onshape_export/robot/assets/2_54_mm_dupont_male_pin_header__io__2x20__rpi4modelb__imported8.stl
ros2_ws/src/sandro_description/mjcf/assets/sot23_5_v1_1__body3.stl
onshape_export/robot/assets/sot23_5_v1_1__body2.stl
onshape_export/robot/assets/2_54_mm_dupont_male_pin_header__poe__2x2__rpi4modelb__imported5.stl
onshape_export/robot/assets/bno085_9axis_imu_v1_1__body15.stl
ros2_ws/src/sandro_description/mjcf/assets/bno055_9axis_imu_v2_1__body21.stl
onshape_export/robot/assets/bno055_9axis_imu_v2_1__body9.stl
ros2_ws/src/sandro_description/mjcf/assets/sd_card_slot__rpi4modelb__imported4.stl
ros2_ws/src/sandro_description/mjcf/assets/bno085_9axis_imu_v1_1__body8.stl
ros2_ws/src/sandro_description/mjcf/assets/sd_card_slot__rpi4modelb__imported6.stl
ros2_ws/src/sandro_description/mjcf/assets/bss138ps_v2_1__body3.stl
ros2_ws/src/sandro_description/mjcf/assets/2_54_mm_dupont_male_pin_header__io__2x20__rpi4modelb__imported18.stl
onshape_export/robot/assets/2_54_mm_dupont_male_pin_header__io__2x20__rpi4modelb__imported39.stl
ros2_ws/src/sandro_description/mjcf/assets/camera_connector__rpi4modelb__imported15.stl
onshape_export/robot/assets/2_54_mm_dupont_male_pin_header__io__2x20__rpi4modelb__imported9.stl
ros2_ws/src/sandro_description/mjcf/assets/sd_card_slot__rpi4modelb__imported2.stl
onshape_export/robot/assets/bno055_9axis_imu_v2_1__body19.stl
ros2_ws/src/sandro_description/mjcf/assets/2_54_mm_dupont_male_pin_header__io__2x20__rpi4modelb__imported3.stl
onshape_export/robot/assets/camera_connector__rpi4modelb__imported2.stl
ros2_ws/src/sandro_description/mjcf/assets/bno055_9axis_imu_v2_1__body1.stl
ros2_ws/src/sandro_description/mjcf/assets/2_54_mm_dupont_male_pin_header__io__2x20__rpi4modelb__imported36.stl
ros2_ws/src/sandro_description/mjcf/assets/bno055_9axis_imu_v2_1__body27.stl
onshape_export/robot/assets/2_54_mm_dupont_male_pin_header__io__2x20__rpi4modelb__imported37.stl
ros2_ws/src/sandro_description/mjcf/assets/2_54_mm_dupont_male_pin_header__io__2x20__rpi4modelb__imported13.stl
onshape_export/robot/assets/bno055_9axis_imu_v2_1__body26.stl
ros2_ws/src/sandro_description/mjcf/assets/2_54_mm_dupont_male_pin_header__io__2x20__rpi4modelb__imported14.stl
onshape_export/robot/assets/2_54_mm_dupont_male_pin_header__io__2x20__rpi4modelb__imported20.stl
ros2_ws/src/sandro_description/mjcf/assets/2_54_mm_dupont_male_pin_header__io__2x20__rpi4modelb__imported4.stl
onshape_export/robot/assets/2_54_mm_dupont_male_pin_header__io__2x20__rpi4modelb__imported2.stl
ros2_ws/src/sandro_description/mjcf/assets/2_54_mm_dupont_male_pin_header__io__2x20__rpi4modelb__imported19.stl
onshape_export/robot/assets/bno085_9axis_imu_v1_1__body22.stl
onshape_export/robot/assets/2_54_mm_dupont_male_pin_header__io__2x20__rpi4modelb__imported31.stl
onshape_export/robot/assets/bno085_9axis_imu_v1_1__body4.stl
ros2_ws/src/sandro_description/mjcf/assets/sd_card_slot__rpi4modelb__imported3.stl
ros2_ws/src/sandro_description/mjcf/assets/handle_holder_2.stl
onshape_export/robot/assets/bno055_9axis_imu_v2_1__body6.stl
ros2_ws/src/sandro_description/mjcf/assets/camera_connector__rpi4modelb__imported7.stl
onshape_export/robot/assets/camera_connector__rpi4modelb__imported10.stl
ros2_ws/src/sandro_description/mjcf/assets/bno055_9axis_imu_v2_1__body14.stl
ros2_ws/src/sandro_description/mjcf/assets/2_54_mm_dupont_male_pin_header__io__2x20__rpi4modelb__imported21.stl
onshape_export/robot/assets/bno055_9axis_imu_v2_1__body16.stl
ros2_ws/src/sandro_description/mjcf/assets/qwicc_v1_1__body2.stl
onshape_export/robot/assets/bno085_9axis_imu_v1_1__body17.stl
ros2_ws/src/sandro_description/mjcf/assets/qwicc_v1_1__body6.stl
onshape_export/robot/assets/2_54_mm_dupont_male_pin_header__poe__2x2__rpi4modelb__imported4.stl
ros2_ws/src/sandro_description/mjcf/assets/display_connector__rpi4modelb__imported5.stl
onshape_export/robot/assets/2_54_mm_dupont_male_pin_header__poe__2x2__rpi4modelb__imported2.stl
ros2_ws/src/sandro_description/mjcf/assets/2_54_mm_dupont_male_pin_header__io__2x20__rpi4modelb__imported29.stl
onshape_export/robot/assets/2_54_mm_dupont_male_pin_header__io__2x20__rpi4modelb__imported26.stl
ros2_ws/src/sandro_description/mjcf/assets/sd_card_slot__rpi4modelb__imported7.stl
onshape_export/robot/assets/bno055_9axis_imu_v2_1__body25.stl
ros2_ws/src/sandro_description/mjcf/assets/bno085_9axis_imu_v1_1__body23.stl
onshape_export/robot/assets/bodymotorholder.stl
onshape_export/robot/assets/sot23_5_v1_1__body6.stl
ros2_ws/src/sandro_description/mjcf/assets/bno085_9axis_imu_v1_1__body11.stl
ros2_ws/src/sandro_description/mjcf/assets/camera_connector__rpi4modelb__imported4.stl
onshape_export/robot/assets/bss138ps_v2_1__body6.stl
ros2_ws/src/sandro_description/mjcf/assets/2_54_mm_dupont_male_pin_header__io__2x20__rpi4modelb__imported23.stl
onshape_export/robot/assets/bno055_9axis_imu_v2_1__body2.stl
ros2_ws/src/sandro_description/mjcf/assets/display_connector__rpi4modelb__imported1.stl
onshape_export/robot/assets/2_54_mm_dupont_male_pin_header__io__2x20__rpi4modelb__imported41.stl
ros2_ws/src/sandro_description/mjcf/assets/qwicc_v1_1__body5.stl
onshape_export/robot/assets/bno055_9axis_imu_v2_1__body5.stl
ros2_ws/src/sandro_description/mjcf/assets/bno055_9axis_imu_v2_1__body24.stl
ros2_ws/src/sandro_description/mjcf/assets/camera_connector__rpi4modelb__imported3.stl
onshape_export/robot/assets/bss138ps_v2_1__body1.stl
onshape_export/robot/assets/camera_connector__rpi4modelb__imported11.stl
ros2_ws/src/sandro_description/mjcf/assets/2_54_mm_dupont_male_pin_header__io__2x20__rpi4modelb__imported24.stl
ros2_ws/src/sandro_description/mjcf/assets/2_54_mm_dupont_male_pin_header__poe__2x2__rpi4modelb__imported3.stl
onshape_export/robot/assets/sot23_5_v1_1__body4.stl
3d_models/body_motor_holder - BodyMotorHolder (1).stl
onshape_export/robot/assets/2_54_mm_dupont_male_pin_header__io__2x20__rpi4modelb__imported1.stl
onshape_export/robot/assets/2_54_mm_dupont_male_pin_header__io__2x20__rpi4modelb__imported12.stl
onshape_export/robot/assets/2_54_mm_dupont_male_pin_header__io__2x20__rpi4modelb__imported22.stl
onshape_export/robot/assets/2_54_mm_dupont_male_pin_header__io__2x20__rpi4modelb__imported40.stl
onshape_export/robot/assets/2_54_mm_dupont_male_pin_header__io__2x20__rpi4modelb__imported6.stl
onshape_export/robot/assets/2_54_mm_dupont_male_pin_header__io__2x20__rpi4modelb__imported7.stl
onshape_export/robot/assets/biella_mirrored.stl
onshape_export/robot/assets/bno085_9axis_imu_v1_1__body13.stl
onshape_export/robot/assets/bno085_9axis_imu_v1_1__body20.stl
onshape_export/robot/assets/body_tssop_1__body1.stl
onshape_export/robot/assets/bodymotorholder_mirrored.stl
onshape_export/robot/assets/bss138ps_v2_1__body4.stl
onshape_export/robot/assets/camera_connector__rpi4modelb__imported14.stl
onshape_export/robot/assets/camera_connector__rpi4modelb__imported17.stl
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
