A-Common-Guy/bipedale/sandro_rl/policies/step_climb/eval/comparison.md

Policy runs with wheel_lag 0.04 s; the WBC without (sandro_sim has no lag).

**hardware/nominal** — policy completed, WBC completed

| phase | command | truth_pitch_rms | truth_speed_err_rms | pitch_rms | pitch_peak_hz | vel_err_rms | yaw_err_rms | yaw_rise_s | height_err | wheel_tau_rms | wheel_flip_frac | leg_eff_rms |
|---|---|---|---|---|---|---|---|---|---|---|---|---|
| 0 policy | 5,0,0 | 0.001 | 0.035 | 0.008 | 6.400 | 0.029 | 0.021 | nan | -0.003 | 0.531 | 0.000 | 0.822 |
| 0 wbc | 5,0,0 | 0.023 | 0.064 | 0.024 | 0.400 | 0.093 | 0.064 | nan | 0.002 | 0.242 | 0.010 | 0.771 |
| 1 policy | 4,0.2,0 | 0.017 | 0.073 | 0.020 | 16.000 | 0.087 | 0.034 | nan | -0.006 | 0.619 | 0.002 | 0.821 |
| 1 wbc | 4,0.2,0 | 0.006 | 0.038 | 0.009 | 23.750 | 0.051 | 0.101 | nan | 0.001 | 0.373 | 0.000 | 0.781 |
| 2 policy | 4,0,0 | 0.021 | 0.075 | 0.024 | 0.500 | 0.099 | 0.018 | nan | -0.003 | 0.451 | 0.017 | 0.826 |
| 2 wbc | 4,0,0 | 0.030 | 0.090 | 0.031 | 0.500 | 0.109 | 0.104 | nan | 0.001 | 0.295 | 0.006 | 0.795 |
| 3 policy | 4,0.2,0.6 | 0.016 | 0.267 | 0.019 | 7.750 | 0.084 | 0.084 | 0.160 | -0.006 | 0.571 | 0.002 | 1.029 |
| 3 wbc | 4,0.2,0.6 | 0.024 | 0.214 | 0.026 | 0.500 | 0.120 | 0.199 | 1.420 | 0.001 | 0.549 | 0.001 | 0.905 |
| 4 policy | 3,0,0 | 0.024 | 0.122 | 0.026 | 0.333 | 0.119 | 0.039 | 0.000 | -0.003 | 0.479 | 0.019 | 0.846 |
| 4 wbc | 3,0,0 | 0.033 | 0.126 | 0.034 | 0.333 | 0.107 | 0.142 | 0.000 | 0.001 | 0.346 | 0.004 | 0.828 |

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
| 6 wbc | 2,0,0 | 0.021 | 0.047 | 0.022 | 0.500 | 0.082 | 0.075 | nan | -0.007 | 0.274 | 0.015 | 0.699 |
| 7 policy | 3,0,0,-0.05 | 0.015 | 0.017 | 0.017 | 0.333 | 0.030 | 0.037 | nan | 0.006 | 0.419 | 0.011 | 0.980 |
| 7 wbc | 3,0,0,-0.05 | 0.022 | 0.047 | 0.025 | 0.333 | 0.070 | 0.044 | nan | 0.008 | 0.258 | 0.004 | 0.881 |
| 8 policy | 2,0,0 | 0.001 | 0.007 | 0.009 | 10.500 | 0.008 | 0.005 | nan | 0.011 | 0.321 | 0.035 | 1.154 |
| 8 wbc | 2,0,0 | 0.017 | 0.029 | 0.017 | 0.500 | 0.049 | 0.037 | nan | 0.009 | 0.183 | 0.015 | 0.946 |
| 9 policy | 3,0,0,0.05 | 0.014 | 0.030 | 0.016 | 0.333 | 0.031 | 0.030 | nan | -0.008 | 0.399 | 0.006 | 1.004 |
| 9 wbc | 3,0,0,0.05 | 0.023 | 0.056 | 0.025 | 0.333 | 0.086 | 0.070 | nan | -0.006 | 0.287 | 0.013 | 0.800 |
| 10 policy | 3,0,0 | 0.003 | 0.023 | 0.009 | 3.000 | 0.017 | 0.022 | nan | -0.016 | 0.345 | 0.011 | 0.766 |
| 10 wbc | 3,0,0 | 0.020 | 0.048 | 0.022 | 0.333 | 0.073 | 0.048 | nan | -0.007 | 0.254 | 0.014 | 0.710 |

**default/worst** — policy completed, WBC FELL

| phase | command | truth_pitch_rms | truth_speed_err_rms | pitch_rms | pitch_peak_hz | vel_err_rms | yaw_err_rms | yaw_rise_s | height_err | wheel_tau_rms | wheel_flip_frac | leg_eff_rms |
|---|---|---|---|---|---|---|---|---|---|---|---|---|
| 0 policy | 3,0,0 | 0.002 | 0.028 | 0.009 | 4.248 | 0.023 | 0.020 | nan | -0.003 | 0.457 | 0.002 | 0.822 |
| 0 wbc | 3,0,0 | nan | nan | nan | nan | nan | nan | nan | nan | nan | nan | nan |
| 1 policy | 4,0.3,0 | 0.035 | 0.069 | 0.038 | 2.538 | 0.216 | 0.049 | nan | -0.007 | 1.746 | 0.002 | 0.818 |
| 1 wbc | 4,0.3,0 | nan | nan | nan | nan | nan | nan | nan | nan | nan | nan | nan |
| 2 policy | 3,0,0 | 0.046 | 0.115 | 0.048 | 0.333 | 0.239 | 0.040 | nan | -0.004 | 1.981 | 0.013 | 0.835 |
| 2 wbc | 3,0,0 | nan | nan | nan | nan | nan | nan | nan | nan | nan | nan | nan |
| 3 policy | 4,0.3,1.0 | 0.049 | 0.403 | 0.051 | 0.750 | 0.313 | 0.187 | 0.160 | -0.007 | 2.328 | 0.009 | 1.026 |
| 3 wbc | 4,0.3,1.0 | nan | nan | nan | nan | nan | nan | nan | nan | nan | nan | nan |
| 4 policy | 3,0,0 | 0.041 | 0.186 | 0.042 | 0.333 | 0.230 | 0.104 | 0.000 | -0.004 | 1.826 | 0.008 | 0.851 |
| 4 wbc | 3,0,0 | nan | nan | nan | nan | nan | nan | nan | nan | nan | nan | nan |
| 5 policy | 3,0,0,1.2 | 0.011 | 0.039 | 0.014 | 0.333 | 0.038 | 0.024 | nan | -0.016 | 0.437 | 0.016 | 0.778 |
| 5 wbc | 3,0,0,1.2 | nan | nan | nan | nan | nan | nan | nan | nan | nan | nan | nan |
| 6 policy | 2,0,0 | 0.005 | 0.019 | 0.008 | 0.500 | 0.013 | 0.022 | nan | -0.016 | 0.370 | 0.013 | 0.767 |
| 6 wbc | 2,0,0 | nan | nan | nan | nan | nan | nan | nan | nan | nan | nan | nan |
| 7 policy | 3,0,0,-0.05 | 0.015 | 0.020 | 0.017 | 0.333 | 0.030 | 0.039 | nan | 0.006 | 0.430 | 0.007 | 0.988 |
| 7 wbc | 3,0,0,-0.05 | nan | nan | nan | nan | nan | nan | nan | nan | nan | nan | nan |
| 8 policy | 2,0,0 | 0.000 | 0.006 | 0.008 | 10.500 | 0.007 | 0.005 | nan | 0.011 | 0.359 | 0.041 | 1.155 |
| 8 wbc | 2,0,0 | nan | nan | nan | nan | nan | nan | nan | nan | nan | nan | nan |
| 9 policy | 3,0,0,0.05 | 0.014 | 0.033 | 0.016 | 0.333 | 0.035 | 0.030 | nan | -0.008 | 0.477 | 0.006 | 0.995 |
| 9 wbc | 3,0,0,0.05 | nan | nan | nan | nan | nan | nan | nan | nan | nan | nan | nan |
| 10 policy | 3,0,0 | 0.003 | 0.028 | 0.009 | 2.667 | 0.023 | 0.024 | nan | -0.016 | 0.438 | 0.007 | 0.766 |
| 10 wbc | 3,0,0 | nan | nan | nan | nan | nan | nan | nan | nan | nan | nan | nan |

**push/nominal** — policy completed, WBC completed

| phase | command | truth_pitch_rms | truth_speed_err_rms | pitch_rms | pitch_peak_hz | vel_err_rms | yaw_err_rms | yaw_rise_s | height_err | wheel_tau_rms | wheel_flip_frac | leg_eff_rms |
|---|---|---|---|---|---|---|---|---|---|---|---|---|
| 0 policy | 10,0,0 | 0.015 | 0.058 | 0.017 | 0.400 | 0.076 | 0.021 | nan | -0.003 | 0.570 | 0.008 | 0.824 |
| 0 wbc | 10,0,0 | 0.023 | 0.067 | 0.024 | 0.300 | 0.105 | 0.074 | nan | 0.001 | 0.250 | 0.015 | 0.778 |

**push/uart_imu** — policy completed, WBC completed

| phase | command | truth_pitch_rms | truth_speed_err_rms | pitch_rms | pitch_peak_hz | vel_err_rms | yaw_err_rms | yaw_rise_s | height_err | wheel_tau_rms | wheel_flip_frac | leg_eff_rms |
|---|---|---|---|---|---|---|---|---|---|---|---|---|
| 0 policy | 10,0,0 | 0.016 | 0.055 | 0.018 | 0.400 | 0.086 | 0.022 | nan | -0.003 | 0.583 | 0.009 | 0.825 |
| 0 wbc | 10,0,0 | 0.023 | 0.071 | 0.025 | 0.400 | 0.118 | 0.083 | nan | 0.001 | 0.303 | 0.010 | 0.776 |

**push/worst** — policy completed, WBC FELL

| phase | command | truth_pitch_rms | truth_speed_err_rms | pitch_rms | pitch_peak_hz | vel_err_rms | yaw_err_rms | yaw_rise_s | height_err | wheel_tau_rms | wheel_flip_frac | leg_eff_rms |
|---|---|---|---|---|---|---|---|---|---|---|---|---|
| 0 policy | 10,0,0 | 0.021 | 0.057 | 0.022 | 0.600 | 0.110 | 0.023 | nan | -0.003 | 0.753 | 0.007 | 0.824 |
| 0 wbc | 10,0,0 | nan | nan | nan | nan | nan | nan | nan | nan | nan | nan | nan |
