A-Common-Guy/bipedale/sandro_rl/policies/step_climb/eval/lag_sweep.md

| scenario | wheel lag (s) | result | wheel effort RMS R/L (Nm) | peak (Hz) | 5-15 Hz share |
|---|---|---|---|---|---|
| hardware | 0.000 | completed | 0.27 / 0.24 | 0.1 / 0.0 | 0.03 |
| hardware | 0.035 | completed | 0.25 / 0.20 | 0.1 / 0.0 | 0.03 |
| hardware | 0.050 | completed | 0.25 / 0.20 | 0.1 / 0.0 | 0.03 |
| hardware | 0.080 | completed | 0.25 / 0.21 | 0.1 / 0.0 | 0.03 |
| default | 0.000 | completed | 0.28 / 0.23 | 0.0 / 0.1 | 0.03 |
| default | 0.035 | completed | 0.26 / 0.20 | 0.1 / 0.1 | 0.03 |
| default | 0.050 | completed | 0.26 / 0.20 | 0.1 / 0.1 | 0.02 |
| default | 0.080 | completed | 0.26 / 0.20 | 0.1 / 0.1 | 0.01 |
| push | 0.000 | completed | 0.18 / 0.20 | 0.4 / 0.4 | 0.06 |
| push | 0.035 | completed | 0.12 / 0.14 | 0.1 / 0.1 | 0.09 |
| push | 0.050 | completed | 0.13 / 0.14 | 0.1 / 0.1 | 0.10 |
| push | 0.080 | completed | 0.13 / 0.14 | 0.1 / 0.1 | 0.12 |
