A-Common-Guy/bipedale/sandro_rl/policies/step_climb/train_log_lag.csv

iteration | env_steps | wall_s | steps_per_s | episode_return | episode_length_s | fall_rate | action_std | entropy | kl | learning_rate | m/action_accel | m/action_rate | m/alive | m/cat_delta | m/clearance_min | m/err_forward | m/err_height | m/err_roll | m/err_yaw | m/jump_active | m/jump_clearance | m/jump_overshoot | m/jump_vz | m/leg_symmetry | m/leg_torque | m/leg_velocity | m/pitch | m/pitch_rate | m/roll | m/termination | m/tilt | m/track_forward | m/track_height | m/track_roll | m/track_yaw | m/vertical_velocity | m/wheel_torque | reward_per_step | surrogate | symmetry | value_loss
1 | 196608 | 21.7 | 9069 | -1.1952264308929443 | 0.181666666666594 | 0.030517578125 | 0.29955071210861206 | 1.2981758117675781 | 0.011709648184478283 | 0.0003000000142492354 | -0.00012849891209043562 | -0.00025699782418087125 | 0.010000001639127731 | 0.07924122363328934 | -0.00040265379357151687 | 0.2356199026107788 | 0.008155399933457375 | 0.043282441794872284 | 0.7775225639343262 | 0.0 | 0.0 | 0.0 | 0.0 | -0.001301672076806426 | -0.0009498728322796524 | -0.0007173928315751255 | -0.0007104208925738931 | -0.002315846271812916 | -0.00022495570010505617 | -3.0517578125e-05 | 0.07893629372119904
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
