A-Common-Guy/bipedale/sandro_rl/policies/step_climb/train_log.csv

iteration | env_steps | wall_s | steps_per_s | episode_return | episode_length_s | fall_rate | action_std | entropy | kl | learning_rate | m/action_accel | m/action_rate | m/alive | m/cat_delta | m/clearance_min | m/err_forward | m/err_height | m/err_roll | m/err_yaw | m/jump_active | m/jump_clearance | m/jump_overshoot | m/jump_vz | m/leg_symmetry | m/leg_torque | m/leg_velocity | m/pitch | m/pitch_rate | m/roll | m/termination | m/tilt | m/track_forward | m/track_height | m/track_roll | m/track_yaw | m/vertical_velocity | m/wheel_torque | reward_per_step | surrogate | symmetry | value_loss
1 | 196608 | 18.7 | 10536 | nan | nan | 0.0 | 0.10984494537115097 | -6.088084697723389 | 0.04194009304046631 | 9.999999747378752e-06 | -2.7906788091058843e-05 | -5.5813576182117686e-05 | 0.010000001639127731 | 1.0265874152537435e-05 | -0.0006932406686246395 | 0.19676588475704193 | 0.006507406942546368 | 0.02787191793322563 | 0.2776159644126892 | 0.0 | 0.0 | 0.0 | 0.0 | -0.001445896690711379 | -0.0001248133194167167 | -9.257392957806587e-05 | -0.00029311925754882395 | -0.0004962105886079371 | -8.182186138583347e-05 | 0.0 | 0.0484846793115139 | 0.02132166177034378 | 0.018858900293707848 |
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
