A-Common-Guy/bipedale/sandro_rl/policies/step_climb/curves.png

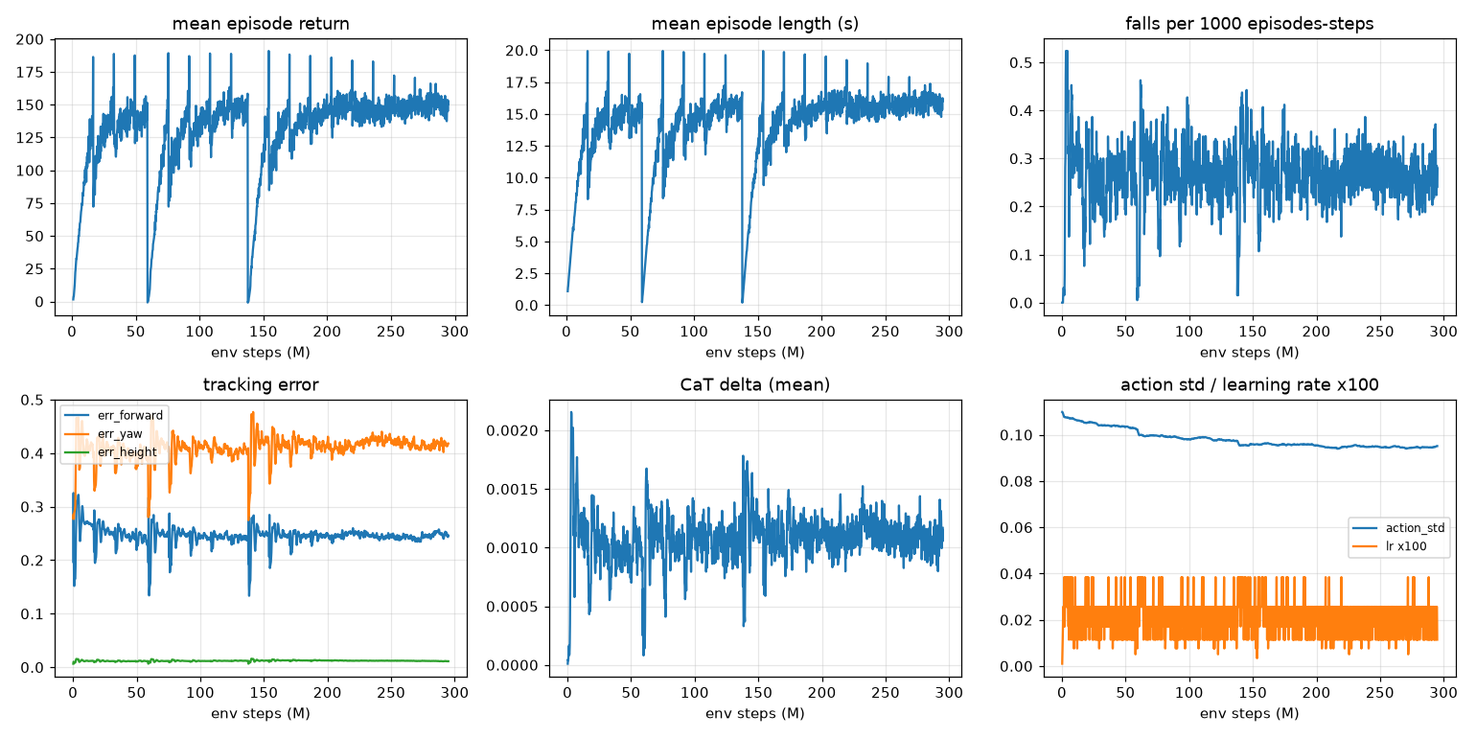
sandro_rl/policies/step_climb/curves.png
