A-Common-Guy/bipedale/sandro_rl/policies/step_climb/eval/steps.png

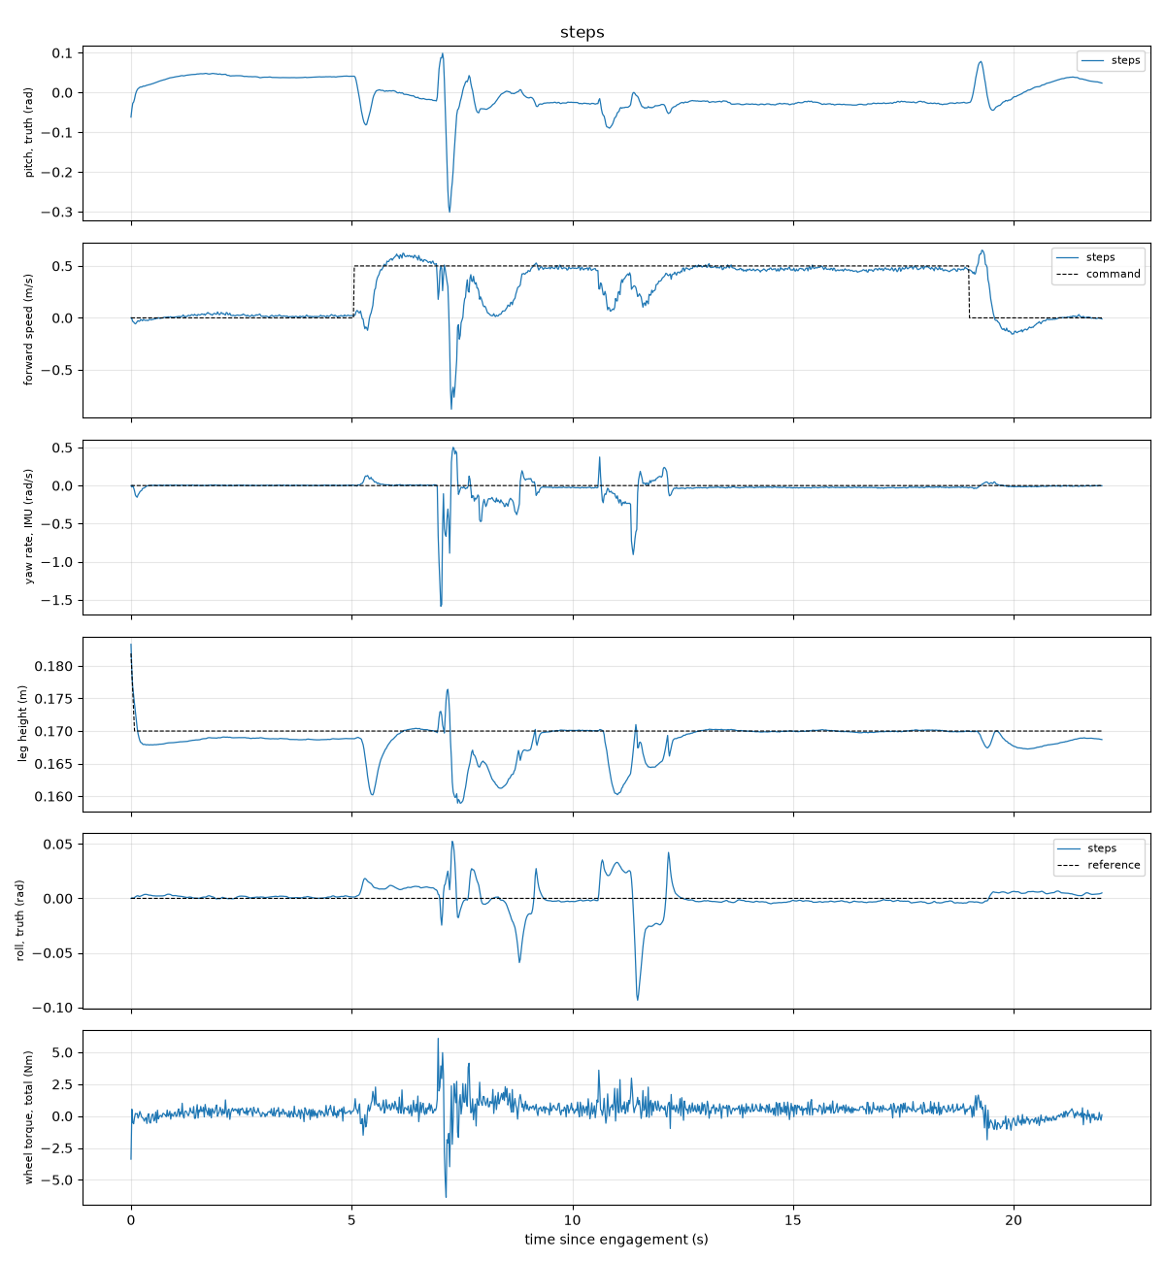
sandro_rl/policies/step_climb/eval/steps.png
