A-Common-Guy/bipedale/sandro_rl/policies/step_climb/eval/steps_frames.png

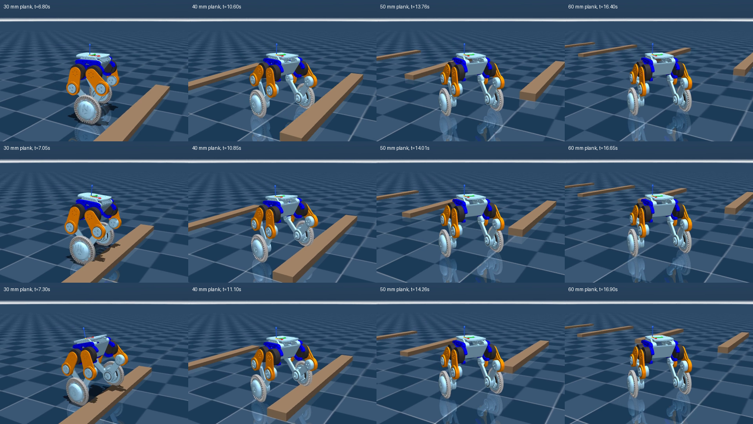
sandro_rl/policies/step_climb/eval/steps_frames.png
