A-Common-Guy/bipedale/onshape_export/robot/robot_full.xml

<mujoco model="robot">
  <compiler angle="radian" meshdir="assets"/>

  <option integrator="implicitfast"/>

  <size nkey="1"/>

  <default>
    <default class="robot">
      <joint armature="0.005" frictionloss="0.1"/>
      <general input="pos" biastype="affine" gainprm="50" biasprm="0 -50 1"/>
      <default class="visual">
        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
      </default>
      <default class="collision">
        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
      </default>
    </default>
    <default class="right_main">
      <default class="right_leg">
        <joint armature="0.005" frictionloss="0.1"/>
        <general input="pos" biastype="affine" gainprm="50" biasprm="0 -50 1"/>
        <default class="right_visual">
          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
        </default>
        <default class="right_collision">
          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
        </default>
      </default>
    </default>
    <default class="left_main">
      <default class="left_leg_left">
        <joint armature="0.005" frictionloss="0.1"/>
        <general input="pos" biastype="affine" gainprm="50" biasprm="0 -50 1"/>
        <default class="left_visual">
          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
        </default>
        <default class="left_collision">
          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
        </default>
      </default>
    </default>
  </default>

  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

  <worldbody>
    <body name="torso" childclass="robot">
      <inertial pos="0.06574 0.375747 -0.351331" quat="0.544017 0.545487 0.45134 0.450312" mass="1.05" diaginertia="0.00369012 0.00277172 0.00276242"/>
      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
      <frame name="right_mount" pos="0.0574033 0.227643 -0.224419" quat="0.999057 0 0 0.0434255">
        <body name="right_bodymotorholder" childclass="right_leg">
          <inertial pos="0.058335 0.135685 0.0193059" quat="0.65109 0.703082 0.0742638 -0.276122" mass="0.808243" diaginertia="0.00208236 0.00198527 0.000485113"/>
          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
          <body name="right_motor_shaft_2" pos="0.0460054 0.0924467 -0.0259126" quat="0 -0.689287 0.724489 0">
            <inertial pos="0.0238056 -0.0378871 -0.0108017" quat="0.337264 0.628443 -0.34812 0.608379" mass="0.0210838" diaginertia="3.91846e-05 3.17349e-05 8.16783e-06"/>
            <joint name="right_motor_inner" armature="0.00016832" damping="0.01"/>
            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
            <body name="right_bearing_5_2_4_0_7" pos="0.0425666 -0.067881 -0.0035" quat="0.96821 0 0 -0.250137">
              <inertial pos="0 -0.0405227 0.00117769" quat="0.54222 0.45387 -0.45387 0.54222" mass="0.176318" diaginertia="0.000719116 0.000686113 5.54955e-05"/>
              <joint name="right_passive_biella_inner" armature="1e-05" damping="0.001" frictionloss="0.005"/>
              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
            </body>
          </body>
          <body name="right_motor_shaft_2_2" pos="0.0720208 0.178605 -0.0259126" quat="0 0.756284 0.654243 0">
            <inertial pos="0.0324126 0.0612196 -0.00816622" quat="0.601266 0.367095 -0.610795 0.361455" mass="0.0687299" diaginertia="8.30945e-05 6.32511e-05 2.14075e-05"/>
            <joint name="right_motor_outer" armature="0.00016832" damping="0.01"/>
            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
            <body name="right_bearing_5_2_4_0_7_2" pos="0.0375033 0.0708042 -0.0215" quat="0 -0.942361 -0.334598 0">
              <inertial pos="-0.00788446 -0.110314 0.0556437" quat="0.884961 0.46437 -0.017924 -0.0297109" mass="0.493267" diaginertia="0.00180902 0.00168048 0.000356521"/>
              <joint name="right_passive_biella_outer" armature="1e-05" damping="0.001" frictionloss="0.005"/>
              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
              <body name="right_motor_shaft_2_3" pos="-0.00936367 -0.129662 0.0257" quat="0 0 1 0">
                <inertial pos="9.066e-09 1.3242e-08 0.0082226" quat="0.653281 0.270598 -0.653281 0.270598" mass="0.0583748" diaginertia="0.000160953 8.58914e-05 8.58914e-05"/>
                <joint name="right_wheel" armature="0.00016832" damping="0.01"/>
                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
              </body>
            </body>
          </body>
        </body>
      </frame>
      <frame name="left_mount" pos="0.117603 0.515205 -0.478244" quat="0 0.968961 -0.247215 0">
        <frame quat="1 0 0 0">
          <body name="left_bodymotorholder" childclass="left_leg_left" quat="1 0 0 0">
            <inertial pos="0.058335 0.135685 0.0193059" quat="0.65109 0.703082 0.0742638 -0.276122" mass="0.808243" diaginertia="0.00208236 0.00198527 0.000485113"/>
            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
            <body name="left_motor_shaft_2" pos="0.0460054 0.0924467 -0.0259126" quat="0 0.488069 -0.872805 0">
              <inertial pos="0.0238056 -0.0378871 -0.0108017" quat="0.337264 0.628443 -0.34812 0.608379" mass="0.0210838" diaginertia="3.91846e-05 3.17349e-05 8.16783e-06"/>
              <joint name="left_motor_inner" armature="0.00016832" damping="0.01"/>
              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
              <body name="left_bearing_5_2_4_0_7" pos="0.0425666 -0.067881 -0.0112" quat="0 0.997484 0.070887 0">
                <inertial pos="-0.100597 0.00718996 0.0604651" quat="0.346492 0.643725 0.602235 0.320741" mass="0.540913" diaginertia="0.00256725 0.00244671 0.000374148"/>
                <joint name="left_passive_biella_outer" armature="1e-05" damping="0.001" frictionloss="0.005"/>
                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
                <body name="left_motor_shaft_2_2" pos="-0.129662 0.00936367 0.0367" quat="0 -0.707107 -0.707107 0">
                  <inertial pos="1.455e-09 -1.5982e-08 0.0082226" quat="0.559572 0.432296 -0.559572 0.432296" mass="0.0583748" diaginertia="0.000160953 8.58915e-05 8.58914e-05"/>
                  <joint name="left_wheel" armature="0.00016832" damping="0.01"/>
                  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
                </body>
              </body>
            </body>
            <body name="left_motor_shaft_2_3" pos="0.0720208 0.178605 -0.0259126" quat="0 0.584286 0.811548 0">
              <inertial pos="0.0209083 0.0395598 -0.0108017" quat="0.615702 0.35824 -0.596268 0.370188" mass="0.0210838" diaginertia="3.91846e-05 3.17349e-05 8.16788e-06"/>
              <joint name="left_motor_outer" armature="0.00016832" damping="0.01"/>
              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
              <body name="left_bearing_5_2_4_0_7_2" pos="0.0375033 0.0708042 -0.0112" quat="0 0.698198 -0.715905 0">
                <inertial pos="0 0.0405227 -0.00817769" quat="0.54222 0.45387 -0.45387 0.54222" mass="0.176318" diaginertia="0.000719116 0.000686113 5.54955e-05"/>
                <joint name="left_passive_biella_inner" armature="1e-05" damping="0.001" frictionloss="0.005"/>
                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
              </body>
            </body>
          </body>
        </frame>
      </frame>
      <body name="raspberry_pi" pos="0.010242 0.314045 -0.352678">
        <inertial pos="0 0 0" quat="0.818308 0.0583643 -0.0495217 0.56966" mass="0.095" diaginertia="7.24653e-05 6.14623e-05 2.8303e-05"/>
      </body>
      <frame name="imu_mount" pos="0.00761387 0.355449 -0.351366" quat="0.548841 -0.548841 -0.445841 0.445841">
        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
      </frame>
    </body>
  </worldbody>

  <equality>
    <connect site1="right_closing_manovelle_meeting_r_1" site2="right_closing_manovelle_meeting_r_2"/>
    <connect site1="right_closing_manovelle_meeting_r_1_z" site2="right_closing_manovelle_meeting_r_2_z"/>
    <connect site1="left_closing_manovelle_meeting_l_1" site2="left_closing_manovelle_meeting_l_2"/>
    <connect site1="left_closing_manovelle_meeting_l_1_z" site2="left_closing_manovelle_meeting_l_2_z"/>
  </equality>

  <actuator>
    <general name="right_motor_inner" joint="right_motor_inner" forcerange="-11 11" biastype="affine" gainprm="20" biasprm="0 -20 -0.5"/>
    <general name="right_motor_outer" joint="right_motor_outer" forcerange="-11 11" biastype="affine" gainprm="20" biasprm="0 -20 -0.5"/>
    <general name="right_wheel" joint="right_wheel" ctrlrange="-44 44" forcerange="-11 11" biastype="affine" biasprm="0 0 -1"/>
    <general name="left_motor_inner" joint="left_motor_inner" forcerange="-11 11" biastype="affine" gainprm="20" biasprm="0 -20 -0.5"/>
    <general name="left_motor_outer" joint="left_motor_outer" forcerange="-11 11" biastype="affine" gainprm="20" biasprm="0 -20 -0.5"/>
    <general name="left_wheel" joint="left_wheel" ctrlrange="-44 44" forcerange="-11 11" biastype="affine" biasprm="0 0 -1"/>
  </actuator>

  <sensor>
    <framequat objtype="site" objname="imu" name="imu_quat" noise="0.017"/>
    <gyro site="imu" name="imu_gyro" noise="0.002"/>
    <accelerometer site="imu" name="imu_accel" noise="0.02"/>
    <jointpos joint="right_motor_inner" name="right_motor_inner_pos"/>
    <jointvel joint="right_motor_inner" name="right_motor_inner_vel"/>
    <jointpos joint="right_motor_outer" name="right_motor_outer_pos"/>
    <jointvel joint="right_motor_outer" name="right_motor_outer_vel"/>
    <jointpos joint="right_wheel" name="right_wheel_pos"/>
    <jointvel joint="right_wheel" name="right_wheel_vel"/>
    <jointpos joint="left_motor_inner" name="left_motor_inner_pos"/>
    <jointvel joint="left_motor_inner" name="left_motor_inner_vel"/>
    <jointpos joint="left_motor_outer" name="left_motor_outer_pos"/>
    <jointvel joint="left_motor_outer" name="left_motor_outer_vel"/>
    <jointpos joint="left_wheel" name="left_wheel_pos"/>
    <jointvel joint="left_wheel" name="left_wheel_vel"/>
  </sensor>

  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
</mujoco>
