A-Common-Guy/bipedale/sandro_rl/sandro_rl/evaluate.py

"""Run an exported policy in CPU MuJoCo with the full latency emulation.

    uv run python -m sandro_rl.evaluate policies/flat_tracking --scenario hardware
    uv run python -m sandro_rl.evaluate policies/flat_tracking --compare      # vs the WBC, all profiles
    uv run python -m sandro_rl.evaluate policies/flat_tracking --scenario default --video out.mp4

The loop is sandro_sim/tools/closed_loop/closed_loop.cpp with the
whole-body controller replaced by the policy:
  - MuJoCo on scene_ros2.xml from the stand keyframe, 0.03 s unpowered;
  - the controller manager's wake-up rule (first physics step at or past the
    last wake plus 1/300 s);
  - LatencySystem's read: a DelayLine per state interface (joint position,
    velocity and effort on the joint's staggered broadcast clock, the ten IMU
    values on the IMU clock), the MJCF IMU noise added per read;
  - LatencySystem's write and MitDrivePlugin: every frame onto a DriveBus,
    due command_delay later, the MIT law on the live joint state before every
    physics step;
  - drive_test.py's commands at 20 Hz from closed_loop.py's scenarios, a
    3 s settle after engagement, the same pushes.
The deployment-side controller (interface.PolicyInterface) runs the policy
every third cycle and writes its frames every cycle. Recordings have
drive_test.py's layout plus three truth columns, so compare_runs.py reads
them next to the whole-body controller's.
"""

from __future__ import annotations

import argparse
import csv
import json
import math
import os
import sys
import tempfile
from collections import deque
from dataclasses import dataclass
from pathlib import Path

import mujoco
import numpy as np

from . import checkpoint, interface, kinematics, sources, torque_envelope
from .interface import PolicyInterface, quat_to_mat
from .robot import RobotSpec, rotation_x
from .sources import JOINTS

CLOSED_LOOP_DIR = sources.SRC / "sandro_sim" / "tools"
sys.path.insert(0, str(CLOSED_LOOP_DIR))
import closed_loop  # noqa: E402  (scenarios, pushes, gates and the WBC runner)
import compare_runs  # noqa: E402  (imported by closed_loop from sandro_bringup/tools)

DIAG_KEYS = [
    "engaged", "status_mask", "pitch_rad", "pitch_reference_rad", "pitch_rate_rad_s",
    "roll_rad", "roll_reference_rad", "forward_velocity_m_s", "velocity_reference_m_s",
    "position_error_m", "yaw_rate_rad_s", "wheel_yaw_rate_rad_s", "yaw_rate_reference_rad_s",
    "leg_height_m", "height_reference_m", "height_differential_m", "height_support_n",
    "leg_offset_m", "leg_offset_reference_m", "leg_offset_command_m", "leg_offset_model_m",
    "leg_offset_state_m", "leg_offset_rate_m_s", "trim_m", "balance_torque_nm",
    "yaw_torque_nm", "yaw_feedforward_nm", "truth_pitch_rad", "truth_speed_m_s"]
TRUTH_KEYS = ["truth_forward_m_s", "truth_yaw_rate_rad_s", "truth_height_m", "truth_roll_rad",
              "truth_wheel_clearance_m", "truth_axle_x_m", "truth_axle_y_m", "truth_tilt_rad",
              "truth_imu_height_m"]
IMU_COLUMNS = ["imu_qx", "imu_qy", "imu_qz", "imu_qw", "imu_gx", "imu_gy", "imu_gz", "imu_ax", "imu_ay", "imu_az"]

# Latency profiles of the comparison. "spi_slow" is the gate closed_loop.py
# uses for the slow end of the BNO085 SPI link; "worst" stacks it with the
# far ends of the joint and command delays measured on the robot
# (SIM_TO_REAL.md); "mit" is the joint timing of state_source:=mit.
PROFILES = {
    "nominal": {},
    "spi_slow": dict(closed_loop.SPI_IMU_SLOW),
    "worst": {**closed_loop.SPI_IMU_SLOW, "joint_delay": "0.005", "command_delay": "0.003"},
    "mit": dict(closed_loop.MIT_JOINTS),
}


class DelayLine:
    """sandro_sim/delay_line.hpp, line for line."""

    CAPACITY = 256

    def __init__(self, delay_s=0.0, rate_hz=0.0, phase_s=0.0, interpolate=False):
        self.delay = delay_s if math.isfinite(delay_s) and delay_s > 0 else 0.0
        self.period = 1.0 / rate_hz if math.isfinite(rate_hz) and rate_hz > 0 else 0.0
        self.phase = phase_s if math.isfinite(phase_s) else 0.0
        self.interpolate = interpolate
        self.samples: deque = deque(maxlen=self.CAPACITY)
        self.output = None
        self.last_index = None

    def update(self, now, value):
        if self.delay == 0.0 and self.period == 0.0:
            return value
        self.samples.append((now, value))
        sampled_at = now - self.delay
        index = None
        if self.period > 0:
            index = math.floor((now - self.delay - self.phase) / self.period + 1e-9)
            if self.output is not None and self.last_index == index:
                return self.output
            sampled_at = self.phase + index * self.period
        delayed = self._value_at(sampled_at)
        if delayed is not None:
            self.output = delayed
            self.last_index = index
        elif self.output is None:
            self.output = value
        return self.output

    def _value_at(self, t):
        before = None
        for i, (ts, _) in enumerate(self.samples):
            if ts <= t:
                before = i
            else:
                break
        if before is None:
            return None
        ta, va = self.samples[before]
        if not self.interpolate or before + 1 >= len(self.samples):
            return va
        tb, vb = self.samples[before + 1]
        span = tb - ta
        if not span > 0:
            return va
        return va + (vb - va) * (t - ta) / span


class DriveBus:
    """sandro_sim/drive_bus.hpp: a frame is due command_delay after its stamp."""

    def __init__(self, n, command_delay_s):
        self.delay = max(command_delay_s, 0.0)
        self.pending = [deque(maxlen=64) for _ in range(n)]
        self.current = [None] * n

    def push(self, joint, stamp, frame):
        self.pending[joint].append((stamp, frame))

    def due(self, now):
        for i, queue in enumerate(self.pending):
            while queue and queue[0][0] + self.delay <= now + 1e-9:
                self.current[i] = queue.popleft()[1]
        return self.current

    def clear(self):
        for q in self.pending:
            q.clear()
        self.current = [None] * len(self.current)


def yaw_chirp_nm(amplitude: float, t: float, f0: float = 2.0, f1: float = 25.0, duration: float = 20.0) -> float:
    """whole_body_core.cpp sysid_excitation_nm, mode 2: a linear chirp with 0.5 s tapers."""
    if amplitude <= 0.0 or t < 0.0 or t > duration:
        return 0.0
    phase = 2.0 * math.pi * (f0 * t + 0.5 * (f1 - f0) / duration * t * t)
    edge = min(max(min(t, duration - t) / 0.5, 0.0), 1.0)
    return amplitude * 0.5 * (1.0 - math.cos(math.pi * edge)) * math.sin(phase)


class Gear:
    """A wheel drive's rotor behind a gear with play: the rotor (the drive's
    reflected inertia, output-side units) is its own body, driven by the
    motor torque and coupled to the wheel by a spring and damper that act
    only beyond half the play either way. The drive's encoder, its MIT loop
    and so the policy see the rotor, not the wheel. Integrated in substeps
    within each physics step, with the wheel's state held; the drive law
    runs every substep, as the drive's own loop runs far above the physics
    rate (its damping on the light rotor is unstable at 1200 Hz)."""

    def __init__(self, inertia: float, play: float, stiffness: float, damping: float, substeps: int = 16):
        self.j, self.half, self.k, self.c, self.n = inertia, 0.5 * play, stiffness, damping, substeps
        self.q = self.v = 0.0

    def reset(self, q: float, v: float) -> None:
        self.q, self.v = q, v

    def step(self, law, wheel_q: float, wheel_v: float, dt: float) -> tuple[float, float]:
        """Advances the rotor by dt under law(q, v) -> motor torque; the mean
        motor torque and the mean torque the gear passed to the wheel."""
        h, passed, motor = dt / self.n, 0.0, 0.0
        for _ in range(self.n):
            tau = law(self.q, self.v)
            delta = self.q - wheel_q
            over = math.copysign(max(abs(delta) - self.half, 0.0), delta)
            torque = self.k * over + (self.c * (self.v - wheel_v) if over else 0.0)
            self.v += (tau - torque) / self.j * h
            self.q += self.v * h
            wheel_q += wheel_v * h
            passed += torque
            motor += tau
        return motor / self.n, passed / self.n


@dataclass
class SimOptions:
    imu_delay_s: float
    imu_rate_hz: float
    joint_delay_s: float
    joint_rate_hz: float
    joint_stagger: bool
    command_delay_s: float
    imu_noise: bool = True
    wheel_lag_s: float = 0.0
    # The wheel gear (Gear): total play (rad, output side), stiffness and
    # damping beyond it; 0 play keeps the rigid drive.
    wheel_backlash_rad: float = 0.0
    gear_stiffness_nm_rad: float = 100.0
    gear_damping_nm_s_rad: float = 0.02
    rotor_inertia_scale: float = 1.0
    # Deployment option: low-pass (Hz) on the opposed part of the wheel actions.
    wheel_differential_filter_hz: float = 0.0
    # The WBC's sysid chirp (sysid_excitation_nm, mode 2): +-amplitude per
    # wheel, opposed, added to the drives' torque from yaw_chirp_start_s
    # after engaging, 2-25 Hz over 20 s; 0 off.
    yaw_chirp_nm: float = 0.0
    yaw_chirp_start_s: float = 2.0
    # Factor on the tyres' torsional (scrub) friction and on the wheel joints'
    # Coulomb friction (frictionloss).
    tyre_torsion_scale: float = 1.0
    wheel_friction_scale: float = 1.0
    unpowered_s: float = 0.03
    settle_s: float = 3.0
    command_rate_hz: float = 20.0
    diagnostics_rate_hz: float = 50.0
    seed: int = 1

    @classmethod
    def from_closed_loop(cls, sim: dict[str, str], latency: sources.Latency) -> "SimOptions":
        o = cls(latency.imu_delay_s, latency.imu_rate_hz, latency.joint_delay_s, latency.joint_rate_hz,
                latency.joint_stagger, latency.command_delay_s)
        names = {"imu_delay": "imu_delay_s", "imu_rate": "imu_rate_hz", "joint_delay": "joint_delay_s",
                 "joint_rate": "joint_rate_hz", "command_delay": "command_delay_s", "settle": "settle_s",
                 "seed": "seed", "wheel_lag": "wheel_lag_s", "wheel_backlash": "wheel_backlash_rad",
                 "gear_stiffness": "gear_stiffness_nm_rad", "gear_damping": "gear_damping_nm_s_rad",
                 "tyre_torsion": "tyre_torsion_scale", "wheel_friction": "wheel_friction_scale",
                 "rotor_inertia": "rotor_inertia_scale",
                 "differential_filter": "wheel_differential_filter_hz",
                 "yaw_chirp": "yaw_chirp_nm", "yaw_chirp_start": "yaw_chirp_start_s"}
        for key, value in sim.items():
            if key == "joint_stagger":
                o.joint_stagger = value in ("true", "1")
            elif key == "imu_noise":
                o.imu_noise = value in ("true", "1")
            elif key in names:
                setattr(o, names[key], type(getattr(o, names[key]))(float(value)))
            else:
                raise ValueError(f"simulation option '{key}' is not emulated by the policy evaluator")
        return o


# Scenarios beyond closed_loop.py's, for policies trained past the WBC's
# envelope: drive_test.py's "duration,forward,yaw[,height_rate]" plus an
# optional fifth field, the body roll target in rad (roll-commanded policies).
EXTRA_SCENARIOS = {
    "agile": ["2,0,0", "3,0.6,0", "3,1.0,0", "3,0.8,2.0", "2,0,-3.0", "3,-0.5,0", "3,0,0,-0.1",
              "3,0.5,1.5", "3,0,0,0.1", "2,0,0"],
    "course": ["2,0,0", "3,0.5,0", "6,0.8,0", "2,0,0", "2,0,2.5", "4,0.6,0", "2,0,0"],
    # The course at the hardware's 0.5 m/s drive limit (controllers.yaml).
    "course_slow": ["2,0,0", "3,0.5,0", "8,0.5,0", "2,0,0", "2,0,2.5", "4,0.5,0", "2,0,0"],
    # For `--course steps`: straight over the four planks and onto the curb.
    "steps": ["2,0,0", "14,0.5,0", "3,0,0"],
    # Fields: duration, forward, yaw, height rate, roll. Roll is feasible up
    # to +-0.3 rad only near mid height (0.13 m), so the rolls happen there.
    "expressive": ["2,0,0", "3,0,0,-0.013,0", "3,0,0,0,0.3", "3,0,0,0,-0.3", "2,0,0,0,0",
                   "3,0,0,-0.013,0", "3,0,0,0.033,0", "4,0.4,1.0,0,0", "3,0,0,-0.017,0",
                   "3,0.3,0,0,-0.25", "3,-0.3,0,0,0.25", "2,0,0,0,0"],
    # Sixth field: jump height in m (jump-trained policies). A jump starts on
    # the phase's rising edge, so each jump phase is followed by a zero one.
    "jump": ["2,0,0", "1,0,0,0,0,0.03", "2,0,0", "1,0,0,0,0,0.05", "2,0,0", "1,0,0,0,0,0.08", "2,0,0",
             "2,0.5,0", "1,0.5,0,0,0,0.05", "2,0.5,0", "1,0.5,0,0,0,0.08", "2,0.5,0", "2,0,0"],
    # With --fallen: engaged lying down, 8 s to get up, then drive and turn.
    "stand_up": ["8,0,0", "3,0.4,0", "3,0,1.0", "2,0,0"],
    # Goal policies (avoid task) on an AVOID_COURSES layout: the forward field
    # is the cruise speed, the yaw rate is unused; the goals are the course's.
    "avoid": ["45,0.6,0"],
    "avoid_fast": ["45,1.0,0"],
    # Standing through the yaw chirp (--sim yaw_chirp=0.2): 2 s, 20 s of chirp, 2 s.
    "sysid": ["24,0,0"],
}
SCENARIOS = {**closed_loop.SCENARIOS, **EXTRA_SCENARIOS}

# The obstacle course of `--course`, along the start heading: planks 0.1 m
# deep and 1.2 m wide at these distances (m) and heights (m), then a hill
# (10 degree ramps, 0.6 m plateau, 1.6 m wide) 8 cm high centred at 5.0 m.
COURSE = [(1.0, 0.010), (1.8, 0.015), (2.6, 0.020), (3.4, 0.025)]
COURSE_HILL = {"distance_m": 5.0, "height_m": 0.08, "slope_deg": 10.0, "plateau_m": 0.6, "width_m": 1.6}
# `--course steps`: planks from 45 % to 90 % of the loaded tyre radius, then a
# 6 cm curb with 45 degree faces and a 0.8 m top.
COURSES = {
    "planks": (COURSE, COURSE_HILL),
    "steps": ([(1.0, 0.030), (2.0, 0.040), (3.0, 0.050), (4.0, 0.060)],
              {"distance_m": 5.4, "height_m": 0.06, "slope_deg": 45.0, "plateau_m": 0.8, "width_m": 1.6}),
    # The same curb alone, close enough that heading drift does not miss it.
    "curb": ([], {"distance_m": 1.5, "height_m": 0.06, "slope_deg": 45.0, "plateau_m": 0.8, "width_m": 1.6}),
}


# Courses of the goal policies, along the start heading (x ahead, y left, m):
# pillars as (x, y, depth, width, height, yaw deg) and the goals in order.
AVOID_COURSES = {
    # Three posts off the line, a wall across it, then back through them.
    "slalom": {"pillars": [(1.2, 0.0, 0.12, 0.12, 0.6, 0.0), (2.4, 0.35, 0.12, 0.12, 0.6, 0.0),
                           (3.6, -0.35, 0.12, 0.12, 0.6, 0.0), (5.0, 0.0, 0.1, 1.0, 0.6, 0.0)],
               "goals": [(6.2, 0.0), (0.0, 0.0)]},
    # A wide wall straight ahead: left or right is the policy's choice.
    "wall": {"pillars": [(1.5, 0.0, 0.1, 1.6, 0.6, 0.0)], "goals": [(3.0, 0.0)]},
}


GROUND_GROUPS = np.array([1, 0, 0, 0, 0, 0], dtype=np.uint8)   # floor and course geoms only


def _rise_ahead(m, d, spec, imu_site, ahead=(0.1, 0.2, 0.3, 0.4)) -> float:
    """Highest ground 0.1-0.4 m ahead of the axle, above the ground under it (rays from 0.1 m up)."""
    rt = d.site_xmat[imu_site].reshape(3, 3)
    heading = np.array([rt[0, 0], rt[1, 0], 0.0])
    heading /= max(np.linalg.norm(heading), 1e-9)
    axle = d.xanchor[spec.wheel_joint_ids].mean(axis=0)
    down = np.array([0.0, 0.0, -1.0])
    geom = np.zeros(1, dtype=np.int32)

    def ground(x):
        top = np.array([x[0], x[1], 0.1])
        dist = mujoco.mj_ray(m, d, top, down, GROUND_GROUPS, 1, -1, geom)
        return 0.1 - dist if dist >= 0 else 0.0

    under = ground(axle + 0.0 * heading)
    return max(ground(axle + a * heading) for a in ahead) - under


def course_model(spec: RobotSpec, layout: str = "planks", leg_boxes: bool = False) -> mujoco.MjModel:
    """The course compiled in place (static geoms collide only where compiled)."""
    from . import terrain

    planks, hill_cfg = COURSES[layout]
    d = mujoco.MjData(spec.model)
    mujoco.mj_resetDataKeyframe(spec.model, d, mujoco.mj_name2id(spec.model, mujoco.mjtObj.mjOBJ_KEY, "stand"))
    mujoco.mj_forward(spec.model, d)
    r = d.site_xmat[spec.imu_site].reshape(3, 3)
    heading = np.array([r[0, 0], r[1, 0], 0.0])
    heading /= np.linalg.norm(heading)
    start = d.xanchor[spec.wheel_joint_ids].mean(axis=0)
    yaw = math.atan2(heading[1], heading[0])
    quat = [math.cos(0.5 * yaw), 0.0, 0.0, math.sin(0.5 * yaw)]
    items, poses = [], []
    for i, (distance, height) in enumerate(planks):
        plank = terrain.boxes({"type": "obstacles", "planks": {
            "count": 1, "height_m": [height, height], "depth_m": [0.1, 0.1], "width_m": [1.2, 1.2]}})[0]
        plank["name"] = f"{terrain.OBSTACLE_PREFIX}course_plank{i}"
        centre = start + distance * heading
        items.append(plank)
        poses.append(([centre[0], centre[1], height], quat))
    h = hill_cfg
    hill = terrain.boxes({"type": "obstacles", "hills": {
        "count": 1, "height_m": [h["height_m"]] * 2, "slope_deg": [h["slope_deg"]] * 2,
        "plateau_m": [h["plateau_m"]] * 2, "width_m": [h["width_m"]] * 2}})[0]
    hill["name"] = f"{terrain.OBSTACLE_PREFIX}course_hill"
    centre = start + h["distance_m"] * heading
    items.append(hill)
    poses.append(([centre[0], centre[1], h["height_m"]], quat))
    return terrain.static_course(spec, items, poses, leg_boxes=leg_boxes)


def avoid_course_model(spec: RobotSpec, layout: str, leg_boxes: bool = False):
    """An AVOID_COURSES layout compiled in place: (model, goals [n, 2] in the
    world, pillar geom ids)."""
    from . import terrain

    course = AVOID_COURSES[layout]
    d = mujoco.MjData(spec.model)
    mujoco.mj_resetDataKeyframe(spec.model, d, mujoco.mj_name2id(spec.model, mujoco.mjtObj.mjOBJ_KEY, "stand"))
    mujoco.mj_forward(spec.model, d)
    r = d.site_xmat[spec.imu_site].reshape(3, 3)
    yaw = math.atan2(r[1, 0], r[0, 0])
    start = d.xanchor[spec.wheel_joint_ids].mean(axis=0)[:2]
    c, s = math.cos(yaw), math.sin(yaw)
    place = lambda x, y: start + np.array([c * x - s * y, s * x + c * y])
    items, poses = [], []
    for i, (x, y, depth, width, height, turn) in enumerate(course["pillars"]):
        items.append({"name": f"{terrain.OBSTACLE_PREFIX}course_pillar{i}", "kind": "pillar", "top": height,
                      "geoms": [{"pos": [0.0, 0.0, -0.5 * height], "euler_y": 0.0,
                                 "size": [0.5 * depth, 0.5 * width, 0.5 * height]}]})
        a = yaw + math.radians(turn)
        poses.append(([*place(x, y), height], [math.cos(0.5 * a), 0.0, 0.0, math.sin(0.5 * a)]))
    m = terrain.static_course(spec, items, poses, leg_boxes=leg_boxes)
    pillars = [g for g in range(m.ngeom)
               if (mujoco.mj_id2name(m, mujoco.mjtObj.mjOBJ_GEOM, g) or "").startswith(f"{terrain.OBSTACLE_PREFIX}course_pillar")]
    return m, np.array([place(x, y) for x, y in course["goals"]]), pillars


class OnnxPolicy:
    def __init__(self, path: Path):
        import onnxruntime as ort
        options = ort.SessionOptions()
        options.intra_op_num_threads = 1
        self.session = ort.InferenceSession(str(path), options, providers=["CPUExecutionProvider"])

    def __call__(self, obs: np.ndarray) -> np.ndarray:
        return self.session.run(None, {"obs": obs.astype(np.float32)[None]})[0][0].astype(float)


class PolicyController:
    """The deployment-side controller: what a ros2_control controller would run."""

    def __init__(self, iface: PolicyInterface, policy, fall_angle_rad: float):
        self.iface = iface
        self.policy = policy
        self.fall_angle = fall_angle_rad
        self.cycle = 0
        self.last_action = np.zeros(len(JOINTS))
        self.frames = iface.frames(self.last_action)
        self.history = None
        self.ref = None
        self.fallen = False
        self.jump_timer, self.jump_height, self.jump_request = -10.0, 0.0, 0.0
        self.differential_filter_hz, self.differential = 0.0, 0.0
        # Goal policies: set by the caller before each update (interface.goal_observation, ray_observation).
        self.goal_obs = interface.goal_observation(0.0, 0.0, iface.goal_range)
        self.ray_obs = np.ones(iface.n_rays)

    def reset(self, quat, gyro, accel, q, v, height_target):
        heights = self._heights(q)
        self.ref = np.array([0.0, 0.0, float(np.clip(np.mean(heights), self.iface.h_min, self.iface.h_max)),
                             0.0][: 4 if self.iface.has_roll else 3])
        self.height_command = height_target
        frame = self.iface.frame(quat, gyro, accel, q, v, self.last_action, self.ref,
                                 goal=self.goal_obs, rays=self.ray_obs)
        self.history = np.tile(frame, (self.iface.history_frames, 1))
        self.cycle = 0

    def _heights(self, q):
        lim = self.iface.spec.limits
        h, _, _ = kinematics.leg_state(np.asarray(q)[self.iface.leg_idx], lim.leg_geometry,
                                       lim.fore_aft_neutral_m, np)
        return h

    def update(self, quat, gyro, accel, q, v, command, period_s):
        """command: (forward m/s, yaw rad/s, height rate m/s[, roll rad]); the first three as /cmd_vel."""
        r = self.iface.body_rotation(quat)
        tilt = math.acos(float(np.clip(r[2, 2], -1.0, 1.0)))
        if tilt > self.fall_angle:
            self.fallen = True
        if self.fallen:
            # Safety fallback: drives limp with damping, as the WBC does on a fall.
            f = np.zeros((5, len(JOINTS)))
            f[3, :] = 0.5
            self.frames = f
            return self.frames
        if self.cycle % self.iface.cycles_per_action == 0:
            i = self.iface
            self.height_command = float(np.clip(self.height_command + np.clip(command[2], -i.h_rate, i.h_rate)
                                                * i.dt, i.h_min, i.h_max))
            yaw_rate = 0.0 if i.has_goal else np.clip(command[1], -i.yaw_max, i.yaw_max)
            target = np.array([np.clip(command[0], -i.v_max, i.v_max), yaw_rate,
                               self.height_command, command[3] if len(command) > 3 else 0.0])
            self.ref = i.shape(self.ref, target)
            jump = 0.0
            if i.has_jump:
                # A rising edge of the requested jump height opens a jump window.
                request = command[4] if len(command) > 4 else 0.0
                self.jump_timer -= i.dt
                if request > 0.0 and self.jump_request <= 0.0 and self.jump_timer <= 0.0:
                    self.jump_timer, self.jump_height = i.jump_window, request
                self.jump_request = request
                jump = i.jump_observation(self.jump_timer, self.jump_height)
            frame = i.frame(quat, gyro, accel, q, v, self.last_action, self.ref, jump,
                            goal=self.goal_obs, rays=self.ray_obs)
            self.history = np.concatenate([frame[None], self.history[:-1]], axis=0)
            action = np.clip(self.policy(self.history[:: i.history_stride].reshape(-1)), -i.clip, i.clip)
            self.last_action = action
            applied = action
            if self.differential_filter_hz > 0.0:
                # Low-pass on the opposed part of the wheel actions only.
                blend = 1.0 - math.exp(-2.0 * math.pi * self.differential_filter_hz * i.dt)
                half = 0.5 * (action[2] - action[5])
                self.differential += blend * (half - self.differential)
                common = 0.5 * (action[2] + action[5])
                applied = action.copy()
                applied[2], applied[5] = common + self.differential, common - self.differential
            self.frames = i.frames(applied)
        self.cycle += 1
        return self.frames


def run(policy_dir: Path, scenario: str, sim: dict[str, str], output: Path,
        video: Path | None = None, video_fps: int = 30, seed: int = 1,
        course: bool | str = False, heading_hold: float = 0.0,
        fallen_pitch: float | None = None, hop: bool = False) -> tuple[int, Path]:
    """`course`: a layout of COURSES, or True for "planks". `heading_hold`: gain
    (rad/s per rad) of an operator who steers back to the scenario's heading.
    `fallen_pitch`: start tipped by this pitch (rad, + nose down) and unpowered
    for 3 s, so the robot falls limp before the policy engages. `hop`: an
    operator who requests a jump when the ground 0.1-0.4 m ahead rises, as
    configs/step_climb_hop.yaml does in training."""
    policy_dir = Path(policy_dir)
    _, meta = checkpoint.load(policy_dir)
    checkpoint.check_model(meta)
    config = meta["config"]
    spec = RobotSpec.load()
    iface = PolicyInterface(config, spec)
    output.with_suffix(".avoid.json").unlink(missing_ok=True)
    lim = spec.limits
    options = SimOptions.from_closed_loop({"seed": str(seed), **sim}, spec.latency)
    rng = np.random.default_rng(options.seed)
    # A stand-up policy is engaged lying down: no fall cut-off.
    fall_angle = math.inf if config["env"]["init"].get("fallen") else lim.fall_angle_rad
    controller = PolicyController(iface, OnnxPolicy(policy_dir / "policy.onnx"), fall_angle)
    controller.differential_filter_hz = options.wheel_differential_filter_hz

    from . import terrain
    leg_boxes = bool((config["env"].get("collision") or {}).get("leg_boxes", False))
    goals_world, pillar_geoms = None, []
    if iface.has_goal:
        m, goals_world, pillar_geoms = avoid_course_model(spec, course if course in AVOID_COURSES else "slalom",
                                                          leg_boxes)
    else:
        m = (course_model(spec, "planks" if course is True else course, leg_boxes) if course
             else terrain.build(spec, {}, leg_boxes=True) if leg_boxes
             else mujoco.MjModel.from_xml_path(str(spec.scene)))
    d = mujoco.MjData(m)
    mujoco.mj_resetDataKeyframe(m, d, mujoco.mj_name2id(m, mujoco.mjtObj.mjOBJ_KEY, "stand"))
    if fallen_pitch is not None:
        from . import fallen
        d.qpos[:] = fallen.tipped_qpos(spec, m, fallen_pitch)
        options.unpowered_s = 3.0
    qadr, dadr, act = spec.joint_qpos, spec.joint_dof, spec.joint_actuator
    m.geom_friction[spec.tyre_geoms, 1] *= options.tyre_torsion_scale
    m.dof_frictionloss[dadr[spec.wheel_index]] *= options.wheel_friction_scale
    gears = {}
    if options.wheel_backlash_rad > 0.0:
        for i, name in enumerate(JOINTS):
            if "wheel" in name:
                # The reflected rotor inertia moves from the wheel joint to the rotor.
                gears[i] = Gear(float(m.dof_armature[dadr[i]]) * options.rotor_inertia_scale,
                                options.wheel_backlash_rad,
                                options.gear_stiffness_nm_rad, options.gear_damping_nm_s_rad)
                m.dof_armature[dadr[i]] = 0.0
    mujoco.mj_forward(m, d)
    for i, gear in gears.items():
        gear.reset(d.qpos[qadr[i]], d.qvel[dadr[i]])
    drive_q = lambda i: gears[i].q if i in gears else d.qpos[qadr[i]]
    drive_v = lambda i: gears[i].v if i in gears else d.qvel[dadr[i]]
    motor_torque = np.zeros(len(JOINTS))
    opposed = np.array([1.0 if name == "right_wheel" else -1.0 if name == "left_wheel" else 0.0 for name in JOINTS])
    sensors = [mujoco.mj_name2id(m, mujoco.mjtObj.mjOBJ_SENSOR, s) for s in ("imu_quat", "imu_gyro", "imu_accel")]
    sensor_of = [0, 0, 0, 0, 1, 1, 1, 2, 2, 2]
    torso, imu_site = spec.torso_body, spec.imu_site
    wheel_joints = spec.wheel_joint_ids
    body_from_imu = rotation_x(-spec.imu_roll_bias_rad)

    joint_period = 1.0 / options.joint_rate_hz if options.joint_rate_hz > 0 else 0.0
    joint_lines = [[DelayLine(options.joint_delay_s, options.joint_rate_hz,
                              joint_period * i / len(JOINTS) if options.joint_stagger else 0.0, True)
                    for _ in range(3)] for i in range(len(JOINTS))]
    imu_lines = [DelayLine(options.imu_delay_s, options.imu_rate_hz, 0.0, True) for _ in range(10)]
    fallback_lines = [[DelayLine(options.command_delay_s, 0.0) for _ in range(5)] for _ in range(len(JOINTS))]
    bus = DriveBus(len(JOINTS), options.command_delay_s)
    staged = np.zeros(m.nu)
    limits = iface.torque_limit
    heat = np.zeros(len(JOINTS))  # the drives' thermal envelope, from cold

    phases = [[float(x) for x in p.split(",")] + [0.0] * (6 - len(p.split(","))) for p in SCENARIOS[scenario]]
    pushes = [[float(x) for x in p.split(",")] for p in closed_loop.SCENARIO_PUSHES.get(scenario, [])]
    total_phase_s = sum(p[0] for p in phases)

    renderer = None
    frames_out = []
    if video is not None:
        os.environ.setdefault("MUJOCO_GL", "egl")
        renderer = mujoco.Renderer(m, 480, 640)
        camera = mujoco.MjvCamera()
        camera.type = mujoco.mjtCamera.mjCAMERA_TRACKING
        camera.trackbodyid = torso
        camera.distance, camera.elevation, camera.azimuth = 1.2, -15.0, 120.0
        last_frame_t = -1.0

    # env.py's drive-train lag on the wheel torque (wheel_lag, s).
    wheel_blend = 1.0 - math.exp(-m.opt.timestep / options.wheel_lag_s) if options.wheel_lag_s > 0 else 1.0
    wheel_act = [act[i] for i, name in enumerate(JOINTS) if "wheel" in name]
    wheel_tau = {a: 0.0 for a in wheel_act}

    if iface.has_goal:
        # Goal policies: goals kept by wheel odometry (interface.GoalOdometry),
        # each placed relative to the robot when it is given, as an operator
        # would; the scanner through mj_ray at its mean rate; the clearance
        # from mj_geomDistance between the robot's collision geoms and the pillars.
        goal_cfg = config["env"]["commands"]["goals"]
        rays_cfg = iface.rays
        odometry = interface.GoalOdometry(lim.wheel_radius_m)
        robot_geoms = [g for g in range(m.ngeom) if m.geom_bodyid[g] != 0 and g not in pillar_geoms
                       and (m.geom_contype[g] or m.geom_conaffinity[g])]
        avoid = {"goal": -1, "hold": 0.0, "reached": [], "min_gap_m": math.inf, "next_scan": 0.0, "done_at": -1.0}
        angles = interface.ray_angles(iface.n_rays, float(rays_cfg.get("fov_deg", 360.0))) if iface.n_rays else []
        scan_period = 1.0 / float(np.mean(rays_cfg["rate_hz"])) if iface.n_rays else 0.0
        hit_geom = np.zeros(1, dtype=np.int32)
        fromto = np.zeros(6)

    def exteroception(now, quat, gyro, vel, period):
        """The goal and scan observations of one control cycle."""
        r_meas = iface.body_rotation(quat)
        yaw_meas = math.atan2(r_meas[1, 0], r_meas[0, 0])
        pitch_rate = float((iface.body_from_imu_correction.T @ gyro)[1])
        rt = d.site_xmat[imu_site].reshape(3, 3) @ body_from_imu
        yaw_true = math.atan2(rt[1, 0], rt[0, 0])
        axle = d.xanchor[wheel_joints].mean(axis=0)[:2]

        def give(world):
            rel = world - axle
            c, s = math.cos(yaw_true), math.sin(yaw_true)
            odometry.set_goal(c * rel[0] + s * rel[1], -s * rel[0] + c * rel[1], yaw_meas)

        if odometry.goal is None:
            give(axle)                     # stand still until the phases start
        if phase_start >= 0 and avoid["goal"] < 0:
            avoid["goal"] = 0
            give(goals_world[0])
        odometry.update(vel[iface.wheel_idx], pitch_rate, yaw_meas, period)
        forward, left = odometry.relative()
        if 0 <= avoid["goal"] < len(goals_world):
            # Arrival as the robot judges it, from its odometry.
            near = math.hypot(forward, left) < goal_cfg["reach_m"]
            avoid["hold"] = avoid["hold"] + period if near else 0.0
            if avoid["hold"] >= goal_cfg.get("hold_s", 1.0):
                avoid["reached"].append({"goal": avoid["goal"], "t_s": round(now - phase_start, 3),
                                         "truth_error_m": round(float(np.linalg.norm(goals_world[avoid["goal"]] - axle)), 4)})
                avoid["goal"] += 1
                avoid["hold"] = 0.0
                if avoid["goal"] < len(goals_world):
                    give(goals_world[avoid["goal"]])
                else:
                    avoid["done_at"] = now
        controller.goal_obs = interface.goal_observation(forward, left, iface.goal_range)
        if iface.n_rays and now >= avoid["next_scan"]:
            avoid["next_scan"] = now + scan_period
            r_max = float(rays_cfg["max_range_m"])
            origin = d.site_xpos[imu_site] + rt @ np.asarray(rays_cfg.get("offset_m", [0.0, 0.0, 0.0]), float)
            dist = np.empty(iface.n_rays)
            for k, a in enumerate(angles):
                hit = mujoco.mj_ray(m, d, origin, rt @ np.array([math.cos(a), math.sin(a), 0.0]), GROUND_GROUPS,
                                    1, -1, hit_geom)
                dist[k] = r_max if hit < 0 else min(hit, r_max)
            dist = dist + (rays_cfg.get("noise_m", 0.0) + rays_cfg.get("noise_fraction", 0.0) * dist) \
                * rng.normal(size=iface.n_rays)
            dist = np.where(rng.uniform(size=iface.n_rays) < rays_cfg.get("dropout", 0.0), r_max, dist)
            controller.ray_obs = interface.ray_observation(dist, r_max)

    def step(push_force, chirp=0.0):
        nonlocal last_frame_t
        d.ctrl[:] = staged
        frames = bus.due(d.time)
        limit = (np.minimum(limits, torque_envelope.limit(heat, iface.envelope, np)) if iface.thermal
                 else limits)
        for i in range(len(JOINTS)):
            extra = chirp * opposed[i]
            if i in gears:
                if frames[i] is not None:
                    frame, lim_i = frames[i], limit[i]
                    law = lambda q, v, frame=frame, lim_i=lim_i, extra=extra: iface.mit_torque(frame, q, v, lim_i) + extra
                else:
                    law = lambda q, v, held=staged[act[i]] + extra: held
                motor_torque[i], d.ctrl[act[i]] = gears[i].step(law, d.qpos[qadr[i]], d.qvel[dadr[i]],
                                                                m.opt.timestep)
            else:
                if frames[i] is not None:
                    d.ctrl[act[i]] = iface.mit_torque(frames[i], drive_q(i), drive_v(i), limit[i])
                d.ctrl[act[i]] += extra
                motor_torque[i] = d.ctrl[act[i]]
        heat[:] = torque_envelope.account(heat, motor_torque ** 2, m.opt.timestep, iface.envelope)
        for a in wheel_act:
            wheel_tau[a] += wheel_blend * (d.ctrl[a] - wheel_tau[a])
            d.ctrl[a] = wheel_tau[a]
        d.xfrc_applied[torso, :] = 0.0
        if push_force != 0.0:
            r = d.xmat[torso].reshape(3, 3)
            n = math.hypot(r[0, 0], r[1, 0])
            if n > 1e-6:
                d.xfrc_applied[torso, 0] = push_force * r[0, 0] / n
                d.xfrc_applied[torso, 1] = push_force * r[1, 0] / n
        mujoco.mj_step(m, d)
        if renderer is not None and d.time - last_frame_t >= 1.0 / video_fps - 1e-9:
            last_frame_t = d.time
            renderer.update_scene(d, camera)
            frames_out.append(renderer.render())

    while d.time < options.unpowered_s - 1e-12:
        step(0.0)

    period_ns = int(1e9 / lim.control_rate_hz)
    step_ns = lambda: int(d.time * 1e9)
    last_ns = wake_ns = step_ns()
    activated = False
    recording_start = phase_start = engaged_at = last_diag = last_publish = -1.0
    published = [0.0] * 6
    heading_ref = None
    last_hop = -10.0
    received = [0.0] * 5
    phase_index = 0
    fall_time = -1.0
    finished = False
    rows = []
    axle_prev, t_prev = None, None

    while not finished:
        push = 0.0
        if phase_start >= 0:
            t = d.time - phase_start
            for start, force, duration in pushes:
                if start <= t < start + duration:
                    push += force
        step(push, yaw_chirp_nm(options.yaw_chirp_nm, d.time - phase_start - options.yaw_chirp_start_s)
             if phase_start >= 0 else 0.0)
        now_ns = step_ns()
        if now_ns < wake_ns:
            continue
        now = now_ns * 1e-9
        period = (now_ns - last_ns) * 1e-9
        last_ns, wake_ns = now_ns, now_ns + period_ns

        # read()
        pos = np.array([joint_lines[i][0].update(now, drive_q(i)) for i in range(6)])
        vel = np.array([joint_lines[i][1].update(now, drive_v(i)) for i in range(6)])
        eff = np.array([joint_lines[i][2].update(now, motor_torque[i] if i in gears else d.actuator_force[act[i]])
                        for i in range(6)])
        qs = d.sensordata[m.sensor_adr[sensors[0]]:m.sensor_adr[sensors[0]] + 4]
        gs = d.sensordata[m.sensor_adr[sensors[1]]:m.sensor_adr[sensors[1]] + 3]
        acs = d.sensordata[m.sensor_adr[sensors[2]]:m.sensor_adr[sensors[2]] + 3]
        raw = np.array([qs[1], qs[2], qs[3], qs[0], *gs, *acs])
        if options.imu_noise:
            sig = np.array([m.sensor_noise[sensors[k]] for k in sensor_of])
            raw = raw + np.where(sig > 0, rng.normal(0.0, 1.0, 10) * sig, 0.0)
        imu = np.array([imu_lines[i].update(now, raw[i]) for i in range(10)])
        quat = np.array([imu[3], imu[0], imu[1], imu[2]])
        gyro, accel = imu[4:7], imu[7:10]

        if not activated:
            if iface.has_goal:
                exteroception(now, quat, gyro, vel, period)    # the first frame fills the history
            controller.reset(quat, gyro, accel, pos, vel, lim.height_target_m)
            activated = True
            continue

        if last_publish < 0 or now - last_publish >= 1.0 / options.command_rate_hz - 1e-9:
            last_publish = now
            if phase_start >= 0:
                elapsed, index = now - phase_start, 0
                while index < len(phases) and elapsed >= phases[index][0]:
                    elapsed -= phases[index][0]
                    index += 1
                phase_index = index
                published = list(phases[index]) if index < len(phases) else [0.0] * 6
            else:
                published = [0.0] * 6
            if heading_hold > 0.0:
                # An operator steering back to the heading the scenario's yaw
                # rates integrate to, from the true heading.
                rt = d.site_xmat[imu_site].reshape(3, 3)
                yaw_now = math.atan2(rt[1, 0], rt[0, 0])
                if heading_ref is None:
                    heading_ref = yaw_now
                heading_ref += published[2] / options.command_rate_hz
                error = math.remainder(heading_ref - yaw_now, 2.0 * math.pi)
                published[2] = float(np.clip(published[2] + heading_hold * error, -1.5, 1.5))
            if hop and now - last_hop > 1.1:
                rise = _rise_ahead(m, d, spec, imu_site)
                if rise > 0.015:
                    published[5] = float(np.clip(rise + 0.02, 0.02, 0.08))
                    last_hop = now
            if engaged_at >= 0:
                received = published[1:6]
        if iface.has_goal:
            exteroception(now, quat, gyro, vel, period)
        frames = controller.update(quat, gyro, accel, pos, vel, received, period)

        # write()
        for i in range(6):
            delayed = [fallback_lines[i][f].update(now, frames[f, i]) for f in range(5)]
            bus.push(i, now, frames[:, i].copy())
            staged[act[i]] = iface.mit_torque(delayed, drive_q(i), drive_v(i), limits[i])

        if engaged_at < 0:
            engaged_at = recording_start = now
        if phase_start < 0 and now - engaged_at >= options.settle_s:
            phase_start = now
        if controller.fallen and fall_time < 0:
            fall_time = now
        if phase_start >= 0 and now - phase_start >= total_phase_s:
            finished = True
        if fall_time >= 0 and now - fall_time > 0.5:
            finished = True
        if iface.has_goal and avoid["done_at"] >= 0 and now - avoid["done_at"] > 1.0:
            finished = True
        if pillar_geoms and (last_diag < 0 or now - last_diag >= 1.0 / options.diagnostics_rate_hz - 1e-9):
            for pillar in pillar_geoms:
                for g in robot_geoms:
                    avoid["min_gap_m"] = min(avoid["min_gap_m"], mujoco.mj_geomDistance(m, d, g, pillar, 1.0, fromto))

        phase = -1 if phase_start < 0 else phase_index
        base = {"t_s": f"{now - recording_start:.6g}", "phase": phase, "cmd_forward": published[1],
                "cmd_yaw": published[2], "cmd_height_rate": published[3], "cmd_roll": published[4], "cmd_jump": published[5]}
        if last_diag < 0 or now - last_diag >= 1.0 / options.diagnostics_rate_hz - 1e-9:
            last_diag = now
            r_body = iface.body_rotation(quat)
            r_imu = quat_to_mat(*(quat / np.linalg.norm(quat)))
            gyro_body = iface.body_from_imu_correction.T @ gyro
            pitch = math.atan2(-r_body[2, 0], math.hypot(r_body[0, 0], r_body[1, 0]))
            roll = math.atan2(r_body[2, 1], r_body[2, 2])
            radius = lim.wheel_radius_m
            wheels = vel[iface.wheel_idx]
            heights, offsets, _ = kinematics.leg_state(pos[iface.leg_idx], lim.leg_geometry,
                                                       lim.fore_aft_neutral_m, np)
            taus = np.array([iface.mit_torque(frames[:, i], pos[i], vel[i], limits[i]) for i in range(6)])
            w_r, w_l = taus[iface.wheel_idx]
            rt = d.site_xmat[imu_site].reshape(3, 3)
            truth_pitch = math.atan2(-rt[2, 0], math.hypot(rt[0, 0], rt[1, 0]))
            rb = rt @ body_from_imu
            truth_speed = math.hypot(d.qvel[0], d.qvel[1])
            axle = d.xanchor[wheel_joints].mean(axis=0)
            heading = np.array([rt[0, 0], rt[1, 0], 0.0])
            heading /= max(np.linalg.norm(heading), 1e-9)
            truth_forward = (float((axle - axle_prev) @ heading / (d.time - t_prev))
                             if axle_prev is not None and d.time > t_prev else 0.0)
            axle_prev, t_prev = axle.copy(), d.time
            gyro_true = d.sensordata[m.sensor_adr[sensors[1]]:m.sensor_adr[sensors[1]] + 3]
            truth_yaw = float((rt @ gyro_true)[2])
            true_heights, _, _ = kinematics.leg_state(d.qpos[qadr][iface.leg_idx], lim.leg_geometry,
                                                      lim.fore_aft_neutral_m, np)
            nan = math.nan
            values = {
                "engaged": 0.0 if controller.fallen else 1.0, "status_mask": 0.0, "pitch_rad": pitch,
                "pitch_reference_rad": nan, "pitch_rate_rad_s": gyro_body[1], "roll_rad": roll,
                "roll_reference_rad": controller.ref[3] if len(controller.ref) > 3 else nan,
                "forward_velocity_m_s": radius * (float(np.mean(wheels)) + gyro_body[1]),
                "velocity_reference_m_s": controller.ref[0], "position_error_m": nan,
                "yaw_rate_rad_s": float((r_imu @ gyro)[2]),
                "wheel_yaw_rate_rad_s": radius * (wheels[0] - wheels[1]) / lim.track_width_m,
                "yaw_rate_reference_rad_s": controller.ref[1], "leg_height_m": float(np.mean(heights)),
                "height_reference_m": controller.ref[2], "height_differential_m": float(heights[0] - heights[1]),
                "height_support_n": nan, "leg_offset_m": float(np.mean(offsets)),
                "leg_offset_reference_m": nan, "leg_offset_command_m": nan, "leg_offset_model_m": nan,
                "leg_offset_state_m": nan, "leg_offset_rate_m_s": nan, "trim_m": nan,
                "balance_torque_nm": float(w_r + w_l), "yaw_torque_nm": float(0.5 * (w_r - w_l)),
                "yaw_feedforward_nm": nan, "truth_pitch_rad": truth_pitch, "truth_speed_m_s": truth_speed,
                "truth_forward_m_s": truth_forward, "truth_yaw_rate_rad_s": truth_yaw,
                "truth_height_m": float(np.mean(true_heights)),
                "truth_roll_rad": math.atan2(rb[2, 1], rb[2, 2]),
                # Lower wheel above z = 0, so only meaningful on flat ground.
                "truth_wheel_clearance_m": nan if course else float(np.min(d.xanchor[wheel_joints][:, 2]) - radius),
                "truth_axle_x_m": float(axle[0]), "truth_axle_y_m": float(axle[1]),
                "truth_tilt_rad": math.acos(float(np.clip(rb[2, 2], -1.0, 1.0))),
                "truth_imu_height_m": float(d.site_xpos[imu_site][2]),
            }
            rows.append({**base, "stream": "diag", **{f"diag_{k}": f"{v:.6g}" for k, v in values.items()}})
        joint_row = {**base, "stream": "joint"}
        for prefix, values in (("pos_", pos), ("vel_", vel), ("eff_", eff)):
            joint_row.update({f"{prefix}{j}": f"{x:.6g}" for j, x in zip(JOINTS, values)})
        rows.append(joint_row)
        rows.append({**base, "stream": "imu", **{k: f"{x:.6g}" for k, x in zip(IMU_COLUMNS, imu)}})

    header = (["t_s", "stream", "phase", "cmd_forward", "cmd_yaw", "cmd_height_rate", "cmd_roll", "cmd_jump"]
              + [f"diag_{k}" for k in DIAG_KEYS]
              + [f"{p}{j}" for p in ("pos_", "vel_", "eff_") for j in JOINTS] + IMU_COLUMNS
              + [f"diag_{k}" for k in TRUTH_KEYS])
    output.parent.mkdir(parents=True, exist_ok=True)
    with open(output, "w", newline="") as handle:
        writer = csv.DictWriter(handle, fieldnames=header)
        writer.writeheader()
        writer.writerows(rows)
    if renderer is not None and frames_out:
        import imageio.v2 as imageio
        imageio.mimsave(video, frames_out, fps=video_fps, codec="libx264", quality=7)
    if iface.has_goal:
        summary = {"course": course if course in AVOID_COURSES else "slalom", "scenario": scenario,
                   "goals": len(goals_world), "reached": avoid["reached"],
                   "min_clearance_m": round(float(avoid["min_gap_m"]), 4),
                   "collided": bool(avoid["min_gap_m"] <= 0.0), "fell": fall_time >= 0}
        output.with_suffix(".avoid.json").write_text(json.dumps(summary, indent=1))
    return (3 if fall_time >= 0 else 0), output


# ---------------------------------------------------------------- metrics

def truth_metrics(path: Path, phase: int) -> dict:
    """Ground-truth metrics both recordings carry (truth_pitch_rad, truth_speed_m_s)."""
    run_ = compare_runs.load(str(path))
    d = compare_runs.select(run_["diag"], phase)
    if not d or not d["t_s"].size:
        return {}
    pitch = d["diag_truth_pitch_rad"]
    speed = d["diag_truth_speed_m_s"]
    cmd = np.abs(d["cmd_forward"])
    return {"truth_pitch_rms": compare_runs.rms(pitch - np.mean(pitch)),
            "truth_pitch_p2p": float(np.max(pitch) - np.min(pitch)),
            "truth_speed_mean": float(np.mean(speed)),
            "truth_speed_err_rms": compare_runs.rms(speed - cmd)}


def all_metrics(path: Path, scenario: str) -> dict[int, dict]:
    """closed_loop.py's per-phase compare_runs metrics plus the truth metrics."""
    run_ = compare_runs.load(str(path))
    phases = sorted(int(p) for p in np.unique(run_["diag"]["phase"]) if 0 <= p < len(SCENARIOS[scenario]))
    out = {p: compare_runs.metrics(run_, p) for p in phases}
    for phase in out:
        out[phase].update(truth_metrics(path, phase))
    return out


def run_wbc(scenario: str, sim: dict[str, str], output: Path) -> int:
    eigen = Path(os.environ.get("EIGEN_DIR", Path(__file__).resolve().parents[1] / ".cache" / "eigen-3.4.0"))
    binary = closed_loop.build(closed_loop.find_mujoco(None), eigen)
    parameters = closed_loop.controller_parameters([str(closed_loop.ROBOT_OVERRIDES)], [])
    code, _ = closed_loop.run_once(binary, parameters, scenario, sim, output, quiet=True)
    return code


COMPARE_KEYS = ["truth_pitch_rms", "truth_speed_err_rms", "pitch_rms", "pitch_peak_hz", "vel_err_rms",
                "yaw_err_rms", "yaw_rise_s", "height_err", "wheel_tau_rms", "wheel_flip_frac", "leg_eff_rms"]


def compare(policy_dir: Path, scenarios: list[str], profiles: list[str], out_dir: Path,
            policy_sim: dict[str, str] | None = None) -> dict:
    """Policy and WBC on the same scenarios and latency profiles; returns the table.
    `policy_sim`: options for the policy runs only (wheel_lag: sandro_sim has none)."""
    out_dir.mkdir(parents=True, exist_ok=True)
    table = {}
    for scenario in scenarios:
        for profile in profiles:
            sim = PROFILES[profile]
            entry = {}
            for who in ("policy", "wbc"):
                path = out_dir / f"{who}_{scenario}_{profile}.csv"
                code = (run(policy_dir, scenario, {**sim, **(policy_sim or {})}, path)[0] if who == "policy"
                        else run_wbc(scenario, sim, path))
                entry[who] = {"fell": code == 3, "exit": code,
                              "phases": {str(k): v for k, v in all_metrics(path, scenario).items()} if code in (0, 3) else {}}
            table[f"{scenario}/{profile}"] = entry
    (out_dir / "comparison.json").write_text(json.dumps(table, indent=1, default=float))
    return table


def ringing(path: Path, t_from: float = 3.0) -> dict:
    """Wheel effort after t_from: RMS per wheel (Nm), the dominant frequency and
    the share of power in 5-15 Hz, where lag-driven ringing sits (7-10 Hz)."""
    joint = compare_runs.load(str(path))["joint"]
    keep = joint["t_s"] > t_from
    t = joint["t_s"][keep]
    if len(t) < 16:
        return {side: {"rms": math.nan, "peak_hz": math.nan, "band": math.nan} for side in ("right", "left")}
    out = {}
    for side in ("right", "left"):
        x = joint[f"eff_{side}_wheel"][keep]
        x0 = x - np.mean(x)
        f = np.fft.rfftfreq(len(x0), (t[-1] - t[0]) / (len(t) - 1))
        power = np.abs(np.fft.rfft(x0 * np.hanning(len(x0)))) ** 2
        band = (f > 5.0) & (f < 15.0)
        out[side] = {"rms": float(np.std(x)), "peak_hz": float(f[1:][np.argmax(power[1:])]),
                     "band": float(power[band].sum() / power[1:].sum())}
    return out


LAG_SWEEP = (0.0, 0.035, 0.05, 0.08)


def lag_sweep(policy_dir: Path, scenarios: list[str], out_dir: Path, lags=LAG_SWEEP) -> str:
    """The policy under wheel drive-train lag (nominal latency); a markdown table."""
    out_dir.mkdir(parents=True, exist_ok=True)
    lines = ["| scenario | wheel lag (s) | result | wheel effort RMS R/L (Nm) | peak (Hz) | 5-15 Hz share |",
             "|---|---|---|---|---|---|"]
    for scenario in scenarios:
        for lag in lags:
            path = out_dir / f"lag_{scenario}_{lag:.3f}.csv"
            code = run(policy_dir, scenario, {**PROFILES["nominal"], "wheel_lag": str(lag)}, path)[0]
            r = ringing(path)
            lines.append(f"| {scenario} | {lag:.3f} | {'FELL' if code == 3 else 'completed'} | "
                         f"{r['right']['rms']:.2f} / {r['left']['rms']:.2f} | "
                         f"{r['right']['peak_hz']:.1f} / {r['left']['peak_hz']:.1f} | "
                         f"{max(r['right']['band'], r['left']['band']):.2f} |")
    return "\n".join(lines)


def markdown(table: dict) -> str:
    lines = []
    for key, entry in table.items():
        scenario = key.split("/")[0]
        lines.append(f"\n**{key}** — policy {'FELL' if entry['policy']['fell'] else 'completed'}, "
                     f"WBC {'FELL' if entry['wbc']['fell'] else 'completed'}\n")
        lines.append("| phase | command | " + " | ".join(COMPARE_KEYS) + " |")
        lines.append("|" + "---|" * (len(COMPARE_KEYS) + 2))
        phases = sorted(set(entry["policy"]["phases"]) | set(entry["wbc"]["phases"]), key=int)
        for p in phases:
            cmd = SCENARIOS[scenario][int(p)] if int(p) < len(SCENARIOS[scenario]) else ""
            for who in ("policy", "wbc"):
                m = entry[who]["phases"].get(p, {})
                cells = [f"{m.get(k, math.nan):.3f}" for k in COMPARE_KEYS]
                lines.append(f"| {p} {who} | {cmd} | " + " | ".join(cells) + " |")
    return "\n".join(lines)


def main() -> int:
    parser = argparse.ArgumentParser(description=__doc__.split("\n\n")[0])
    parser.add_argument("policy_dir")
    parser.add_argument("--scenario", default="hardware", choices=sorted(SCENARIOS))
    parser.add_argument("--profile", default="nominal", choices=sorted(PROFILES))
    parser.add_argument("--sim", action="append", default=[], metavar="KEY=VALUE")
    parser.add_argument("--output")
    parser.add_argument("--video")
    parser.add_argument("--course", nargs="?", const="planks", choices=sorted(COURSES) + sorted(AVOID_COURSES),
                        help="an obstacle course along the start heading (default planks: "
                             f"{COURSE} and a hill {COURSE_HILL}); see COURSES. Goal policies take an "
                             "AVOID_COURSES layout (default slalom)")
    parser.add_argument("--heading-hold", type=float, default=0.0, metavar="GAIN",
                        help="steer back to the scenario's heading, GAIN rad/s per rad (an operator)")
    parser.add_argument("--fallen", type=float, metavar="PITCH",
                        help="start tipped by PITCH rad (+ nose down), 3 s unpowered (stand-up policies)")
    parser.add_argument("--hop", action="store_true",
                        help="request a jump when the ground ahead rises (hop-on-command policies)")
    parser.add_argument("--compare", action="store_true",
                        help="policy and WBC on hardware/default/push x nominal/spi_slow/worst")
    parser.add_argument("--lag-sweep", action="store_true",
                        help=f"hardware/default/push with wheel drive-train lag {LAG_SWEEP} s: eval/lag_sweep.md")
    args = parser.parse_args()
    policy_dir = Path(args.policy_dir)
    # wheel_lag is emulated here only, not by sandro_sim's closed loop.
    policy_only = {k: v for k, v in (item.split("=", 1) for item in args.sim) if k == "wheel_lag"}
    if args.compare:
        table = compare(policy_dir, ["hardware", "default", "push"], list(PROFILES), policy_dir / "eval", policy_only)
        text = markdown(table)
        if policy_only:
            text = f"Policy runs with wheel_lag {policy_only['wheel_lag']} s; the WBC without (sandro_sim has no lag).\n" + text
        (policy_dir / "eval" / "comparison.md").write_text(text + "\n")
        print(text)
        return 0
    if args.lag_sweep:
        text = lag_sweep(policy_dir, ["hardware", "default", "push"], policy_dir / "eval")
        (policy_dir / "eval" / "lag_sweep.md").write_text(text + "\n")
        print(text)
        return 0
    sim = {**PROFILES[args.profile],
           **closed_loop.parse_sim([s for s in args.sim if not s.startswith("wheel_lag=")]),
           **policy_only}
    output = Path(args.output) if args.output else Path(tempfile.mkstemp(suffix=".csv")[1])
    code, _ = run(policy_dir, args.scenario, sim, output, Path(args.video) if args.video else None,
                  course=args.course, heading_hold=args.heading_hold, fallen_pitch=args.fallen, hop=args.hop)
    print(f"{'FELL' if code == 3 else 'completed all phases'}; recording: {output}")
    if output.with_suffix(".avoid.json").exists():
        print(output.with_suffix(".avoid.json").read_text())
    per_phase = all_metrics(output, args.scenario)
    keys = COMPARE_KEYS
    print(f"{'phase':>5s} " + " ".join(f"{k[:15]:>15s}" for k in keys))
    for phase, values in per_phase.items():
        print(f"{phase:5d} " + " ".join(f"{values.get(k, math.nan):15.4f}" for k in keys))
    return code


if __name__ == "__main__":
    raise SystemExit(main())
