A-Common-Guy/bipedale/ros2_ws/src/sandro_bringup/config/teleop.yaml

joy_node:
  ros__parameters:
    device_id: 0
    deadzone: 0.08
    autorepeat_rate: 20.0  # Hz; faster than the 0.3 s command timeout

# Gamepad driving and policy switching (sandro_bringup/joy_teleop.py).
# Indices are SDL's gamepad layout, which joy reports for a DualSense over
# Bluetooth (verified on the robot's Pi): buttons 0-3 cross, circle, square,
# triangle, 4 Create, 6 Options, 7/8 L3/R3, 9/10 L1/R1; axes 0/1 left stick,
# 2/3 right stick (left and up are +1), 4/5 L2/R2 (+1 released, -1 pressed).
# Check another pad with `ros2 topic echo /joy`.
joy_teleop:
  ros__parameters:
    deadman_button: 9          # L1: hold to drive
    forward_axis: 1            # left stick vertical
    yaw_axis: 0                # left stick horizontal, left turns left
    height_axis: 3             # right stick vertical, up stands taller
    roll_axis: 2               # right stick horizontal
    forward_sign: 1.0
    yaw_sign: 1.0
    height_sign: 1.0
    roll_sign: -1.0            # stick right puts the right side down (+roll)
    # Full deflection is the running controller's own limit (its commands.*
    # parameters) times this; lower it for first runs on a new policy.
    speed_fraction: 1.0
    switch_button: 3           # L1 + triangle: next policy
    announce_button: 1         # circle: rumble the running policy's number (pads with rumble)
    recentre_button: 8         # L1 + R3: height back to the policy's initial
    estop_axes: [4, 5]         # the E-stop chord aborts a switch in progress
    estop_pressed_below: -0.5
    # Policies the switch cycles through, in rumble order (1 pulse, 2 ...).
    # The launch loads the ones it does not start as inactive.
    policies: [rl_flat_level, rl_agile_terrain, rl_flat_level_fast, rl_flat_level_drivetrain,
               rl_flat_level_fast_drivetrain]
    # The switch settles here first: both policies' initial height, so the
    # incoming one engages at the height it would start from anyway.
    handover_height_m: 0.17
    handover_margin: 0.6       # fraction of the incoming engage joint velocity
                               # the leg joints must stay below
    # The wheels keep balancing while the robot stands, and the incoming
    # policy starts from their measured speed; 1.5 rad/s is 0.1 m/s.
    handover_wheel_velocity_rad_s: 1.5
    handover_hold_s: 0.3
    handover_timeout_s: 8.0
    # Stick ranges until the running controller's parameters are read:
    # forward m/s, yaw rad/s, height rate m/s, roll rad.
    default_limits: [0.5, 1.5, 0.05, 0.0]
    # Lightbar colour of each policy, r g b in `policies` order: flat_level
    # green, agile_terrain orange, flat_level_fast blue, flat_level_drivetrain
    # purple, flat_level_fast_drivetrain cyan. Red means no controller is running.
    policy_colors: [0, 255, 0, 255, 100, 0, 0, 80, 255, 160, 0, 255, 0, 220, 220]

# Gamepad E-stop: squeeze both triggers together. PS5 L2 and R2 are axes 4 and
# 5; a trigger counts as pressed at or below axis_pressed_below. It deactivates every
# active controller that owns command interfaces (all efforts to zero, in
# simulation and on hardware) and triggers /gim6010_estop/trigger when that
# service exists.
# Re-arm: hold Create + Options (buttons 4 and 6) for rearm_hold_s. The first
# hold arms the drives at zero torque with no controller, a second hold starts
# the controller that ran last (rearm_controller until one has run) and loads
# the other switch_policies inactive; hold the robot upright before the second.
# The gamepad re-activates the drives only once they have been armed in this
# launch (panel, `ros2 control` or arm_hardware:=true): the first arming of a
# session is the operator's, after the pre-arm checks. A controller that runs
# but reports ERROR (fallen, latched limp) restarts with a single hold.
joy_estop:
  ros__parameters:
    axes: [4, 5]
    axis_pressed_below: -0.5
    rearm_buttons: [4, 6]
    rearm_hold_s: 2.0
    rearm_controller: whole_body_controller
    switch_policies: [rl_flat_level, rl_agile_terrain, rl_flat_level_fast, rl_flat_level_drivetrain,
                      rl_flat_level_fast_drivetrain]  # joy_teleop's policies
    hardware_component: SandroSystem
    # Broadcasters reading the drives, which a drive read error deactivates.
    rearm_broadcasters: [joint_state_broadcaster, health_broadcaster]
    rearm_timeout_s: 10.0      # a re-arm with no reply by then can start over
    joy_topic: /joy
    controller_manager: /controller_manager
    hardware_estop_service: /gim6010_estop/trigger
    service_timeout_s: 2.0
