A-Common-Guy/bipedale/ros2_ws/src/sandro_controllers/include/sandro_controllers/whole_body_controller.hpp

#pragma once

#include <array>
#include <memory>
#include <string>
#include <vector>

#include "controller_interface/controller_interface.hpp"
#include "diagnostic_msgs/msg/diagnostic_array.hpp"
#include "geometry_msgs/msg/twist_stamped.hpp"
#include "rclcpp/node.hpp"
#include "rclcpp/subscription.hpp"
#include "realtime_tools/realtime_buffer.hpp"
#include "realtime_tools/realtime_publisher.hpp"

#include "sandro_controllers/diagnostic_values.hpp"
#include "sandro_controllers/whole_body_core.hpp"

namespace sandro_controllers {

// Whole-body controller plugin. It claims the same six effort commands, joint
// states and IMU states as the other balancers and listens to the same
// geometry_msgs/TwistStamped: linear.x forward speed, angular.z yaw rate, and
// additionally linear.z as a body height rate. Activate exactly one balancer.
//
// All tunables are live ROS parameters. A change is validated as a complete
// set and the height-scheduled LQR gains are re-solved off the realtime path
// before the new settings are swapped in.
class WholeBodyController : public controller_interface::ControllerInterface {
public:
  controller_interface::CallbackReturn on_init() override;
  controller_interface::InterfaceConfiguration
  command_interface_configuration() const override;
  controller_interface::InterfaceConfiguration
  state_interface_configuration() const override;
  controller_interface::CallbackReturn
  on_configure(const rclcpp_lifecycle::State &previous_state) override;
  controller_interface::CallbackReturn
  on_activate(const rclcpp_lifecycle::State &previous_state) override;
  controller_interface::CallbackReturn
  on_deactivate(const rclcpp_lifecycle::State &previous_state) override;
  controller_interface::return_type
  update(const rclcpp::Time &time, const rclcpp::Duration &period) override;
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
