A-Common-Guy/bipedale/(commit log)

2026-09-20 Whole-body controller redesign and first hardware run with it
    Redesign of sandro_controllers/WholeBodyController after the 2 Hz hunting of
    the third hardware run: model-based yaw loop (P on the wheel-differential
    rate, I on the IMU rate, scrub and inertia feed-forward, lagged command),
    input-delay margin check at configure, firmer position/velocity weights,
    gravity support protected from leg torque saturation, filtered leg damping,
    measured/commanded offset-state blend, optional wheel-reaction feed-forward
    (off), new diagnostics, docs and tests.
    Recordings: real_..real4 hardware runs and the simulation runs of the
    identified model; real4 is the first run with this build (balances, drives
    an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
2026-09-20 Whole-body controller: feed back the commanded leg offset by default
    The fourth hardware run (recordings/real4_2026-09-20.csv) balanced, drove
    and turned, but both legs hunted in phase at 1.9 Hz while standing: the
    measured axle follows its command with 70 ms of lag, as slow as the LQR's
    leg-offset mode. balance.measured_offset_blend 0 stopped it live; make it
    the default and record the finding.
2026-09-20 Whole-body controller: model the leg lag in the LQR
    The measured axle follows its commanded fore-aft offset with 70 ms of lag
    on the robot (fourth hardware run); designed for instantaneous legs the LQR
    asked them for a 72 ms mode and hunted at 1.9 Hz. The state gains the
    commanded offset, the achieved offset follows it through model.leg_lag_s,
    and the regulator now takes 11.3 (m/s)/m from the command and 4.7 from the
    achieved offset instead of 13.8 from a single measured one. The
    achieved-offset state fed back is the model's prediction by default
    (measured_offset_blend 0, the setting that stopped the hunting live).
    Identified latency simulation, blend 0: driving pitch RMS 0.028 -> 0.012,
    st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
2026-09-20 Run the leg PD in the drives' MIT loop
    SandroControl always commanded the legs through the GIM6010 MIT frame
    (position, velocity, kp, kd, torque); the ROS plugin packed kp = kd = 0, so
    every leg loop closed over the bus and sensor delay, which capped the
    controller-side impedance at 400 N/m and gave the 70 ms leg lag.
    - sandro_hardware: optional position/velocity/kp/kd command interfaces per
    joint next to effort; full MIT frames, gains clipped to the drive limits,
    reference pulled toward the measured position to keep the torque limit
    (SandroControl's bound); unset fields keep the drive a torque source.
    - sandro_sim: the wrapper now always fronts the MuJoCo backend and emulates
    the d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
2026-09-20 Check the drives' MIT position frame at arming, report faults plainly, shut down safely
    - GIM6010System: at activation, with zero gains, compare each stiffenable
    joint's MIT reply position with the encoder broadcast in the wire frame;
    log the bias per drive, add a small one to every position reference,
    refuse to arm beyond mit_frame_bias_tolerance_rad (0.2). A drive with a
    different MIT zero would otherwise hold its joint at the wrong angle
    against the torque limit while the controller sees a small error, which
    is the asymmetric, height-ignoring leg of the fifth hardware run.
    - One throttled DRIVE FAULT / IMU FAULT line per second naming the joint,
    node and reason (no encoder,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
2026-09-20 GIM6010System: name the silent drives at activation, deactivate per node
    A failed activation now says whether the bus carried any frame at all
    (drives unpowered, cut-off engaged or the adapter cable off) or which
    drives sent no heartbeat or encoder broadcast. Deactivation zeroes and
    idles every drive and disables each deadman independently, so one
    unreachable node no longer stalls the cleanup with SDO timeouts.
2026-10-19 feat(hardware): read the BNO085 over SPI6 by default
    The IMU plugin talks to the BNO085 on the Raspberry Pi's hardware SPI6 (spidev6.0, INT GPIO25, RST GPIO24); the FTDI UART, which delivered about 30 samples/s on every recorded run, stays available through imu_transport:=uart. compose.yaml passes the SPI and GPIO devices.
2026-10-19 feat(sim): run the MIT drive law every physics step and add a closed-loop harness
    MitDrivePlugin applies kp/kd/effort from the live joint state on each mj_step, fed by LatencySystem through a shared drive bus. Delay lines gain staggered joint updates. tools/closed_loop runs WholeBodyCore against MuJoCo with the same latency emulation, without ROS.
2026-10-19 feat(description): align the physics step with the 300 Hz control loop
    sync_model.py writes a 1/1200 s timestep so the controller wakes every 3.33 ms. Adds the SPI IMU and staggered-joint latency arguments to the xacros, and tools/com_from_weighing.py to locate the CoM from scale readings.
2026-10-19 feat(bringup): default to the whole-body controller and add an IMU delay tool
    make sim runs the whole-body controller, make sim-cascade the PID cascade. Launch passes the IMU transport and sim latency arguments and loads the MuJoCo drive plugin. tools/imu_delay.py measures the IMU delay against the wheel encoders; compare_runs.py and the sim-to-real notes are updated.
2026-10-19 feat(rl): add sandro_rl, GPU locomotion training for Sandro
    MJX/Warp environment reading the generated MJCF and the ROS parameters at run time, with a CPU/GPU consistency check and a model fingerprint in every checkpoint. Measured-only actor observations, MIT drive interface, latency emulation and per-range sourced randomisation. Mocap terrain (planks, hills) resampled per episode, pushes and torque kicks, roll and height commands. PPO with mirror loss and Constraints as Terminations, ONNX export, evaluation against the WBC in CPU MuJoCo. Config-driven tasks; uv lockfile; docs/RESEARCH.md and docs/DESIGN.md.
2026-10-19 feat(deploy): add Raspberry Pi deployment for the real-hardware stack
    Container image, CAN and performance services, and a deploy/pi/pi helper that syncs, builds and launches on the Pi with the real overrides and RViz off by default. The BNO085 SPI probe moves to deploy/pi/tools.
2026-10-19 fix(hardware): let GIM6010 drives re-arm after an E-stop
    Release the CAN socket and receiver thread in on_error so a later configure does not terminate the controller manager, ignore whole MIT position wraps in the activation bias check, and retry the SDO read-back a drive can drop right after clearing its errors.
2026-10-19 feat(bringup): re-arm from the gamepad after an E-stop
    Map the PS5 pad in SDL layout (L1 deadman, L2+R2 E-stop). Holding Create+Options for 2 s re-arms the drives at zero torque and restarts the broadcasters; a second hold starts the whole-body controller.
2026-10-19 fix(bringup): re-identify the IMU roll offset for the SPI6 mounting
2026-10-19 chore(recordings): add first Raspberry Pi balancer runs
2026-10-20 feat(sandro_rl): export trained policies to the ROS controller
    export_ros writes each actor in the controller's binary format, an
    onnxruntime reference for its unit test, optionally interface.py's
    observation frames (--frames), and rl_policies.yaml from policy.json.
2026-10-20 feat(bringup): launch the RL policy controllers
    Load rl_policies.yaml, accept controller:=rl_flat_level|rl_agile_terrain,
    re-arm the chosen controller from the gamepad, set the real IMU offset
    for both, and map the left stick to the body roll command.
2026-10-20 feat(sandro_rl): add jump events and a torque-limit override
    commands.jump requests a jump of a sampled wheel clearance every few seconds; the actor sees the target and a countdown of the window. Rewards for both wheels' clearance and upward body speed in the window; the wheel-lift constraint and steady-height terms pause until shortly after it. action.torque_limit_nm overrides the controllers.yaml limits. configs/jump.yaml trains on agile_terrain with 10 Nm drives; the evaluator and interface take a sixth phase field (jump height).
2026-10-20 feat(sandro_rl): add a jump scenario and wheel clearance to the evaluation
    The jump scenario's sixth phase field is a jump height, started on its rising
    edge. Recordings gain diag_truth_wheel_clearance_m (flat ground only) and the
    trace plot a clearance panel when jumps are commanded.
2026-10-20 feat(sandro_rl): add the jump policy trained at 10 Nm
    2500 iterations of configs/jump.yaml (agile_terrain plus commanded jumps,
    10 Nm on every drive). It hops three times per jump command with 66-127 mm
    of wheel clearance and completes all nine standard evaluation runs. Not meant
    for the hardware before system identification; see docs/DESIGN.md section 8.
2026-10-20 feat(description): model the weighed masses and the loaded tyre radius
    The robot weighs 4.825 kg without battery against the CAD's 3.40 kg. The
    component masses (hub, leg motors, upper cranks, lower links, wheels) now
    live in sim_identified.yaml and replace the CAD body masses at every sync,
    found through the joints so a CAD re-export keeps them. The guessed 1.2 kg
    payload becomes 0.4 kg of the hub's own mass, placed by the tilt weighing.
    The airless tyres squash about 7 mm under load: the contact cylinder is
    the loaded 0.0672 m radius and the stand keyframe drops with it.
    The controllers' model follows: body mass 4.485 kg, wheel mass 0.170 kg,
    CoM height 0.756 of leg height, pitch and yaw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
2026-10-21 fix(sandro_rl): correct the observed IMU roll by the simulated mount
    Training took the IMU roll correction from the robot overrides'
    tasks.roll.imu_offset_rad, re-identified to +0.016 for the SPI6 mounting,
    while the simulated IMU is still mounted at -0.049 (sim_identified.yaml
    imu_mount). Policies trained since then (jump) saw the horizon tilted by
    0.065 rad and would hold the body tilted by that much on the robot. The
    correction is now the simulated mount; the robot's reaches the controller
    through its rl_* overrides.
2026-10-21 feat(sandro_rl): refit the policies to the weighed robot
    flat_tracking, flat_level (+300 iterations), agile_terrain and jump (+600)
    fine-tuned on the weighed masses (4.825 kg) and the loaded 0.0672 m tyre,
    with the IMU roll correction fixed. All complete the nine standard runs.
    flat_level stands level; agile_terrain now stops at the course's 25 mm
    plank (about 32 % more wheel torque to climb it), documented in DESIGN.md
    section 8. The ROS exports of flat_level and agile_terrain are regenerated.
2026-10-21 feat(sandro_rl): add step and curb courses and the axle's world position
    --course takes a layout: planks (the existing course), steps (30-60 mm planks
    and a 6 cm curb) or curb. Recordings gain diag_truth_axle_x_m/_y_m, so
    progress can be measured along the course rather than along the heading.
2026-10-21 feat(sandro_rl): add the step_climb policy
    jump.yaml on planks up to 6.5 cm and steeper ramps, fine-tuned from the jump
    policy on the weighed robot (1500 iterations, checkpoint 1200 kept). It
    crosses 3-6 cm planks on 10 of 10 seeds without falling and the 25 mm plank
    at 0.8 m/s; it does not climb a 6 cm curb yet. A first attempt from
    agile_terrain learnt to wait in front of planks (docs/DESIGN.md section 8).
2026-10-21 feat(sandro_rl): leg-split constraint, heading hold in evaluation, step-up platforms for step_climb v2
2026-10-21 feat(sandro_rl): stand-up task: CAD-fitted leg collision boxes, switched-off pose bank, fallen starts
2026-10-21 feat(controllers): hot policy handover and wheel action filter
    RlPolicyController gains ~/arm_handover so a switch between policies keeps
    the previous action and filter state, and action.wheel_filter_hz, a
    first-order low-pass on the wheel actions only (0 = off), used as a stopgap
    against the 7.5 Hz wheel ringing seen on hardware.
2026-10-21 feat(bringup): gamepad teleop with soft policy switch and LED indicator
    joy_teleop replaces teleop_twist_joy: left stick speed and yaw, right stick
    height and roll; L1 + triangle switches policy through a standstill and the
    controller handover; the DualSense light bar and player LEDs show the
    running policy and blink while switching.
2026-10-21 feat(sandro_rl): randomise wheel drive-train lag, add flat_level_real
    The robot's wheel drive train lags the reported torque by 20-40 ms, which
    makes flat_level ring at 7.5 Hz on hardware. The env now applies a sampled
    first-order lag to the wheel torque, evaluate.py takes --sim wheel_lag, and
    flat_level_real fine-tunes with 5-50 ms of it. docs/HANDOFF_flat_level_real.md
    lists the findings and the training and deploy steps.
2026-10-21 chore(recordings): RL flat_level vibration bags and IMU delay tests
    Hardware runs of 2026-10-21 behind the wheel-lag diagnosis, with the
    analysis scripts and the parameter overrides used on the robot.
2026-10-22 docs(sandro_rl): correct step_climb results (7/20 planks), record v2 and the leg-split exploit; stand-up constraint fixes
2026-10-22 feat(sandro_rl): stand_up policy: gets up from switched off in 18/18 falls, docs and deployment proposals
2026-10-22 feat(sandro_rl): wheel drive-train lag (10-80 ms) in every config, curriculum offset for fine-tunes
2026-10-22 feat(sandro_rl): flat_level_real: no wheel ringing with 0-80 ms of drive-train lag
2026-10-22 feat(sandro_rl): refit helper and script to fine-tune every policy onto wheel lag
2026-10-22 feat(sandro_rl): evaluate --lag-sweep: wheel ringing under drive-train lag, baselines for every policy
2026-10-22 feat(sandro_rl): flat_tracking refit onto wheel lag; compare --sim wheel_lag for the policy runs
2026-10-22 feat(sandro_rl): agile_terrain refit onto wheel lag: no ringing to 80 ms, better tracking under worst latency
2026-10-22 feat(sandro_rl): jump refit onto wheel lag: lands every hop under 40 ms lag with the UART IMU
2026-10-22 feat(sandro_rl): step_climb refit onto wheel lag: a quarter of the wheel torque under slow sensing, fewer falls
2026-10-22 feat(sandro_rl): stand_up refit onto wheel lag (checkpoint 500): 18/18 stand-ups to 80 ms, no wobble once up
2026-10-22 docs(sandro_rl): wheel drive-train lag: findings, refit results for every policy, deploy settings
2026-11-06 feat(description): re-import the 2026-11 body from Onshape
    The body was redesigned (handle, power distribution box, IMU holder,
    Raspberry Pi holder, more symmetric shell). The legs are unchanged, so the
    joint names, JOINT_FRAMES and the stand leg angles are identical.
    - compose_robot.py: the body parts carry no material in Onshape, so the
    weighed hub (sim_identified.yaml: 1.145 kg = 0.530 central body + 0.095
    Raspberry Pi + 0.520 cabling) is spread over the volume of its parts; the
    Raspberry Pi is a jointless raspberry_pi body at its CAD place, the 0.4 kg
    payload now sits at the torso CoM. Only the outer shell collides (5 hulls,
    not 244). The imu_mount frame, imu site and triad ar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
2026-11-06 feat(sim): the IMU is always the fast SPI link
    The robot reads the BNO085 over SPI only: 241-243 Hz, 9 ms behind the
    encoders (tools/imu_delay.py on recordings/imu_rock*_2026-10-21.csv). The
    30 Hz UART case no longer shapes training or the gates; the UART transport
    code stays.
    - sandro_rl: no degraded 25-60 Hz IMU in training; IMU rate 180-300 Hz,
    delay 5-15 ms (was 100-400 Hz, 3-25 ms).
    - Launch/xacro/closed_loop defaults: sim_imu_rate_hz 240 (delay stays 10 ms,
    the 9 ms lag plus the 1 ms joint delay).
    - Gates and evaluation profiles: uart_imu (30 Hz) becomes spi_slow
    (180 Hz / 15 ms); worst uses it instead of 30 Hz / 25 ms.
    - Docs record the SPI measurement.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
2026-11-06 feat(controllers): retune the whole-body balance LQR for the 2026-11 body
    pitch/position/velocity weights 300/45/6 (was 150/30/4). Standing, the
    shipped set crept +-9 cm against the drive friction at about 0.2 Hz with
    0.1 rad of pitch, and the speed-step error depended on where in that creep
    the step landed (the nominal closed-loop gate failed at 0.122 m/s).
    closed_loop.py, new body with the robot overrides:
    - standing 20 s: position creep 0.188 -> 0.114 m p2p, pitch 0.025 -> 0.019 rad
    - 0.2 m/s step (stand 4-6 s): error 0.108 -> 0.088 m/s mean, 0.122 -> 0.103 max
    - driving phases 0.103 -> 0.079 m/s; all six gates pass
    - delay margin 23.3 -> 20.0 ms (12 ms required), per-wheel velocity gain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
2026-11-06 feat(controllers): RL policy engages only in its training start states; oscillation watchdog
    The 7.5 Hz ringing of 2026-10-21 (recordings/rl_flat_vibration_2026-10-21,
    old flat_level): quiet through the stand phase, then the policy engaged at
    0.12 rad of pitch with all four leg motors still moving at 0.9 rad/s; its
    first actions drove the front leg motors and both wheels hard and the
    robot was in a full limit cycle within one period (legs +-4-5 rad/s,
    wheels +-10 rad/s). In simulation with 30-50 ms of wheel lag the old
    flat_level rings the same way, legs included; the deployed flat_level_real
    does not, from the same tipped start either.
    - Stand-phase engagement: tilt <= 0.08 rad (was 0.15),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
2026-11-06 feat(controllers): RlPolicyController engages stand-up policies lying down
    safety.start_lying (set by export_ros.py for policies trained from limp
    rest poses, env.init.fallen): the drives wait limp where the robot lies,
    the policy engages once it has rested engage_hold_s at any tilt, and the
    fall cut-off arms only once the body has been within upright_tilt_rad
    (0.25). The oscillation watchdog arms safety.oscillation_arm_delay_s after
    that (default 0: at once, as before for the balancing policies).
    export_ros.py writes a safety block per policy: start_lying, plus the task
    config's deploy.safety (configs/<policy>.yaml).
2026-11-06 feat(sandro_rl): stand_up refit on the 2026-11 body, deployed as rl_stand_up
    Regenerated rest-pose bank on the new body (handle and Raspberry Pi
    collide; 882 of 1024 drops, 47 % lying beyond 70 deg). Fine-tuned from the
    lag-refitted stand_up for 1000 iterations (final curriculum stage, 10-80 ms
    wheel lag, SPI IMU ranges); checkpoint 500 kept, later ones lose the
    flat-on-the-back stand-up as before.
    Checkpoint 500: up from 120 of 120 falls (pitches +-0.3 to +-1.4 rad,
    2 seeds, nominal/spi_slow/worst, 40 and 80 ms of wheel lag; previous policy
    117), median 0.56 s, at most 1.8 s (3.1 s before); all nine standard runs;
    no wheel ringing from 0 to 80 ms of lag.
    Exported as rl_stand_up (controlle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
2026-11-09 feat(bringup): imu_check launch, the BNO085 alone with no drive plugin
    tools/imu_only.sh as a launch file: the URDF rendered for hardware:=real
    with every ros2_control block but SandroImu stripped, so the GIM6010 plugin
    is never loaded and nothing can be armed. Spawns imu_broadcaster and
    joint_state_broadcaster, which publishes the driver's sample age and online
    flag on /dynamic_joint_states.
    Run on the robot 2026-11-08: the plugin activates over SPI6 and the data
    reaches the panel about 3 ms old.
2026-11-09 feat(gui): sandro_gui, the robot's control panel on port 8080
    A browser panel served by the robot that replaces the terminal routine:
    - Overview: the CAD robot posed from the joint angles with the
    controllers' five-bar kinematics and tilted by the IMU (yaw removed), with
    the imu, BNO085 chip, base_link and world frames; pre-flight checks (stack,
    CAN, drives, IMU, joint states, controller, gamepad, Pi); every drive's
    state, error, temperature and rates; streams with their rate against the
    expected one and the driver's sample age; warnings and errors of the run,
    repeats folded; the body roll the leg heights give, next to the IMU roll.
    - Run: start the stack (IMU check, drives off,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
2026-11-09 feat(deploy): the panel as the robot container's main process; BNO085 calibration tool
    - Image: bluez for bluetoothctl (pairing goes through the host's bluetoothd
    over the mounted D-Bus socket) and deploy/pi/panel.sh, which keeps the
    panel running from boot and SIGINTs a running launch on docker stop.
    - Container: --init reaps launches the panel leaves behind on a restart,
    /run/dbus mounted, core dumps off (each crash wrote 300+ MB to the SD
    card). Needs `pi setup` and `pi reset` once.
    - pi gui [restart|log], pi imu-cal [--clear], panel state in pi status.
    - tools/bno085_calibrate.py: enables the chip's accelerometer and gyro
    dynamic calibration, measures each axis's offset and gai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
2026-11-09 fix(hardware): RT-safe CAN plugin: per-cycle state snapshot, non-blocking sends and error path, safe while inactive
    GIM6010System:
    - The receiver thread stages decoded values; read() copies them to the
    exported interfaces once per cycle, so a joint's position, velocity and
    age come from one frame (controllers read them without the lock).
    - state_source:=mit: the reply position is converted to the encoder's
    logical frame (bias and calibration offset removed, nearest turn), the
    0x09 broadcast no longer overwrites it, and the arming bias check reads
    the broadcast-only value (it could pass on the reply itself before).
    - Control-loop frames are sent with MSG_DONTWAIT into a small send b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
2026-11-09 perf(controllers): diagnostics without allocating in the control loop
    DiagnosticValues fills the persistent message in place (keys written once,
    values formatted into the existing strings with %.6g, so -2.5e-7 no longer
    reads -0.000000); per-joint keys are built at configure time; the status
    text is rebuilt only when the mask changes. Measured: no allocation after
    the first message (about 110 per message before, more than the WBC update
    itself on the Pi). RateGate keeps the configured rate on the 300 Hz loop
    (50 Hz came out at 43).
2026-11-09 feat(bringup): one launch per session, gamepad recovery, lean telemetry, RT control thread
    - sandro.launch.py, hardware:=real arm_hardware:=false: the controller
    manager now starts with the IMU active and SandroSystem inactive
    (hardware_components_initial_state, applied after extra_params), the
    broadcasters active and the chosen controller (and its switch partner)
    loaded inactive. Joint states and the IMU show before arming; arming is
    the lifecycle call, no relaunch. arm_hardware:=true is unchanged.
    Broadcasters share one spawner.
    - joy_estop: re-arm targets the last active controller and pre-loads its
    switch partner; a controller latched fallen (diagnostics ERROR) restarts
    w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
2026-11-09 perf(deploy): per-package Release builds without tests on the Pi, logs off the SD card, clean stops
    - pi build maps changed files to packages (--packages-select, dependents
    for headers/CMake); Python-only edits need no build; Release and
    BUILD_TESTING=OFF; pi launch stops on a failed build.
    - ROS logs on a 64 MB tmpfs; panel.log rotated by size; joy_node at warn.
    - docker stop waits for the launch to idle the drives (panel.sh loop,
    --stop-timeout 30).
    - Dev image: Release build, .dockerignore keeps runs, policies,
    recordings and CAD out of the 2.3 GB context.
2026-11-09 feat(gui): one-session flow, fast recovery, E-stop first, lighter panel
    - E-STOP sends the drives' E-stop frame on the panel's own CAN socket
    first (works with no launch or DDS), then the service and the controller
    deactivation in parallel; actions in flight are cancelled.
    - Swapping a balancer for an RL policy arms its handover first; a refusal
    switches nothing.
    - Fallen controllers show red with Restart; after an E-stop the stack reads
    E-stopped with one-button Re-arm and restart; a failed Arm names each
    drive, its code and whether it clears.
    - Start stack / Arm (secured confirmation once per launch) / Start, or Arm
    and start; IMU check under Advanced; a real starting -> ready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
2026-11-09 feat: MIT state source as one switch, and policies faster than 100 Hz
    state_source:=mit now selects its joint timing on both backends:
    encoder_period_ms and the sim_joint_* launch arguments default to auto,
    resolved from JOINT_TIMING in sandro.launch.py (encoder: 5 ms broadcast,
    200 Hz staggered; mit: 20 ms broadcast, synchronous 300 Hz replies 2.3 ms
    old). sandro_rl reads the same table. closed_loop.py gains an MIT gate,
    which the WBC passes, and evaluate.py an "mit" profile.
    Training can randomise MIT joint timing (mit_joints_probability, off by
    default) and run the policy faster than 100 Hz with unchanged per-second
    meaning: observation.history_stride keeps the stacked frames 10 ms apart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
2026-11-09 feat: train and deploy rl_flat_level_fast, a 300 Hz flat_level
    flat_level_real fine-tuned 1000 iterations at one policy step per control
    cycle (history_stride 3, gamma/lam per 10 ms unchanged, 0.24 s rollouts),
    with the MIT joint timing in half the episodes, on the current model.
    evaluate.py --compare, averaged over phases: body pitch RMS 0.012-0.016 rad
    against 0.026-0.032 for flat_level_real (WBC 0.016-0.019) in every scenario
    and latency profile including mit; speed error and wheel torque slightly
    lower, yaw error 0.020 vs 0.011 rad/s (WBC 0.12). Wheel-lag sweep: 5-15 Hz
    share at 80 ms 0.04 vs 0.19.
    Exported as rl_flat_level_fast next to rl_flat_level (third gamepad policy,
    blue lightba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
2026-11-09 feat: drive torque envelope, 9 Nm peak folding back to the 5 Nm rated torque
    The legs were held to 3 Nm by the balancers and in training, against the
    GIM6010-8's 5 Nm rated and 11 Nm peak. Every layer now uses one envelope:
    - sandro_hardware: TorqueEnvelope per drive (torque_envelope.hpp). The
    hard_effort_limit_nm (9 Nm) in bursts, folding back to rated_effort_nm
    (5 Nm) as the heat, the commanded torque squared low-passed over
    thermal_time_constant_s (10 s), passes thermal_knee (0.7) of rated^2:
    about 2.4 s at the peak from cold, the rated torque forever. Derated to
    the rated torque between derate_start_c and derate_end_c (65-80 C) of the
    heartbeat temperature; cools while inact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
2026-11-09 feat: retrain rl_stand_up and rl_flat_level_fast under the torque envelope
    Fine-tuned from the deployed checkpoints under the 9 Nm / 5 Nm envelope.
    - stand_up (800 iterations): up and settled in 60 of 60 falls (pitches
    +-0.3 to +-1.4 rad, three latency profiles, 40 and 80 ms wheel lag),
    median 0.70 s (0.92 before at 10 Nm), slowest 5.1 s (3.0); worst
    standard-scenario phase 0.05 rad pitch RMS against 0.25.
    - flat_level_fast (600 iterations): pitch RMS 0.011-0.012 against
    0.012-0.015; under 15-25 N shoves 0.047 against 0.025 rad, no falls,
    no wheel chatter.
    flat_level_real and agile_terrain were fine-tuned too but are not
    deployed: flat_level_real chatters at 4-9 Nm on the wheels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
2026-11-09 fix(gui): state source leaves the joint timing to the launch; offer rl_flat_level_fast
    The Run page always passed encoder_period_ms:=5, which overrode the
    launch's auto period: with state_source:=mit the encoder broadcast kept
    running at 5 ms instead of 20. The period is now auto unless typed in, and
    state_source is passed in simulation too, where it selects the emulated
    joint timing. rl_flat_level_fast is first among the RL policies offered.
2026-11-09 chore(recordings): panel launch logs of the 2026-11-08 robot session
    The 17 run logs the control panel kept on the Pi (gui_runs/), 18:06 to
    01:40 local; file names are the container's UTC. One IMU check, then armed
    launches (state_source:=encoder, encoder_period_ms:=5, controller:=none),
    starting whole_body_controller (5), rl_stand_up (2), rl_flat_level and
    rl_agile_terrain (1 each).
    Faults, all on right_motor_outer (node 2) but one:
    - axis error 0x40 MOTOR_FAILED, flags 9 (3) and refused activation with
    axis_error=64 fault_flags=9 (4): the drive's detailed errors read
    DC_BUS_UNDER_VOLTAGE with motor SYSTEM_LEVEL, the bus under 15 V from
    24.4 V when a controller engaged;
    - no encoder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
2026-11-09 fix(gui): polled controller list no longer hides RosBridge.controllers()
    The 1 Hz poll stored its result in self.controllers, shadowing the
    controllers() method control.py calls to start, stop and switch, so
    every controller action failed with 'list' object is not callable.
    The polled lists are now polled_controllers/polled_hardware; the
    state keys the browser reads are unchanged.
2026-11-09 chore(recordings): panel launch logs of the 2026-11-09 robot session
    Three runs with state_source:=mit (20 ms encoder broadcast):
    - 21:11 whole_body_controller, armed, then E-stop
    - 21:16 rl_flat_level_fast, rl_flat_level and rl_agile_terrain take
    over the balancer (inference <= 379 us); rl_stand_up faults
    left_wheel (axis error 0x40, flags 9) 0.2 s after engaging lying down
    - 21:20 rl_stand_up faults twice more (second time nodes 2, 3, 5 too),
    the fourth try stands up in 3.2 s and hands over to the balancer
    panel.log is the panel's own output, incl. the two start-up crashes
    fixed in e04a50b and 966aaf7.
2026-11-09 chore(recordings): 2026-11-09 RL buzz bags and their analysis
    The fast oscillation the RL policies make on the robot (noise, no fall):
    - buzz_rl_flat_level_encoder20: rl_flat_level with state_source:=encoder
    at encoder_period_ms 20 (50 Hz joint feedback, 3-19 ms old): 11-13 Hz.
    - buzz_rl_flat_level_mit: the same with state_source:=mit (300 Hz, about
    2 ms old): still there at 9-10 Hz, so not the feedback delay. Wheels
    opposed (correlation -0.83 against +1.00 in the 2 Hz forward rocking),
    yaw rate 0.25 rad/s RMS against 0.06 pitch, and the policy's wheel
    actions carry it: a yaw wiggle the policy drives.
    - buzz_wheel_kd02.yaml: the real overrides with the policies' wheel drive
    dampi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
2026-11-09 fix(gui): switching the state source resets the encoder period to auto
    A period typed for MIT (20 ms) stayed when the source went back to
    encoder, so the stack ran with 50 Hz joint feedback. A stored 5 or 20
    is cleared on load too.
2026-11-09 chore(recordings): the three RL policies in one MIT-mode bag
    buzz_rl_flat_level_fast_mit (22:28-22:30 UTC, state_source:=mit): the
    same 8-10 Hz yaw mode in every policy, wheels opposed, legs moving in
    height (inner against outer), at different strengths (5-15 Hz yaw rate):
    - rl_flat_level_fast 0.88 rad/s, oscillation watchdog after 1.7 s
    - rl_flat_level 0.37 rad/s
    - rl_agile_terrain 0.10 rad/s, the one trained with lateral pushes and
    yaw/roll torque disturbances
    buzz_windows.py splits the bag by policy. The run log is the complete
    22:20 run.
2026-11-09 docs(rl): the 8-10 Hz yaw mode the policies pump on the robot
    Observations of the 2026-11-09 recordings (recordings/buzz_2026-11-09):
    the same yaw mode in every policy, driven by the policy's wheel
    actions, independent of the joint feedback timing and not the drives'
    own damping loop; rl_flat_level_fast pumps it hardest (watchdog after
    1.7 s), rl_agile_terrain, trained with lateral and yaw disturbances,
    barely. Training changes to try are listed, not made.
2026-11-09 feat: joint state from the MIT replies by default
    state_source:=mit ran the WBC and all three RL balancers on the robot on
    2026-11-09: joint state 1.4-2.3 ms old at about 260 Hz, against 1-6 ms
    at 200 Hz from the 0x09 broadcast (recordings/buzz_2026-11-09). It is
    now the default of sandro.launch.py, of the URDF/ros2_control xacro
    (broadcast at 20 ms) and of the control panel, where it is listed
    first; state_source:=encoder keeps the 5 ms broadcast.
    MuJoCo under sandro.launch.py follows state_source, so the simulated
    stack now emulates the MIT timing by default. The simulators' own
    nominal stays the broadcast timing: closed_loop.cpp hard-codes it, and
    sandro_rl's RobotSpec now asks for the e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
2026-11-10 feat: yaw-buzz tools: differential wheel filter, drive-train bench test
    The 2026-11-09 recordings show the 8-10 Hz yaw mode is the body yawing on a
    compliant, backlashed wheel drive train: the gyro's yaw lags the encoders'
    rolling yaw by 121-146 deg (the IMU delay explains about 30), the motor-side
    velocity and torque carry 13-23 % odd harmonics while the gyro is almost a
    sine, and the policies' opposed wheel action opposes the gyro yaw rate
    (-161 to -178 deg), which arrives about 40 deg early at the wheels and pumps
    the mode.
    - RlPolicyController: action.wheel_differential_filter_hz, a first-order
    low-pass on the opposed half of the wheel commands only (0 off; the
    common half, which ba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
2026-11-10 feat: train on a compliant, backlashed wheel drive train (rl_*_drivetrain)
    The robot's 8-10 Hz yaw buzz is the body yawing on the drive trains'
    compliance with the gear play inside the loop; the policies trained with a
    first-order wheel lag, which has no resonance.
    - env.py: optional per-wheel gear (randomization.drives.gear): the rotor
    behind play and a spring, the MIT law every substep, the encoders on the
    rotor; no first-order wheel lag in those episodes. A reward term on the
    rate of the opposed wheel action.
    - flat_level_drivetrain (from flat_level_real, 1000 iterations) and
    flat_level_fast_drivetrain (from flat_level_fast, 800): 80 % of episodes
    with 0-25 mrad of play and 25-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
2026-11-11 feat(sandro_rl): FPO++ that trains: adaptive rate, no loss clamp, PPO warm start
    With the paper's settings FPO++ learned flat_tracking about ten times
    slower than PPO (10 s episodes and falls in every evaluation run after
    1500 iterations); faster fixed rates blew up and then stopped learning.
    fpo.py, all off by default:
    - desired_kl: the learning rate adapts to the per-minibatch KL;
    - loss_clamp: null drops the clamp whose dead zone (both losses above it:
    ratio 1, no gradient) kept a blown-up policy from recovering;
    - teacher / teacher_iterations / teacher_weight: warm start from a
    Gaussian checkpoint, the flow matching loss toward its action on the
    flow policy's own states, at a fixe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
2026-11-12 feat: per-run buzz analysis of a whole session; drivetrain policies in the panel
    recordings/buzz_session.py splits one recording into the stretches each
    controller was in control (RL phase 1, WBC engaged) and gives per run the
    5-15 Hz yaw/pitch/roll, opposed and common wheel motion, busiest leg,
    peak, 60+ Hz torque, watchdog maxima, references and how it ended
    (oscillation trip, fall, switch). rosbag2_py when ROS is sourced,
    mcap_ros2 otherwise. On buzz_rl_flat_level_fast_mit it reproduces the
    hand-cut windows (rl_flat_level yaw 0.370 against 0.367 rad/s).
    The panel lists rl_flat_level_drivetrain and rl_flat_level_fast_drivetrain
    first among the policies, so they start directly instead of t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
2026-11-12 feat(gui): Software page: versions on disk, built and running, one-button deploy
    The panel tracks which commit is in ros2_ws/src (version/source.json),
    which one install/ was built from (version/build.json), which build the
    panel and the running stack started from, and updates the robot from its
    own repository, ~/sandro/repo.git:
    - Deploy (Software page): git archive of the commit, only the files that
    differ written (current mtime, handed back to the owner of ros2_ws/src
    so pi sync still works), the packages built that pi build's change_scope
    would pick, both versions stamped, the panel restarted on the build and
    the browser reloaded. Refused while a launch runs. Output in the page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
2026-11-12 chore(recordings): 2026-11-12 yaw buzz with the differential filter; yaw closure
    buzz_2026-11-12_session (zstd, 104 -> 15 MB): WBC 0.03-0.04 rad/s of
    5-15 Hz yaw also while turning at 1.5 rad/s; rl_flat_level_drivetrain
    without the filter 0.95 rad/s at 8.8 Hz; with
    action.wheel_differential_filter_hz 3 (buzz_yaw_filter_3hz.yaml) the
    drivetrain policies 0.10, rl_agile_terrain 0.11 driven at 1 m/s and
    3 rad/s. buzz_2026-11-12_wbc: the WBC alone.
    recordings/yaw_closure.py fits the gyro's yaw rate with the rotors'
    rolling and the axle line turning under the body (legs' fore-aft): at
    full strength the legs' term explains 91 % at twice its size, rolling
    nothing. About half of the yaw compliance i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
2026-11-12 feat: yaw-mode system identification with the WBC balancing (pi sysid)
    The WBC gains sysid.* (live, off by default): a differential wheel torque
    of +-amplitude per wheel on top of the yaw task while balancing, as
    alternating pulses (a tap on the yaw mode) or a linear chirp with 0.5 s
    tapers. A run starts on any change of sysid.trigger, lasts duration_s
    and ends the moment the robot stops balancing; the torque is limited to
    1 Nm per wheel and stays inside the wheel budget. Diagnostics carry
    sysid_torque_nm and sysid_active. Two gtests (38/38 pass).
    tools/sysid_yaw.py (deploy/pi/pi sysid) checks the WBC is balancing,
    starts a zstd ros2 bag, and for each leg drive kp (12, 9, 16, 12) taps
    the y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
2026-11-12 fix(gui): software jobs outlive the panel; a half-done build is never reported current
    A deploy ran colcon inside the panel process: when the panel stopped
    20 s into compiling sandro_controllers the build died with it, and the
    next deploy of the same commit found the files on disk and stamped the
    build as current. The Software page then showed the old binaries as
    current.
    - Deploys, builds and fetches run as their own process (JobRunner,
    python3 -m sandro_gui.software job), state in gui_runs/software-job.json
    and output in their log; a restarted panel reads both back, and the job
    stops the panel itself when it is done.
    - A deploy builds the whole workspace when version/build.json does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
2026-11-12 feat(sysid): the yaw mode identified under the WBC: 12 Hz on the wheel side, not the legs
    recordings/sysid_2026-11-12: deploy/pi/pi sysid swept the differential
    wheel torque 2-25 Hz at leg drive kp 12, 9, 16, 12 (coherence 0.9-0.99).
    Fitted as yaw inertia behind one resonance: 12.2-12.5 Hz, zeta 0.24,
    yaw inertia 0.127 kg m2 (model 0.093), about 75 Nm/rad per wheel at the
    axle. The leg stiffness does not move it (under 3 %, against -13/+15 %
    if the legs held the compliance); above the resonance the rotors swing
    twice the body in antiphase, so the spring sits between rotors and
    ground: wheel gears and tyres. The policies ring at 9 Hz, where the
    plant already lags 135-155 deg.
    sysid_yaw.py no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
2026-11-12 feat(sysid): chirps at several amplitudes, pulses optional, for a linearity check
    The 2026-11-12 identification was clean at its level (SNR 16 dB, coherence
    0.9-0.99, the response through the injected chirp equal to the direct one
    within 1-3 %, so the WBC's own yaw loop does not bias it) but moved the
    wheels about a quarter as far as the policies' buzz (6-10 against ~34 mrad
    of rotor travel). With gear play the plant can depend on amplitude:
    --chirp-nm 0.1 0.2 0.4 now runs one chirp per amplitude and --pulses 0
    skips the taps; the table shows each chirp's amplitude.
2026-11-12 chore(sysid): yaw-mode amplitude series: linear in frequency and gain, damping grows
    recordings/sysid_2026-11-12/sysid_20261112-231529: kp 12, chirps of 0.1,
    0.2 and 0.4 Nm per wheel. From 0.2 to 0.4 Nm (rotor travel 5-14 mrad, yaw
    rate up to 0.5 rad/s) the resonance stays at 12.7 Hz and the gain within
    5-10 %: no gear-play dead zone in this range. The damping rises (zeta
    0.24 -> 0.30, 10-15 deg more lag across 5-16 Hz) and the legs take a larger
    share (0.30 -> 0.51 of the body's yaw at 9 Hz): friction-like, the tyres
    scrubbing. The 0.1 Nm chirp is drowned by the WBC's 0.12 Nm wheel friction
    feed-forward (coherence 0.5-0.9).
2026-11-13 feat(sysid): the yaw chirp in simulation; a rotor-inertia chirp on the bench
    evaluate.py --scenario sysid --sim yaw_chirp=0.2 adds the WBC's sysid chirp
    (2-25 Hz, 0.5 s tapers) to the wheels of a balancing policy; wheel_friction
    scales the wheels' frictionloss. Fitted with sysid_yaw.py's functions:
    the MJCF as trained shows no resonance below 20 Hz and an apparent yaw
    inertia of 1.66 kg m2 against the robot's 0.124: MuJoCo's tyre torsional
    friction (up to 1.7 Nm per tyre) and the wheels' 0.2 Nm frictionloss stick
    at the chirp's 0.9 Nm of yaw torque. Without them 0.147. No drive-train
    spring reproduces the 12.7 Hz resonance while the rotor is the MJCF
    armature; the robot's numbers read as rot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
